cabezoide/sofifi/schematics/top/programa_plate.pdf

# programa_plate

### GENERADO por `sofifi tablas` desde

programas/plate.sasm.

### SOFIFI · esquemático generado fuente: rtl/top/programa_plate.v sha256: 32cf21fc916c

$meminit
ADDR

DATA

palabras | lfo_tipos | instrucciones | lfo_excursiones

0x0

0xInfinity

0x923f | 0x0 | 0x56 | 0x6800d

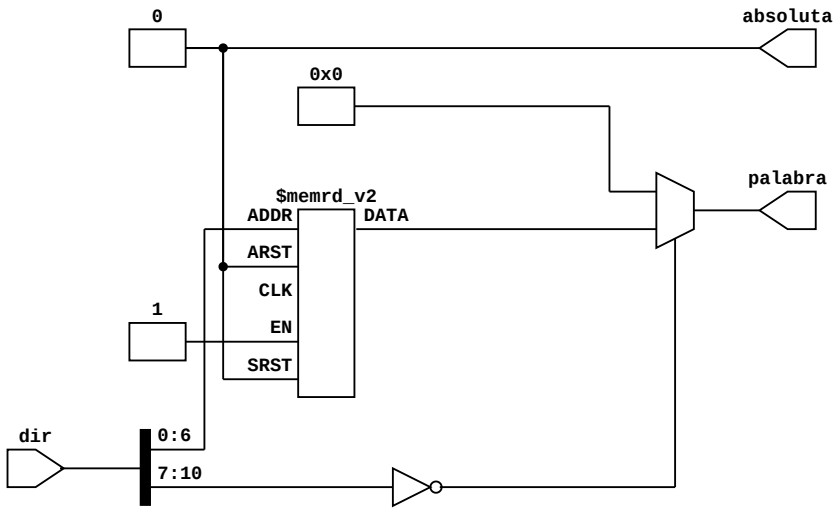
[picture p4: figure]
$memrd_v2 ADDR; ARST; CLK; SRST; DATA; dir; palabra; 0 absoluta
