cabezoide/sofifi/schematics/top/hil_programa.pdf

## hil_programa

hil_nucleo con la ROM que escribe `sofifi rom` en build/programa_hil.v: un programa o una cadena cualquiera en la placa.

SOFIFI · esquemático generado fuente: rtl/top/hil_programa.v sha256: 4140d4067240

amod\hil_nucleo\PROGRAMA=t24'011010000110100101101 clk

rst_n

uart_rx

uart_tx

clk

rst_n

uart_rx

uart_tx
