cabezoide/sofifi/schematics/top/hil_looper.pdf

## hil_looper

hil_nucleo con el looper (Fase 07): prueba RDAA y WRAA en la placa.

SOFIFI · esquemático generado fuente: rtl/top/hil_looper.v sha256: f9fa8bc14659

mod$8709f098b4d2bf764c3c52a0f0d38922a80d20ac\hil_n clk

rst_n

uart_rx

uart_tx

clk

rst_n

uart_rx

uart_tx
