cabezoide/sofifi/SBOM.ja.md

<!-- i18n: fuente=SBOM.md sha=8665ed6079b6 estado=al_dia -->
# SBOM · SOFIFI のコンポーネント

ペダルの内部がどの部品でできているか、どのツールで構築するかを説明します。各部品には簡単な説明があります。何をするのか、全体に何をもたらすのか、です。技術的な詳細（リソース、レイテンシー、フェーズごとの経緯）は `docs/arquitectura_fpga.ja.md` にあります。

## 一文で言うと

FPGA には**小さな専用オーディオプロセッサー**（コア）が入っています。各エフェクト（plate、shimmer、freeze…）は**プログラム**です。プロセッサーはそのプログラムを毎秒 48,828 回、オーディオサンプル 1 つごとに 1 回実行します。

## FPGA のコンポーネント

### クロック

| コンポーネント | 簡単に言うと何をするか | もたらすもの |
|---|---|---|
| **PLL**（`pll_100`） | ボードの水晶の 50 MHz クロックを 100 MHz クロックに変換します。 | コアの速度を 2 倍にします。オーディオサンプル 1 つあたり 2,048 の作業ステップ。 |
| **サンプル生成器** | 2,048 クロックサイクルごとに信号を出します。 | オーディオのリズムを決めます。正確に毎秒 48,828 サンプル。 |

### DSP コア

| コンポーネント | 簡単に言うと何をするか | もたらすもの |
|---|---|---|
| **マイクロコード** | プログラムの命令（最大 2,048）を入れるメモリー。 | ハードウェアを変えずにエフェクトを変えられます。別のプログラムを読み込むだけです。 |
| **シーケンサー** | 命令を読み、各部品に何をするかを指示します。前の命令の終わりを待たずに、次の命令を始めます。待つのは、まだ準備できていない結果が必要なときだけです（ADR 0014、スペイン語）。 | コアの「指揮者」です。これにより、プログラムのサイクルは 1.6 分の 1 になります。 |
| **レジスターバンク** | 数値を保持する 64 個のセル。入力、出力、ポテンショメーター、プログラムの変数。 | 各エフェクトの「作業台」です。 |
| **乗算器**（DSP ブロック） | 2 つの数を 1 ステップで掛けます。 | オーディオの処理はほとんどが乗算です。音量、フィルター、ミックス。 |
| **ALU** | 加算、比較、飽和（音のオーバーフローを防ぐ）を行います。 | 結果を組み合わせて、アキュムレーターに入れます。 |
| **アキュムレーター（ACC）** | 積を加算する 48 bit のレジスター。 | 高い精度。長いテールで丸めノイズを防ぎます。 |
| **ディレイメモリー**（BSRAM） | 直近約 0.9 s のオーディオを、ループするテープのように保持します。ブロックのグループに分かれ、グループごとにアドレスのコピーを持ちます。`RDAA` と `WRAA` を使うと、32,768 ワードが固定のテープのように働き、録音した音は遠ざかりません。 | すべての reverb と delay の土台です。音の過去を聞かせます。グループにより、実チップ上でタイミングに余裕が生まれます。固定部分により、ルーパーとグラニュラーが可能になります。 |
| **LFO ×4** | 低速のオシレーター（サイン、ランダム、ランプ）。 | メモリーの読み出し位置を動かします。chorus、reverb のモジュレーション、shimmer のピッチシフト。 |
| **Hermite ROM** | 256 × 4 個の係数の固定テーブル。 | ノイズなしでメモリーを「サンプルの間」で読めます。滑らかなモジュレーション。 |
| **ソフトカーブ** | 急な切れ目のない 3 次の飽和。 | 音楽的に音を制限し（`CLIP`）、サイン LFO の形を作ります。 |

### 入力、出力、テスト

| コンポーネント | 簡単に言うと何をするか | もたらすもの |
|---|---|---|
| **UART TX / RX** | ボードの USB を通じた PC とのシリアルポート。 | FPGA と通信できます。テストを要求し、結果を受け取ります。 |
| **プログラムローダー** | 起動時に、固定メモリーからマイクロコードへプログラムをコピーします。 | テスト用トップでは、plate、looper、または `make hil` のプログラムを読み込みます。 |
| **キャプチャーと CRC-32**（テスト専用） | 4,096 サンプルを実速度で録音し、チェックコードと一緒に送ります。 | ハードウェアが PC のモデルと**完全に**同じ音を出すことを示します。 |
| **トレース**（テスト専用） | どの命令を実行し、アキュムレーターにどの値を残したかを記録します。 | チップが失敗したとき、どの命令かを示します。どの部分を直せばよいかがわかります。 |
| **周波数カウンター**（テスト専用） | あるクロックの 1 秒間に、別のクロックのサイクルを数えます。 | PLL とサンプリング周波数が正確であることを確認しました。 |
| **1 ビットのオーディオ出力**（`salida_1bit`、フェーズ 13） | 1 本のピンで音声を送ります。補間器がサンプルを fs の 32 倍に上げ、変調器がクロックごとに 1 ビットに変えます。抵抗 2 本とコンデンサー 2 個で音が出ます。 | コーデックを買う前に、86 個のプログラムをボードで聞けます（ADR 0015）。 |

### microSD（フェーズ 08、作業中）

| コンポーネント | 簡単に言うと何をするか | もたらすもの |
|---|---|---|
| **SD コントローラー**（`sd_spi`） | SPI でカードと通信します。カードを起動し、512 バイトのブロックを読みます。カードには書き込みません。 | ファイルシステムなしでプログラムのライブラリにアクセスできます。ファイルシステムは高価で壊れやすいからです。 |
| **バンクのローダー**（`cargador`、`carga_sd`） | カードのスロットを 2 回読みます。1 回目は確認だけをします。2 回目はプログラムをコアに書き込みます。 | 壊れたプログラムは読み込みません。1 回目の読み出しが失敗すると、コアは前のプログラムを使い続けます。 |
| **SD のテスト**（`prueba_sd`、テスト専用） | PC の要求でスロットを読み込み、読んだ内容を PC に返します。 | カードがモデルと同じデータを出すことを確認します。実際のカードでの試験が残っています。 |
| **トラックの読み出し**（`lector_pista`、フェーズ 13） | カードからギターの録音をブロックごとに読み、サンプルごとに渡します。1,024 サンプル分を先読みするので、カードが遅れても音が切れません。 | コーデックが届く前にペダルへ音声入力を与えます。ボードでプログラムを聞けます。 |

### チップのプリミティブ（GW5A の物理的な部品）

| プリミティブ | 使用数 | 用途 |
|---|---|---|
| BSRAM（18 Kbit ブロック） | コアで 56 個中 48 個 | ディレイメモリーとマイクロコード |
| DSP（MULTALU27X18） | 28 個中 2 個 | 乗算器 |
| PLLA | 6 個中 1 個 | 100 MHz クロック |
| LUT4 とフリップフロップ | ~54 % と ~31 %（テスト用 top `hil_nucleo`） | すべてのロジックと、クロックの余裕を生むコピー |

## ソフトウェアツール

すべて `make install`（pip）でインストールします。すべてフリーソフトウェアです。

| ツール | バージョン | ライセンス | 何をするか |
|---|---|---|---|
| Yosys (YoWASP) | 0.69 | ISC | Verilog を論理ゲートに変換します（論理合成）。 |
| nextpnr-himbaechel-gowin (YoWASP) | 0.11.1 | ISC | それらのゲートをチップ内に配置し、配線します。 |
| apicula | 0.32 | MIT | GW5A のビットストリームを生成します。 |
| openFPGALoader | 1.1.1 | Apache-2.0 | USB 経由でビットストリームをボードに書き込みます。 |
| verilator | 5.48 | LGPL-3.0 または Artistic-2.0 | Verilog をシミュレーションします。ツールとして使うだけで、コードはコピーしません（ADR 0002）。 |
| cocotb | 2.1 | BSD-3-Clause | シミュレーションのテストを Python で書きます。 |
| pyserial | 3.5 | BSD-3-Clause | ボードの UART と通信します。 |
| soundfile | 0.12 | BSD-3-Clause | デモを Ogg Vorbis で書き出します。libsndfile（LGPL-2.1）をライブラリとして使い、コードはコピーしません（ADR 0002）。オプション：`pip install -e '.[demos]'`。 |
| Python + numpy | 3.12+ / 2.x | PSF / BSD | bit-exact モデル。すべての基準です（ADR 0003）。 |

最低バージョンは `pyproject.toml` にあります。各ツールの落とし穴は `fails.ja.md` と `rtl/AGENTS.md`（スペイン語）にあります。
