cabezoide/sofifi/SBOM.zh-CN.md

<!-- i18n: fuente=SBOM.md sha=8665ed6079b6 estado=al_dia -->
# SBOM · SOFIFI 组件

本文说明效果器内部由哪些部件组成，以及用哪些工具构建。每个部件都有简单的说明：它做什么，以及它为整体带来什么。技术细节（资源、延迟、各阶段的历史）见 `docs/arquitectura_fpga.zh-CN.md`。

## 一句话说明

FPGA 中包含一个**小型定制音频处理器**（核心）。每个效果（plate、shimmer、freeze…）都是一个**程序**。处理器每秒运行该程序 48,828 次，每个音频采样运行一次。

## FPGA 组件

### 时钟

| 组件 | 简单说明 | 作用 |
|---|---|---|
| **PLL**（`pll_100`） | 将开发板晶振的 50 MHz 时钟转换为 100 MHz 时钟。 | 使核心速度加倍：每个音频采样有 2,048 个工作步骤。 |
| **采样发生器** | 每 2,048 个时钟周期发出一个信号。 | 决定音频节奏：精确的每秒 48,828 个采样。 |

### DSP 核心

| 组件 | 简单说明 | 作用 |
|---|---|---|
| **微码** | 存放程序指令的存储器（最多 2,048 条）。 | 无需更改硬件即可更换效果：只需加载另一个程序。 |
| **序列器** | 读取指令，并告诉每个部件做什么。它不等上一条指令结束就开始下一条。只有需要尚未就绪的结果时，它才等待（ADR 0014）。 | 它是核心的“指挥”。这样，程序耗用的周期数减少到原来的 1/1.6。 |
| **寄存器组** | 64 个存放数值的单元：输入、输出、电位器和程序变量。 | 它是每个效果的“工作台”。 |
| **乘法器**（DSP 模块） | 一步完成两个数的乘法。 | 音频中几乎都是乘法：音量、滤波器、混合。 |
| **ALU** | 加法、比较和饱和（防止声音溢出）。 | 组合结果并存入累加器。 |
| **累加器（ACC）** | 一个 48 bit 寄存器，用于累加乘积。 | 精度高：避免长尾音中的舍入噪声。 |
| **延迟存储器**（BSRAM） | 保存最近约 0.9 s 的音频，就像一条循环磁带。它按块组划分，每组有自己的地址副本。借助 `RDAA` 和 `WRAA`，其中 32,768 个字像一条固定的磁带：录下的声音不会远去。 | 它是所有 reverb 和 delay 的基础：听到声音的过去。块组使其在真实芯片上有时序余量。固定部分让 looper 和颗粒效果成为可能。 |
| **LFO ×4** | 低速振荡器（正弦、随机、斜坡）。 | 移动存储器的读取位置：chorus、reverb 调制和 shimmer 的变调。 |
| **Hermite ROM** | 256 × 4 个系数的固定表。 | 可以无噪声地“在采样之间”读取存储器：平滑的调制。 |
| **柔和曲线** | 三次饱和，没有生硬的削波。 | 以音乐化的方式限制声音（`CLIP`），并为正弦 LFO 塑形。 |

### 输入、输出和测试

| 组件 | 简单说明 | 作用 |
|---|---|---|
| **UART TX / RX** | 通过开发板的 USB 与 PC 通信的串口。 | 可以与 FPGA 通信：请求测试并接收结果。 |
| **程序加载器** | 启动时将程序从固定存储器复制到微码。 | 在测试 top 中，它加载 plate、looper 或 `make hil` 的程序。 |
| **采集和 CRC-32**（仅用于测试） | 以实际速度录制 4,096 个采样，并与校验码一起发送。 | 证明硬件的声音与 PC 模型**完全**相同。 |
| **跟踪**（仅用于测试） | 记录执行的是哪条指令，以及它在累加器中留下的值。 | 如果芯片出错，它会指出是哪条指令，从而知道需要修复哪个部分。 |
| **频率计**（仅用于测试） | 在一个时钟的一秒内计数另一个时钟的周期。 | 已确认 PLL 和采样率是精确的。 |
| **1 位音频输出**（`salida_1bit`，第 13 阶段） | 用一个引脚输出音频。插值器把样本提升到 32 倍 fs，调制器把它变成每个时钟周期一位。两个电阻和两个电容就能出声。 | 在买声卡芯片之前，就能在开发板上听到 86 个程序（ADR 0015）。 |

### microSD（第 08 阶段，进行中）

| 组件 | 简单说明 | 作用 |
|---|---|---|
| **SD 控制器**（`sd_spi`） | 通过 SPI 与存储卡通信：启动存储卡并读取 512 字节的块。它不向存储卡写入。 | 无需文件系统即可访问程序库；文件系统既昂贵又脆弱。 |
| **程序库加载器**（`cargador`、`carga_sd`） | 将存储卡上的一个槽位读取两次。第一次只做检查；第二次把程序写入核心。 | 损坏的程序不会被加载。如果第一次读取失败，核心继续运行之前的程序。 |
| **SD 测试**（`prueba_sd`，仅用于测试） | 按 PC 的请求加载槽位，并告诉 PC 读到了什么。 | 检查存储卡给出的数据与模型相同。还缺少用真实存储卡的测试。 |
| **音轨读取器**（`lector_pista`，第 13 阶段） | 从卡中逐块读取一段吉他录音，再逐样本送出。它提前缓存 1,024 个样本，这样卡变慢也不会断音。 | 在声卡芯片到货之前就给踏板一路音频输入，于是可以在开发板上听到各个程序。 |

### 芯片原语（GW5A 的物理部件）

| 原语 | 使用数量 | 用途 |
|---|---|---|
| BSRAM（18 Kbit 块） | 核心中使用 56 个中的 48 个 | 延迟存储器和微码 |
| DSP（MULTALU27X18） | 28 个中的 2 个 | 乘法器 |
| PLLA | 6 个中的 1 个 | 100 MHz 时钟 |
| LUT4 和触发器 | ~54 % 和 ~31 %（测试 top `hil_nucleo`） | 全部逻辑，以及提供时钟余量的副本 |

## 软件工具

所有工具都通过 `make install`（pip）安装，且都是自由软件。

| 工具 | 版本 | 许可证 | 作用 |
|---|---|---|---|
| Yosys (YoWASP) | 0.69 | ISC | 将 Verilog 转换为逻辑门（综合）。 |
| nextpnr-himbaechel-gowin (YoWASP) | 0.11.1 | ISC | 在芯片内布局并连接这些逻辑门。 |
| apicula | 0.32 | MIT | 生成 GW5A 的比特流。 |
| openFPGALoader | 1.1.1 | Apache-2.0 | 通过 USB 将比特流加载到开发板。 |
| verilator | 5.48 | LGPL-3.0 或 Artistic-2.0 | 仿真 Verilog。仅作为工具使用；不复制其代码（ADR 0002）。 |
| cocotb | 2.1 | BSD-3-Clause | 用 Python 编写仿真测试。 |
| pyserial | 3.5 | BSD-3-Clause | 与开发板的 UART 通信。 |
| soundfile | 0.12 | BSD-3-Clause | 将演示写为 Ogg Vorbis。它把 libsndfile（LGPL-2.1）作为库使用，不复制其代码（ADR 0002）。可选：`pip install -e '.[demos]'`。 |
| Python + numpy | 3.12+ / 2.x | PSF / BSD | bit-exact 模型，是一切的参考（ADR 0003）。 |

最低版本见 `pyproject.toml`。每个工具的陷阱见 `fails.zh-CN.md` 和 `rtl/AGENTS.md`（西班牙语）。
