cabezoide/sofifi/fails.zh-CN.md

<!-- i18n: fuente=fails.md sha=f2b864256b63 estado=al_dia -->
# 故障及其解决

本文件记录项目中发现的故障。每条记录包含现象、诊断、根本原因、解决方法和教训。它帮助我们避免重复同样的故障，也说明设计为何如此。

故障完成诊断并解决后，添加一条新记录。记录不重写：如果之后有变化，就添加一条带日期的注释。

| ID | 阶段 | 故障 | 状态 |
|---|---|---|---|
| F-01 | 02 | verilator 包装器反复启动自身，导致机器崩溃 | 已解决 |
| F-02 | 03 | BL616 的 UART 桥挂起 | 已解决（附使用规则） |
| F-03 | 03 | apicula 0.32 无法打包使用默认分频器的 PLLA | 已解决 |
| F-04 | 03 | Yosys 不为 GW5A 推断 DSP 块 | 已解决 |
| F-05 | 03 | nextpnr 推导不出 PLL 的输出频率 | 已解决 |
| F-06 | 03 | 仿真中复位始终不发生 | 已解决 |
| F-07 | 02 | 第一个比特流用了两倍的逻辑 | 已解决 |
| F-08 | 04 | RTL 中的无符号移位和一处溢出 | 已解决 |
| F-09 | 04 | 单端口 BSRAM 的保持时间违例 | 已解决 |
| F-10 | 04 | 核心时序不收敛（70 MHz） | 已解决 |
| F-11 | 05 | nextpnr 给出 132 MHz，芯片却在 100 MHz 失败 | 已解决；实测裕量 ≥ 6 %，待提高 |
| F-12 | 05 | 一项存储器清零测试什么也检测不到 | 已解决 |
| F-13 | 05 | 转储的第一行丢失 | 已解决 |
| F-14 | 05 | apicula 0.32 无法打包没有初始内容的 BSRAM | 已解决 |
| F-15 | 06 | 预读在仿真中正常，在芯片上 100 MHz 时失败 | 已解决；实测裕量 ≥ 20 % |
| F-16 | 06 | 大型仿真用 pip 版 verilator 无法编译 | 已解决 |
| F-17 | 06 | velvet noise 扩散器没有优于全通滤波器 | 已放弃：不发布 |
| F-18 | 06 | 阶段 06 程序目录中的四个编程错误 | 发布前已解决 |
| F-19 | 07 | 加入 RDAA 和 WRAA 后，芯片在 114 MHz 下从第一个样本起失败 | 已解决；实测裕量 ≥ 25 % |
| F-20 | 07 | 清除绝对区域时有两个字没有被清除 | 已解决 |
| F-21 | 07 | 在 marea 中，软件 LFO 停在 +1 | 发布前已解决 |
| F-22 | 07 | shoegaze 的音量是 plate 的五倍 | 发布前已解决 |
| F-23 | 07 | 带饱和的链比 plate 响六倍 | 发布前已解决 |
| F-24 | 07 | 微码队列占用了最后一个 BSRAM | 已解决 |
| F-25 | 08 | SD 控制器的三个故障，在仿真中发现 | 上板前已解决 |
| F-26 | 08 | 目录第 9 批中的四个定点陷阱 | 发布前已解决 |
| F-27 | 08 | 第 10 批中的小常数、控制回路和一个“盲”指纹 | 发布前已解决 |
| F-28 | 08 | phaser 和 filtro 的最低速度为 0，以及第 11 批的三个陷阱 | 已解决 |
| F-29 | 08 | 第 12 批中五个调制和电平陷阱 | 发布前已解决 |
| F-30 | 08 | 第 13 批中的检测器、接缝和读取范围 | 发布前已解决 |

---

## F-01 · verilator 包装器反复启动自身

- **现象：**开发机器两次死机。内核因内存不足（OOM）杀死进程。
- **诊断：**OOM 转储中约有 14,000 个 `verilator` 进程。
- **根本原因：**有人手动创建了链接 `.venv/bin/verilator -> verilator-cli`。pip 的包装器在 PATH 中查找 `verilator` 并执行它。有了这个链接，包装器找到的是自己，于是无休止地重新启动自身。
- **解决方法：**不使用链接。`sim/conftest.py` 和 `scripts/ci_local.sh` 通过 `VERILATOR_ROOT` 调用软件包中的真实二进制文件。检查门在 `ulimit -u` 限制下运行 EDA 工具。
- **教训：**测试会启动子进程的新工具时，要使用 `ulimit -u` 和 `timeout`。

## F-02 · BL616 的 UART 桥挂起

- **现象：**开发板停止向 PC 发送数据，与比特流无关，直到重新连接 USB。FPGA 确实完成了配置（openFPGALoader 报告 `Done Final`）。
- **诊断：**在阶段 03 和 05 期间做了七次重新连接测试。在阶段 03，它看起来像 BSRAM 故障。到阶段 05，规律变得清楚：

  | 情况 | 结果 |
  |---|---|
  | FPGA 高速发送，PC 持续读取（HIL 转储，11.5 kB/s） | 不挂起 |
  | FPGA 发送 ≥ 2 kB/s 时重新编程（JTAG 期间 PC 不读取） | 挂起 |
  | 发送约 1.4 kB/s 或更低时重新编程 | 正常 |

- **根本原因：**BL616 固件在处理其他事务时（特别是 JTAG 编程期间）无法承受未读字节的积累。这不在我们的控制范围内。
- **解决方法：**
  - 测试顶层限制其速率（约 300 B/s 到 1.4 kB/s）；
  - HIL 只在 PC 请求时转储；
  - 脚本在释放端口**之前**加载一个静默设计（`prueba_pll`）。
- **教训：**重新编程之前，FPGA 不能在高速发送。如果正在高速发送，就在编程期间读取端口。

## F-03 · apicula 0.32 无法打包使用默认分频器的 PLLA

- **现象：**`gowin_pack` 结束时报错 `invalid literal for int() with base 2: '8'`。
- **根本原因：**apicula 以十进制保存 PLLA 的默认值，却按二进制读取。
- **解决方法：**`rtl/primitivas/pll_100.v` 设定所有分频器，包括未使用输出的分频器。

## F-04 · Yosys 不为 GW5A 推断 DSP 块

- **现象：**一个 `a * b` 被综合成了 LUT 和 ALU。
- **根本原因：**Yosys 0.69 只为 gw1n 和 gw2a 系列推断 DSP。
- **解决方法：**在 `rtl/primitivas/mult_27x36.v` 中例化 `MULT27X36`。它占用 28 个 DSP 块中的 2 个。已在开发板上验证到 160 MHz。

## F-05 · nextpnr 推导不出 PLL 的输出频率

- **现象：**报告对 `clk_100` 使用了通用的 50 MHz 目标。
- **解决方法：**`scripts/fpga.sh` 为所有时钟设定 100 MHz 目标。

## F-06 · 仿真中复位始终不发生

- **现象：**一个测试顶层在仿真中发送垃圾数据。
- **根本原因：**verilator 将寄存器初始化为 0。使用仿真 PLL 时，`bloqueado` 从一开始就是 1，由它派生的复位永远不会激活。
- **解决方法：**每个时钟域使用自己的启动计数器。

## F-07 · 第一个比特流用了两倍的逻辑

- **现象：**`hola_uart` 占用 353 个 LUT4 和 146 个 ALU。项目所有者问这是否正常。
- **根本原因：**设计把计数器的 8 位数字并行转换为 ASCII，然后再选择其中一位。
- **解决方法：**先选择数字，再只转换一次：207 个 LUT4 和 82 个 ALU。第二轮优化（ADR 0010）由此产生。

## F-08 · RTL 中的无符号移位和一处溢出

- **现象：**针对模型的单元测试失败，而程序的测试却通过。
- **根本原因：**在 Verilog 中，位选择（`p[49:0]`）和拼接（`{...}`）是**无符号**的，所以 `>>>` 做的是逻辑移位。这种情况发生了两次（在 `curva_fin` 中）。此外，在 RND LFO 中，`objetivo − actual` 需要 25 bit，却用 24 bit 计算。
- **解决方法：**移位前先经过一根 `signed` 线；差值用 25 bit。
- **教训：**每个模块都要用数千个随机向量对照其模型函数测试。程序的测试只覆盖这些程序产生的值。

## F-09 · 单端口 BSRAM 的保持时间违例

- **现象：**核心的第一次综合出现 104 个保持时间违例。
- **根本原因：**Yosys 把 ROM（Hermite 表、程序）和部分微码放进了 `SPX9` BSRAM。在 GW5A 上，这类 BSRAM 产生保持时间违例；`DPX9B` 则不会。
- **解决方法：**ROM 用逻辑实现，`(* rom_style = "logic" *)` 写**在 `case` 上**（写在端口上无效）；微码使用双端口包装器。

## F-10 · 核心时序不收敛（70 MHz）

- **现象：**核心的第一次综合只有 70 MHz，目标是 100。
- **根本原因：**四个步骤串联在一个周期内：
  - 译码；
  - 寄存器组（64:1 多路选择器）；
  - `a24` 的舍入；
  - `CLIP`（三个 50 bit 运算）。
- **解决方法：**在译码阶段寄存操作数，`CLIP` 分两步完成：nextpnr 给出 140 MHz。在芯片上这还不够：见 F-11。

## F-11 · nextpnr 给出 132 MHz，芯片却在 100 MHz 失败

- **现象：**在开发板上，plate 输出的第一个样本只有一半大小。在仿真、综合以及综合后的网表中，结果都与模型一致。
- **诊断**，逐步进行：
  1. 排除 B 为 24 bit 的乘法器：开发板上 300 次乘积无错误。
  2. 排除 2K × 9 模式的 BSRAM：开发板上 0 个错误。
  3. 仿真 Yosys 网表：与模型一致，所以综合正确。
  4. 一个计算相同的最小程序在开发板上正常工作。故障与布局有关。
  5. **决定性测试：**在已布线的 JSON 中只改变 PLL 的分频器，不重新布局。在 50、72.7、80 和 88.9 MHz 下正常；在 100 MHz 下失败。原因是时序。
  6. 用同样的方法，DSP 到 160 MHz 都正常，而推断出的 BSRAM 在 100 MHz 以上失败，静态分析给出的是 117 MHz。
- **根本原因：**nextpnr 对 GW5A 的时序模型乐观了约 30 %。对 *bypass* 模式（无输出寄存器）的 BSRAM 尤其如此，而这是 Yosys 唯一会推断的模式。对 BSRAM 之后的逻辑也是如此。
- **解决方法：**
  - `rtl/primitivas/bsram_bloque.v`：手动例化的 BSRAM，使用其内部输出寄存器（`READ_MODE1 = 1`）；
  - `rtl/primitivas/bsram_pipe.v`：由这些块构成的大容量存储器，多路选择器带寄存器；
  - 乘法器输出寄存两次；ALU 分两级；`CHO` 的地址分三步；程序加载器带寄存器。
- **实测结果：**nextpnr 给出 155 MHz。在开发板上：100 MHz 下 9 次采集 9 次完美，106.25 MHz 下 3 次中 3 次，114.3 MHz 下 5 次中 2 次。实际最高频率在 106 到 114 MHz 之间：**裕量至少 6 %**。对于会发热的效果器来说这太少了；目标是在重新设计序列器时（阶段 06 之前）超过 20 %。
- **代价：**每个样本的周期数（共 2,048）从 661 增至 1,258（plate），从 840 增至 1,601（shimmer）。
- **教训：**nextpnr 的分析不够。裕量要在开发板上测量，在同一布线上只改变 PLL 分频器（ADR 0011）。

## F-12 · 一项存储器清零测试什么也检测不到

- **现象：**禁用清零后测试也能通过。
- **根本原因：**plate 的延迟线很长，旧数据要经过数千个样本才会被再次读取。
- **解决方法：**一个在 9 个字上延迟 8 个样本的程序。没有清零时失败，有清零时通过。
- **教训：**确认每个新测试在代码出错时会失败。

## F-13 · 转储的第一行丢失

- **现象：**4,096 个样本只到达 4,095 个，并且全部错位一个位置。
- **根本原因：**BL616 保存着之前某个设计的字节。`reset_input_buffer()` 只清空 PC 的缓冲区，第一行到达时与这些残留字节粘在一起。
- **解决方法：**`scripts/hil_nucleo.py` 在请求采集之前，丢弃 0.3 s 内到达的数据。

## F-14 · apicula 0.32 无法打包没有初始内容的 BSRAM

- **现象：**`gowin_pack` 结束时在 `write_gw5_bsram_init_map` 中报 `IndexError`，并留下一个不完整的比特流。
- **根本原因：**如果设计中没有任何 BSRAM 声明 `INIT_RAM_xx`，apicula 就会失败。在手动例化所有块时发生了这种情况。
- **解决方法：**`bsram_bloque.v` 把 64 个初始化字声明为零。
- **教训：**检查 `fpga.sh` 的退出码；即使打包失败，`.fs` 文件也可能存在。

## F-15 · 预读在芯片上 100 MHz 时失败

- **现象：**使用微码预读时，plate 在仿真中与模型一致。在开发板上，它在 100 MHz 下失败，总是从第 924 个样本开始。使用同一布线，在 88.9 MHz 及以下正常。nextpnr 给出 157 MHz。
- **诊断**，逐步进行：
  1. `main` 的设计在同一天仍能在 100 MHz 下通过：开发板没有变化。
  2. 开发板上的测量排除了 50 bit 进位链、饱和加法、单独的 BSRAM、DSP 和时钟布线。Yosys 的 `-nodffe` 选项在 GW5A 上无效。
  3. 第 924 个样本是 plate 的尾音到达存储器长抽头的时刻：从这里开始存储器返回非零值。所以故障"取决于数据"。
  4. **新工具：**顶层 `hil_nucleo` 记录核心的轨迹（命令 `T`）：在 ACC 每次变化时记录 pc 和 ACC。`scripts/margen_reloj.py --traza` 把轨迹与模型比较，并指出最先失败的指令。
  5. 借助轨迹发现，每次布线失败的位置都不同。失败的有：延迟存储器的读取（`RDA` 返回 0：地址错误）、ALU 加法（bit 25）和乘法器（`MULX`）。
  6. 进位链的布局没有断开。不存在断开的路径。
- **根本原因：**nextpnr 高估了 GW5A 上**整个**设计的速度，系数为 1.45 到 1.5。每次布线都在余量最紧的路径上失败。BSRAM 的路径最差：一个地址要在一个周期内到达分布在芯片各处的 38 个块，还有一个 38 路输出的多路选择器。
- **解决方法：**
  - 流水线化的 `bsram_pipe`（延迟存储器中 `GRUPO = 8`）：
    - 每组、每块各有一份地址副本（`registro_copia`，Yosys 不会合并它）；
    - 每个块的输出在块旁边寄存；
    - 每组的多路选择器带寄存器。
  - 读取从 3 个周期增至 7 个周期。核心只在 `RDA` 和 `CHO` 中等待 `LAT_MEM = 9`。
  - 两级寄存器组：每个周期寄存 8 个候选值，在 `E_DECO` 中选择。微码字在译码前再寄存一次。
  - 存储器物理地址用三个并行加法计算，`puntero ± P` 随指针一起递减。
  - 乘法器使用 DSP 的内部寄存器 `PREG`。
- **实测结果**（nextpnr 对此布线给出 154 MHz）：100 MHz，4 次中 4 次；114.3 MHz，2 次中 2 次；**120 MHz，4 次中 4 次**；125 MHz，4 次中 3 次；133.3 MHz，1 次中 0 次。**裕量至少 20 %**，而阶段 05 为 6 %。
- **代价：**约多 3,100 个触发器（nextpnr 报告中的 LUT4：从 8,204 增至 11,490，因为有直通 LUT）。每个样本的周期数下降得比预期少：shimmer 1,514（之前 1,601），plate 1,195（之前 1,258），freeze 1,313（之前 1,393）。每条指令约 14 个周期：等待每条指令的结果仍是主要因素。
- **教训：**当芯片失败而 nextpnr 没有报错时，要先在开发板上定位指令（轨迹），再修改设计。占用半个芯片的存储器需要地址的本地副本，以及在每个块旁边寄存的输出。要在 114.3 到 133.3 MHz 之间测量，`margen_reloj.py --mdiv` 还会改变 VCO。

## F-16 · 大型仿真用 pip 版 verilator 无法编译

- **现象：**`c++: error: Vtop__pch.h.fast: linker input file not found`，只在大型设计中出现（带轨迹的 `hil_nucleo`）。
- **根本原因：**软件包中的 `verilated.mk` 把变量 `CFG_CXXFLAGS_PCH_I` 留空，它本应为 `-include`。verilator 把大型设计拆分成多个文件时会使用预编译头，而 g++ 把它当作输入文件接收。
- **解决方法：**`sim/conftest.py` 将 `CFG_CXXFLAGS_PCH_I=-include` 添加到 `MAKEFLAGS`。
- **教训：**只在设计变大时才出现的编译故障，通常出在工具配置上，而不是代码上。

## F-17 · velvet noise 扩散器没有胜过 allpass

- **现象：**测试了一个 hall，用 velvet noise 扩散器（50 ms 内 24 个 tap）代替其 4 个输入 allpass。
  - 尾音**更不**密集：有效样本占 10 %，而原来是 28 %。
  - 峰值因子更高：12.9 对 8.8。
  - 用 4 条延迟线代替 8 条，它还是目录中染色最重的尾音：倍频程频带之间为 6.4，而 plate 为 1.9。
- **根本原因：**级联的 allpass 产生无限长且越来越密的响应。velvet noise 产生的脉冲数等于 tap 数。在 SOFIFI 中，每个 tap 是一条 19 个周期的 `RDA`：要达到同样的密度需要 100 个 tap，约 1,900 个周期，与网络一起放不下。
- **解决方法：**不发布该程序。阶段 03 路线图（第 5 项）由 hall（使用 Householder 的 8 线网络）覆盖。
- **教训：**在给程序命名之前，先测量所承诺的属性（密度、染色）。在 PC 上有效的算法，在每次存储器读取要花 19 个周期时，未必是最佳选择。

## F-18 · 阶段 06 目录中的四个编程故障

- **现象：**发布之前，声学测试发现了：
  1. 一个 autopan、一个 tilt 和一个占空比未能达到其极限；
  2. 一个 slicer 在 pot1 = 1 时从不关闭；
  3. 一个压缩器的增益越过 0 并降到 −1；
  4. 四个 delay 具有相同的指纹。
- **根本原因**，依次为：
  1. `rdax potN, C` 中 C > 1，之后跟着 `sof`：`SOF` 使用的是已经**饱和**到 ±1（a24）的 ACC，所以 2·pot 从未超过 1。
  2. pot = 0.99999988、D = 0.99997 时，`1 − pot` 得到 −0.00003：`skp gez` 没有跳转。
  3. 环路以线性方式减去超出量（一个积分器），而缓慢下降的包络仍然很高。
  4. 在 0.1 s 的脉冲内只听到干信号：回声到得更晚。
- **解决方法：**
  1. 在 `SOF` 内做乘法（`rdax pot, 1.0` 和 `sof 1.999, −1.0`）。
  2. 当分支不取决于符号时，使用无条件跳转（`skp gez|neg`）。
  3. 按增益自身的比例下降：指数式，永远不会越过 0。
  4. 更长的指纹，以及一项要求各程序指纹互不相同的测试。
- **教训：**在核心中，ACC 很宽，但每条读取 a24 的指令（`SOF`、`WRAX`、`MULX`、`RDFX`）都会饱和。测量旋钮极限的测试能发现这些故障；测量中间位置的测试则不能。

## F-19 · 加入 RDAA 和 WRAA 后，芯片在 114 MHz 下从第一个样本起失败

- **现象：**带 `RDAA` 和 `WRAA` 的核心在仿真中与模型一致，在开发板上 100 MHz 时也一致。在 114.3 MHz 下，它总是从第 0 个样本开始失败。在阶段 06，同一个 plate 在 120 MHz 下通过。nextpnr 给出 157 MHz。
- **诊断**，逐步进行：
  1. 轨迹（`margen_reloj.py --traza`）指出第 2 条记录：开发板 pc = 8，模型 pc = 4。
  2. 该记录中开发板的 ACC 等于模型在 pc = 8 时的 ACC。所以 `rdax tmp`（pc 3 和 pc 5）两次都得到 0。
  3. `wrax tmp`（pc 2）没有写入寄存器，或者读取失败了。在第 0 个样本时存储器还没有返回数据：这是一条控制路径。
  4. 在布线中，`reg7`（`tmp`）的 24 个 bit 分布在整个芯片上（x 从 12 到 53）。控制信号（`estado`、`es_wrax`）在 x = 51，`a24` 在 x 从 12 到 21。
- **根本原因：**`WRAX` 的写入在写入的同一个周期内译码 `rg` 和状态条件。这个网络到达寄存器组的 1,536 个触发器，它们分布在整个芯片上。设计随阶段 07 变大，布局发生变化，这条路径成为余量最紧的路径。
- **解决方法：**
  - 寄存器组的写入分两级。`E_EJEC` 寄存一个 64 bit 掩码和数据；下一个周期，每个寄存器按掩码中自己的 bit 写入。这不增加周期：下一次读取要在几个周期之后才到。
  - `RDAA` 的减法 `M[i+1] − M[i]` 在进入乘法器之前先寄存（F-11 的规则）。`RDAA` 从 26 个周期增至 27 个周期。
- **实测结果**（nextpnr 对此布线给出 144 MHz）：100 MHz，2 次中 2 次；114.3 MHz，2 次中 2 次；120 MHz，3 次中 3 次；**125 MHz，3 次中 3 次**；133.3 MHz，1 次中 1 次。阶段 06 为 125 MHz，4 次中 3 次；133.3 MHz，1 次中 0 次。
- **教训：**写入整个寄存器组的寄存器会跨越芯片，和存储器地址一样。译码放在一个周期，写入放在下一个周期。nextpnr 从 157 MHz 降到 144 MHz，开发板却变好了：它的数值不能用来比较两次布线。

## F-20 · 清除绝对区域时有两个字没有被清除

- **现象：**测试 `absoluta_igual_al_modelo` 在另一个测试之后运行时，在第 67 个样本失败。单独运行时通过。
- **诊断**，逐步进行：
  1. 在第 67 个样本，`rdaa pe, 0.5, 32700` 读取区域的索引 32,767。模型读到 0，RTL 读到前一个测试留下的值。
  2. cocotb 的过滤器是一个正则表达式：`igual_al_modelo` 也选中了 `absoluta_igual_al_modelo`。所以该测试在每个程序之后运行，存储器是脏的。
- **根本原因：**在 `E_BORRAR` 中，`mdir_w` 来自一个寄存器，而绝对模式直接来自 `borrar_abs`。模式比地址早一个周期。最后一个循环字被写入了区域，区域的最后一个字被写入了循环部分。
- **解决方法：**
  - `mabs_borrar` 与 `mdir_w` 在同一个时钟沿寄存。
  - 测试改名为 `absoluta_como_el_modelo`，并先用 `WRAA` 弄脏区域的两端。对于之前的故障，该测试会失败。
- **教训：**伴随寄存地址的信号要和地址一起寄存。清除测试需要脏的存储器：仿真中存储器为零时，清除没有被测试到（与 F-12 相同）。

## F-21 · 在 marea 中，软件 LFO 停在 +1

- **症状：** 在 `marea` 的测试中，右侧尾音比左侧低约十倍，而且两侧都没有波浪。
- **诊断：** 在所有采样中，左侧增益为 1，右侧为 0.1。两个增益都来自 LFO：LFO 一直处于 +1。
- **根本原因：** 程序用 `CLIP` 把三角波变圆，并把结果写入 `tri`。`tri` 是 `comun/lfo_triangulo.sasm` 的状态。`CLIP` 在原点的斜率为 1.5：每个采样都把数值推向 1，数值停在那里。
- **解决：** 变圆后的数值写入另一个寄存器（`ola`）。只有公共块写 `tri`。
- **教训：** 不要在公共块之外写它的状态寄存器。由它计算出的数值放入另一个寄存器。

## F-22 · shoegaze 的音量是 plate 的五倍

- **症状：** `shoegaze` 演示的 RMS 电平为 0.13，plate 的演示为 0.027。声学测试通过了。
- **诊断：** 加上饱和后，尾音在 ±1 附近被削波。plate 的尾音在 ±0.1 附近。×16 的增益把尾音推到上限。
- **根本原因：** 输出增益是固定的（0.5）。测试测量的是压缩，而不是与 plate 相比的电平。
- **解决：** pot3 增大时，输出从 0.6 降到 0.1。干湿比在一半时，在旋钮的整个行程内，电平都在 plate 的 ±25 % 以内。
- **教训：** 切换程序时音量跳变是一种风险（SECURITY.md）。每个新程序在发布前都要与 plate 比较电平。

## F-23 · 带饱和的链比 plate 响六倍

- **症状：** «Fuzz en la nube»（`saturacion` → `cloud`）的演示出现削波：峰值 1.03，RMS 电平是 plate 的十倍。
- **诊断：** `saturacion` 的「nivel」（电平）旋钮固定为 0.6，干湿比为 1。吉他较轻时，饱和把信号推到上限；`cloud` 收到的信号几乎是满幅。
- **根本原因：** F-22 的教训用在了 `shoegaze` 程序上，但链没有任何电平测试。单独正确的程序在链中可能出错。
- **解决：** 该链的「nivel」设为 0.1，«Sustain en la placa» 的增益设为 0.2。新测试 `ninguna_cadena_salta_de_volumen`：无论轻音还是重音，任何链的响度都不超过 plate 的两倍。
- **教训：** 由故障得出的规则要变成测试。规则只留在笔记里，同样的故障会从别的路径回来。

## F-24 · 微码队列占用了最后一个 BSRAM

- **症状：** 使用流水线核心（ADR 0014，西班牙语）时，nextpnr 停止：«no BELs remaining to implement cell type 'DP'»。仿真通过。
- **诊断：** 资源报告显示 BSRAM 用了 56 个中的 56 个。多出的一个来自微码取指队列（8 × 54 位）。
- **根本原因：** Yosys 会把每个按索引读取的数组变成 BSRAM，小数组也一样。在 `hil_nucleo` 中，捕获已经用完了所有空闲的 BSRAM。
- **解决：** 在队列上加 `(* ram_style = "logic" *)`。之后，第二轮优化把队列减到 4 个字。
- **教训：** RTL 中的每个新数组从一开始就写上 `ram_style`。在这块芯片上，每个 BSRAM 都是延迟存储器。

## F-25 · SD 控制器的三个故障，在仿真中发现

- **症状 1：** 加载器以“头部”为原因拒绝所有存储库。
  - **原因：** 魔数与字符串 `"SOFIFI\0\0"` 比较。在 Verilog 中，`\0` 不是可靠的转义，该常数不是预期的 8 个字节。
  - **解决：** 魔数改为常数 `64'h534F_4649_4649_0000`。
- **症状 2：** 在 25 MHz 时读取数据块失败，原因为“令牌”；在慢时钟下正常。
  - **原因：** MISO 经过两个同步触发器。SCK 的半周期为 2 个周期时，位到达采样点太晚。
  - **解决：** 快速半周期至少为 4 个周期（12.5 MHz）。参数中写明了这一点。
- **症状 3：** 程序正确到达核心，但带着另一个程序的存储器和 LFO。
  - **原因：** 微码块覆盖了保存的元数据字节。
  - **解决：** 只保存头部和元数据的字节。
- **教训：** cocotb 中的存储卡模型和 `sofifi banco` 生成的映像在上板前发现了这三个故障。多字节常数用十六进制书写。

## F-26 · 目录第 9 批中的四个定点陷阱

新程序的声学测试在发布前发现了四个故障。

- **FV-1 形式的全通在极点接近 1 时饱和**（`desplazador`）。
  - **症状：** 回声只有应有电平的四分之一，相反边带只衰减 31 dB。
  - **原因：** RDA + WRAP 形式保存的状态按 1/(1 − k) 增长。k = 0.998 时，18 位的字饱和。
  - **解决：** 改用直接 I 型：每级保存其输出，下一级把它当作 x[n−1] 读取。相反边带衰减 64 dB。
- **大于 1 的 RDAX 系数在 SOF 之前饱和**（`desplazador`）。
  - **症状：** 宽度旋钮和脚踏开关不起作用。
  - **原因：** SOF 读取 a24，即饱和到 [−1, 1) 的 ACC。`rdax pot, -2.0` 在相加之前就已经是 −1。
  - **解决：** 先 `rdax pot, -1.0`，再 `sof 1.999, 0.99999`。
- **WRAX 把寄存器饱和到 1 以下**（`arcoiris`）。
  - **症状：** 1.1 的再生停在 0.99999，回路不自激。
  - **解决：** 大于 1 的增益放在系数里（`rdax fb, 1.1`），不放在寄存器里。
- **小数长度的循环会使循环熄灭**（`erosion`）。
  - **症状：** 侵蚀为 0 时，循环每一圈都损失高频和电平。
  - **原因：** 读取落在两个样本之间。插值是一个低通滤波器，每一圈作用一次。
  - **解决：** 长度取整到整数个样本。侵蚀为 0 时，循环逐位重复。
- **教训：** 在定点中，ACC 和寄存器饱和到 [−1, 1)。在带反馈的回路中，隐藏的滤波器会按圈数叠加。测试测量电平和精确重复，而不只是“有声音”。

## F-27 · 第 10 批中的小常数、控制回路和一个“盲”指纹

- **小于 1/32 768 的常数放不进 SOF 的 D 操作数**（`violin`）。
  - **症状：** 音符的年龄和最慢的斜坡不动。
  - **原因：** D 是 S2.15，最小步长是 1/32 768。1/fs 更小。
  - **解决：** 常数由两个 SOF 的乘积得到，或由一个 ×64 的因子再乘以一个值为 1/64 的寄存器得到。
- **系数极小的低通在到达之前就停住**（`arco`）。
  - **症状：** 输出渐弱停在 0.002，到不了 0。
  - **原因：** 用 RDFX 和 2^-15 的系数时，接近目标时每个样本的步长被舍入为 0。
  - **解决：** 加一个固定的线性项和一个下限 0。
- **自动增益控制卡住或使回路熄灭**（`arco`、`oscilador`）。
  - **症状：** 在 `arco` 中，增益永远停在 0。在 `oscilador` 中，回路在第一个音符之后熄灭。
  - **原因：** 乘法式的增益一旦到 0 就不再上升。强烈的起音加上缓慢的恢复，把增益压到维持振荡所需的值以下。
  - **解决：** 增益设下限（1/256）。在 `oscilador` 中，起音更柔和，恢复时间为 85 ms。
- **旋钮处于中性时，指纹无法区分程序**（`dinamica`）。
  - **症状：** `dinamica` 和 `freeze` 的指纹相同。
  - **原因：** 指纹测试设 pot3 = 0.5，这在 `dinamica` 中是“无动态”：此时程序就是带 CLIP 储能的 plate，与不踩脚踏的 `freeze` 相同。
  - **解决：** `POTS_HUELLA` 给 `dinamica` 设深度 0.9，并用 0.6 秒的音符。
- **教训：** 长时间常数放不进一条指令，需要构造。控制回路需要下限。只有当激励和旋钮真正作用于效果时，指纹才有用。

## F-28 · phaser 和 filtro 的最低速度为 0，以及第 11 批的三个陷阱

- **被舍入为 0 的常数**（`phaser` 和 `filtro`，在第 06 阶段发布）。
  - **症状：** pot0 = 0 时，扫频不是 0.05 Hz，而是停止。`estelar` 的作者在写同样的计算时发现了它。
  - **原因：** `sof 1.0, 4*0.05/fs` 需要 4·10⁻⁶ 的 D。D 的步长是 1/32 768 ≈ 3·10⁻⁵，该值被无声地舍入为 0。
  - **解决：** 速度先 ×64 计算，再除回去（`sof 1/64, 0`）。**汇编器现在拒绝**不为 0 却被舍入为 0 的系数或 D。汇编 63 个程序时，只有 `filtro` 报错。
- **用多个抽头之和做反馈行不通**（`enjambre`、`probabilidad`、`dados`）。
  - **症状：** 尾音在 0.5 秒内消失，或回路饱和自激。
  - **原因：** N 个抽头之和在某些频率上的增益峰值为 N，平均增益则低得多。
  - **解决：** 回路只取一个抽头，即最长的那个。
- **开销计入 SKP 的所有分支**（`probabilidad`、`dados`）。
  - **症状：** 每个抽头一个计数器或三路选择要用 2 000 多个周期。
  - **解决：** 只用一个计数器，或每个抽头两路。
- **不跳转的 SKP 会把比较结果留在 ACC 中**（`dados`）。
  - **症状：** 没有输入时输出饱和。
  - **解决：** 在分支开头加 `clr`。
- **教训：** 人会忘记的规则应放进汇编器。设计反馈回路要看最坏的增益，而不是平均值。

## F-29 · 第 12 批中五个调制和电平陷阱

- **CHO 的 `media` 选项不会反转 SIN LFO**（`dimension`）。
  - **症状：** L + R 之和与每个声道一样起伏：反相并不存在。
  - **原因：** `media` 只把 RAMP 和窗口移动半圈；正弦不变。模型和 RTL 一致。
  - **解决：** 两个速度相同的 SIN LFO；第二条延迟线使用负的 `depth`。
- **以 8 ms 为中心的合唱与干声形成梳状滤波**（`orilla`）。
  - **症状：** 在 196 Hz 时，电平降到 plate 的 0.22 倍。
  - **原因：** 干声和 50 % 的声部在 187 Hz 附近相互抵消。
  - **解决：** 延迟范围改为 3 到 15 ms。
- **不对称三角 LFO 卡在边缘**（`vibe`）。
  - **症状：** 上升比下降快时，扫频停在 +1。
  - **原因：** 下降的步长没有把 LFO 带出边缘区域，方向在每个样本都改变。
  - **解决：** 在 tri·方向 上检查边缘。`comun/lfo_triangulo.sasm` 不变。
- **两个滤波器共用一个寄存器会抹掉它们的状态**（`baldosa`）。
  - **症状：** 衰减最大时，尾音在 0.4 秒内下降 36 dB。
  - **原因：** 全通把输出写进了低通的寄存器。
  - **解决：** 每个滤波器有自己的寄存器。
- **压缩器和扩展器不匹配**（`eco_casero`）。
  - **症状：** 每个音符开始时有 2.4 倍的峰值；反馈最大时回路失控。
  - **解决：** 两者使用同一个平均值检测器，压缩器采用反馈结构（不用除法实现 1/包络）。
- **教训：** 调制效果要在单声道之和与低频上测试，而不只是在一个声道上。每个滤波器状态都需要自己的寄存器。

## F-30 · 第 13 批中的检测器、接缝和读取范围

- **`comun/compuerta.sasm` 的起音检测器在低音上误触发**（`tartamudeo`）。
  - **症状：** 82 Hz 的持续音每秒触发 12 次，而琶音的音符不触发。
  - **原因：** 快速包络在低音上纹波很大。前一个音还在响时，“快 > 2·慢”的规则不成立。
  - **解决：** 用 MAXX 做峰值检测（约 30 ms 下降），规则改为“峰值 > 1.5·慢 + 阈值”。公共模块不变。
- **读头碰到环形缓冲的接缝**（`frenada`）。
  - **症状：** 回声长、制动长时，松开脚踏会有咔嗒声。
  - **原因：** 写头追上正在制动的读头，读头读到了环形缓冲回绕的位置。
  - **解决：** 在写头附近用一个窗口关闭该读头。
- **可变速度需要除法**（`resbalon`）。
  - **原因：** 窗口相位每个样本前进 (1 − v)/L，而 ISA 没有除法。
  - **解决：** 每个样本自我修正的倒数：r ← r + 2·(1/32 − L·r)。
- **一个 CHO 从其基点最多只能读到 2·E 个样本**（`dos_ecos`）。
  - **症状：** 1.5 倍时间的抽头到不了 0.82 秒。
  - **原因：** LFO 的偏移 E 最大为 16 384 个样本。
  - **解决：** 用两个基点不同的 LFO 做两个抽头，并在两者之间交叉渐变。
- **教训：** 公共模块要用低音和琶音来验证。环形缓冲的每个读头在写头附近都需要窗口。

## F-31 · 第 14 批中的环路、周期与检测器

- **音高螺旋无法持续**（`espiral`）。
  - **症状：** 踩下脚踏开关、反馈为 1.9 时，尾音在 1-2 秒内消失。
  - **原因：** 环路中的移调器每一圈都把能量移出频带。仅靠增益无法把能量送回。
  - **解决：** 踩下脚踏开关时，一部分信号在环路内绕过移调器。CLIP 设定上限。
- **写指针周期为 32,767**（`compas`）。
  - **症状：** 跨越回绕的读取 `wp − d` 得到的延迟少一个采样。
  - **原因：** RDAA 以 32,768 个采样取模，而指针在 32,767 处回到 0。
  - **解决：** 指针以恰好 32,768 的周期遍历 [0, 1)。`granular` 的周期本来就是 32,768（已在 F-32 中检查）。`looper` 有另一个故障：见 F-32。
- **起音检测器在低音上多次触发**（`swell_ritmico`）。
  - **原因：** 峰值在半周期之间下降 8 %，规则“峰值 > 1.5·慢包络 + 阈值”多次穿过 0。
  - **解决：** 每次起音后约 60 ms 的死区时间。
- **持续音与其回声形成梳状滤波**（`arpegio`）。
  - **症状：** +4 声部在 330 Hz 时比 262 Hz 时低 65 %。
  - **解决：** 回声持续一步，且只有回声进入混响。
- **随旋钮变化的系数不能放进 RDFX**（`semilla`）。
  - **解决：** 低通使用带寄存器的 MULX，与 `cloud` 相同。
- **教训：** 带移调的环路需要一条不移调的路径。回绕的指针应与掩码同周期。

## F-32 · 混合的反相干声与 looper 在 ½× 下的回绕

- **混合拉满时，`comun/mezcla.sasm` 输出反相的干声。**
  - **症状：** pot2 = 1 时，输出中有 −60 dB、相位反转的干声。
  - **原因：** `sof 1.0, 0.999` 得到 kdry = 0.999 − pot2，pot2 = 1 时为 −0.001。
  - **解决：** 改为 `sof 1.0, 1.0`。SOF 的 D 为 S2.15，可以达到 1.0。74 个程序的指纹随之改变。
- **looper 在 ½× 下用循环外的单元插值最后一个采样**（`looper`）。
  - **症状：** ½× 时，循环结尾与开头之间的采样为 M[L−1]/2，而不是 (M[L−1] + M[0])/2。每一圈都有一次咔嗒声。
  - **原因：** RDAA 在单元 L−1 和单元 L 之间插值。单元 L 不属于循环。
  - **解决：** 程序在每个采样把单元 0 复制到单元 L（RDAA 和 WRAA，2 条指令）。
- **F-31 误判 `granular` 的回绕有问题。**
  - **原因：** 审查把与 32,767 的比较当成了回绕的终点。指针在回到 0 之前会写入单元 32,767。
  - **解决：** 模型证实 `granular` 写入全部 32,768 个单元。无需改动。
- **教训：** 插值读取需要循环结尾之后的那个单元。子代理的结论要先用模型验证，再记录。

## F-33 · nextpnr 的时钟结果取决于种子

- **症状：** 修改 `plate` 的 ROM 中一个常数后，`nucleo_placa` 时序不再收敛：100 MHz 目标下只有 95.41 MHz。
- **原因：** nextpnr 的布局取决于种子。同一网表的测量结果如下：

  | 种子 | Fmax |
  |---|---|
  | 默认 | 95.41 MHz |
  | 1 | 98.77 MHz |
  | 2 | 109.41 MHz |
  | 3 | 112.10 MHz |
  | 4 | 107.99 MHz |

- **解决：** 如果 nextpnr 只是时钟失败，`scripts/fpga.sh` 依次尝试种子 2、3、4（`SEMILLAS_PNR`）。第一次尝试不变，脚本会报告哪个种子收敛。
- **资源变化不是噪声：** `nucleo_placa` 从 11,709 增至 11,982 个 LUT4，从 1,208 增至 1,242 个 ALU。在该顶层中，Yosys 会剪除 ROM 从不使用的位。新常数用到了 D 字段的第 15 位（RAT-11 和 RAT-12）。
- **教训：** 不改逻辑的修改之后出现时钟失败，是布局噪声。真实裕量在开发板上测量（ADR 0011）。

## F-34 · 行为与请求不符的脚本

为脚本编写文档时（PR #58），发现了六个意外行为。它们都没有改变已发布的结果。

| 脚本 | 症状 | 解决 |
|---|---|---|
| `check_*` | 忽略参数：`check_optimizacion.py --help` 会综合所有顶层 | `scripts/sin_opciones.py`：`--help` 打印帮助；其他参数返回退出码 2 |
| `capturar_infografia.py` | 缺少 chrome-headless-shell 时只打印帮助 | 说明缺少什么以及如何安装 |
| `margen_reloj.py` | 缺少 `prueba_pll.fs` 时，`finally` 中的异常掩盖了结果 | 在操作开发板之前检查；最后的加载失败只给出警告 |
| `hil_lote.py` | 一个卡住的名字会让整批停止 | 使用独立进程组；20 分钟后终止整个进程组并记为“TIEMPO AGOTADO” |
| `rtl-lint` | 不逐个模块检查 `rtl/sd/` | 把 `rtl/sd/` 加入单独模块列表 |
| `sofifi` 命令行 | 只能在仓库根目录运行 | 从当前目录向上查找根目录 |

- **原因：** 每个脚本都只为正常情况编写，没有人测试错误输入。
- **教训：** 为脚本写文档时，也运行它的 `--help` 和一个错误参数。可能失败的 `finally` 会掩盖之前发生的事情。

## F-35 · 饱和的预设

- **症状：** 为扩展到 1,032 个预设而测量整个预设库时，13 个旧预设有超过 1 % 的采样饱和，或比输入高出 6 dB 以上。

  | 预设 | 测量 | 原因 |
  |---|---|---|
  | plate、plate_vivo、freeze、blackhole 和四个 shimmer 的“Solo …”预设 | +3 至 +5 dB，1.0 % 至 2.7 % 饱和 | 混合为 1 且衰减较高：尾音在没有干声时不断累积 |
  | enjambre/«Solo enjambre» | +8.2 dB，28 % 饱和 | 八个抽头之和超过 0 dBFS |
  | saturacion/«Brillo cálido» 和 «Crunch» | +7.8 和 +6.9 dB | 电平没有补偿增益 |
  | ancho/«Ancho oscuro» | +6.6 dB，18.8 % 饱和 | 偏暗的倾斜提升低频但没有补偿 |
  | compresor/«Aplastado» | 1.1 % 饱和 | 最大压缩下增益 ×4 |

- **解决：** 每个预设都略微降低了衰减、电平、增益或反馈。全部低于 1 % 且低于 +6 dB。`scripts/medir_presets.py` 测量整个预设库。
- **教训：** 预设要测量，而不只是听一次。最容易饱和的是极端设置（“Solo …”、混合为 1）。

## F-36 · 单一测试音会误导：并非真正的异常

- **症状：** 用 196 Hz 单音测量预设时，`dimension` 为 −5 至 −10 dB，`autowah` 为 −23 dB，`flanger` 低至 −14 dB。在 `dimension` 中，降低混合反而降低电平。
- **原因：** 只有一个频率。延迟约 8 ms 的合唱在 196 Hz 附近有梳状零点：干声与其副本几乎反相到达（204°）。哇音扫频高于 196 Hz，测试音落在其频带之外。
- **检查：** 用演示中的宽带合成吉他，`dimension` 为 −2.5 至 −5.6 dB，`autowah` 为 −4.6 至 +5.7 dB，`flanger`、`ancho` 和 `blackhole` 接近 0 dB。
- **解决：** `scripts/medir_presets.py` 改用带泛音的六弦扫弦。电平取 50 ms 窗口内的最大 RMS：整段测试的 RMS 会惩罚延长音符的效果。
- **真正的异常：`saturacion`。** 第 1 级在第 2 级之前乘以 1.999，输出几乎达到满幅。增益 ×1、电平 1 时，强音输出高出 +6 dB。现在输出除以 2：音色不变，该情况接近 0 dB。
- **已修正的文件头：** `resonador`（pot3 把频率乘以 1 − pot3/2，不是按半音线性变化）、`looper` 和 `granular`（速度或音程旋钮有三个区段）以及 `tambor`（缺少 `sw` 行）。
- **教训：** 用宽带信号测量效果。因为一个异常测量而修改程序之前，先用另一种信号重测。

## F-37 · `enjambre` 和 `semilla` 在开发板上不一致：绝对区放不进测试顶层

- **症状：** 在使用分段内核的 HIL 批测中，`enjambre` 只有 3,817/4,096 个采样一致，`semilla` 只有 893 个。其他程序都是 4,096。
- **原因：** 在 RTL 中，绝对区（RDAA、WRAA）位于循环内存之后：物理地址 = 字数 + 索引。`enjambre` 使用 10,052 + 32,768 = 42,820 个字。内核（43,008）放得下，但 `hil_nucleo` 只有 38,912 个字，为捕获留出空间。`semilla` 使用 10,166 + 32,768 = 42,934 个字。`sofifi rom` 和 `scripts/hil_lote.py` 只统计了循环字。
- **解决：** 程序使用绝对区时，`Programa.palabras_fisicas` 会把它加上。`sofifi rom`、`hil_lote.py` 和目录都使用它。`enjambre` 和 `semilla` 不再进入 HIL 批测；它们仍在 42 块的仿真中测试。
- **教训：** 失败的不是芯片，而是“放得下”的规则。一个限制只在一处计算，各处共用。

## F-38 · 开发板没连接时，`docs` 检查门会变红

- **症状：** `make ci` 让 `docs` 变红，输出 21 行 `rutas: docs/scripts.md cita \`/dev/ttyUSB1\`, que no existe`。pre-push 钩子什么都不让推。插上开发板后就是绿的。
- **原因：** `scripts/check_docs.py` 的 `comprobar_rutas` 把反引号里的每个路径都当作仓库里的路径。`/dev/ttyUSB0` 和 `/dev/ttyUSB1` 是设备文件：它们存在与否取决于有没有插 USB 线。
- **解决：** `parece_ruta` 排除以 `/dev/` 开头的内容。对仓库里的路径，检查照旧有效，而那才是改动可能弄坏的。
- **教训：** 检查门不能取决于插了什么硬件。假红要在检查门里修掉，不能容忍；一容忍，这道门就会被关掉（SPEC_RAIZ，P1）。

## F-39 · 反馈环里的系数不能共用

- **症状：** 在五个程序共用的带 CLIP 的水箱里补偿插值损耗之后，freeze 变平了（从 0.382 降到 0.087 dB/s），但 `dinamica` **每秒增长 1.18 dB**，一直到 −0.74 dBFS，`sostenido` 每秒增长 1.07 dB。
- **原因：** 这个补偿是环里一个抬高高频的零点。它的效果取决于每个程序的环路增益（decay、damping、抽头）。在一个程序里刚好抵消损耗的系数，在另一个程序里就过头了，于是环路开始获得能量。
- **解决：** 补偿放进它自己的块（`programas/comun/dattorro_tanque_compensado.sasm`），系数由每个程序自己测量后定义。`freeze` 用 0.05。另外四个继续用带 CLIP 的水箱，一个比特都不变。
- **教训：** 反馈环里的系数要按程序测量，绝不共用。而且宁可偏小：过头会让尾音增长，那就是音量，而音量是伤害面（SECURITY.md）。
