cabezoide/sofifi/fails.ja.md

<!-- i18n: fuente=fails.md sha=511fe0948ed5 estado=al_dia -->
# 障害とその解決

プロジェクトで見つかった障害の記録です。各項目には症状、診断、根本原因、解決、教訓があります。同じ障害を繰り返さないため、また設計がなぜ今の形なのかを理解するために使います。

障害を診断して解決したら、新しい項目を追加します。項目は書き直しません。後で何かが変わった場合は、日付付きの注記を追加します。

| ID | フェーズ | 障害 | 状態 |
|---|---|---|---|
| F-01 | 02 | verilator のラッパーが自分自身を起動し、マシンを停止させた | 解決済み |
| F-02 | 03 | BL616 の UART ブリッジがハングする | 解決済み（使用ルールあり） |
| F-03 | 03 | apicula 0.32 がデフォルト分周器の PLLA をパックできない | 解決済み |
| F-04 | 03 | Yosys が GW5A 向けに DSP ブロックを推論しない | 解決済み |
| F-05 | 03 | nextpnr が PLL の出力周波数を導出しない | 解決済み |
| F-06 | 03 | シミュレーションでリセットが一度もかからなかった | 解決済み |
| F-07 | 02 | 最初のビットストリームが 2 倍のロジックを使っていた | 解決済み |
| F-08 | 04 | RTL の符号なしシフトとオーバーフロー | 解決済み |
| F-09 | 04 | シングルポート BSRAM のホールド違反 | 解決済み |
| F-10 | 04 | コアのタイミングが収束しなかった（70 MHz） | 解決済み |
| F-11 | 05 | nextpnr は 132 MHz としたが、シリコンは 100 MHz で失敗した | 解決済み。実測マージン ≥ 6 %、要改善 |
| F-12 | 05 | メモリー消去のテストが何も検出しなかった | 解決済み |
| F-13 | 05 | ダンプの最初の行が失われた | 解決済み |
| F-14 | 05 | apicula 0.32 が初期内容のない BSRAM をパックできない | 解決済み |
| F-15 | 06 | 先読みがシミュレーションでは動作し、シリコンでは 100 MHz で失敗した | 解決済み。実測マージン ≥ 20 % |
| F-16 | 06 | 大規模シミュレーションが pip 版 verilator でコンパイルできなかった | 解決済み |
| F-17 | 06 | velvet noise のディフューザーがオールパスを上回らなかった | 不採用：公開しない |
| F-18 | 06 | フェーズ 06 のカタログで見つかった 4 つのプログラミングの不具合 | 公開前に解決済み |
| F-19 | 07 | RDAA と WRAA を加えると、シリコンが 114 MHz で最初のサンプルから失敗した | 解決済み。実測マージン ≥ 25 % |
| F-20 | 07 | 絶対領域の消去で 2 ワードが消去されずに残った | 解決済み |
| F-21 | 07 | marea で、ソフトウェア LFO が +1 に張り付いた | 公開前に解決 |
| F-22 | 07 | shoegaze の音量が plate の 5 倍だった | 公開前に解決 |
| F-23 | 07 | サチュレーションを含むチェーンが plate の 6 倍の音量だった | 公開前に解決 |
| F-24 | 07 | マイクロコードのキューが最後の BSRAM を使った | 解決済み |
| F-25 | 08 | SD コントローラーの 3 つの障害、シミュレーションで発見 | ボードの前に解決 |
| F-26 | 08 | カタログ第 9 バッチの固定小数点の 4 つの落とし穴 | 公開前に解決 |
| F-27 | 08 | 第 10 バッチの小さな定数、制御ループ、見えない指紋 | 公開前に解決 |
| F-28 | 08 | phaser と filtro の最低速度が 0 だった件と、第 11 バッチの 3 つの落とし穴 | 解決済み |
| F-29 | 08 | 第 12 バッチの変調とレベルの 5 つの落とし穴 | 公開前に解決 |
| F-30 | 08 | 第 13 バッチの検出器、継ぎ目、読み出しの限界 | 公開前に解決 |

---

## F-01 · verilator のラッパーが自分自身を起動した

- **症状：** 開発マシンが 2 回停止した。メモリー不足（OOM）でカーネルがプロセスを強制終了した。
- **診断：** OOM のダンプには約 14,000 個の `verilator` プロセスがあった。
- **根本原因：** リンク `.venv/bin/verilator -> verilator-cli` を手作業で作成していた。pip のラッパーは PATH から `verilator` を探して実行する。リンクがあると、ラッパーは自分自身を見つけ、際限なく再起動した。
- **解決：** リンクは作らない。`sim/conftest.py` と `scripts/ci_local.sh` は `VERILATOR_ROOT` を使って、パッケージ内の本物のバイナリーを呼び出す。ゲートは EDA ツールを `ulimit -u` の下で実行する。
- **教訓：** サブプロセスを起動する新しいツールを試すときは、`ulimit -u` と `timeout` を使う。

## F-02 · BL616 の UART ブリッジがハングする

- **症状：** どのビットストリームでも、USB を接続し直すまでボードが PC へデータを送らなくなる。FPGA のコンフィギュレーションは完了している（openFPGALoader は `Done Final` と報告する）。
- **診断：** フェーズ 03 と 05 を通じて、再接続を伴う試験を 7 回行った。フェーズ 03 では BSRAM の障害に見えた。フェーズ 05 でパターンがはっきりした。

  | 状況 | 結果 |
  |---|---|
  | FPGA が高いレートで送信し、PC が絶えず読み取る（HIL のダンプ、11.5 kB/s） | ハングしない |
  | FPGA が ≥ 2 kB/s で送信中に再プログラムする（JTAG の間 PC は読み取らない） | ハングする |
  | 約 1.4 kB/s 以下で送信中に再プログラムする | 動作を続ける |

- **根本原因：** BL616 のファームウェアは、別の処理中、特に JTAG によるプログラム中に、未読バイトがたまることに耐えられない。これは私たちには変更できない。
- **解決：**
  - テスト用トップは送信レートを制限する（約 300 B/s から 1.4 kB/s）。
  - HIL は PC が要求したときだけダンプする。
  - スクリプトはポートを解放する**前に**、何も送信しない設計（`prueba_pll`）をロードする。
- **教訓：** 再プログラムの前に、FPGA が高いレートで送信していないことを確認する。送信している場合は、プログラム中にポートを読み取る。

## F-03 · apicula 0.32 がデフォルト分周器の PLLA をパックできない

- **症状：** `gowin_pack` が `invalid literal for int() with base 2: '8'` で終了する。
- **根本原因：** apicula は PLLA のデフォルト値を 10 進数で保存し、2 進数として読み取る。
- **解決：** `rtl/primitivas/pll_100.v` はすべての分周器を設定する。使わない出力の分周器も設定する。

## F-04 · Yosys が GW5A 向けに DSP ブロックを推論しない

- **症状：** `a * b` が LUT と ALU になった。
- **根本原因：** Yosys 0.69 は gw1n と gw2a のファミリーにしか DSP を推論しない。
- **解決：** `rtl/primitivas/mult_27x36.v` で `MULT27X36` をインスタンス化する。28 個の DSP ブロックのうち 2 個を使う。ボード上で 160 MHz まで検証済み。

## F-05 · nextpnr が PLL の出力周波数を導出しない

- **症状：** レポートは `clk_100` に汎用の 50 MHz 目標を適用していた。
- **解決：** `scripts/fpga.sh` はすべてのクロックに 100 MHz の目標を設定する。

## F-06 · シミュレーションでリセットが一度もかからなかった

- **症状：** テスト用トップがシミュレーションで不正なデータを送った。
- **根本原因：** verilator はレジスターを 0 で開始する。シミュレーション用の PLL では `bloqueado` が最初から 1 になり、そこから作るリセットが一度も有効にならない。
- **解決：** 各クロックドメインに専用の起動カウンターを置く。

## F-07 · 最初のビットストリームが 2 倍のロジックを使っていた

- **症状：** `hola_uart` が 353 個の LUT4 と 146 個の ALU を使っていた。オーナーがこれは普通かと尋ねた。
- **根本原因：** カウンターの 8 桁を並列に ASCII へ変換し、その後で 1 桁を選んでいた。
- **解決：** 先に桁を選び、1 回だけ変換する。207 個の LUT4 と 82 個の ALU になった。2 回目の最適化パス（ADR 0010）はここから生まれた。

## F-08 · RTL の符号なしシフトとオーバーフロー

- **症状：** モデルと比較する単体テストが失敗し、プログラムのテストは通っていた。
- **根本原因：** Verilog では、ビット選択（`p[49:0]`）と連結（`{...}`）は**符号なし**になる。そのため `>>>` は論理シフトになる。これが 2 回起きた（`curva_fin` で）。さらに RND LFO では、`objetivo − actual` に 25 bit が必要だったが、24 bit で計算していた。
- **解決：** シフトの前に `signed` のワイヤーを通す。差分は 25 bit で計算する。
- **教訓：** 各ブロックは、対応するモデルの関数と数千個のランダムなベクトルで比較してテストする。プログラムのテストは、それらのプログラムが生成する値しかカバーしない。

## F-09 · シングルポート BSRAM のホールド違反

- **症状：** コアの最初の合成で 104 個のホールド違反が出た。
- **根本原因：** Yosys は ROM（Hermite テーブル、プログラム）とマイクロコードの一部を `SPX9` BSRAM に割り当てていた。GW5A では、この BSRAM はホールド違反を起こす。`DPX9B` は起こさない。
- **解決：** ROM はロジックで実装し、`(* rom_style = "logic" *)` を **`case` に**付ける（ポートに付けても効果がない）。マイクロコードはデュアルポートのラッパーで実装する。

## F-10 · コアのタイミングが収束しなかった（70 MHz）

- **症状：** コアの最初の合成は、目標 100 MHz に対して 70 MHz だった。
- **根本原因：** 4 つのステップが 1 サイクルの中で直列につながっていた。
  - デコード
  - レジスターバンク（64:1 マルチプレクサー）
  - `a24` の丸め
  - `CLIP`（50 bit の演算 3 つ）
- **解決：** デコードでオペランドをレジスターに入れ、`CLIP` を 2 ステップに分けた。nextpnr では 140 MHz。シリコンではこれで足りなかった。F-11 を参照。

## F-11 · nextpnr は 132 MHz としたが、シリコンは 100 MHz で失敗した

- **症状：** ボード上で、plate の最初のサンプルが半分の値で出た。シミュレーション、合成、合成後のネットリストでは、モデルと一致していた。
- **診断**（ステップごと）：
  1. B が 24 bit の乗算器を原因から除外した。ボード上で 300 個の積に誤りなし。
  2. 2K × 9 モードの BSRAM を原因から除外した。ボード上で誤り 0 個。
  3. Yosys のネットリストをシミュレーションした。モデルと一致したので、合成は正しかった。
  4. 同じ計算をする最小のプログラムは、ボード上で動作した。障害は配置に依存していた。
  5. **決定的なテスト：** 配線済みの JSON で PLL の分周器だけを変え、再配置はしなかった。50、72.7、80、88.9 MHz では動作し、100 MHz では動作しなかった。原因はタイミングだった。
  6. 同じ方法で、DSP は 160 MHz まで動作した。推論された BSRAM は 100 MHz を超えると失敗した。静的解析では 117 MHz だった。
- **根本原因：** GW5A に対する nextpnr のタイミングモデルは、約 30 % 楽観的である。特に *bypass* モード（出力レジスターなし）の BSRAM でそうなる。Yosys が推論するのはこのモードだけである。BSRAM の後ろのロジックでも同様である。
- **解決：**
  - `rtl/primitivas/bsram_bloque.v`：内部の出力レジスター（`READ_MODE1 = 1`）を使う、手作業でインスタンス化した BSRAM。
  - `rtl/primitivas/bsram_pipe.v`：これらのブロックで作る大容量メモリー。マルチプレクサーはレジスター付き。
  - 乗算器の出力は 2 回レジスターに入れる。ALU は 2 段。`CHO` のアドレスは 3 ステップ。プログラムローダーはレジスター付き。
- **実測結果：** nextpnr では 155 MHz。ボード上では、100 MHz で 9 回中 9 回、106.25 MHz で 3 回中 3 回、114.3 MHz で 5 回中 2 回、完全なキャプチャーが得られた。実際の最大周波数は 106 から 114 MHz の間にある。**マージンは少なくとも 6 %**。熱くなるペダルには小さすぎる。シーケンサーを再設計するとき（フェーズ 06 の前）に 20 % を超えることを目標とする。
- **コスト：** サンプルあたりのサイクル数（2,048 のうち）は、661 から 1,258（plate）、840 から 1,601（shimmer）に増える。
- **教訓：** nextpnr の解析だけでは足りない。マージンはボード上で測る。同じ配線のまま PLL の分周器だけを変える（ADR 0011）。

## F-12 · メモリー消去のテストが何も検出しなかった

- **症状：** 消去を無効にしてもテストが通った。
- **根本原因：** plate の長いディレイラインでは、古いデータが再び読まれるまでに数千サンプルかかる。
- **解決：** 9 ワードの上で 8 サンプル遅延させるプログラム。消去なしでは失敗し、消去ありでは通る。
- **教訓：** 新しいテストは、コードが誤っているときに失敗することを確認する。

## F-13 · ダンプの最初の行が失われた

- **症状：** 4,096 サンプルのうち 4,095 サンプルが届き、すべてが 1 つずれていた。
- **根本原因：** BL616 は前の設計のバイトを保持している。`reset_input_buffer()` は PC 側のバッファーしか空にしない。最初の行は、その残りのバイトにつながって届いた。
- **解決：** `scripts/hil_nucleo.py` は、キャプチャーを要求する前に、0.3 s の間に届くデータを捨てる。

## F-14 · apicula 0.32 が初期内容のない BSRAM をパックできない

- **症状：** `gowin_pack` が `write_gw5_bsram_init_map` で `IndexError` を出して終了し、不完全なビットストリームを残す。
- **根本原因：** 設計内のどの BSRAM も `INIT_RAM_xx` を宣言しないと、apicula は失敗する。すべてのブロックを手作業でインスタンス化したときに起きた。
- **解決：** `bsram_bloque.v` は 64 個の初期化ワードをゼロとして宣言する。
- **教訓：** `fpga.sh` の終了コードを確認する。パックが失敗しても `.fs` ファイルが存在することがある。

## F-15 · 先読みがシリコンでは 100 MHz で失敗した

- **症状：** マイクロコードの先読みを使うと、シミュレーションでは plate がモデルと一致した。ボードでは 100 MHz で失敗し、常にサンプル 924 から失敗した。同じ配線で 88.9 MHz 以下では動作した。nextpnr では 157 MHz だった。
- **診断**（ステップごと）：
  1. `main` の設計は、同じ日にも 100 MHz で通っていた。ボードは変わっていなかった。
  2. ボード上の測定で、50 bit のキャリーチェーン、飽和加算、BSRAM 単体、DSP、クロックの配線を原因から除外した。Yosys の `-nodffe` オプションは GW5A では効果がない。
  3. サンプル 924 は、plate のテールがメモリーの長いタップに届くサンプルである。そこからメモリーがゼロ以外の値を返し始める。そのため障害は「データに依存していた」。
  4. **新しいツール：** トップ `hil_nucleo` はコアのトレース（コマンド `T`）を記録する。ACC が変わるたびに pc と ACC を記録する。`scripts/margen_reloj.py --traza` はトレースをモデルと比較し、最初に失敗する命令を示す。
  5. トレースによると、配線ごとに失敗する場所が違った。失敗したのは、ディレイメモリーの読み取り（`RDA` が 0 を返した。アドレスの誤り）、ALU の加算（bit 25）、乗算器（`MULX`）だった。
  6. キャリーチェーンは途切れなく配置されていた。途切れたパスはなかった。
- **根本原因：** nextpnr は GW5A 上の設計**全体**の速度を 1.45 から 1.5 倍に過大評価する。各配線は、最も余裕のないパスで失敗する。BSRAM のパスが最も悪い。1 つのアドレスが 1 サイクルでチップ全体に散らばる 38 個のブロックに届く必要があり、38 出力のマルチプレクサーもある。
- **解決：**
  - パイプライン化した `bsram_pipe`（ディレイメモリーでは `GRUPO = 8`）：
    - グループごと、ブロックごとにアドレスのコピーを 1 つ置く（`registro_copia`。Yosys はこれを統合しない）。
    - 各ブロックの出力は、そのブロックの近くでレジスターに入れる。
    - グループごとにレジスター付きマルチプレクサーを置く。
  - 読み取りは 3 サイクルから 7 サイクルになる。コアは `RDA` と `CHO` でだけ `LAT_MEM = 9` を待つ。
  - レジスターバンクは 2 段。毎サイクル 8 個の候補をレジスターに入れ、`E_DECO` で選ぶ。マイクロコードのワードはデコードの前にもう一度レジスターに入れる。
  - メモリーの物理アドレスは 3 つの並列加算で計算し、`puntero ± P` はポインターと一緒に減らす。
  - 乗算器は DSP の内部レジスター `PREG` を使う。
- **実測結果**（この配線で nextpnr は 154 MHz）：100 MHz、4 回中 4 回。114.3 MHz、2 回中 2 回。**120 MHz、4 回中 4 回**。125 MHz、4 回中 3 回。133.3 MHz、1 回中 0 回。**マージンは少なくとも 20 %**。フェーズ 05 では 6 % だった。
- **コスト：** フリップフロップが約 3,100 個増える（nextpnr のレポートの LUT4 は 8,204 から 11,490。パススルーの LUT のため）。サンプルあたりのサイクル数の減少は予想より小さい。shimmer 1,514（以前 1,601）、plate 1,195（以前 1,258）、freeze 1,313（以前 1,393）。命令あたり約 14 サイクル。各命令の結果を待つ時間が、依然として最も大きい要因である。
- **教訓：** シリコンが失敗し nextpnr が失敗しないときは、設計を変える前に、ボード上で失敗する命令を特定する（トレース）。チップの半分を使うメモリーには、アドレスのローカルコピーと、各ブロックの近くでレジスターに入れた出力が必要である。114.3 から 133.3 MHz の間を測るには、`margen_reloj.py --mdiv` で VCO も変える。

## F-16 · 大規模シミュレーションが pip 版 verilator でコンパイルできなかった

- **症状：** `c++: error: Vtop__pch.h.fast: linker input file not found`。大規模な設計（トレース付きの `hil_nucleo`）でだけ出る。
- **根本原因：** パッケージの `verilated.mk` は変数 `CFG_CXXFLAGS_PCH_I` を空のままにしている。本来の値は `-include` である。verilator は大規模な設計を複数のファイルに分けるとき、プリコンパイル済みヘッダーを使う。g++ はそれを入力ファイルとして受け取る。
- **解決：** `sim/conftest.py` は `CFG_CXXFLAGS_PCH_I=-include` を `MAKEFLAGS` に追加する。
- **教訓：** 設計が大きくなったときだけ出るコンパイル障害は、たいていコードではなくツールの設定にある。

## F-17 · velvet noise のディフューザーは allpass に勝てなかった

- **症状：** hall で、入力の 4 個の allpass の代わりに velvet noise のディフューザー（50 ms に 24 タップ）を試した。
  - テールの密度は**低く**なった。有意なサンプルは 10 %、従来は 28 %。
  - クレストが高くなった。12.9 対 8.8。
  - ディレイラインを 8 本から 4 本にしたので、カタログで最も色付けの強いテールにもなった。オクターブバンド間で 6.4、plate は 1.9。
- **根本原因：** 直列につないだ allpass は、無限に続き、次第に密度が上がる応答を返す。velvet noise はタップ数と同じ数のパルスしか返さない。SOFIFI では各タップは 19 サイクルの `RDA` である。同じ密度に必要な 100 タップは約 1,900 サイクルかかり、ネットワークと一緒には収まらない。
- **解決：** このプログラムは公開しない。フェーズ 03 のロードマップ（項目 5）は hall（Householder を使う 8 ラインのネットワーク）でカバーする。
- **教訓：** プログラムに名前を付ける前に、約束する特性（密度、色付け）を測る。PC で動作するアルゴリズムが、メモリーの読み取りごとに 19 サイクルかかる場合にも最適とは限らない。

## F-18 · フェーズ 06 のカタログにある 4 つのプログラミング障害

- **症状：** 公開の前に、音響テストが次を検出した。
  1. autopan、tilt、デューティーサイクルが極限に届かなかった。
  2. slicer が pot1 = 1 で一度も閉じなかった。
  3. コンプレッサーのゲインが 0 を越えて −1 まで下がった。
  4. 4 つの delay が同じフィンガープリントだった。
- **根本原因**（順に）：
  1. C > 1 の `rdax potN, C` の後に `sof` が続いていた。`SOF` はすでに ±1 に**飽和**した ACC（a24）を使う。そのため 2·pot は 1 を超えなかった。
  2. pot = 0.99999988、D = 0.99997 のとき、`1 − pot` は −0.00003 になる。`skp gez` がジャンプしなかった。
  3. ループは超過分を線形に引いていた（積分器）。その間、ゆっくり下がるエンベロープは高いままだった。
  4. 0.1 s のインパルスでは、ドライ信号しか鳴らなかった。エコーはもっと後に届いていた。
- **解決：**
  1. `SOF` の中で乗算する（`rdax pot, 1.0` と `sof 1.999, −1.0`）。
  2. 分岐が符号に依存しないときは、無条件ジャンプ（`skp gez|neg`）を使う。
  3. ゲイン自身に比例して下げる。指数的に下がり、0 を越えない。
  4. フィンガープリントを長くし、プログラム間でフィンガープリントが異なることを要求するテストを追加する。
- **教訓：** コアでは ACC は幅が広いが、a24 を読む各命令（`SOF`、`WRAX`、`MULX`、`RDFX`）は飽和する。ノブの極限を測るテストはこれらの障害を見つける。中央を測るテストは見つけない。

## F-19 · RDAA と WRAA を加えると、シリコンが 114 MHz で最初のサンプルから失敗した

- **症状：** `RDAA` と `WRAA` を持つコアは、シミュレーションでも 100 MHz のボードでもモデルと一致した。114.3 MHz では、サンプル 0 から常に失敗した。フェーズ 06 では、同じ plate が 120 MHz で通っていた。nextpnr では 157 MHz だった。
- **診断：**
  1. トレース（`margen_reloj.py --traza`）は 2 番目のエントリーを示した：ボードは pc = 8、モデルは pc = 4。
  2. そのエントリーのボードの ACC は、モデルの pc = 8 での値だった。つまり `rdax tmp`（pc 3 と pc 5）は 2 回とも 0 を返していた。
  3. `wrax tmp`（pc 2）がレジスタに書かなかったか、読み出しが失敗した。サンプル 0 ではメモリーはまだデータを返さない。つまり制御のパスだった。
  4. 配線では、`reg7`（`tmp`）の 24 bit がチップ全体に散らばっていた（x は 12 から 53）。制御（`estado`、`es_wrax`）は x = 51、`a24` は x が 12 から 21 にあった。
- **根本原因：** `WRAX` の書き込みは、書くのと同じサイクルで `rg` と状態の条件をデコードしていた。このネットは、チップ全体に散らばるバンクの 1,536 個のフリップフロップに届く。フェーズ 07 で設計が大きくなり、配置が変わった。その結果、このパスが最も余裕のないパスになった。
- **解決：**
  - バンクへの書き込みを 2 段にする。`E_EJEC` が 64 bit のマスクとデータをレジスタに入れる。次のサイクルで、各レジスタはマスクの自分のビットに従って書き込まれる。サイクルは増えない：次の読み出しは数サイクル後に来る。
  - `RDAA` の減算 `M[i+1] − M[i]` を乗算器の前でレジスタに入れる（F-11 のルール）。`RDAA` は 26 サイクルから 27 サイクルになる。
- **実測結果**（この配線で nextpnr は 144 MHz）：100 MHz、2 回中 2 回。114.3 MHz、2 回中 2 回。120 MHz、3 回中 3 回。**125 MHz、3 回中 3 回**。133.3 MHz、1 回中 1 回。フェーズ 06 では 125 MHz で 4 回中 3 回、133.3 MHz で 1 回中 0 回だった。
- **教訓：** バンク全体に書き込むレジスタは、メモリーのアドレスと同じようにチップを横断する。デコードを 1 サイクルで行い、書き込みを次のサイクルで行う。nextpnr は 157 MHz から 144 MHz に下がったが、ボードの結果は良くなった：nextpnr の値は 2 つの配線の比較には使えない。

## F-20 · 絶対領域の消去で 2 ワードが消去されずに残った

- **症状：** テスト `absoluta_igual_al_modelo` は、別のテストの後に実行するとサンプル 67 で失敗した。単独では通った。
- **診断：**
  1. サンプル 67 で、`rdaa pe, 0.5, 32700` は領域のインデックス 32,767 を読む。モデルは 0 を読み、RTL は前のテストが残した値を読んでいた。
  2. cocotb のフィルターは正規表現である：`igual_al_modelo` は `absoluta_igual_al_modelo` も選んでいた。そのため、このテストは各プログラムの後に、汚れたメモリーで実行されていた。
- **根本原因：** `E_BORRAR` では、`mdir_w` はレジスタから出るが、絶対モードは `borrar_abs` から直接出ていた。モードがアドレスより 1 サイクル先行していた。循環領域の最後のワードが絶対領域に書かれ、絶対領域の最後のワードが循環領域に書かれた。
- **解決：**
  - `mabs_borrar` を `mdir_w` と同じクロックエッジでレジスタに入れる。
  - テストの名前を `absoluta_como_el_modelo` に変える。テストは先に `WRAA` で領域の両端を汚す。以前の障害があれば、このテストは失敗する。
- **教訓：** レジスタに入れたアドレスに付随する信号は、アドレスと一緒にレジスタに入れる。消去のテストには汚れたメモリーが必要だ。シミュレーションのメモリーはゼロなので、そのままでは消去をテストできない（F-12 と同じ）。

## F-21 · marea で、ソフトウェア LFO が +1 に張り付いた

- **症状：** `marea` のテストで、右の残響は左より約 10 倍小さく、どちらも波を作らなかった。
- **診断：** すべてのサンプルで、左のゲインは 1、右は 0.1 だった。どちらのゲインも LFO から出る：LFO は常に +1 だった。
- **根本原因：** プログラムは三角波を `CLIP` で丸め、結果を `tri` に書いていた。`tri` は `comun/lfo_triangulo.sasm` の状態である。`CLIP` の原点での傾きは 1.5：各サンプルが値を 1 へ押し、値はそこに留まった。
- **解決：** 丸めた値は別のレジスタ（`ola`）に入れる。`tri` は共通ブロックだけが書く。
- **教訓：** 共通ブロックの状態レジスタをブロックの外で書かない。そこから計算した値は別のレジスタに入れる。

## F-22 · shoegaze の音量が plate の 5 倍だった

- **症状：** `shoegaze` のデモの RMS レベルは 0.13、plate のデモは 0.027 だった。音響テストは通った。
- **診断：** サチュレーションで、残響は ±1 付近でクリップされる。plate の残響は ±0.1 付近にある。×16 のゲインが残響を上限まで上げる。
- **根本原因：** 出力ゲインは固定（0.5）だった。テストは圧縮を測り、plate と比べたレベルは測っていなかった。
- **解決：** pot3 が上がると、出力は 0.6 から 0.1 へ下がる。ミックスが半分のとき、ノブの全範囲でレベルは plate の ±25 % 以内に収まる。
- **教訓：** プログラムを切り替えたときの音量の跳びはリスクである（SECURITY.md）。新しいプログラムは公開前に plate とレベルを比べる。

## F-23 · サチュレーションを含むチェーンが plate の 6 倍の音量だった

- **症状：** «Fuzz en la nube»（`saturacion` → `cloud`）のデモがクリップした：ピーク 1.03、RMS レベルは plate の 10 倍。
- **診断：** `saturacion` の「nivel」（レベル）ノブは 0.6、ミックスは 1 に固定されていた。弱いギターでは、サチュレーションが信号を上限まで上げ、`cloud` はほぼフルスケールで受け取る。
- **根本原因：** F-22 の教訓は `shoegaze` プログラムに適用したが、チェーンにはレベルのテストがなかった。単体で正しいプログラムも、チェーンでは誤りになりうる。
- **解決：** そのチェーンの「nivel」を 0.1 に、«Sustain en la placa» のゲインを 0.2 にした。新しいテスト `ninguna_cadena_salta_de_volumen`：弱い音でも強い音でも、どのチェーンも plate の 2 倍を超えない。
- **教訓：** 故障から得たルールはテストにする。メモに残すだけでは、同じ故障が別の道から戻ってくる。

## F-24 · マイクロコードのキューが最後の BSRAM を使った

- **症状：** パイプライン化したコア（ADR 0014、スペイン語）で nextpnr が止まった：«no BELs remaining to implement cell type 'DP'»。シミュレーションは通った。
- **診断：** リソース報告は BSRAM 56 個中 56 個だった。1 個多いのは、マイクロコードのフェッチキュー（8 × 54 ビット）から来ていた。
- **根本原因：** Yosys は、インデックスで読む配列を小さくても BSRAM に変える。`hil_nucleo` では、キャプチャがすでに空いている BSRAM をすべて使っている。
- **解決：** キューに `(* ram_style = "logic" *)` を付けた。その後、2 回目の見直しでキューを 4 ワードに減らした。
- **教訓：** RTL の新しい配列には、最初から `ram_style` を付ける。このチップでは、BSRAM はすべて遅延メモリである。

## F-25 · SD コントローラーの 3 つの障害、シミュレーションで発見

- **症状 1：** ローダーがすべてのバンクを「ヘッダー」を理由に拒否した。
  - **原因：** マジック値を文字列 `"SOFIFI\0\0"` と比較していた。Verilog では `\0` は信頼できるエスケープではなく、定数が期待した 8 バイトにならなかった。
  - **解決：** マジック値を定数 `64'h534F_4649_4649_0000` にした。
- **症状 2：** 25 MHz ではブロックの読み出しが「トークン」を理由に失敗し、低速クロックでは動いた。
  - **原因：** MISO は 2 つの同期用フリップフロップを通る。SCK の半周期が 2 サイクルだと、ビットがサンプルに遅れて着いた。
  - **解決：** 高速の半周期は最低 4 サイクル（12.5 MHz）。パラメーターにそれを書いた。
- **症状 3：** プログラムは正しくコアに着いたが、別のプログラムのメモリーと LFO を持っていた。
  - **原因：** マイクロコードのブロックが、保存したメタデータのバイトを上書きしていた。
  - **解決：** ヘッダーとメタデータのバイトだけを保存する。
- **教訓：** cocotb のカードモデルと `sofifi banco` のイメージが、ボードの前に 3 つの障害を見つけた。複数バイトの定数は 16 進数で書く。

## F-26 · カタログ第 9 バッチの固定小数点の 4 つの落とし穴

新しいプログラムの音響テストが、公開前に 4 つの障害を見つけた。

- **FV-1 形式のオールパスは極が 1 に近いと飽和する**（`desplazador`）。
  - **症状：** エコーが本来のレベルの 4 分の 1 で出て、反対側の側波帯は 31 dB しか下がらなかった。
  - **原因：** RDA + WRAP 形式は 1/(1 − k) で大きくなる状態を持つ。k = 0.998 では 18 ビットのワードが飽和する。
  - **解決：** 直接形 I にした。各段が出力を保存し、次の段がそれを x[n−1] として読む。反対側の側波帯は 64 dB 下がる。
- **1 より大きい RDAX の係数は SOF の前に飽和する**（`desplazador`）。
  - **症状：** 幅のノブとフットスイッチが効かなかった。
  - **原因：** SOF は a24、つまり [−1, 1) に飽和した ACC を読む。`rdax pot, -2.0` は加算の前にすでに −1 になる。
  - **解決：** `rdax pot, -1.0` の後に `sof 1.999, 0.99999`。
- **WRAX はレジスターを 1 未満に飽和させる**（`arcoiris`）。
  - **症状：** 1.1 の再生が 0.99999 で止まり、ループが自己発振しなかった。
  - **解決：** 1 より大きいゲインはレジスターではなく係数に入れる（`rdax fb, 1.1`）。
- **小数の長さのループは消えていく**（`erosion`）。
  - **症状：** 侵食 0 でも、ループは周回ごとに高域とレベルを失った。
  - **原因：** 読み出しが 2 つのサンプルの間に落ちた。補間はローパスフィルターで、周回ごとに 1 回かかる。
  - **解決：** 長さを整数サンプルに丸める。侵食 0 では、ループはビット単位で繰り返す。
- **教訓：** 固定小数点では、ACC とレジスターは [−1, 1) に飽和する。帰還のあるループでは、隠れたフィルターが周回の数だけ重なる。テストは「音が出る」ことだけでなく、レベルと正確な繰り返しを測る。

## F-27 · 第 10 バッチの小さな定数、制御ループ、見えない指紋

- **1/32,768 より小さい定数は SOF の D オペランドに入らない**（`violin`）。
  - **症状：** 音の年齢と最も遅いランプが進まなかった。
  - **原因：** D は S2.15 で、最小のステップは 1/32,768。1/fs はそれより小さい。
  - **解決：** 定数を 2 つの SOF の積で作るか、×64 の係数で作ってから 1/64 のレジスターを掛ける。
- **極めて小さい係数のローパスは目標の手前で止まる**（`arco`）。
  - **症状：** 出力のフェードが 0.002 で止まり、0 にならなかった。
  - **原因：** RDFX と 2^-15 の係数では、目標の近くで 1 サンプルのステップが 0 に丸められる。
  - **解決：** 固定の直線項と 0 の下限を加えた。
- **自動ゲイン制御が止まる、またはループを止める**（`arco`、`oscilador`）。
  - **症状：** `arco` ではゲインが 0 のまま戻らなかった。`oscilador` では最初の音の後でループが止まった。
  - **原因：** 乗算型のゲインは 0 になると上がらない。強いアタックと遅い回復が、発振を保つ値より下までゲインを下げた。
  - **解決：** ゲインに下限（1/256）を付けた。`oscilador` では、アタックを弱め、回復を 85 ms にした。
- **ノブが中立だと指紋でプログラムを区別できない**（`dinamica`）。
  - **症状：** `dinamica` と `freeze` の指紋が同じだった。
  - **原因：** 指紋のテストは pot3 = 0.5 にする。これは `dinamica` では「ダイナミクスなし」で、プログラムは CLIP 付きタンクの plate になり、フットスイッチを踏まない `freeze` と同じになる。
  - **解決：** `POTS_HUELLA` で `dinamica` の深さを 0.9 にし、0.6 秒の音を使う。
- **教訓：** 長い時定数は 1 つの命令に入らないので組み立てる。制御ループには下限が要る。指紋は、刺激とノブが効果に届くときだけ意味がある。

## F-28 · phaser と filtro の最低速度が 0 だった件と、第 11 バッチの 3 つの落とし穴

- **0 に丸められる定数**（`phaser` と `filtro`、フェーズ 06 で公開）。
  - **症状：** pot0 = 0 のとき、スイープは 0.05 Hz ではなく止まっていた。`estelar` の作者が同じ計算を書いたときに気づいた。
  - **原因：** `sof 1.0, 4*0.05/fs` は 4·10⁻⁶ の D を求める。D のステップは 1/32,768 ≈ 3·10⁻⁵ で、値は警告なしに 0 に丸められた。
  - **解決：** 速度を ×64 で計算し、その後で割る（`sof 1/64, 0`）。**アセンブラーは今後**、0 でないのに 0 に丸められる係数や D を拒否する。63 のプログラムをアセンブルすると、`filtro` だけがエラーになった。
- **多数のタップの和を帰還させるとうまくいかない**（`enjambre`、`probabilidad`、`dados`）。
  - **症状：** テールが 0.5 秒未満で消えるか、ループが飽和して自己発振した。
  - **原因：** N 個のタップの和は、ある周波数でゲインのピークが N になり、平均のゲインはずっと低い。
  - **解決：** ループは 1 つのタップ、最も長いものだけから取る。
- **コストは SKP のすべての分岐を数える**（`probabilidad`、`dados`）。
  - **症状：** タップごとのカウンターや 3 方向の選択で 2,000 サイクル以上を使った。
  - **解決：** カウンターを 1 つにするか、タップごとに 2 方向にする。
- **ジャンプしない SKP は比較の結果を ACC に残す**（`dados`）。
  - **症状：** 入力がないのに出力が飽和した。
  - **解決：** 分岐の始めに `clr` を置く。
- **教訓：** 人が忘れうる規則はアセンブラーに入れる。帰還ループは平均ではなく、最悪のゲインで設計する。

## F-29 · 第 12 バッチの変調とレベルの 5 つの落とし穴

- **CHO の `media` オプションは SIN LFO を反転しない**（`dimension`）。
  - **症状：** L + R の和が各チャンネルと同じように揺れた。逆相になっていなかった。
  - **原因：** `media` は RAMP と窓を半周ずらすだけで、正弦は変わらない。モデルと RTL は一致する。
  - **解決：** 同じ速さの SIN LFO を 2 つ使い、2 本目のラインは負の `depth` を使う。
- **8 ms を中心とするコーラスはドライ信号とコムフィルターを作る**（`orilla`）。
  - **症状：** 196 Hz でレベルが plate の 0.22 倍まで下がった。
  - **原因：** ドライと 50 % の声部が 187 Hz 付近で打ち消し合った。
  - **解決：** ディレイの範囲を 3〜15 ms にした。
- **非対称の三角波 LFO が端で止まる**（`vibe`）。
  - **症状：** 上がりが下がりより速いと、スイープが +1 で止まった。
  - **原因：** 下がりのステップでは LFO が端の領域から出ず、向きがサンプルごとに変わった。
  - **解決：** 端の判定を tri·向き で行う。`comun/lfo_triangulo.sasm` は変えない。
- **2 つのフィルターが共有するレジスターは状態を消す**（`baldosa`）。
  - **症状：** ディケイ最大で、テールが 0.4 秒で 36 dB 下がった。
  - **原因：** オールパスが出力をローパスのレジスターに書いていた。
  - **解決：** フィルターごとに専用のレジスターを持たせた。
- **合わないコンプレッサーとエキスパンダー**（`eco_casero`）。
  - **症状：** 各音の始めに 2.4 倍のピークが出て、フィードバック最大でループが暴走した。
  - **解決：** 両方で同じ平均値検出器を使い、コンプレッサーは帰還型にした（割り算なしで 1/エンベロープ）。
- **教訓：** 変調エフェクトは片方のチャンネルだけでなく、モノの和と低い周波数で試す。フィルターの各状態には専用のレジスターが要る。

## F-30 · 第 13 バッチの検出器、継ぎ目、読み出しの限界

- **`comun/compuerta.sasm` のアタック検出器が低音で誤動作する**（`tartamudeo`）。
  - **症状：** 82 Hz の持続音が 1 秒に 12 回トリガーし、アルペジオの音はトリガーしなかった。
  - **原因：** 速いエンベロープは低音でリップルが大きい。前の音が鳴っている間は「速い > 2·遅い」の規則が成り立たない。
  - **解決：** MAXX によるピーク検出（約 30 ms で減衰）と「ピーク > 1.5·遅い + しきい値」の規則。共通ブロックは変えない。
- **読み出しヘッドがリングの継ぎ目に届く**（`frenada`）。
  - **症状：** 長いエコーと長いブレーキで、ペダルを離すとクリックが出た。
  - **原因：** 書き込みヘッドがブレーキ中の読み出しヘッドに追いつき、リングが一周する点を読んだ。
  - **解決：** 書き込みヘッドの近くでは窓でそのヘッドを消す。
- **可変速度には割り算が要る**（`resbalon`）。
  - **原因：** 窓の位相はサンプルごとに (1 − v)/L 進むが、ISA に割り算はない。
  - **解決：** サンプルごとに自分を補正する逆数：r ← r + 2·(1/32 − L·r)。
- **CHO はベースから 2·E サンプルまでしか読めない**（`dos_ecos`）。
  - **症状：** 時間の 1.5 倍のタップが 0.82 秒に届かなかった。
  - **原因：** LFO の振れ幅 E は最大 16,384 サンプル。
  - **解決：** ベースの違う 2 つの LFO で 2 つのタップを作り、その間をクロスフェードする。
- **教訓：** 共通ブロックは低音とアルペジオで検証する。リングの各読み出しヘッドには、書き込みヘッドの近くで窓が要る。

## F-31 · バッチ 14 のループ、周期、検出器

- **ピッチのスパイラルが持続しない**（`espiral`）。
  - **症状：** フットスイッチを踏み、フィードバック 1.9 で、テールが 1〜2 秒で消えた。
  - **原因：** ループ内のシフターが、1 周ごとにエネルギーを帯域の外へ移す。ゲインだけでは戻らない。
  - **解決：** フットスイッチを踏むと、信号の一部がループ内でシフターを迂回する。CLIP が上限を決める。
- **書き込みヘッドの周期が 32,767**（`compas`）。
  - **症状：** 折り返しをまたぐ読み出し `wp − d` が、1 サンプル短いディレイを読む。
  - **原因：** RDAA は 32,768 サンプルでマスクするが、ヘッドは 32,767 で 0 に戻る。
  - **解決：** ヘッドは周期ちょうど 32,768 で [0, 1) を進む。`granular` はもともと周期 32,768 だった（F-32 で確認）。`looper` には別の不具合があった。F-32 を参照。
- **アタック検出器が低音で何度も反応する**（`swell_ritmico`）。
  - **原因：** ピークは半周期ごとに 8 % 下がり、規則「ピーク > 1.5·低速 + しきい値」が何度も 0 をまたぐ。
  - **解決：** 各アタックの後に約 60 ms の不感時間を置く。
- **持続音とそのエコーがコムフィルターになる**（`arpegio`）。
  - **症状：** +4 の声部が 262 Hz より 330 Hz で 65 % 低かった。
  - **解決：** エコーは 1 ステップだけ続き、リバーブにはエコーだけが入る。
- **ノブで変わる係数は RDFX に入れられない**（`semilla`）。
  - **解決：** ローパスは、`cloud` と同じくレジスタ付きの MULX を使う。
- **教訓：** 移調するループには、移調しない経路が要る。折り返すヘッドはマスクと同じ周期にする。

## F-32 · ミックスの反転したドライ音と、½× でのルーパーの折り返し

- **ミックスを最大にすると、`comun/mezcla.sasm` がドライ音を反転して返す。**
  - **症状：** pot2 = 1 で、出力に −60 dB の位相反転したドライ音があった。
  - **原因：** `sof 1.0, 0.999` は kdry = 0.999 − pot2 を与え、pot2 = 1 で −0.001 になる。
  - **解決：** `sof 1.0, 1.0` にする。SOF の D は S2.15 で 1.0 まで届く。74 プログラムのフィンガープリントが変わる。
- **½× のルーパーが、最後のサンプルをループ外のセルで補間する**（`looper`）。
  - **症状：** ½× で、ループの終わりと始まりの間のサンプルが (M[L−1] + M[0])/2 ではなく M[L−1]/2 だった。1 周ごとにクリックが出た。
  - **原因：** RDAA はセル L−1 とセル L の間を補間する。セル L はループに含まれない。
  - **解決：** プログラムは毎サンプル、セル 0 をセル L にコピーする（RDAA と WRAA の 2 命令）。
- **F-31 は `granular` の折り返しを誤って不具合とした。**
  - **原因：** レビューが 32,767 との比較を折り返しの終点と読んだ。ヘッドは 0 に戻る前にセル 32,767 に書き込む。
  - **解決：** モデルで、`granular` が 32,768 セルすべてに書き込むことを確認した。変更はない。
- **教訓：** 補間する読み出しには、ループ末尾の次のセルが要る。サブエージェントの主張は、記録する前にモデルで確かめる。

## F-33 · nextpnr のクロック結果はシードで変わる

- **症状：** `plate` の ROM の定数を 1 つ変えた後、`nucleo_placa` がタイミングを満たさなくなった。100 MHz に対して 95.41 MHz。
- **原因：** nextpnr の配置はシードで変わる。同じネットリストで次の値を測った：

  | シード | Fmax |
  |---|---|
  | 既定 | 95.41 MHz |
  | 1 | 98.77 MHz |
  | 2 | 109.41 MHz |
  | 3 | 112.10 MHz |
  | 4 | 107.99 MHz |

- **解決：** nextpnr がクロックだけで失敗した場合、`scripts/fpga.sh` はシード 2、3、4 を試す（`SEMILLAS_PNR`）。最初の試行は変わらず、スクリプトはどのシードで収まったかを表示する。
- **リソースの変化はノイズではない：** `nucleo_placa` は LUT4 が 11,709 から 11,982 に、ALU が 1,208 から 1,242 に増えた。このトップでは、Yosys が ROM で使われないビットを削る。新しい定数は D フィールドのビット 15 を使う（RAT-11 と RAT-12）。
- **教訓：** ロジックに触れない変更の後のクロック失敗は、配置のノイズである。実際のマージンはボードで測る（ADR 0011）。

## F-34 · 求めたことと違う動作をしたスクリプト

スクリプトの文書化（PR #58）で、予期しない動作が 6 つ見つかった。公開済みの結果を変えたものはない。

| スクリプト | 症状 | 解決 |
|---|---|---|
| `check_*` | 引数を無視していた：`check_optimizacion.py --help` がすべてのトップを合成した | `scripts/sin_opciones.py`：`--help` はヘルプを表示し、それ以外の引数は終了コード 2 |
| `capturar_infografia.py` | chrome-headless-shell がないとき、ヘルプを表示するだけだった | 何が足りないか、どう入れるかを示す |
| `margen_reloj.py` | `prueba_pll.fs` がないと、`finally` の例外が結果を隠した | ボードに触れる前に確認し、最後の書き込みの失敗は警告だけにする |
| `hil_lote.py` | 1 つの名前が止まると、バッチ全体が止まった | 専用のプロセスグループで動かし、20 分でグループごと終了させ「TIEMPO AGOTADO」と記録する |
| `rtl-lint` | `rtl/sd/` をモジュールごとに検査していなかった | `rtl/sd/` を個別モジュールの一覧に加える |
| `sofifi` CLI | リポジトリのルートでしか動かなかった | 現在のディレクトリから上に向かってルートを探す |

- **原因：** どのスクリプトも通常の場合だけを考えて書かれ、誤った入力は誰も試していなかった。
- **教訓：** スクリプトを文書化するときは、`--help` と誤った引数も実行する。失敗しうる `finally` は、それより前のことを隠す。

## F-35 · 飽和していたプリセット

- **症状：** 1,032 プリセットに増やすためにバンクを測ったところ、古いプリセット 13 個で、飽和したサンプルが 1 % を超えるか、入力より +6 dB を超えていた。

  | プリセット | 測定値 | 原因 |
  |---|---|---|
  | plate、plate_vivo、freeze、blackhole と 4 つの shimmer の「Solo …」 | +3〜+5 dB、1.0〜2.7 % 飽和 | ミックス 1 で decay が高い：ドライなしでテールが積み上がる |
  | enjambre/«Solo enjambre» | +8.2 dB、28 % 飽和 | 8 つのタップの合計が 0 dBFS を超える |
  | saturacion/«Brillo cálido» と «Crunch» | +7.8 と +6.9 dB | レベルがゲインを補正しない |
  | ancho/«Ancho oscuro» | +6.6 dB、18.8 % 飽和 | 暗い側のティルトが低域を補正なしで上げる |
  | compresor/«Aplastado» | 1.1 % 飽和 | 最大圧縮でゲイン ×4 |

- **解決：** それぞれ decay、レベル、ゲイン、フィードバックのどれかを少し下げた。すべて 1 % 未満、+6 dB 未満になった。`scripts/medir_presets.py` がバンク全体を測る。
- **教訓：** プリセットは一度聴くだけでなく、測る。飽和するのは極端な設定（「Solo …」、ミックス 1）である。

## F-36 · 1 つのテスト音はだます：異常ではなかった異常

- **症状：** 196 Hz の 1 音でプリセットを測ると、`dimension` は −5〜−10 dB、`autowah` は −23 dB、`flanger` は最大 −14 dB だった。`dimension` ではミックスを下げるとレベルも下がった。
- **原因：** 周波数が 1 つだけ。約 8 ms のディレイを持つコーラスは 196 Hz 付近にコムのヌルがあり、ドライとそのコピーがほぼ逆相（204°）で届く。ワウは 196 Hz より上を掃引するので、テスト音は帯域の外になる。
- **確認：** デモの広帯域な合成ギターでは、`dimension` は −2.5〜−5.6 dB、`autowah` は −4.6〜+5.7 dB、`flanger`、`ancho`、`blackhole` は 0 dB 付近。
- **解決：** `scripts/medir_presets.py` は倍音付きの 6 弦ストロークを使う。レベルは 50 ms 窓の最大 RMS とする。テスト全体の RMS は、音を伸ばすエフェクトを不利にしていた。
- **本当の異常：`saturacion`。** 段 1 は段 2 の前に 1.999 倍し、出力はほぼフルスケールに達していた。ゲイン ×1、レベル 1 で、強い音が +6 dB 大きく出た。いまは出力を 2 で割る。音色は変わらず、その場合はほぼ 0 dB になる。
- **ヘッダーの修正：** `resonador`（pot3 は周波数に 1 − pot3/2 を掛ける。半音に対して線形ではない）、`looper` と `granular`（速度または音程のノブは 3 つのゾーン）、`tambor`（`sw` の行がなかった）。
- **教訓：** エフェクトは広帯域の信号で測る。おかしな測定値でプログラムを変える前に、別の信号で測り直す。

## F-37 · ボード上で `enjambre` と `semilla` が不一致：絶対領域がテスト用トップに収まらなかった

- **症状：** セグメント化コアでの HIL バッチで、`enjambre` は 4,096 サンプル中 3,817、`semilla` は 893 しか一致しなかった。ほかのプログラムはすべて 4,096。
- **原因：** RTL では、絶対領域（RDAA、WRAA）は循環メモリの後ろにある：物理アドレス = ワード数 + インデックス。`enjambre` は 10,052 + 32,768 = 42,820 ワードを使う。コア（43,008）には収まるが、キャプチャ用の場所を残す `hil_nucleo`（38,912）には収まらない。`semilla` は 10,166 + 32,768 = 42,934 ワード。`sofifi rom` と `scripts/hil_lote.py` は循環のワードしか数えていなかった。
- **解決：** プログラムが絶対領域を使うとき、`Programa.palabras_fisicas` がそれを加える。`sofifi rom`、`hil_lote.py`、カタログがこれを使う。`enjambre` と `semilla` は HIL バッチから外れ、42 ブロックのシミュレーションで引き続き検証する。
- **教訓：** 失敗したのはシリコンではなく「収まる」の規則だった。制限は 1 か所で計算し、どこでもそれを使う。
