cabezoide/sofifi/docs/arquitectura_fpga.zh-CN.md

<!-- i18n: fuente=docs/arquitectura_fpga.md sha=fd786e77fe20 estado=al_dia -->
# FPGA 架构

本文说明 FPGA 内部有什么、各部分如何连接，以及设计在各阶段如何变化。每个阶段结束时更新本文；每个改动 FPGA 模块的 PR 也要更新本文。各组件的简明说明见 `SBOM.zh-CN.md`；塑造了设计的故障见 `fails.zh-CN.md`。

芯片：**Gowin GW5A-LV25**（Tang Primer 25K）：23,040 个 LUT4，56 个 18 Kbit 的 BSRAM 块，28 个 DSP 块，6 个 PLL。

## 总览（流水线核心，ADR 0014，西班牙语）

```mermaid
flowchart LR
    cristal["晶振 50 MHz"] --> pll["PLL → 100 MHz<br/>(全局时钟)"]
    rom["程序 ROM"] --> cargador["加载器"] --> mc["微码<br/>2,048 × 54 · BSRAM"]
    sd["microSD<br/>PMOD TF"] -.->|"第 08 阶段 · prueba_sd"| csd["carga_sd<br/>sd_spi + cargador<br/>两遍 CRC-32"] -.-> mc
    gen["样本发生器<br/>每 2,048 周期一个 tick"] --> sec

    subgraph nucleo["DSP 核心"]
        direction LR
        mc --> sec["取指队列<br/>4 个字 + 队首"] --> deco["译码<br/>只为依赖而等待"]
        deco --> regs["寄存器组<br/>64 × 24"]
        deco --> lfo["LFO ×4 · Hermite ROM<br/>平滑曲线"]
        regs --> mult["乘法器 27×36<br/>2 DSP"]
        lfo --> mult
        mem["延迟存储器<br/>38–42 BSRAM，分组"] --> mult
        mult --> ret["退休线"] --> alu["ALU<br/>2 级"] --> acc["ACC 48 bit"]
        acc --> regs
        acc --> mem
    end

    sd -.->|"第 13 阶段 · lee_pista"| lpista["音轨读取器<br/>1,024 个样本的队列<br/>（第 13 阶段）"]
    lpista --> entradas
    entradas["输入<br/>adc, pots, sw"] --> regs
    regs --> dac["dac_l, dac_r"]
    dac -.->|"Fase 13 · ADR 0015"| s1b["1 位输出<br/>CIC + Σ∆<br/>（第 13 阶段）"]

    subgraph pruebas["仅在测试顶层 (HIL) 中"]
        direction LR
        rx["UART RX<br/>命令 C 和 T"] --> cap["捕获 · BSRAM<br/>样本或跟踪"]
        cap --> crc["转储 + CRC-32"] --> tx["UART TX"]
    end

    dac --> cap
    acc -. 跟踪 .-> cap
    tx --> pc["PC"]
```

所有逻辑都运行在**单一的 100 MHz 时钟域**中（ADR 0005（西班牙语））。有两种特殊情况：

- 测试用的频率计以格雷码跨入晶振时钟域。
- microSD 的时钟（SCK）来自 100 MHz 时钟的分频器。它不是另一个时钟域：MISO 输入经过两个触发器。

图中的虚线是从 microSD 加载。目前它只存在于顶层 `prueba_sd` 中，不含核心（第 08 阶段，进行中）。

## 模块

| 模块 | 文件 | 资源 | 延迟 |
|---|---|---|---|
| PLL 50 → 100 MHz | `rtl/primitivas/pll_100.v` | 1 个 PLLA | — |
| 样本发生器 | `rtl/comun/generador_muestra.v` | ~20 LUT | 1 个 tick / 2,048 周期 |
| 核心顺序器 | `rtl/nucleo/nucleo.v` | 大部分逻辑 | 按序流水线（ADR 0014，西班牙语）：1 个译码周期和 1 个或更多执行周期；只有读取 ACC 或刚写入的寄存器的指令才等待 |
| 微码 | `bsram_pipe` 2,048 × 54 + 一个寄存器 | 6 BSRAM | 4 个周期；连续取指，进入 4 个字的队列和一个寄存的队首；跳转的 `SKP` 清空队列（8 个周期） |
| 寄存器组 | 在 `nucleo.v` 内 | 64 × 24 触发器 + 8 个候选 + 写掩码 | 读取分 2 级：用队首取候选，在译码时选择；写入分 2 级：先寄存掩码和数据，再写寄存器；`WRAX` 之后，读取者等待 3 个周期 |
| 乘法器 | `rtl/primitivas/mult_27x36.v`（带 `PREG`）+ 1 个寄存器 | 2 DSP | 5 个周期（`LAT`） |
| 退休线 | 在 `nucleo.v` 内 | 4 级 ×（代码、一个 24 位操作数和 pc） | 乘积和它的指令一起到达 ALU；ACC 按程序顺序写入 |
| ALU | `rtl/nucleo/alu.v` | ~1,000 LUT 和 300 ALU | 2 级；第二级写 ACC（执行后 7 个周期） |
| 延迟存储器 | `rtl/nucleo/memoria_retardo.v` + 流水线化的 `bsram_pipe` | 每 1,024 字 1 个 BSRAM；~1,700 个副本触发器 | 9 个周期（`LAT_MEM`），仅用于 `RDA`、`CHO` 和 `RDAA`。如果程序使用 `RDAA` 或 `WRAA`，在 [P, P + 32,768) 有一个 32,768 字的绝对区域 |
| 寄存器副本 | `rtl/primitivas/registro_copia.v` | 带 `keep` 的 `DFF` 触发器 | 1 个周期 |
| LFO ×4 | `rtl/nucleo/lfo_banco.v` | ~380 LUT 和 377 ALU | 每个样本 26 个周期 |
| Hermite ROM | `rtl/nucleo/tabla_hermite.v`（生成） | ~820 LUT | 组合逻辑 + 寄存器 |
| 平滑曲线 | `rtl/nucleo/curva_fin.v` | 一次减法和一次饱和 | 寄存输出 |
| UART TX / RX | `rtl/comun/uart_tx.v`、`uart_rx.v` | 各 ~50 LUT | 115,200 波特 |
| 1 位音频输出 | `rtl/salida/salida_1bit.v`、`cic_interp.v`、`sigma_delta.v` | 尚未测量（第 13 阶段） | 6 个周期；调制器每个 100 MHz 周期输出一位（ADR 0015） |
| 音轨读取器 | `rtl/sd/lector_pista.v`、`lee_pista.v` | 队列占 1 个 BSRAM；尚未测量（第 13 阶段） | 每个 `tick` 一个样本，提前读取；队列可缓冲 21 ms |
| 程序加载器 | `rtl/comun/carga_programa.v` | ~30 LUT | 指令数 + 1 个周期 |
| 核心跟踪（仅 HIL） | `rtl/top/hil_nucleo.v`，命令 `T` | ~150 个触发器 | 把 (pc, ACC) 记录到捕获中 |
| HIL 的程序 | `hil_nucleo` 的参数 `PROGRAMA`；顶层 `hil_looper` 和 `hil_programa` | 一个逻辑实现的 ROM | 默认是 plate；looper 用来测试 `RDAA` 和 `WRAA`；`hil_programa` 使用 `sofifi rom` 写出的 ROM（`make hil HIL=名称`） |
| SD 控制器 | `rtl/sd/sd_spi.v` | 与加载器合计约 930 个触发器和约 390 个 ALU（yosys） | SPI 模式 0：启动时 400 kHz，读取时 12.5 MHz；用 CMD17 读 512 字节的块；只读 |
| 存储库加载器 | `rtl/sd/cargador.v`、`rtl/sd/carga_sd.v` | （见上一行） | 两遍：先检查魔数、范围、操作码和 CRC-32，不改动核心；然后停止核心、写入并再次检查 CRC（第 08 阶段） |
| SD 测试 | `rtl/top/prueba_sd.v`、`rtl/top/prueba_sd_logica.v` | 2,244 个 LUT4 和 490 个 ALU（标尺 RAT-20 和 RAT-21） | 先测试 PMOD TF 的 v2 版本，再测试 v1；通过 UART 接收命令 `S`（状态）和 `L`（加载一个槽位）；`scripts/prueba_sd.py` 与模型比较 |

## 预算（顶层 `hil_nucleo`，流水线核心，ADR 0014）

| 资源 | 用量 | 说明 |
|---|---|---|
| LUT4 | 12,329 / 23,040（54 %） | nextpnr 的数值，包含触发器的直通 LUT（标尺 RAT-16）。单独的核心（`nucleo_placa`）：11,982（RAT-11，F-33）。 |
| 触发器 | 7,145 / 23,040（31 %） | 约 3,100 个是副本和流水线寄存器（F-15）；约 450 个是队列和退休线。 |
| ALU | 1,318 / 17,280（8 %） | |
| BSRAM | 56 / 56 | 38 个用于延迟 + 6 个用于微码 + 12 个用于捕获。最终的踏板没有捕获：42 + 6 = 48。 |
| DSP | 2 / 28 | |
| 频率 | nextpnr 给出 110 MHz；**开发板上 125 MHz 无错误（3 次中 3 次），133.3 MHz（2 次中 2 次）**；looper 为 125 MHz（2 次中 2 次） | 相对 100 MHz 的实际余量至少为 25 %（ADR 0011，西班牙语）。nextpnr 的数值随布局种子变化（F-33）。 |
| 每个样本的周期数 | plate 790、hall 863、cloud 907、shimmer 1,037、sostenido 1,190、chorale 1,192；最贵的程序 `dados` 为 1,620；能装下的最贵的链“Cuerdas en ola”为 1,288，上限 2,048 | `sofifi asm` 和 `sofifi cadenas`；精确的时序模型见 `model/sofifi/domain/coste.py` |

## 来自故障的设计规则

- **BSRAM 的输出不在同一周期进入逻辑。** 存储器用 `bsram_pipe` 实现，它使用块内部的输出寄存器（F-11）。
- **一个周期内不做链式 50 bit 运算。** ALU 分两级；乘法器的输入来自寄存器（F-10、F-11）。
- **新的数组要写上 `ram_style`。** Yosys 会把每个按索引读取的数组变成 BSRAM，小数组也一样（F-24）。饱和只看三个高位，不与常数比较（ADR 0014，西班牙语）。
- **没有寄存器驱动遍布全芯片的模块。** 大存储器采用流水线：每个组和每个块都有地址副本，每个块旁边都有寄存输出（F-15）。
- **一个周期内没有宽多路选择器。** 寄存器组（64:1）分两级（F-15）。
- **寄存器组的写入不在同一周期译码。** 先寄存一个 64 bit 掩码和数据，再写入（F-19）。
- **伴随寄存地址的信号要和地址一起寄存**（F-20）。
- **并行加法优先于串行加法。** 如果一个修正取决于符号，就先计算所有选项，再由符号选择（F-15）。
- **ROM 放在逻辑中**，在 `case` 上加 `rom_style`，以免被映射为 BSRAM `SPX9`（F-09）。
- **时序在开发板上测量**（ADR 0011）：在 GW5A 上，nextpnr 乐观 1.45 到 1.5 倍。要有 20 % 的余量，nextpnr 需要给出约 150 MHz 或更高，并且要实测。如果失败，`margen_reloj.py --traza` 会指出是哪条指令。
- **改动不涉及逻辑后，nextpnr 报告的时钟失败是布局噪声。** 同一个网表下，`nucleo_placa` 随种子不同给出 95.41 到 112.10 MHz。如果只有时钟失败，`scripts/fpga.sh` 会尝试种子 2、3 和 4（F-33）。
- **SD 不打开另一个时钟域。** SCK 来自 100 MHz 时钟的分频器，MISO 经过两个触发器。因此 SD 的快速时钟不超过 12.5 MHz（`DIV_RAPIDO` = 4）。

## 各阶段历史

### 第 02 阶段 · 第一个比特流

UART TX 和一个计数器。没有 PLL，运行在 50 MHz。第一次“第二轮优化”后为 207 个 LUT4（F-07）。

### 第 03 阶段 · 原语

加入 PLL（`pll_100`）、DSP（`mult_27x18`）和推断式 BSRAM（`bsram_dp`）的封装，并在开发板上验证（MED-06 到 MED-08）。

### 第 04 阶段 · RTL 中的 DSP 核心

- 多周期顺序器：译码、带公共等待的执行、延迟 `LAT = 3`。
- 所有运算（24×18 和 24×24）只用一个 27×36 乘法器。
- 42 个块的延迟存储器、LFO、由模型生成的 Hermite ROM。
- 在 63,477 个样本上与模型一致（仿真）。nextpnr：140 MHz。

### 第 05 阶段 · 在开发板上验证的核心

- 复位结束后**清空延迟存储器**，以与模型相同的状态开始。
- **UART RX** 和顶层 `hil_nucleo`：以实际速度捕获，PC 请求时带 CRC-32 转储。
- **面向硅片的流水线化**（F-11）：
  - `LAT` 从 3 改为 5；
  - 带输出寄存器的 BSRAM（`bsram_bloque`、`bsram_pipe`）；
  - ALU 分两级；
  - `CHO` 的地址分三步计算。
- plate 程序在 100 MHz 下**在硅片上**与模型逐位一致。
- 开销：每条指令约 13 个周期，第 04 阶段约为 6 个。

### 第 06 阶段 · 前置条件：预读和 20 % 余量

- **预读：** 译码一条指令时，向微码请求下一条。如果没有跳转，需要时下一条已经读出。
- **面向硅片的流水线化**（F-15）：
  - 延迟存储器按 8 个块分组流水线化，带本地地址副本（`registro_copia`）和寄存输出；读取需要 9 个周期（`LAT_MEM`）；
  - 寄存器组分两级；
  - 物理地址用三个并行加法计算；
  - DSP 内部使用 `PREG`。
- **开发板上的核心跟踪：** HIL 顶层记录 (pc, ACC)，PC 指出最先出错的指令。
- 实测余量：**120 MHz 无错误**，第 05 阶段为 106 MHz。
- 每个样本的周期数：shimmer 1,514（之前 1,601）。预读节省约 150 个周期，分段存储器增加约 65 个。

### 第 06 阶段 · 程序库（RTL 不变）

- 六个新程序，在仿真中与模型一致：hall、cloud、reverse、lofi 和 swell 用 4,883 个样本；cinta 用 12,000 个，以到达它的第一个回声。
- **不用 AND 的量化：** lo-fi 程序把样本按比例缩小，在写入寄存器（`WRAX`）时舍入。之后用 `SOF` 再放大回去。
- **无需新指令的可变延迟：** cinta 程序让一个正弦 LFO 停在四分之一周处。此时其波形值为 1，`CHO` 的延迟跟随程序写入的 `lfo0_depth`。
- **RTL 中每条指令的开销**，在仿真中测得并复制到模型中（`coste.py`）：

| 指令 | 周期 |
|---|---|
| `NOP`、`LDAX`、`CLR`、`ABSA`；不跳转的 `SKP` | 6 |
| 跳转的 `SKP` | 8 |
| `RDAX`、`WRAX`、`WRA`、`WRAP`、`MAXX`、`MULX`、`SOF` | 10 |
| `RDFX` | 11 |
| `CLIP` | 14 |
| `RDA` | 19 |
| `CHO`（带 `na`：57） | 52 |
| 每个样本的固定开销（上界） | 34 |

- 总和不超过 2,048 时，程序可以装下。`sofifi asm` 给出总和，`programas_test.py` 强制要求这一点。
- **cloud 程序使用 42,814 个字：装不进 `hil_nucleo`**。该顶层只有 38 个延迟块，为捕获留出空间。要在开发板上测试 cloud，需要缩小捕获。

### 第 07 阶段 · RDAA 和 WRAA（绝对区域）

- **两条新指令**（ADR 0009，2026-10-07 更新）：`RDAA` 用线性插值读取，`WRAA` 写入。两者访问一个 32,768 字、没有指针的区域。寄存器 R 给出位置。
- **绝对区域：**位于循环存储器之后，在 [P, P + 32,768)。物理地址是一次加法（P + i），与循环存储器的地址并行计算。复位时也清除该区域。
- **预译码：**有 18 条指令时，在 `E_EJEC` 中根据 6 bit 的 `op` 做判断会拉长控制路径。`E_DECO` 把指令的类别和一些标志存入寄存器。
- **寄存的 `tick`**：在核心入口处寄存，输入在同一个时钟沿捕获。
- **寄存器组的写入分两级**，`RDAA` 的减法也寄存（F-19）。实测余量：**125 MHz 无错误**，第 06 阶段为 120 MHz。

| 指令 | 周期 |
|---|---|
| `WRAA` | 10 |
| `RDAA`（两次读取、差值乘以小数部分、再乘以 C） | 27 |

- **板上的 looper**（顶层 `hil_looper`）：HIL 激励按下脚踏开关，先录音，再叠录。从 100 到 125 MHz，looper 与模型逐位一致。这是 `RDAA` 和 `WRAA` 在芯片上的第一次测试。
- **整个目录在板上运行**（顶层 `hil_programa`，`make hil HIL=名称`）：41 个程序和 9 条链与模型逐位一致（MED-16）。这些是能装进 `hil_nucleo` 的 38 个块的全部程序和链。用周期最多的是 `chorale`：2,048 个中的 1,935 个。
- **使用分段内核**（ADR 0014）：68 个程序和 9 条链与模型逐位一致（MED-17，2026-10-10）。这些是计入绝对区后能装进 `hil_nucleo` 的全部（F-37）。用周期最多的是 `dados`：2,048 个中的 1,409 个。

### 第 07 阶段之后 · 按序流水线核心（ADR 0014，西班牙语）

- **解耦的退休：** 指令把乘积放进退休线，顺序器转到下一条指令。ACC 按程序顺序写入。
- **只为依赖而等待：** 读取 ACC 的指令等到退休线清空；读取寄存器组的指令在 `WRAX` 之后等待 3 个周期。
- **取指队列：** 核心不停地请求微码；4 个字的队列和一个寄存的队首给出下一条指令。
- **精确的时序模型：** `coste.py` 复制顺序器；仿真要求与 RTL 的周期数相同。
- **时序：** 第一个版本在芯片上 125 MHz 时失败。跟踪指出了 ACC 回路：加法前的转发，以及用两个 50 位比较实现的饱和。去掉转发并按高位饱和后：125 MHz（3 次中 3 次），133.3 MHz（2 次中 2 次）。

| 指令 | 周期（多周期） | 周期（流水线），无依赖 |
|---|---|---|
| `RDAX`、`WRAX`、`WRA`、`WRAP`、`SOF`、`MULX`、`MAXX` | 10 | 2 |
| `RDA` | 19 | 11 |
| `CHO`（SIN LFO） | 52 | 44 |
| `RDAA` | 27 | 19 |

读取 ACC 的指令，在写它的前一条指令结束后等待 7 个周期。平均而言，程序用的周期少 1.6 倍。能装下的串联组合从 2,550 个中的 790 个增加到 1,312 个（加上共享寄存器，ADR 0013，西班牙语）。

### 第 08 阶段 · 从 microSD 加载程序（进行中）

存储卡没有文件系统：它保存一个由原始块组成的程序库，由 `sofifi banco` 写入（`docs/microsd.md`，西班牙语）。

- **格式**（`model/sofifi/domain/banco.py`）：块 0 是头部；槽位 *k* 从块 1 + 28·*k* 开始。每个槽位有 1 个元数据块和 27 个微码块。程序库最多容纳 1,024 个程序。
- **`sd_spi`：** 以 400 kHz 用 CMD0、CMD8、ACMD41 和 CMD58 在 SPI 模式下启动存储卡。之后以 12.5 MHz 用 CMD17 读取 512 字节的块。它只接受版本 2 的卡，例如所有 SDHC 和 SDXC 卡。它不向存储卡写入。
- **`cargador`：** 分两遍。第一遍检查头部、范围、每个操作码、跳转和两个 CRC-32，不改动核心。第二遍停止核心、写入微码并再次检查 CRC。如果第二遍失败，核心保持停止：静音胜过半个程序。
- **`prueba_sd`：** 测试顶层，不含核心。PMOD TF 有两个版本，CS 和 SCK 在不同的引脚上；顶层先测试 v2，再测试 v1。
- **状态：** 模型、RTL 和顶层在仿真中给出相同的数据，使用 cocotb 中的存储卡模型（`sim/sd/tarjeta_sd.py`）。**还缺少用真实存储卡的测试。**

### 第 13 阶段 · 踏板在没有声卡芯片时也能出声（进行中）

时钟是 fs 的 2,048 倍，所以一个引脚就能输出音频（ADR 0015）。音源是 microSD 上的一段音轨，因为在第 11 阶段之前没有模拟输入。

- **输出链**（`rtl/salida/`）：限幅到 ±13/16 → Hogenauer CIC（S = 2，R = 32）→ 保持 64 个周期 → 二阶 sigma-delta 调制器 → 一个引脚。模型为准（`model/sofifi/domain/salida_1bit.py`），RTL 给出相同的位流，延后 6 个周期。
- **`lector_pista`：** 校验音轨头部（魔数、版本、CRC-32 和各项上限），每个 `tick` 送出一个样本，队列为 1,024 个样本，占一个 BSRAM 块。音轨播完会从头重复。
- **`audio_sd`：** 顶层。microSD → 核心 → 1 位输出，状态通过 UART 报出。核心要等音轨的第一个样本就绪才启动，因此 RTL 可以端到端地与模型比较。
- **资源：** 12,593 个 LUT4（55 %）、1,566 个 ALU、7,646 个触发器、49 个 BSRAM（共 56 个）和 2 个 DSP。nextpnr 在 107 MHz 收敛；真实余量在开发板上测量（ADR 0011）。
- **状态：** 在仿真中与模型逐位相同。**还缺开发板上的测试**，需要 `docs/audio_1bit.md` 里的 RC 滤波器。

### 下一个计划中的改动

**2026-10-08 的测量：两个或三个核心装不下**（ADR 0013，西班牙语）。两个核心时，yosys 在布局前给出 13,112 个 LUT4 和 9,928 个触发器，nextpnr 找不到合法的布局，即使 BSRAM 只用 78 % 也一样。三个核心时为 19,046 个 LUT4。同时运行两个效果用链来实现：一个组合程序，不改动 RTL。项目所有者确认：不加第二个核心。

现在核心只为依赖而等待（ADR 0014，西班牙语）。下一个节省周期的方法是提前读存储器，或把 `LAT` 降到 3（ADR 0014，选项 3 和 4）。现在存储器的限制更大：这是 SDRAM 的工作。
