cabezoide/sofifi/docs/programas.ja.md

<!-- i18n: fuente=docs/programas.md sha=a41cb76789d0 estado=al_dia -->
<!-- GENERADO por `sofifi catalogo` desde programas/*.sasm. No se edita a mano:
     model/tests/catalogo_test.py lo compara con su generador. -->

# コアのプログラム

86 のプログラムと 1032 のプリセット。各プログラムは `programas/` のテキストファイルで、プリセットは `presets/banco.toml` にあります。プログラム名とプリセット名はスペイン語です。
サイクル数は RTL の上限で、1 サンプルあたり 2,048（`model/sofifi/domain/coste.py`）。メモリーは 43,008 ワードです。

## リバーブ

| プログラム | 働き | ノブ | プリセット | 命令数 | サイクル | メモリー |
|---|---|---|---|---|---|---|
| `baldosa` | 2 本のエコーを交差させた汚れたリバーブ。暗くざらつき、タイル張りの浴室のよう。 | 0: タイム<br>1: ディケイ<br>2: ミックス<br>3: モジュレーション<br>4: トーン<br>5: サンプリング周波数 | 12 | 152 | 1,145 | 8,258 |
| `blackhole` | 数十秒の減衰を持つ巨大なホール。 | 0: ディケイ<br>1: ダンピング<br>2: ミックス | 12 | 140 | 883 | 40,882 |
| `bloom` | 各ノートの後、花が開くようにリバーブがゆっくり育ちます。 | 0: ディケイ<br>1: ダンピング<br>2: ミックス<br>3: 開く時間 | 12 | 84 | 637 | 23,520 |
| `chorale` | plate の残響が「a」から「i」までの母音を歌います。 | 0: ディケイ<br>1: ダンピング<br>2: ミックス<br>3: 母音 | 12 | 160 | 1,192 | 37,439 |
| `cloud` | ランダム変調付きの長いディフューザー：アタックが溶けていきます。 | 0: ディケイ<br>1: ダンピング<br>2: ミックス<br>3: モジュレーション | 12 | 96 | 907 | 42,814 |
| `dinamica` | 弾く強さで残響が変わる plate。 | 0: ディケイ<br>1: ダンピング<br>2: ミックス<br>3: 深さ<br>4: スレッショルド<br>5: 速さ | 12 | 141 | 1,188 | 37,439 |
| `ensemble` | plate の前に 3 声のコーラス：残響がストリングス・セクションのように響きます。 | 0: ディケイ<br>1: ダンピング<br>2: ミックス<br>3: アンサンブル | 12 | 99 | 953 | 38,540 |
| `freeze` | フットスイッチで残響を凍らせる plate。残響は動き続けます。 | 0: ディケイ<br>1: ダンピング<br>2: ミックス | 12 | 112 | 979 | 37,439 |
| `freeze_givens` | エネルギーを失わずに動くフリーズ：凍った残響が枝の間で回転します。 | 0: ディケイ<br>1: ダンピング<br>2: ミックス<br>3: 回転 | 12 | 136 | 1,138 | 37,439 |
| `gated` | アタックの後に突然止まるリバーブ。80 年代のサウンド。 | 0: ディケイ<br>1: ダンピング<br>2: ミックス<br>3: 長さ | 12 | 133 | 1,098 | 37,439 |
| `hall` | Householder 行列を持つ 8 本のディレイ網：大きなホール。 | 0: ディケイ<br>1: ダンピング<br>2: ミックス | 12 | 137 | 863 | 34,522 |
| `infinite` | 減衰しない plate：各ノートが消えないレイヤーに重なります。 | 0: リリース<br>1: ダンピング<br>2: ミックス | 12 | 95 | 872 | 37,439 |
| `marea` | plate の残響が波のように左右交互に上下します。ドライ音は変わりません。 | 0: ディケイ<br>1: ダンピング<br>2: ミックス<br>3: 速さ | 12 | 137 | 1,126 | 37,439 |
| `plate` | モジュレーション付きタンクの Dattorro プレート。 | 0: ディケイ<br>1: ダンピング<br>2: ミックス | 12 | 86 | 790 | 37,439 |
| `plate_vivo` | モジュレーションがランダムに漂う plate：残響は二度と同じになりません。 | 0: ディケイ<br>1: ダンピング<br>2: ミックス<br>3: ゆらぎ | 12 | 127 | 1,054 | 37,439 |
| `resonador` | E メジャーに調律した 4 本の弦が、演奏に共鳴して鳴ります。 | 0: サステイン<br>1: 励起<br>2: ミックス<br>3: チューニング | 12 | 89 | 525 | 1 |
| `reverb_inversa` | リバースリバーブ：アタックの後、残響が膨らみ突然止まります。 | 0: ディケイ<br>1: ダンピング<br>2: ミックス<br>3: 長さ | 12 | 133 | 1,098 | 37,439 |
| `semilla` | 初期反射をシードから作るクラウドリバーブ：シードごとに別の部屋になります。 | 0: ディケイ<br>1: ダンピング<br>2: ミックス<br>3: シード<br>4: 密度<br>5: モジュレーション | 12 | 196 | 1,513 | 42,934 |
| `shimmer` | フィードバックに +12 を持つ plate：一巡ごとに 1 オクターブ上がります。 | 0: ディケイ<br>1: ダンピング<br>2: ミックス<br>3: シマー量 | 12 | 108 | 1,037 | 41,539 |
| `shimmer_energia` | 自ら調整する shimmer：オクターブが溜まるほど追加を減らします。 | 0: ディケイ<br>1: ダンピング<br>2: ミックス<br>3: シマー量 | 12 | 117 | 1,095 | 41,539 |
| `shimmer_escondido` | 隠れた shimmer：弾いている間はオクターブが静かで、テールで現れます。 | 0: ディケイ<br>1: ダンピング<br>2: ミックス<br>3: シマー量<br>4: ダッキング<br>5: トーン | 12 | 139 | 1,239 | 41,539 |
| `shimmer_grave` | 下向きの shimmer：一巡ごとに 1 オクターブ下がり、残響が低いオルガンになります。 | 0: ディケイ<br>1: ダンピング<br>2: ミックス<br>3: シマー量 | 12 | 108 | 1,037 | 41,539 |
| `shimmer_quinta` | 5 度の shimmer：一巡ごとに 7 半音上がり、和音が開くように響きます。 | 0: ディケイ<br>1: ダンピング<br>2: ミックス<br>3: シマー量 | 12 | 108 | 1,037 | 41,539 |
| `shoegaze` | 残響の後で歪む plate：ギターの後ろに温かいノイズの壁。 | 0: ディケイ<br>1: ダンピング<br>2: ミックス<br>3: サチュレーション | 12 | 142 | 1,106 | 37,439 |
| `sostenido` | 自動フリーズ：新しいコードを捉え、パッドとして鳴らし続けます。 | 0: レイヤー<br>1: ダンピング<br>2: ミックス<br>3: キャプチャー | 12 | 141 | 1,190 | 37,439 |
| `spring` | スプリングリバーブ：高音が低音より先に来る、滴るような音。 | 0: ディケイ<br>1: ダンピング<br>2: ミックス | 12 | 95 | 832 | 1,850 |

## ディレイ

| プログラム | 働き | ノブ | プリセット | 命令数 | サイクル | メモリー |
|---|---|---|---|---|---|---|
| `aureo` | フィボナッチ数列に並ぶ 14 のエコー。左右に交互に出て、カチカチと鳴るリバーブへと密になる。 | 0: 傾き<br>1: フィードバック<br>2: ミックス<br>3: トーン<br>4: 幅<br>5: 拡散 | 12 | 141 | 1,096 | 42,259 |
| `bbd` | 暗いアナログのエコー：繰り返すたびに高域が減り、飽和します。 | 0: タイム<br>1: フィードバック<br>2: ミックス<br>3: モジュレーション | 12 | 44 | 408 | 14,674 |
| `bruma` | 4 ヘッドのエコー。一巡ごとにぼやけ、やがてリバーブになります。 | 0: 拡散<br>1: フィードバック<br>2: ミックス<br>3: ヘッド | 12 | 53 | 536 | 41,553 |
| `cinta` | 0.18〜0.85 秒のテープエコー。ワウ、フラッター、飽和付き。 | 0: タイム<br>1: フィードバック<br>2: ミックス<br>3: ワウとフラッター | 12 | 50 | 484 | 41,600 |
| `compas` | タップテンポと5つの音価（4分、付点8分、8分、3連符、16分）を持つエコー。 | 0: タイム<br>1: フィードバック<br>2: ミックス<br>3: 音符分割<br>4: セカンドタップ<br>5: トーン | 12 | 135 | 885 | 32,769 |
| `dados` | 時間とオクターブがランダムな 4 つのエコー。sw でサイコロを振り直す。 | 0: タイム<br>1: フィードバック<br>2: ミックス<br>3: 確率<br>4: トーン<br>5: 幅 | 12 | 239 | 1,620 | 38,260 |
| `delay` | 20〜690 ms のクリーンなデジタルエコー。フィードバックにトーン付き。 | 0: タイム<br>1: フィードバック<br>2: ミックス<br>3: トーン | 12 | 38 | 309 | 33,749 |
| `deriva` | 迷走するエコー。タイムがランダムに跳び、グライドで新しい値へ移る。 | 0: タイム<br>1: 深さ<br>2: ミックス<br>3: 速さ<br>4: グライド<br>5: フィードバック | 12 | 128 | 969 | 33,796 |
| `dos_ecos` | リズムに合わせた2つのエコー。片方はクリーン、片方はテープ。交差して拡散した雲になります。 | 0: タイム<br>1: フィードバック<br>2: ミックス<br>3: 比率<br>4: バランス<br>5: 拡散 | 12 | 142 | 1,131 | 41,258 |
| `ducking` | 弾いている間は控えめになり、休みで現れるエコー。 | 0: タイム<br>1: フィードバック<br>2: ミックス<br>3: ダッキング | 12 | 51 | 394 | 33,749 |
| `eco_casero` | 自作チップのエコー。短い時間ではクリーン、長くすると暗く、粗く、ポンピングします。 | 0: タイム<br>1: フィードバック<br>2: ミックス<br>3: 汚れ<br>4: モジュレーション<br>5: トーン | 12 | 124 | 1,002 | 41,492 |
| `enjambre` | 8 つの短いエコーの群れ。集まればリバーブ、広がれば個々のエコー。 | 0: 広がり<br>1: フィードバック<br>2: ミックス<br>3: 拡散<br>4: トーン<br>5: ドリフト | 12 | 199 | 1,377 | 42,820 |
| `estelar` | ループの中にフェイザーを入れたエコー。繰り返すごとにうねりが深まり、テールが渦を巻きます。 | 0: タイム<br>1: フィードバック<br>2: ミックス<br>3: 深さ<br>4: 速さ<br>5: レゾナンス | 12 | 123 | 830 | 33,749 |
| `frenada` | ブレーキ付きテープエコー。踏むとテープが止まり、エコーは無音まで落ちる。 | 0: タイム<br>1: フィードバック<br>2: ミックス<br>3: ブレーキ時間<br>4: 始動時間<br>5: ワウとフラッター | 12 | 156 | 1,199 | 32,876 |
| `lata` | オイル缶エコー：短く、濁った、液体のような響き。ビブラートはタイムに連動します。 | 0: タイム<br>1: フィードバック<br>2: ミックス<br>3: 深さ<br>4: トーン<br>5: オイル | 12 | 90 | 768 | 18,931 |
| `lluvia` | オールパスで崩れる 6 つの不規則なエコー：ノートの雨。 | 0: 拡散<br>1: フィードバック<br>2: ミックス | 12 | 46 | 364 | 35,385 |
| `oscilador` | レベルの上限付きで自己発振するエコー。タイムで音程を変えます。 | 0: タイム<br>1: フィードバック<br>2: ミックス<br>3: スムージング<br>4: トーン<br>5: レベル | 12 | 86 | 614 | 24,678 |
| `pingpong` | 左右に跳ねるステレオのエコー。 | 0: タイム<br>1: フィードバック<br>2: ミックス | 12 | 38 | 353 | 40,874 |
| `probabilidad` | 8 つのエコーが確率で鳴ったり止まったりする。短い時間では変化するリバーブ、長い時間では繰り返さないパターン。 | 0: タイム<br>1: 確率<br>2: ミックス<br>3: フィードバック<br>4: トーン<br>5: スムージング | 12 | 220 | 1,450 | 34,456 |
| `reverse` | 0.17 秒のグレインで反転したエコー。 | 0: トーン<br>1: フィードバック<br>2: ミックス | 12 | 34 | 301 | 16,388 |
| `tambor` | 4 ヘッドの磁気ドラム・エコー。オンにしたヘッドの組み合わせがリズムになります。 | 0: 速さ<br>1: フィードバック<br>2: ミックス<br>3: ヘッド<br>4: エイジング<br>5: トーン | 12 | 173 | 1,328 | 37,656 |

## モジュレーション

| プログラム | 働き | ノブ | プリセット | 命令数 | サイクル | メモリー |
|---|---|---|---|---|---|---|
| `armonico` | 低音と高音が逆位相で揺れます。pot2 で後ろにエコーを加えます。 | 0: 速さ<br>1: 深さ<br>2: エコー<br>3: 周波数<br>4: 波形<br>5: 幅 | 12 | 125 | 847 | 17,101 |
| `chorus` | 動くディレイを持つ 3 声。 | 0: 速さ<br>1: 深さ<br>2: ミックス | 12 | 42 | 416 | 1,101 |
| `desplazador` | 周回ごとに周波数をずらすエコー。テールが螺旋のように上がり、または下がります。 | 0: 周波数シフト<br>1: タイム<br>2: ミックス<br>3: フィードバック<br>4: トーン<br>5: 幅 | 12 | 110 | 864 | 33,767 |
| `dimension` | ステレオを広げて厚みを加えますが、ピッチは揺れないコーラスです。 | 0: モード<br>1: 速さ<br>2: ミックス<br>3: 深さ<br>4: クロスフィード<br>5: トーン | 12 | 94 | 795 | 505 |
| `flanger` | フィードバック付きのとても短い可動ディレイ：くし形が動きます。 | 0: 速さ<br>1: 深さ<br>2: ミックス<br>3: フィードバック | 12 | 31 | 266 | 247 |
| `orilla` | ゆっくりしたランダム・コーラスと、音ごとに閉じるローパスゲート。 | 0: 速さ<br>1: 深さ<br>2: ミックス<br>3: スムージング<br>4: ローパスゲート<br>5: 感度 | 12 | 147 | 1,078 | 736 |
| `phaser` | 係数が動く 4 つのオールパス：ノッチが動きます。 | 0: 速さ<br>1: 深さ<br>2: ミックス<br>3: フィードバック | 12 | 80 | 521 | 1 |
| `slicer` | 音をリズミカルなパルスに刻みます。開閉するゲートのように。 | 0: 速さ<br>1: 深さ<br>2: デューティ比<br>3: スムージング | 12 | 37 | 262 | 1 |
| `tremolo` | 音量が上下します。pot2 で左右に動きます。 | 0: 速さ<br>1: 深さ<br>2: パン | 12 | 43 | 325 | 1 |
| `vibe` | ランプ式ヴァイブ：不揃いな 4 段の位相。スイープは速く上がり、ゆっくり下がります。 | 0: 速さ<br>1: 深さ<br>2: ミックス<br>3: フィードバック<br>4: 波形<br>5: トーン | 12 | 125 | 830 | 1 |
| `vibrato` | ピッチが上下します。 | 0: 速さ<br>1: 深さ<br>2: ミックス | 12 | 27 | 240 | 125 |

## ピッチ

| プログラム | 働き | ノブ | プリセット | 命令数 | サイクル | メモリー |
|---|---|---|---|---|---|---|
| `acople` | 音を伸ばすと、その上に歪んだ倍音が育ちます。アンプのフィードバックのようです。 | 0: タイム<br>1: 音程<br>2: ミックス<br>3: 立ち上がり<br>4: トーン<br>5: レベル | 12 | 138 | 1,038 | 3,550 |
| `arcoiris` | 再生ループ内の 2 つの移調声部。制御された自己発振が可能。 | 0: 音程<br>1: 第2声部<br>2: ミックス<br>3: タイム<br>4: フィードバック<br>5: トーン | 12 | 76 | 693 | 12,345 |
| `armonizador` | −12、−7、−5、+5、+7、+12 半音の 1 声。フィードバック付き。 | 0: 音程<br>1: フィードバック<br>2: ミックス | 12 | 55 | 450 | 4,100 |
| `arpegio` | 各音が移調されたアルペジオ（1-3-5-8）に開き、リバーブへ落ちていきます。 | 0: 速さ<br>1: 音数<br>2: ミックス<br>3: モード<br>4: エコー<br>5: ディケイ | 12 | 163 | 1,259 | 42,851 |
| `doblador` | 数セントずらした 2 声を左右に置き、音を広げます。 | 0: デチューン<br>2: ミックス | 12 | 32 | 346 | 1,028 |
| `escalera` | 繰り返すたびに音程が上下するエコー：階段のように。 | 0: 音程<br>1: フィードバック<br>2: ミックス<br>3: タイム | 12 | 67 | 582 | 39,313 |
| `espiral` | 残響がらせん状に上昇または下降するリバーブ。左右で別々の音程を持ちます。 | 0: 音程<br>1: 第2声部<br>2: ミックス<br>3: タイム<br>4: フィードバック<br>5: ディケイ | 12 | 171 | 1,455 | 42,878 |
| `octava` | オクターバー：1 オクターブ下と上。それぞれにレベル。 | 0: 下のオクターブ<br>1: 上のオクターブ<br>2: ドライ | 12 | 25 | 296 | 4,100 |

## ダイナミクス

| プログラム | 働き | ノブ | プリセット | 命令数 | サイクル | メモリー |
|---|---|---|---|---|---|---|
| `arco` | 弓のようなサステイン：ノートはフェードインし、一定の音量を保ち、オクターブ上へ移れます。 | 0: サステイン<br>1: 立ち上がり<br>2: ミックス<br>3: 上のオクターブ<br>4: トーン<br>5: スレッショルド | 12 | 122 | 897 | 2,052 |
| `compresor` | コンプレッサー：大きな音を下げ、小さな音は残し、ノートを伸ばします。 | 0: スレッショルド<br>1: 圧縮<br>2: ミックス<br>3: ゲイン | 12 | 57 | 394 | 1 |
| `puerta` | ノイズゲート：ノートの間のハムを消し、演奏は通します。 | 0: スレッショルド<br>1: リリース | 12 | 29 | 222 | 1 |
| `swell` | 各ノートは無音から立ち上がり、その後 plate に入ります。 | 0: ディケイ<br>1: ダンピング<br>2: ミックス<br>3: 立ち上がり | 12 | 116 | 983 | 37,439 |
| `swell_ritmico` | 各ノートは選んだカーブと時間で立ち上がり、足で刻むテンポにも合わせられます。プレートは揺らぎます。 | 0: 立ち上がり<br>1: 波形<br>2: ミックス<br>3: ディケイ<br>4: ドリフト<br>5: 感度 | 12 | 216 | 1,611 | 37,439 |
| `violin` | 各ノートはピックのアタックなしで、弓のように立ち上がり、ビブラートは後から来ます。 | 0: 立ち上がり<br>1: タイム<br>2: ミックス<br>3: 深さ<br>4: 速さ<br>5: トーン | 12 | 118 | 845 | 85 |

## テクスチャー

| プログラム | 働き | ノブ | プリセット | 命令数 | サイクル | メモリー |
|---|---|---|---|---|---|---|
| `granular` | Hann 窓、オクターブ単位のピッチ、フリーズ付きの 4 声グラニュラー。 | 0: 長さ<br>1: 拡散<br>2: 音程<br>3: ミックス | 12 | 188 | 1,209 | 32,769 |
| `lofi` | サンプル数とビット数を減らし、エイリアシングを加えます。 | 0: サンプリング周波数<br>1: ビット<br>2: ミックス<br>3: トーン | 12 | 81 | 577 | 1 |
| `ringmod` | リングモジュレーター：ギターにサイン波を掛け、金属的に鳴らします。 | 0: 周波数<br>2: ミックス | 12 | 33 | 236 | 1 |
| `saturacion` | オーバードライブ系の飽和：温かい艶から厚い歪みまで。 | 0: ゲイン<br>1: トーン<br>2: ミックス<br>3: レベル | 12 | 42 | 277 | 1 |
| `viento` | ランダムに鳴る、フィルターをかけたノイズの突風。弾くと強く吹きます。 | 0: 速さ<br>1: レゾナンス<br>2: ミックス<br>3: 感度<br>4: 周波数<br>5: レベル | 12 | 140 | 913 | 3,728 |

## フィルター

| プログラム | 働き | ノブ | プリセット | 命令数 | サイクル | メモリー |
|---|---|---|---|---|---|---|
| `ancho` | モノラルのギターをステレオに広げ、低音と高音の音色を傾けます。 | 0: 幅<br>1: チルト | 12 | 26 | 185 | 636 |
| `autowah` | オートワウ：強く弾くほどフィルターが上がります。 | 0: 感度<br>1: レゾナンス<br>2: ミックス | 12 | 43 | 295 | 1 |
| `filtro` | LFO で自動的に上下する、レゾナンス付きローパスフィルター。 | 0: 速さ<br>1: レゾナンス<br>2: ミックス<br>3: 深さ | 12 | 61 | 402 | 1 |

## ルーパー

| プログラム | 働き | ノブ | プリセット | 命令数 | サイクル | メモリー |
|---|---|---|---|---|---|---|
| `erosion` | 一周ごとに擦り切れるテープループ。高域とレベルを失い、ワウ、粒子感、飽和を増していきます。 | 0: 侵食<br>1: ダンピング<br>2: ミックス<br>3: モジュレーション<br>4: レベル<br>5: 長さ | 12 | 161 | 1,043 | 32,769 |
| `looper` | 0.67 秒のマイクロルーパー。オーバーダブ、½×、2×、リバース付き。 | 0: レベル<br>1: 速さ<br>2: 方向<br>3: フィードバック | 12 | 87 | 576 | 32,769 |
| `mosaico` | 0.67 秒のサウンド・オン・サウンドのループを ½×、1×、2× で同時に再生します。 | 0: 下のオクターブ<br>1: レベル<br>2: ミックス<br>3: 上のオクターブ<br>4: フィードバック<br>5: 拡散 | 12 | 144 | 1,064 | 34,662 |
| `relevo` | 2 層のフリーズ。踏むたびに新しいコードを固め、前のコードからフェードで入れ替えます。ベンドとビブラート付き。 | 0: タイム<br>1: チューニング<br>2: ミックス<br>3: ビブラート<br>4: トーン<br>5: レベル | 12 | 197 | 1,438 | 34,140 |
| `resbalon` | 自由な再生ヘッドが今弾いた音の上を −2× から 2× で滑ります。録音は不要です。 | 0: 速さ<br>1: フィードバック<br>2: ミックス<br>3: 長さ<br>4: トーン<br>5: タイム | 12 | 119 | 865 | 32,769 |
| `tartamudeo` | 強いアタックごとに短い断片を捉え、少しずつ小さくしながら繰り返します。 | 0: スレッショルド<br>1: 長さ<br>2: ミックス<br>3: リピート回数<br>4: 速さ<br>5: トーン | 12 | 188 | 1,240 | 32,769 |

## チェーン

チェーンは 2 つのプログラムを直列（→）または並列（‖）で 1 つにまとめます。RTL は変えません（ADR 0013、スペイン語）。チェーンは `presets/cadenas.toml` にあり、`sofifi cadena` で処理します。現在 18 本が収まり、6 本は SDRAM を待っています：足りないのはメモリーだけです。

| チェーン | プログラム | サイクル | メモリー | レジスタ | LFO | 状態 |
|---|---|---|---|---|---|---|
| Armonía en la placa | `armonizador` → `plate` | 1,270 | 41,539 | 14 | 3 | 収まる |
| Bruma que gira | `bruma` → `chorus` | 950 | 42,654 | 12 | 4 | 収まる |
| Campanas | `ringmod` → `shimmer` | 1,239 | 41,539 | 18 | 3 | 収まる |
| Cinta desgastada | `cinta` → `lofi` | 1,085 | 41,600 | 18 | 3 | 収まる |
| Cuerdas en ola | `tremolo` → `ensemble` | 1,288 | 38,540 | 16 | 4 | 収まる |
| Doble resonancia | `doblador` → `resonador` | 879 | 1,028 | 24 | 2 | 収まる |
| Eco oscuro en flor | `bbd` → `bloom` | 1,053 | 38,194 | 20 | 2 | 収まる |
| Eco y muelle | `delay` → `spring` | 1,149 | 35,599 | 14 | 1 | 収まる |
| Eco y resonancia | `delay` ‖ `resonador` | 870 | 33,749 | 27 | 1 | 収まる |
| Flor al revés | `reverse` → `bloom` | 930 | 39,908 | 17 | 1 | 収まる |
| Fuzz en la nube | `saturacion` → `cloud` | 1,248 | 42,814 | 16 | 4 | 収まる |
| Loop filtrado | `looper` → `filtro` | 1,018 | 32,769 | 23 | 0 | 収まる |
| Octavas en flor | `octava` ‖ `bloom` | 953 | 27,620 | 18 | 2 | 収まる |
| Placa que tiembla | `tremolo` → `plate` | 1,109 | 37,439 | 14 | 2 | 収まる |
| Shimmer con vibrato | `vibrato` → `shimmer` | 1,243 | 41,664 | 18 | 4 | 収まる |
| Silencio y agujero negro | `puerta` → `blackhole` | 1,099 | 40,882 | 20 | 2 | 収まる |
| Sustain en la placa | `compresor` → `plate` | 1,214 | 37,439 | 17 | 2 | 収まる |
| Órgano infinito | `octava` → `infinite` | 1,246 | 41,539 | 13 | 4 | 収まる |
| Bruma en flor | `bruma` → `bloom` | 1,181 | 65,073 | 19 | 1 | SDRAM 待ち |
| Cinta en la flor | `cinta` → `bloom` | 1,129 | 65,120 | 20 | 3 | SDRAM 待ち |
| Eco al revés congelado | `reverse` → `freeze` | 1,310 | 53,827 | 15 | 3 | SDRAM 待ち |
| Eco en la nube | `delay` → `plate` | 1,113 | 71,188 | 15 | 3 | SDRAM 待ち |
| Lluvia sobre la placa | `lluvia` → `plate` | 1,148 | 72,824 | 12 | 2 | SDRAM 待ち |
| Ping-pong infinito | `pingpong` → `infinite` | 1,223 | 78,313 | 13 | 3 | SDRAM 待ち |
