cabezoide/sofifi/docs/programas.zh-CN.md

<!-- i18n: fuente=docs/programas.md sha=a41cb76789d0 estado=al_dia -->
<!-- GENERADO por `sofifi catalogo` desde programas/*.sasm. No se edita a mano:
     model/tests/catalogo_test.py lo compara con su generador. -->

# 核心程序

86 个程序与 1032 个预设。每个程序都是 `programas/` 中的一个文本文件；预设位于 `presets/banco.toml`。程序名与预设名为西班牙语。
周期数为 RTL 的上限，每个样本 2,048 个（`model/sofifi/domain/coste.py`）。存储器共 43,008 个字。

## 混响

| 程序 | 作用 | 旋钮 | 预设 | 指令数 | 周期 | 存储器 |
|---|---|---|---|---|---|---|
| `baldosa` | 由两路交叉回声构成的脏混响，暗而有颗粒感，像铺满瓷砖的浴室。 | 0: 时间<br>1: 衰减<br>2: 干湿比<br>3: 调制<br>4: 音色<br>5: 采样率 | 12 | 152 | 1,145 | 8,258 |
| `blackhole` | 巨大的空间，衰减长达数十秒。 | 0: 衰减<br>1: 阻尼<br>2: 干湿比 | 12 | 140 | 883 | 40,882 |
| `bloom` | 每个音符之后混响缓缓增长，如同花朵绽放。 | 0: 衰减<br>1: 阻尼<br>2: 干湿比<br>3: 绽放时间 | 12 | 84 | 637 | 23,520 |
| `chorale` | plate 的尾音唱出一个元音，从「a」到「i」。 | 0: 衰减<br>1: 阻尼<br>2: 干湿比<br>3: 元音 | 12 | 160 | 1,192 | 37,439 |
| `cloud` | 带随机调制的长扩散器：起音逐渐消散。 | 0: 衰减<br>1: 阻尼<br>2: 干湿比<br>3: 调制 | 12 | 96 | 907 | 42,814 |
| `dinamica` | 尾音随弹奏力度变化的 plate。 | 0: 衰减<br>1: 阻尼<br>2: 干湿比<br>3: 深度<br>4: 阈值<br>5: 速度 | 12 | 141 | 1,188 | 37,439 |
| `ensemble` | plate 之前的三声部合唱：尾音听起来像弦乐组。 | 0: 衰减<br>1: 阻尼<br>2: 干湿比<br>3: 合奏 | 12 | 99 | 953 | 38,540 |
| `freeze` | 用脚踏开关冻结尾音的 plate；尾音仍在动。 | 0: 衰减<br>1: 阻尼<br>2: 干湿比 | 12 | 112 | 979 | 37,439 |
| `freeze_givens` | 不损失能量而流动的冻结：被冻结的尾音在两条支路间旋转。 | 0: 衰减<br>1: 阻尼<br>2: 干湿比<br>3: 旋转 | 12 | 136 | 1,138 | 37,439 |
| `gated` | 每次起音之后突然截止的混响，如 80 年代。 | 0: 衰减<br>1: 阻尼<br>2: 干湿比<br>3: 时长 | 12 | 133 | 1,098 | 37,439 |
| `hall` | 带 Householder 矩阵的 8 路延迟网络：大厅。 | 0: 衰减<br>1: 阻尼<br>2: 干湿比 | 12 | 137 | 863 | 34,522 |
| `infinite` | 不衰减的 plate：每个音符都叠加到一层永不消失的声音上。 | 0: 释放<br>1: 阻尼<br>2: 干湿比 | 12 | 95 | 872 | 37,439 |
| `marea` | plate 的尾音如波浪般起伏，左右交替；干声不变。 | 0: 衰减<br>1: 阻尼<br>2: 干湿比<br>3: 速度 | 12 | 137 | 1,126 | 37,439 |
| `plate` | 带调制混响罐的 Dattorro plate。 | 0: 衰减<br>1: 阻尼<br>2: 干湿比 | 12 | 86 | 790 | 37,439 |
| `plate_vivo` | 调制随机漂移的 plate：尾音从不重复。 | 0: 衰减<br>1: 阻尼<br>2: 干湿比<br>3: 生动度 | 12 | 127 | 1,054 | 37,439 |
| `resonador` | 四根调成 E 大调的弦，随演奏共鸣振动。 | 0: 延音<br>1: 激励<br>2: 干湿比<br>3: 调音 | 12 | 89 | 525 | 1 |
| `reverb_inversa` | 反向混响：每次起音之后，尾音渐强并突然截止。 | 0: 衰减<br>1: 阻尼<br>2: 干湿比<br>3: 时长 | 12 | 133 | 1,098 | 37,439 |
| `semilla` | 早期反射由种子生成的云状混响：每个种子都是一个不同的房间。 | 0: 衰减<br>1: 阻尼<br>2: 干湿比<br>3: 种子<br>4: 密度<br>5: 调制 | 12 | 196 | 1,513 | 42,934 |
| `shimmer` | 反馈中带 +12 的 plate：每一轮升高一个八度。 | 0: 衰减<br>1: 阻尼<br>2: 干湿比<br>3: shimmer 量 | 12 | 108 | 1,037 | 41,539 |
| `shimmer_energia` | 自我调节的 shimmer：积累的八度越多，加入的越少。 | 0: 衰减<br>1: 阻尼<br>2: 干湿比<br>3: shimmer 量 | 12 | 117 | 1,095 | 41,539 |
| `shimmer_escondido` | 隐藏的 shimmer：演奏时八度保持安静，在尾音中浮现。 | 0: 衰减<br>1: 阻尼<br>2: 干湿比<br>3: shimmer 量<br>4: 闪避<br>5: 音色 | 12 | 139 | 1,239 | 41,539 |
| `shimmer_grave` | 向下的 shimmer：每一轮降低一个八度，尾音变成低沉的管风琴。 | 0: 衰减<br>1: 阻尼<br>2: 干湿比<br>3: shimmer 量 | 12 | 108 | 1,037 | 41,539 |
| `shimmer_quinta` | 五度 shimmer：每一轮升高 7 个半音，如同展开的和弦。 | 0: 衰减<br>1: 阻尼<br>2: 干湿比<br>3: shimmer 量 | 12 | 108 | 1,037 | 41,539 |
| `shoegaze` | 尾音之后再过载的 plate：吉他身后一堵温暖的噪声之墙。 | 0: 衰减<br>1: 阻尼<br>2: 干湿比<br>3: 饱和 | 12 | 142 | 1,106 | 37,439 |
| `sostenido` | 自动冻结：每个新和弦都被捕捉，并作为铺底持续发声。 | 0: 层叠<br>1: 阻尼<br>2: 干湿比<br>3: 捕捉 | 12 | 141 | 1,190 | 37,439 |
| `spring` | 弹簧混响：声音如水滴，高音先于低音到达。 | 0: 衰减<br>1: 阻尼<br>2: 干湿比 | 12 | 95 | 832 | 1,850 |

## 延迟

| 程序 | 作用 | 旋钮 | 预设 | 指令数 | 周期 | 存储器 |
|---|---|---|---|---|---|---|
| `aureo` | 十四个按斐波那契数列排布的回声，左右交替，逐渐变密，成为噼啪作响的混响。 | 0: 斜率<br>1: 反馈<br>2: 干湿比<br>3: 音色<br>4: 宽度<br>5: 扩散 | 12 | 141 | 1,096 | 42,259 |
| `bbd` | 暗色的模拟回声：每次重复都会损失高音并产生饱和。 | 0: 时间<br>1: 反馈<br>2: 干湿比<br>3: 调制 | 12 | 44 | 408 | 14,674 |
| `bruma` | 四磁头回声，每一轮都更模糊，直到变成混响。 | 0: 扩散<br>1: 反馈<br>2: 干湿比<br>3: 磁头 | 12 | 53 | 536 | 41,553 |
| `cinta` | 0.18 至 0.85 秒的磁带回声，带 wow、flutter 和饱和。 | 0: 时间<br>1: 反馈<br>2: 干湿比<br>3: wow 与 flutter | 12 | 50 | 484 | 41,600 |
| `compas` | 带拍速踏板和五种音符时值的回声：四分、附点八分、八分、三连音和十六分。 | 0: 时间<br>1: 反馈<br>2: 干湿比<br>3: 细分<br>4: 第二抽头<br>5: 音色 | 12 | 135 | 885 | 32,769 |
| `dados` | 四个回声，时间和八度随机；sw 重新掷骰子。 | 0: 时间<br>1: 反馈<br>2: 干湿比<br>3: 概率<br>4: 音色<br>5: 宽度 | 12 | 239 | 1,620 | 38,260 |
| `delay` | 20 至 690 毫秒的干净数字回声，反馈中可调音色。 | 0: 时间<br>1: 反馈<br>2: 干湿比<br>3: 音色 | 12 | 38 | 309 | 33,749 |
| `deriva` | 迷失方向的回声：延时随机跳变，并以滑音到达新值。 | 0: 时间<br>1: 深度<br>2: 干湿比<br>3: 速度<br>4: 滑音<br>5: 反馈 | 12 | 128 | 969 | 33,796 |
| `dos_ecos` | 两个节奏回声，一个干净，一个磁带味，彼此交叉，最后化为弥散的云。 | 0: 时间<br>1: 反馈<br>2: 干湿比<br>3: 比例<br>4: 平衡<br>5: 扩散 | 12 | 142 | 1,131 | 41,258 |
| `ducking` | 演奏时回声退后，停顿时回声出现。 | 0: 时间<br>1: 反馈<br>2: 干湿比<br>3: 闪避 | 12 | 51 | 394 | 33,749 |
| `eco_casero` | 自制芯片回声：短延时干净；延时越长越暗、越粗糙，并带有泵动感。 | 0: 时间<br>1: 反馈<br>2: 干湿比<br>3: 脏污<br>4: 调制<br>5: 音色 | 12 | 124 | 1,002 | 41,492 |
| `enjambre` | 由八个短回声组成的蜂群：可聚成混响，也可散成独立回声。 | 0: 离散度<br>1: 反馈<br>2: 干湿比<br>3: 扩散<br>4: 音色<br>5: 漂移 | 12 | 199 | 1,377 | 42,820 |
| `estelar` | 反馈环内带移相器的回声：每次重复扫得更深，尾音化作旋涡。 | 0: 时间<br>1: 反馈<br>2: 干湿比<br>3: 深度<br>4: 速度<br>5: 谐振 | 12 | 123 | 830 | 33,749 |
| `frenada` | 带刹车的磁带回声：踩下踏板，磁带停下，回声的音高一路降到无声。 | 0: 时间<br>1: 反馈<br>2: 干湿比<br>3: 制动时间<br>4: 启动时间<br>5: wow 与 flutter | 12 | 156 | 1,199 | 32,876 |
| `lata` | 油罐回声：短促、浑浊、如液体般流动，颤音随延迟时间变化。 | 0: 时间<br>1: 反馈<br>2: 干湿比<br>3: 深度<br>4: 音色<br>5: 油 | 12 | 90 | 768 | 18,931 |
| `lluvia` | 六个不规则的回声在全通滤波器中消散：一场音符之雨。 | 0: 扩散<br>1: 反馈<br>2: 干湿比 | 12 | 46 | 364 | 35,385 |
| `oscilador` | 自激振荡的回声，电平有上限；时间调节音高。 | 0: 时间<br>1: 反馈<br>2: 干湿比<br>3: 平滑<br>4: 音色<br>5: 电平 | 12 | 86 | 614 | 24,678 |
| `pingpong` | 在左右两侧来回跳动的立体声回声。 | 0: 时间<br>1: 反馈<br>2: 干湿比 | 12 | 38 | 353 | 40,874 |
| `probabilidad` | 八个回声按概率发声或静默：时短如多变的混响，时长如永不重复的节奏型。 | 0: 时间<br>1: 概率<br>2: 干湿比<br>3: 反馈<br>4: 音色<br>5: 平滑 | 12 | 220 | 1,450 | 34,456 |
| `reverse` | 以 0.17 秒为颗粒的反向回声。 | 0: 音色<br>1: 反馈<br>2: 干湿比 | 12 | 34 | 301 | 16,388 |
| `tambor` | 四磁头磁鼓回声：节奏来自打开的磁头组合。 | 0: 速度<br>1: 反馈<br>2: 干湿比<br>3: 磁头<br>4: 老化<br>5: 音色 | 12 | 173 | 1,328 | 37,656 |

## 调制

| 程序 | 作用 | 旋钮 | 预设 | 指令数 | 周期 | 存储器 |
|---|---|---|---|---|---|---|
| `armonico` | 低音与高音反相起伏；配合 pot2，后面加一层回声。 | 0: 速度<br>1: 深度<br>2: 回声<br>3: 频率<br>4: 波形<br>5: 宽度 | 12 | 125 | 847 | 17,101 |
| `chorus` | 三个声部，延迟时间不断变化。 | 0: 速度<br>1: 深度<br>2: 干湿比 | 12 | 42 | 416 | 1,101 |
| `desplazador` | 每次回授都移动频率的回声：尾音螺旋般上升或下降。 | 0: 移频<br>1: 时间<br>2: 干湿比<br>3: 反馈<br>4: 音色<br>5: 宽度 | 12 | 110 | 864 | 33,767 |
| `dimension` | 一种合唱效果：拓宽立体声并增加厚度，但音高不会起伏。 | 0: 模式<br>1: 速度<br>2: 干湿比<br>3: 深度<br>4: 交叉混合<br>5: 音色 | 12 | 94 | 795 | 505 |
| `flanger` | 带反馈的极短可变延迟：扫动的梳状滤波。 | 0: 速度<br>1: 深度<br>2: 干湿比<br>3: 反馈 | 12 | 31 | 266 | 247 |
| `orilla` | 缓慢的随机合唱，配有随每个音符关闭的低通门。 | 0: 速度<br>1: 深度<br>2: 干湿比<br>3: 平滑<br>4: 低通门<br>5: 灵敏度 | 12 | 147 | 1,078 | 736 |
| `phaser` | 四个系数可变的全通滤波器：扫动的陷波。 | 0: 速度<br>1: 深度<br>2: 干湿比<br>3: 反馈 | 12 | 80 | 521 | 1 |
| `slicer` | 将声音切成有节奏的脉冲，如同开合的门。 | 0: 速度<br>1: 深度<br>2: 占空比<br>3: 平滑 | 12 | 37 | 262 | 1 |
| `tremolo` | 音量起伏变化；配合 pot2，可在左右之间移动。 | 0: 速度<br>1: 深度<br>2: 声像 | 12 | 43 | 325 | 1 |
| `vibe` | 灯泡式 Vibe：四级不等的相移，扫动上升快、下降慢。 | 0: 速度<br>1: 深度<br>2: 干湿比<br>3: 反馈<br>4: 波形<br>5: 音色 | 12 | 125 | 830 | 1 |
| `vibrato` | 音高上下起伏。 | 0: 速度<br>1: 深度<br>2: 干湿比 | 12 | 27 | 240 | 125 |

## 音高

| 程序 | 作用 | 旋钮 | 预设 | 指令数 | 周期 | 存储器 |
|---|---|---|---|---|---|---|
| `acople` | 持续的音符上方会慢慢长出一个饱和的泛音，就像音箱的回授。 | 0: 时间<br>1: 音程<br>2: 干湿比<br>3: 上升时间<br>4: 音色<br>5: 电平 | 12 | 138 | 1,038 | 3,550 |
| `arcoiris` | 两个移调声部置于再生回路中，可受控自激振荡。 | 0: 音程<br>1: 第二声部<br>2: 干湿比<br>3: 时间<br>4: 反馈<br>5: 音色 | 12 | 76 | 693 | 12,345 |
| `armonizador` | 一个声部，音程为 −12、−7、−5、+5、+7 或 +12 个半音，带反馈。 | 0: 音程<br>1: 反馈<br>2: 干湿比 | 12 | 55 | 450 | 4,100 |
| `arpegio` | 每个音都展开成移调的琶音（1-3-5-8），落入混响之中。 | 0: 速度<br>1: 音数<br>2: 干湿比<br>3: 模式<br>4: 回声<br>5: 衰减 | 12 | 163 | 1,259 | 42,851 |
| `doblador` | 两个略微失谐（几个音分）的声部，左右各一：使声音更宽。 | 0: 失谐<br>2: 干湿比 | 12 | 32 | 346 | 1,028 |
| `escalera` | 每次重复都升高或降低一个音程的回声：一段阶梯。 | 0: 音程<br>1: 反馈<br>2: 干湿比<br>3: 时间 | 12 | 67 | 582 | 39,313 |
| `espiral` | 尾音以螺旋方式升高或降低音高的混响，左右各有一个音程。 | 0: 音程<br>1: 第二声部<br>2: 干湿比<br>3: 时间<br>4: 反馈<br>5: 衰减 | 12 | 171 | 1,455 | 42,878 |
| `octava` | 八度效果器：低八度与高八度，各有独立音量。 | 0: 低八度<br>1: 高八度<br>2: 干声 | 12 | 25 | 296 | 4,100 |

## 动态

| 程序 | 作用 | 旋钮 | 预设 | 指令数 | 周期 | 存储器 |
|---|---|---|---|---|---|---|
| `arco` | 琴弓式延音：音符渐入，保持恒定音量，并可过渡到高八度。 | 0: 延音<br>1: 上升时间<br>2: 干湿比<br>3: 高八度<br>4: 音色<br>5: 阈值 | 12 | 122 | 897 | 2,052 |
| `compresor` | 压缩器：压低响亮部分，保留轻柔部分，并延长音符。 | 0: 阈值<br>1: 压缩<br>2: 干湿比<br>3: 增益 | 12 | 57 | 394 | 1 |
| `puerta` | 噪声门：消除音符之间的嗡声，放行演奏的声音。 | 0: 阈值<br>1: 释放 | 12 | 29 | 222 | 1 |
| `swell` | 每个音符从静音开始渐强，然后进入 plate。 | 0: 衰减<br>1: 阻尼<br>2: 干湿比<br>3: 上升时间 | 12 | 116 | 983 | 37,439 |
| `swell_ritmico` | 每个音符按你选定的曲线和时间渐强，也可用脚踩出节拍来定时，混响 plate 随之起伏。 | 0: 上升时间<br>1: 波形<br>2: 干湿比<br>3: 衰减<br>4: 漂移<br>5: 灵敏度 | 12 | 216 | 1,611 | 37,439 |
| `violin` | 每个音符都没有拨片的起音，像用琴弓拉奏，颤音随后才出现。 | 0: 上升时间<br>1: 时间<br>2: 干湿比<br>3: 深度<br>4: 速度<br>5: 音色 | 12 | 118 | 845 | 85 |

## 质感

| 程序 | 作用 | 旋钮 | 预设 | 指令数 | 周期 | 存储器 |
|---|---|---|---|---|---|---|
| `granular` | 4 声部颗粒云，Hann 窗、八度音高和冻结。 | 0: 时长<br>1: 扩散<br>2: 音程<br>3: 干湿比 | 12 | 188 | 1,209 | 32,769 |
| `lofi` | 更少的每秒样本数和更少的位数，带混叠。 | 0: 采样率<br>1: 位数<br>2: 干湿比<br>3: 音色 | 12 | 81 | 577 | 1 |
| `ringmod` | 环形调制器：将吉他与正弦波相乘，声音带金属感。 | 0: 频率<br>2: 干湿比 | 12 | 33 | 236 | 1 |
| `saturacion` | 过载式饱和：从温暖的光泽到厚重的失真。 | 0: 增益<br>1: 音色<br>2: 干湿比<br>3: 电平 | 12 | 42 | 277 | 1 |
| `viento` | 随机呼啸的滤波噪声阵风，弹奏时吹得更猛。 | 0: 速度<br>1: 谐振<br>2: 干湿比<br>3: 灵敏度<br>4: 频率<br>5: 电平 | 12 | 140 | 913 | 3,728 |

## 滤波

| 程序 | 作用 | 旋钮 | 预设 | 指令数 | 周期 | 存储器 |
|---|---|---|---|---|---|---|
| `ancho` | 将单声道吉他拓宽为立体声，并在低音与高音之间调节音色。 | 0: 宽度<br>1: 倾斜 | 12 | 26 | 185 | 636 |
| `autowah` | 自动哇音：弹得越用力，滤波器升得越高。 | 0: 灵敏度<br>1: 谐振<br>2: 干湿比 | 12 | 43 | 295 | 1 |
| `filtro` | 由 LFO 驱动、自动升降的谐振低通滤波器。 | 0: 速度<br>1: 谐振<br>2: 干湿比<br>3: 深度 | 12 | 61 | 402 | 1 |

## 循环器

| 程序 | 作用 | 旋钮 | 预设 | 指令数 | 周期 | 存储器 |
|---|---|---|---|---|---|---|
| `erosion` | 每转一圈都会磨损的磁带循环：失去高频和电平，增加 wow、颗粒和饱和。 | 0: 侵蚀<br>1: 阻尼<br>2: 干湿比<br>3: 调制<br>4: 电平<br>5: 时长 | 12 | 161 | 1,043 | 32,769 |
| `looper` | 0.67 秒微型循环器，带叠录、½×、2× 和反向。 | 0: 电平<br>1: 速度<br>2: 方向<br>3: 反馈 | 12 | 87 | 576 | 32,769 |
| `mosaico` | 0.67 秒的声上叠声循环，同时以 ½×、1× 和 2× 播放。 | 0: 低八度<br>1: 电平<br>2: 干湿比<br>3: 高八度<br>4: 反馈<br>5: 扩散 | 12 | 144 | 1,064 | 34,662 |
| `relevo` | 双层冻结：每次踩下都会冻结一个新和弦，并淡入替换旧和弦，带推弦和颤音。 | 0: 时间<br>1: 调音<br>2: 干湿比<br>3: 颤音<br>4: 音色<br>5: 电平 | 12 | 197 | 1,438 | 34,140 |
| `resbalon` | 一个自由读取头在你刚弹过的声音上滑行，从 −2× 到 2×，无需录音。 | 0: 速度<br>1: 反馈<br>2: 干湿比<br>3: 时长<br>4: 音色<br>5: 时间 | 12 | 119 | 865 | 32,769 |
| `tartamudeo` | 每次强烈的拨弦都会捕捉一小段声音并重复播放，一次比一次轻。 | 0: 阈值<br>1: 时长<br>2: 干湿比<br>3: 重复次数<br>4: 速度<br>5: 音色 | 12 | 188 | 1,240 | 32,769 |

## 链

链把两个程序合成一个，串联（→）或并联（‖），不改动 RTL（ADR 0013，西班牙语）。链位于 `presets/cadenas.toml`；用 `sofifi cadena` 处理。今天有 18 条可以装入，6 条等待 SDRAM：它们只缺存储器。

| 链 | 程序 | 周期 | 存储器 | 寄存器 | LFO | 状态 |
|---|---|---|---|---|---|---|
| Armonía en la placa | `armonizador` → `plate` | 1,270 | 41,539 | 14 | 3 | 可装入 |
| Bruma que gira | `bruma` → `chorus` | 950 | 42,654 | 12 | 4 | 可装入 |
| Campanas | `ringmod` → `shimmer` | 1,239 | 41,539 | 18 | 3 | 可装入 |
| Cinta desgastada | `cinta` → `lofi` | 1,085 | 41,600 | 18 | 3 | 可装入 |
| Cuerdas en ola | `tremolo` → `ensemble` | 1,288 | 38,540 | 16 | 4 | 可装入 |
| Doble resonancia | `doblador` → `resonador` | 879 | 1,028 | 24 | 2 | 可装入 |
| Eco oscuro en flor | `bbd` → `bloom` | 1,053 | 38,194 | 20 | 2 | 可装入 |
| Eco y muelle | `delay` → `spring` | 1,149 | 35,599 | 14 | 1 | 可装入 |
| Eco y resonancia | `delay` ‖ `resonador` | 870 | 33,749 | 27 | 1 | 可装入 |
| Flor al revés | `reverse` → `bloom` | 930 | 39,908 | 17 | 1 | 可装入 |
| Fuzz en la nube | `saturacion` → `cloud` | 1,248 | 42,814 | 16 | 4 | 可装入 |
| Loop filtrado | `looper` → `filtro` | 1,018 | 32,769 | 23 | 0 | 可装入 |
| Octavas en flor | `octava` ‖ `bloom` | 953 | 27,620 | 18 | 2 | 可装入 |
| Placa que tiembla | `tremolo` → `plate` | 1,109 | 37,439 | 14 | 2 | 可装入 |
| Shimmer con vibrato | `vibrato` → `shimmer` | 1,243 | 41,664 | 18 | 4 | 可装入 |
| Silencio y agujero negro | `puerta` → `blackhole` | 1,099 | 40,882 | 20 | 2 | 可装入 |
| Sustain en la placa | `compresor` → `plate` | 1,214 | 37,439 | 17 | 2 | 可装入 |
| Órgano infinito | `octava` → `infinite` | 1,246 | 41,539 | 13 | 4 | 可装入 |
| Bruma en flor | `bruma` → `bloom` | 1,181 | 65,073 | 19 | 1 | 等待 SDRAM |
| Cinta en la flor | `cinta` → `bloom` | 1,129 | 65,120 | 20 | 3 | 等待 SDRAM |
| Eco al revés congelado | `reverse` → `freeze` | 1,310 | 53,827 | 15 | 3 | 等待 SDRAM |
| Eco en la nube | `delay` → `plate` | 1,113 | 71,188 | 15 | 3 | 等待 SDRAM |
| Lluvia sobre la placa | `lluvia` → `plate` | 1,148 | 72,824 | 12 | 2 | 等待 SDRAM |
| Ping-pong infinito | `pingpong` → `infinite` | 1,223 | 78,313 | 13 | 3 | 等待 SDRAM |
