cabezoide/sofifi/docs/img/en/porque.png

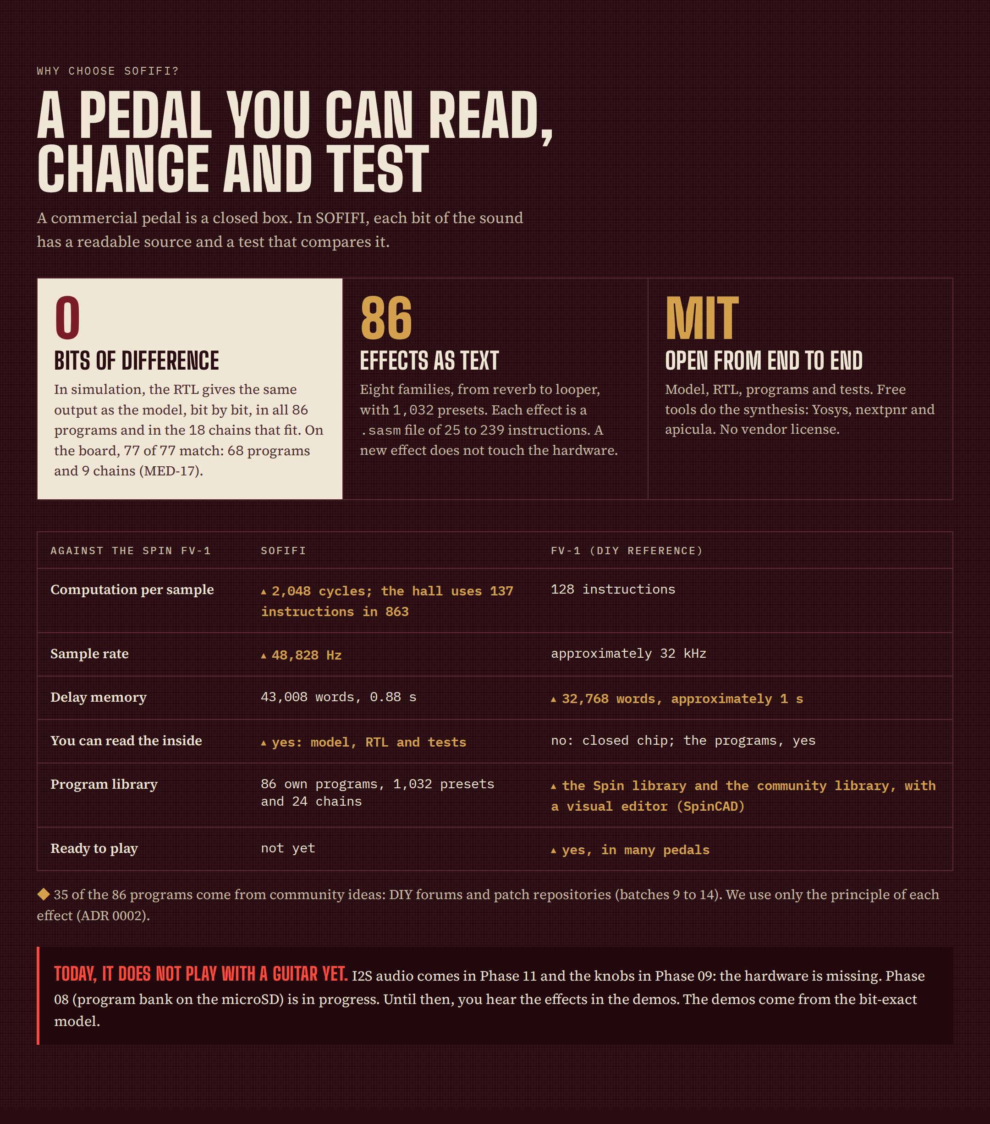
docs/img/en/porque.png
