cabezoide/sofifi/docs/img/en/portada.png

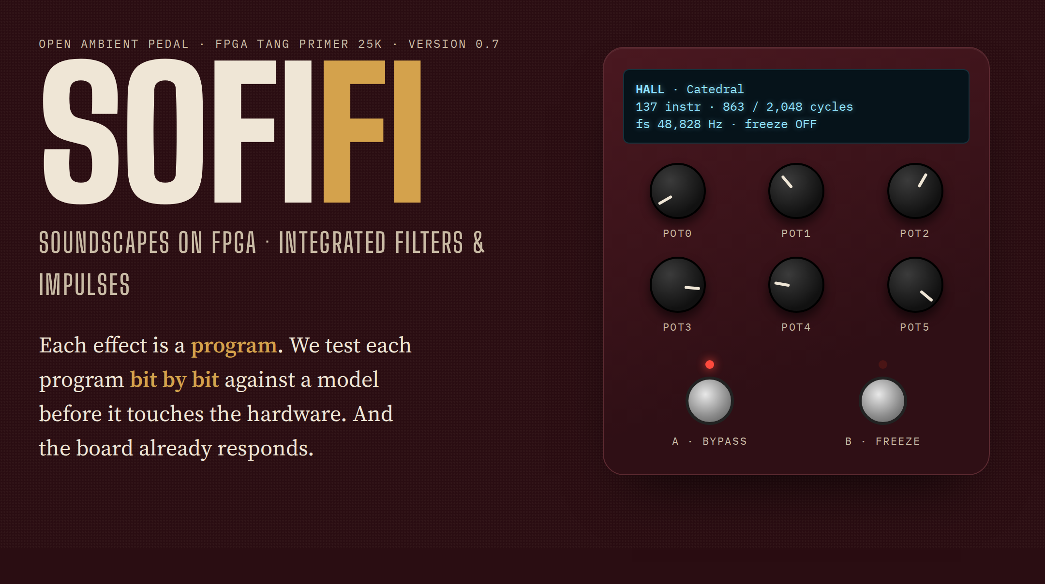
docs/img/en/portada.png
