cabezoide/sofifi/docs/img/ja/porque.png

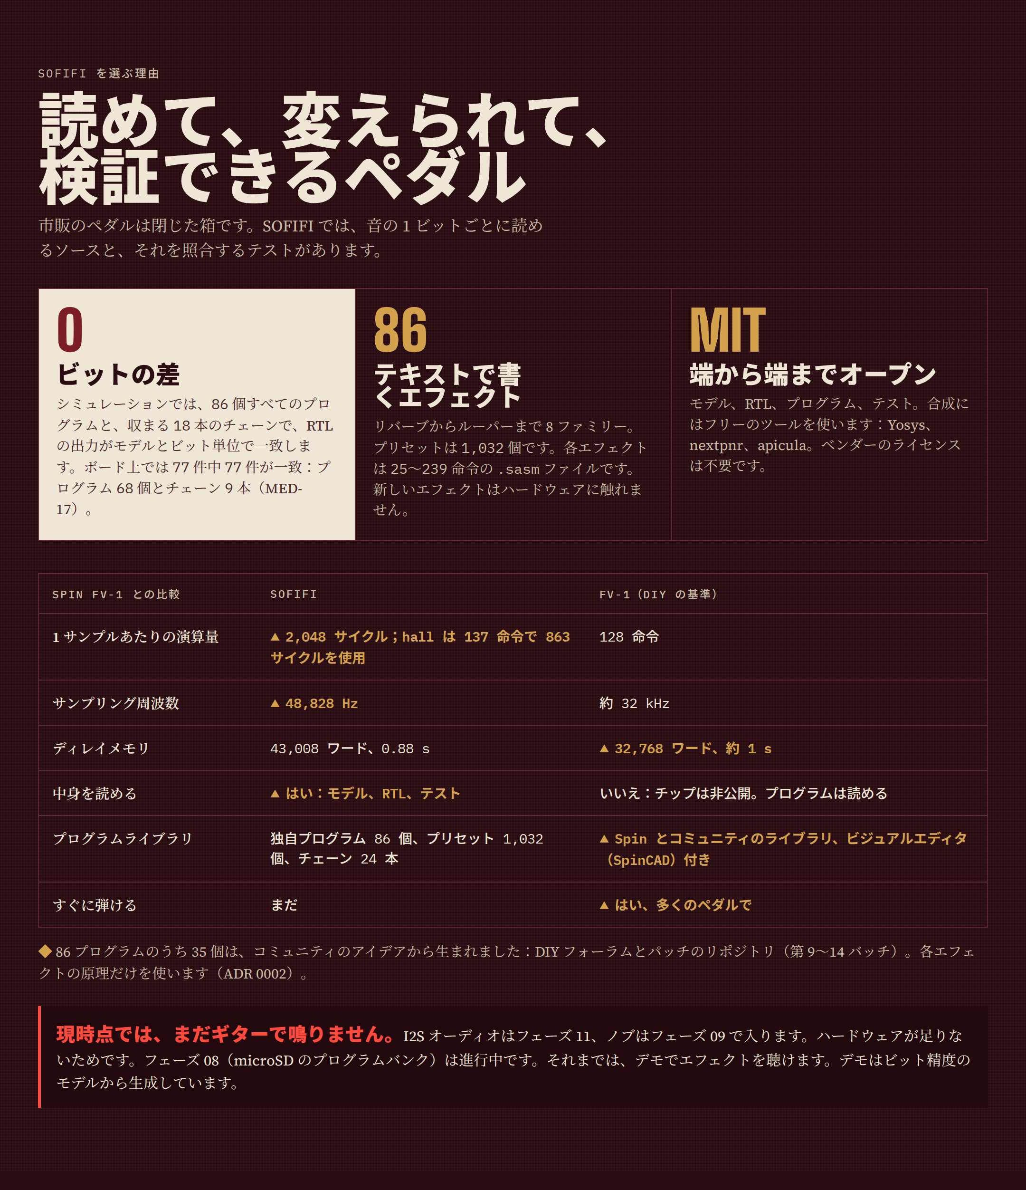
docs/img/ja/porque.png
