cabezoide/sofifi/docs/img/ja/ruta.png

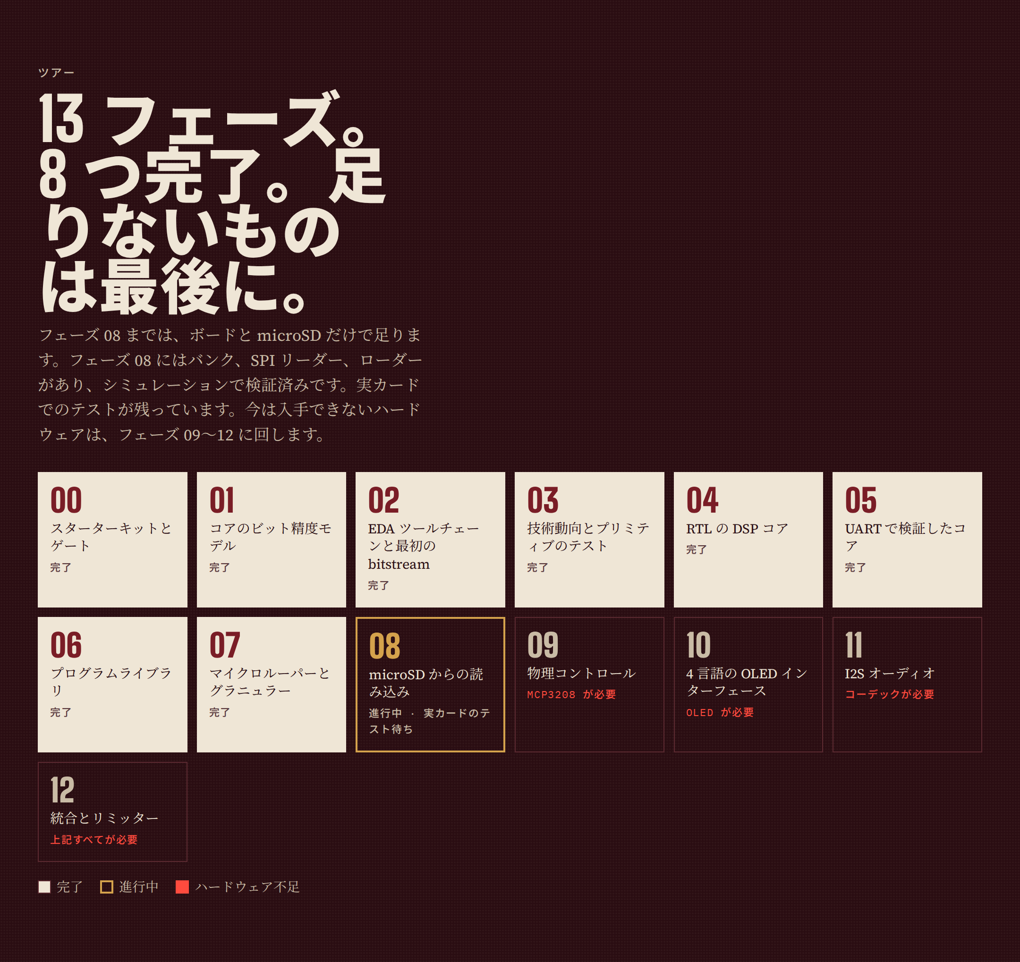
docs/img/ja/ruta.png
