cabezoide/sofifi/docs/img/zh-CN/porque.png

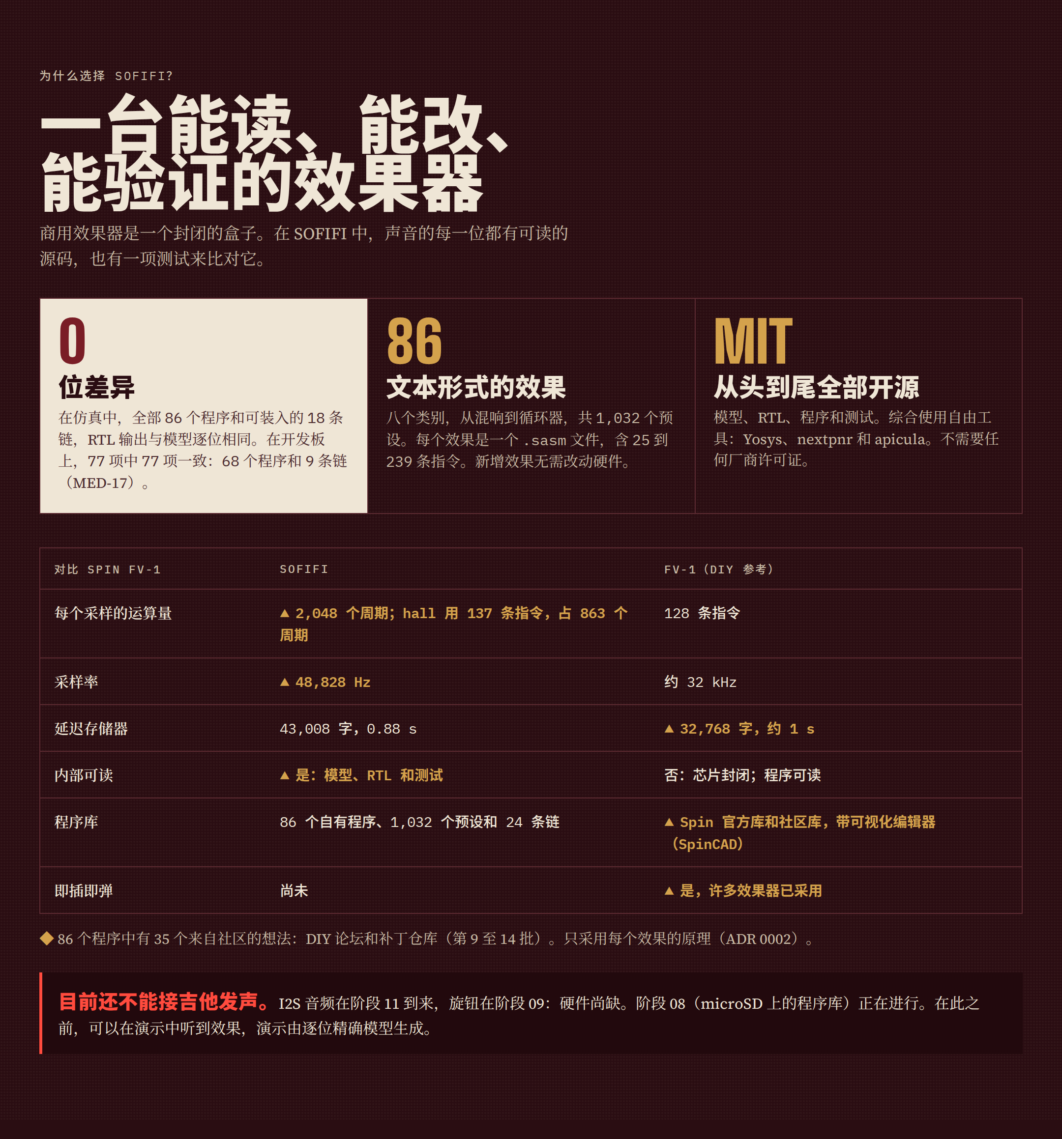
docs/img/zh-CN/porque.png
