cabezoide/sofifi/docs/img/zh-CN/portada.png

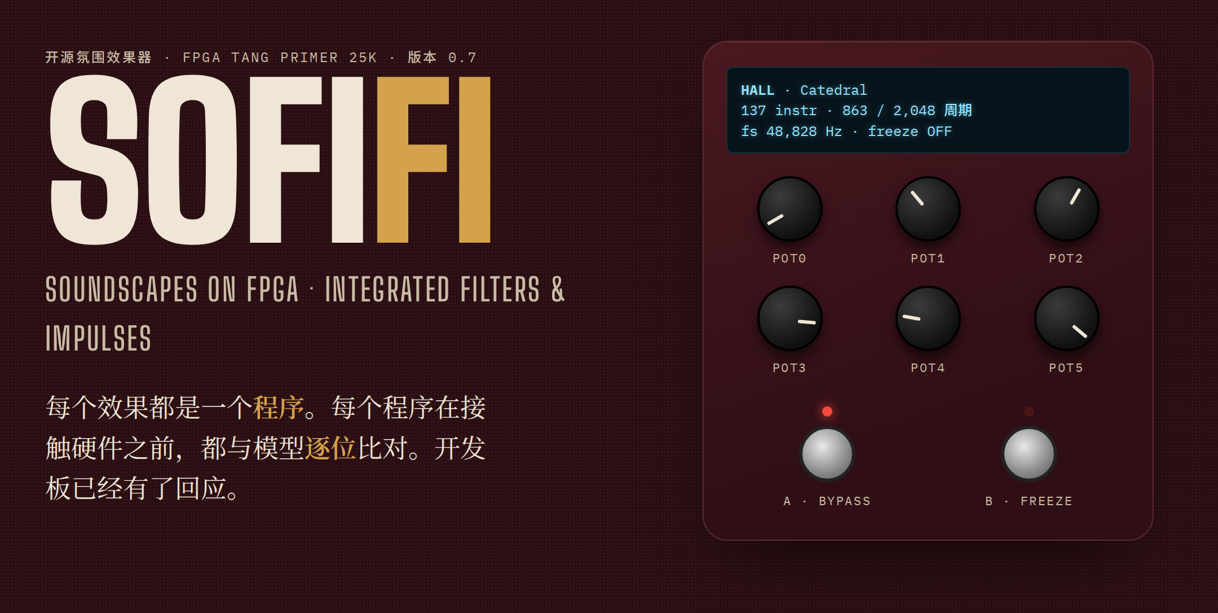
docs/img/zh-CN/portada.png
