cabezoide/sofifi/schematics/top/prueba_sd.pdf

# prueba_sd

### Prueba de la microSD en la placa (Fase 08): arranca la tarjeta del Sipeed PMOD TF en el

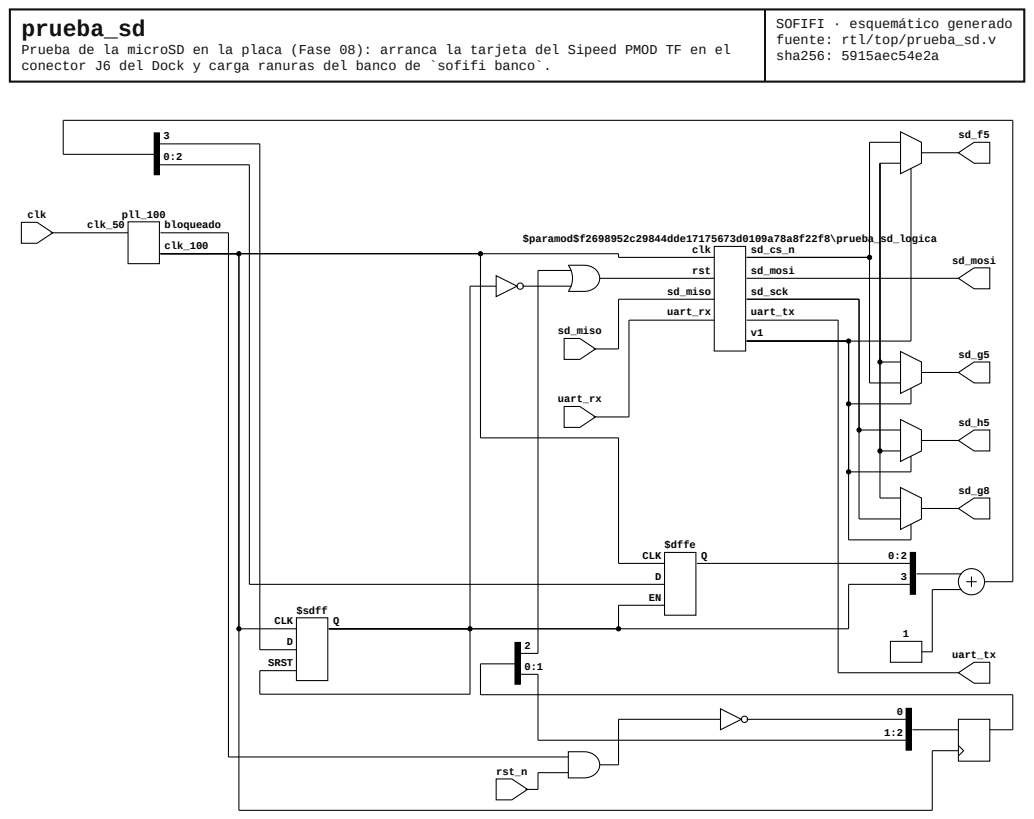
[picture p11: page 1]
$sdff; CLK; SRST; $dffe; $paramod$f2698952c29844dde17175673d0109a78a8f22f8\prueba_sd_logica clk; rst; sd_miso; uart_rx; sd_mosi; sd_sck; uart_tx; pll_100; clk_50; bloqueado; clk_100; clk; rst_n

SOFIFI · esquemático generado
fuente: rtl/top/prueba_sd.v
sha256: 5915aec54e2a

conector J6 del Dock y carga ranuras del banco de `sofifi banco`.
