cabezoide/sofifi/schematics/comun/generador_muestra.pdf

## generador_muestra

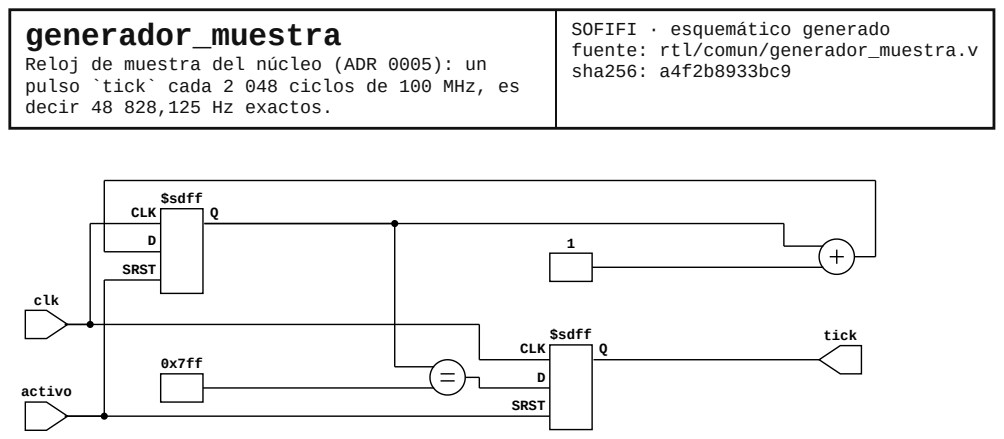
[picture p12: page 1]
$sdff; CLK; SRST; clk; activo; tick

SOFIFI · esquemático generado
fuente: rtl/comun/generador_muestra.v
sha256: a4f2b8933bc9

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
