cabezoide/sofifi/schematics/comun/linea_hex.pdf

# linea_hex

Envía por la UART una línea "<etiqueta> <valor en hexadecimal>\r\n".

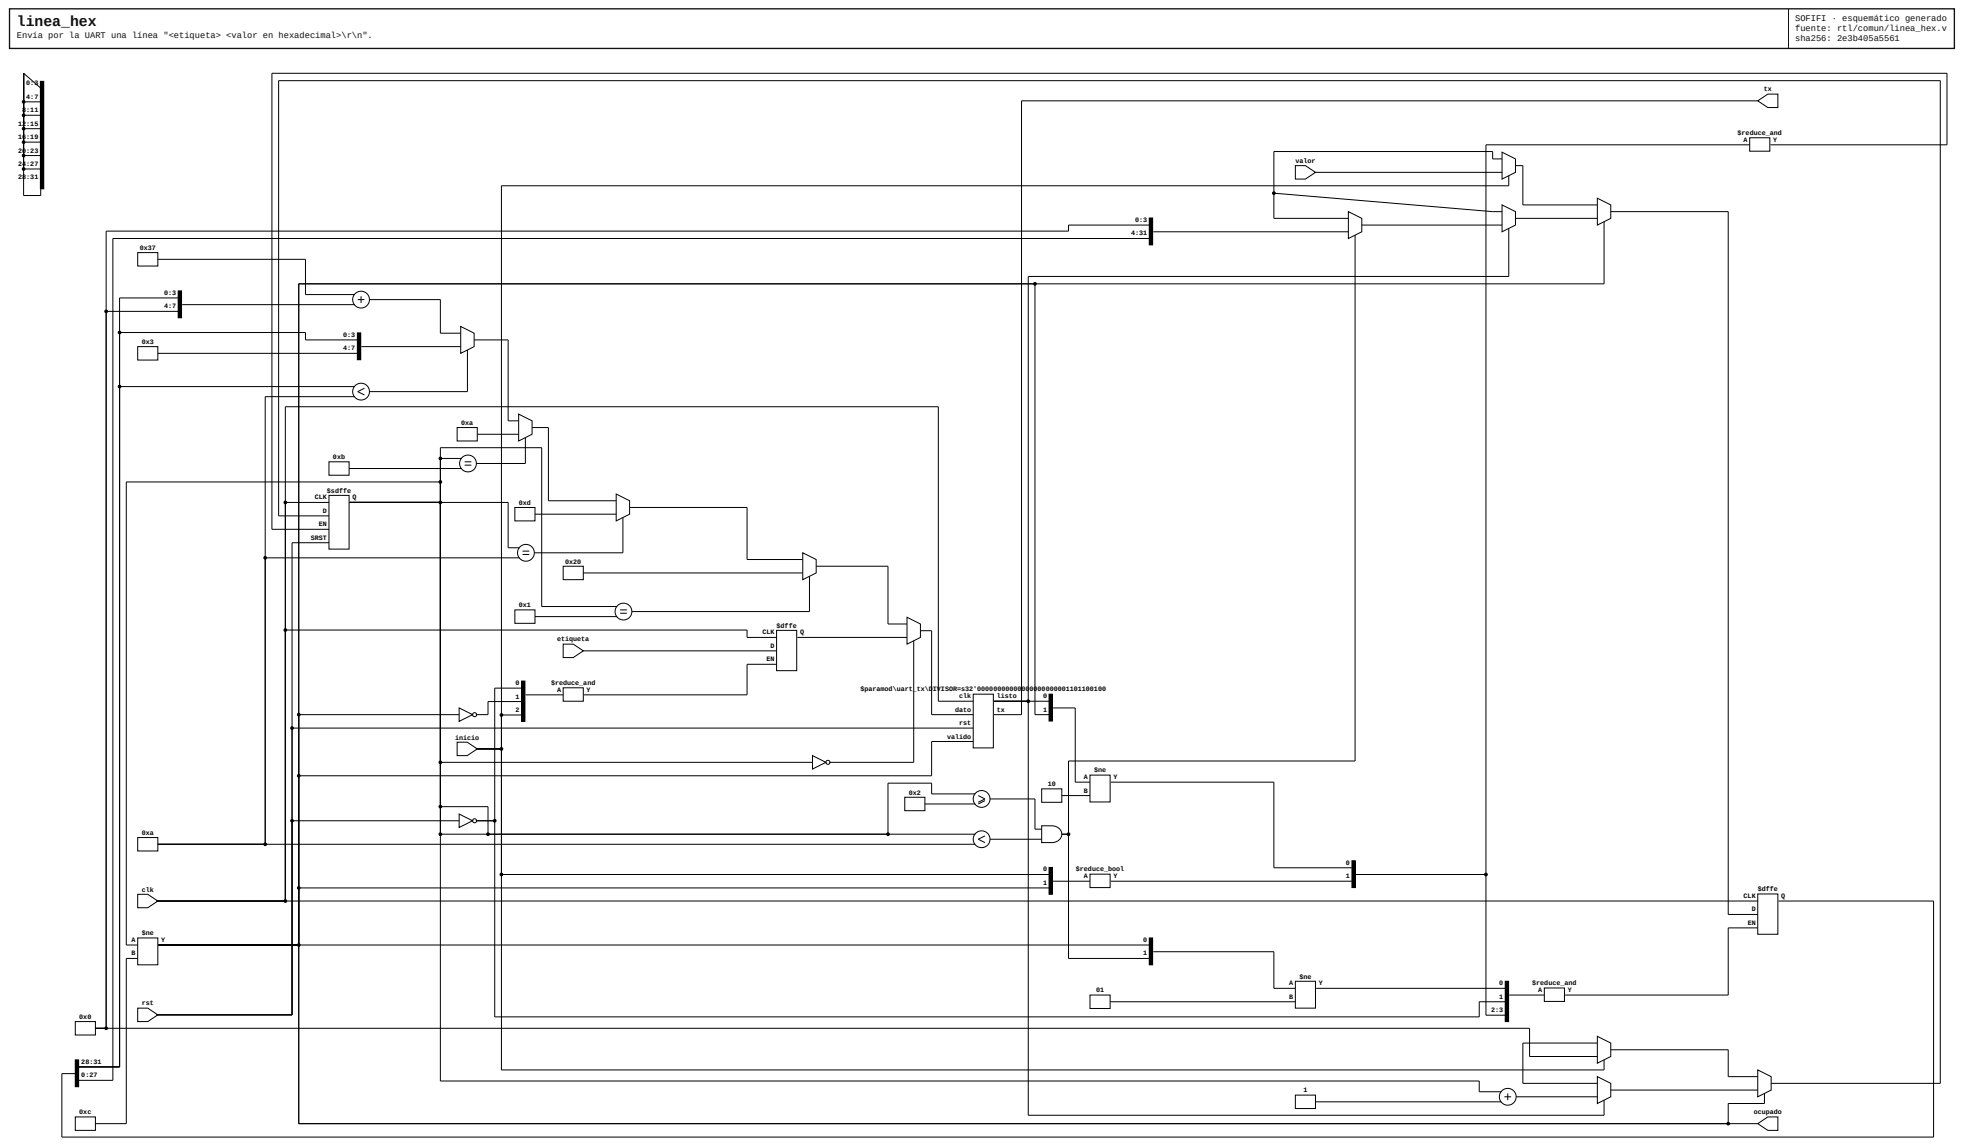
[picture p13: page 1]
$dffe; CLK; $reduce_bool A Y; $reduce_and A Y; $paramod\uart_tx\DIVISOR=s32'00000000000000000000001101100100 clk; dato; rst; valido; listo; clk; inicio; etiqueta; valor; ocupado

SOFIFI · esquemático generado
fuente: rtl/comun/linea_hex.v
sha256: 2e3b405a5561

$sdffe CLK Q D EN SRST
