cabezoide/sofifi/schematics/comun/uart_rx.pdf

# uart_rx

UART de recepción 8N1.

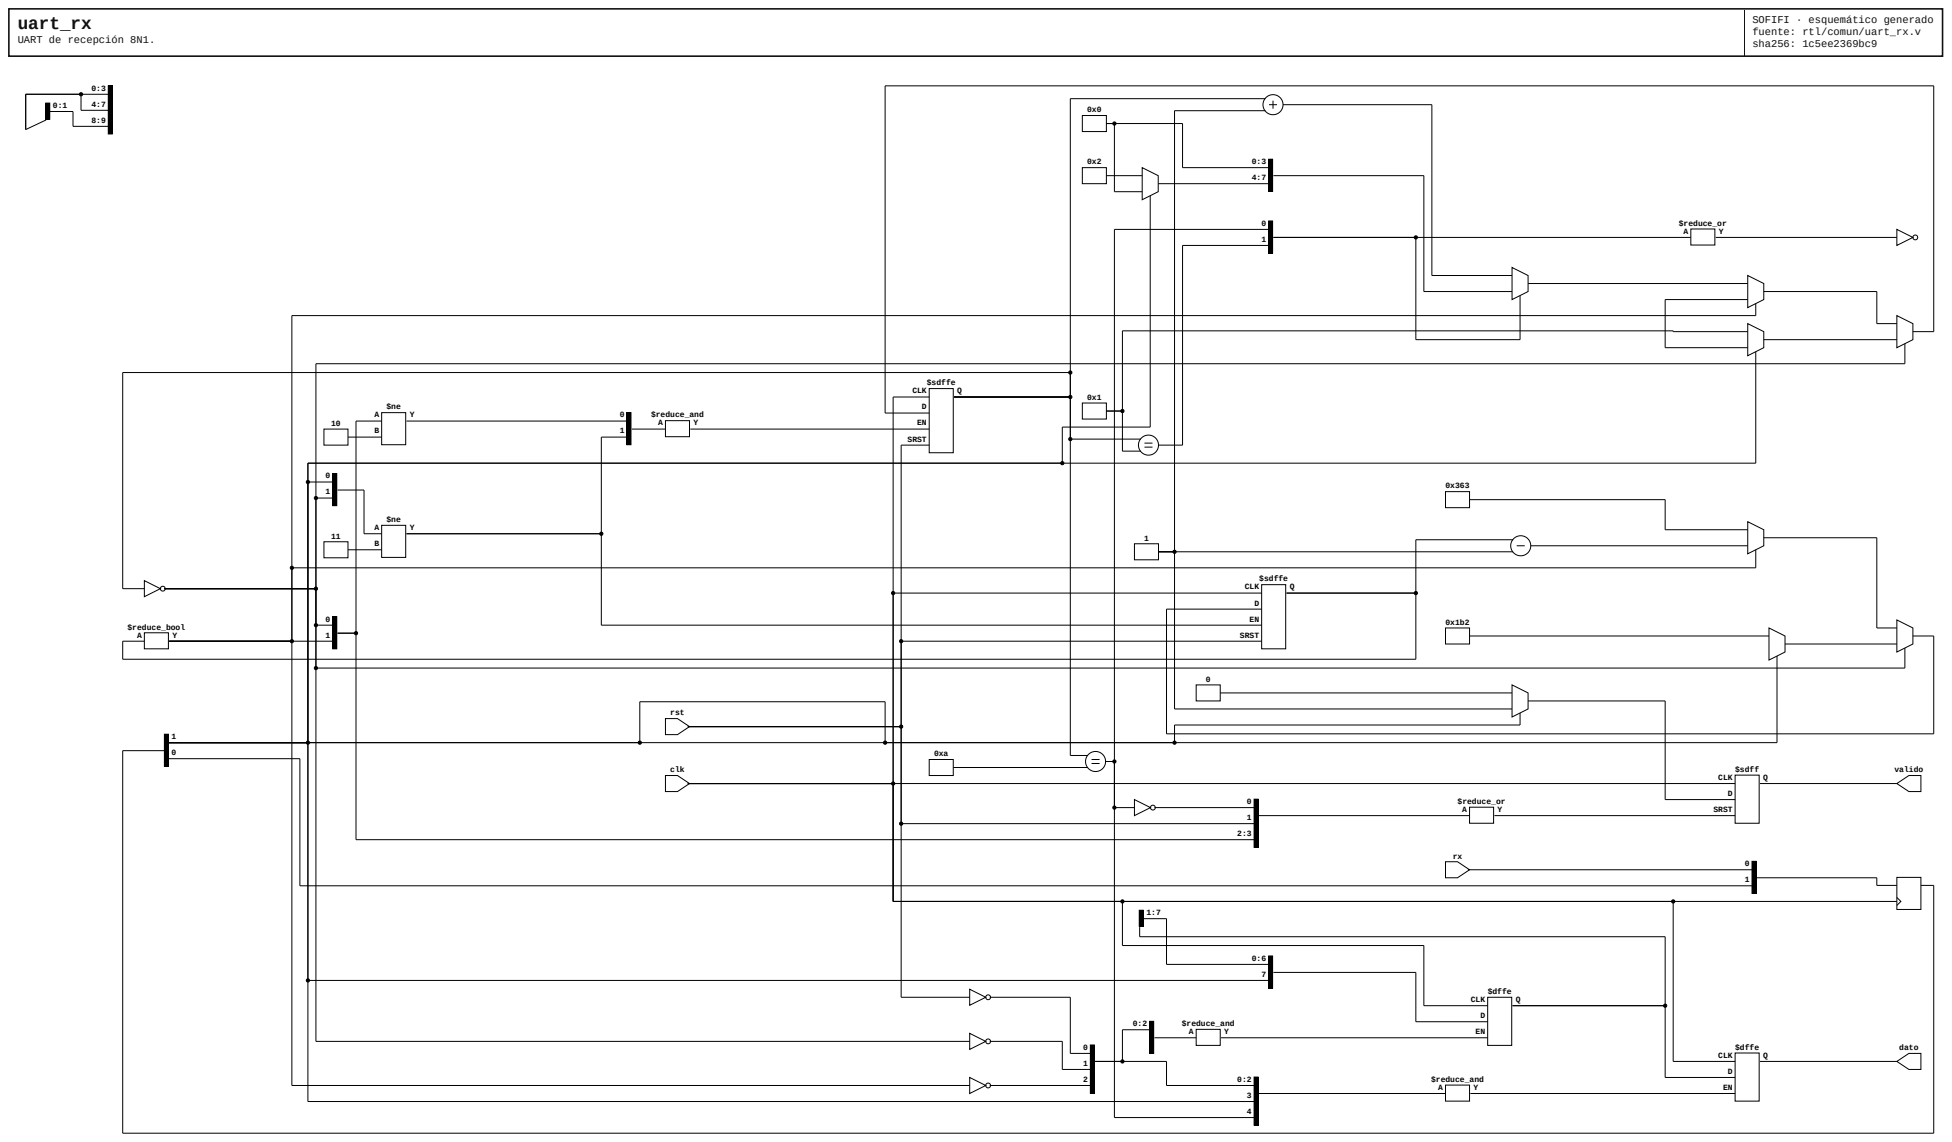
[picture p14: page 1]
$sdffe; CLK; SRST; $dffe; $sdff; $reduce_or A Y; Y $reduce_and A Y; $reduce_and A Y; $reduce_bool A Y; clk; rst; dato; valido

SOFIFI · esquemático generado
fuente: rtl/comun/uart_rx.v
sha256: 1c5ee2369bc9

0 1 | | $sdffe CLK Q D EN SRST
