cabezoide/sofifi/schematics/comun/uart_tx.pdf

# uart_tx

UART de transmisión 8N1.

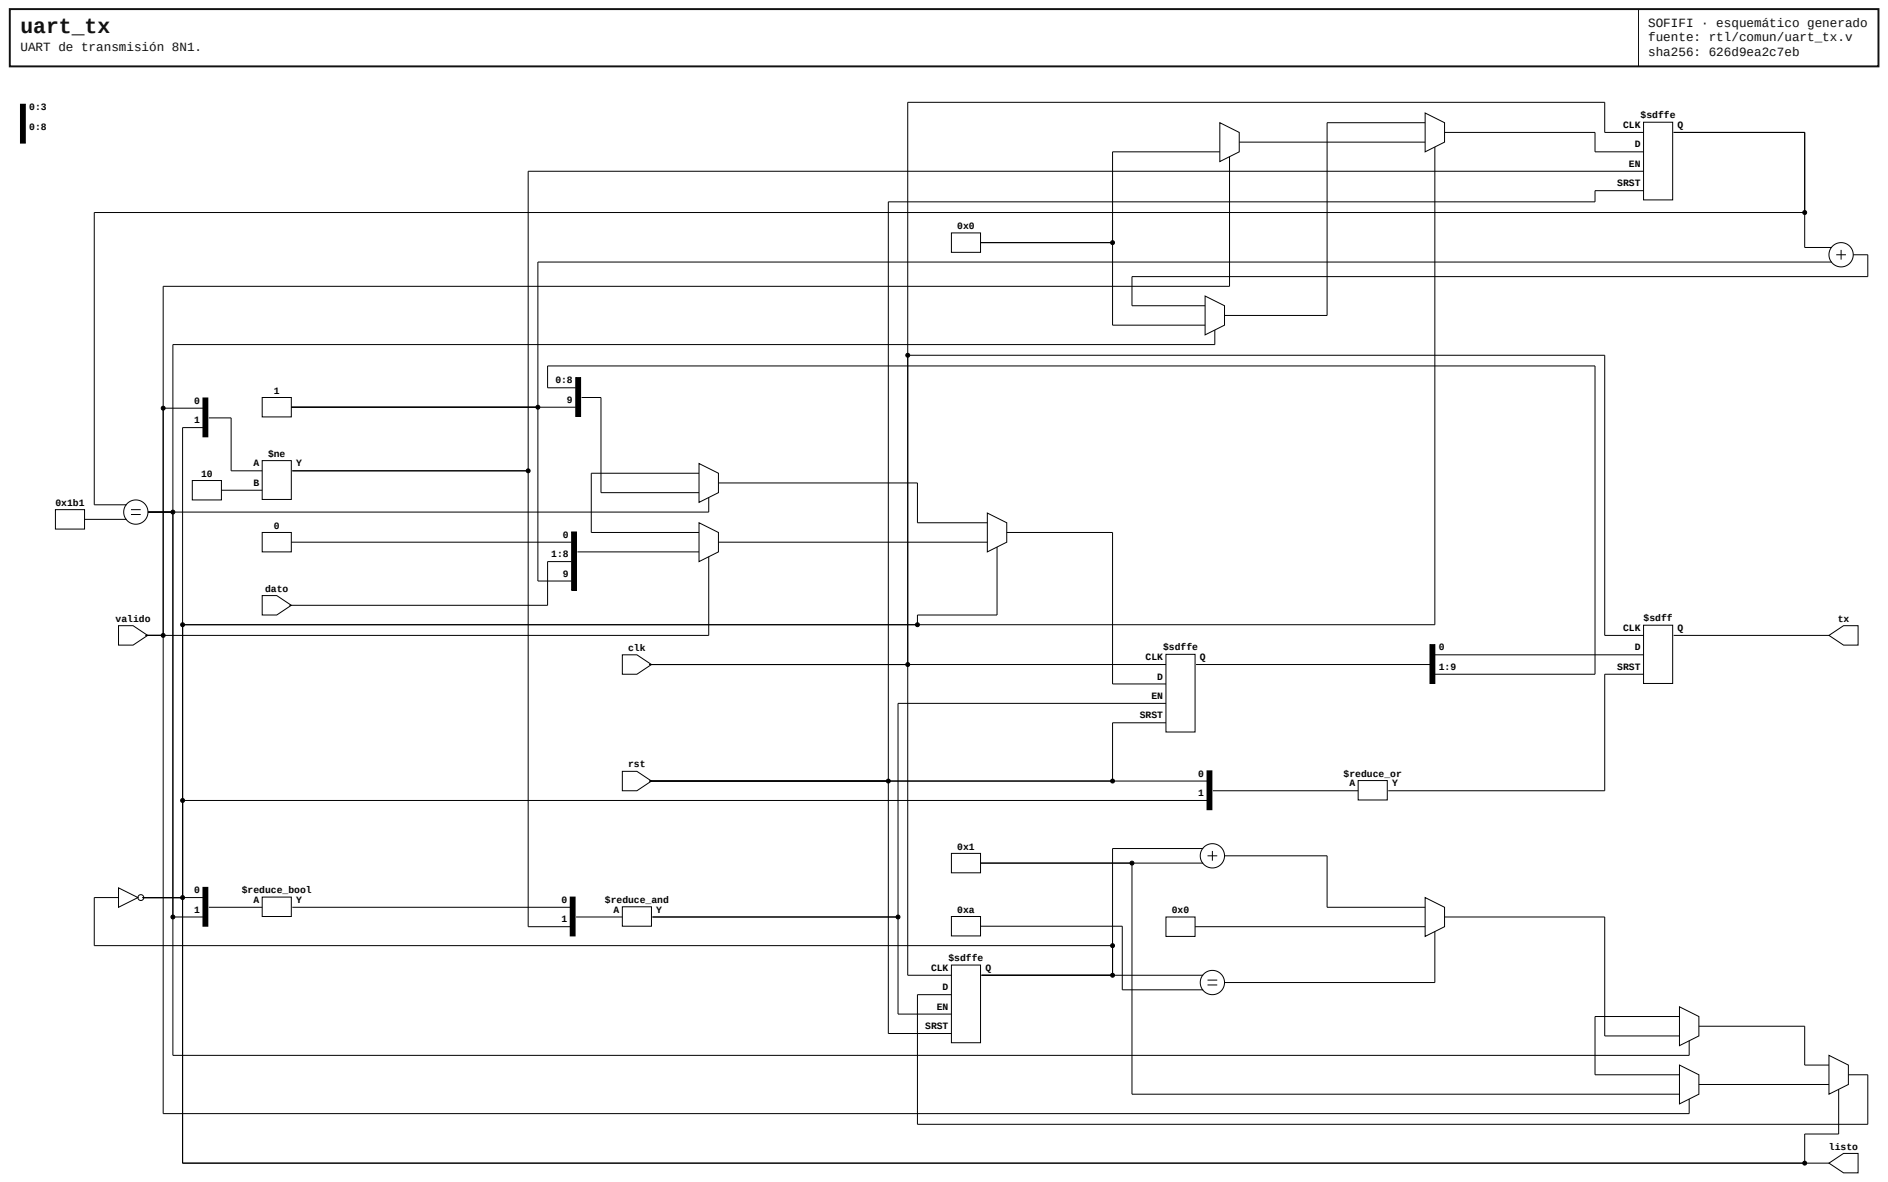
[picture p15: page 1]
$sdffe; CLK; SRST; $sdff; $reduce_bool; $reduce_and; $reduce_or A Y; clk; rst; dato; valido; listo

SOFIFI · esquemático generado
fuente: rtl/comun/uart_tx.v
sha256: 626d9ea2c7eb
