cabezoide/sofifi/schematics/top/hola_uart.pdf

# hola_uart

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

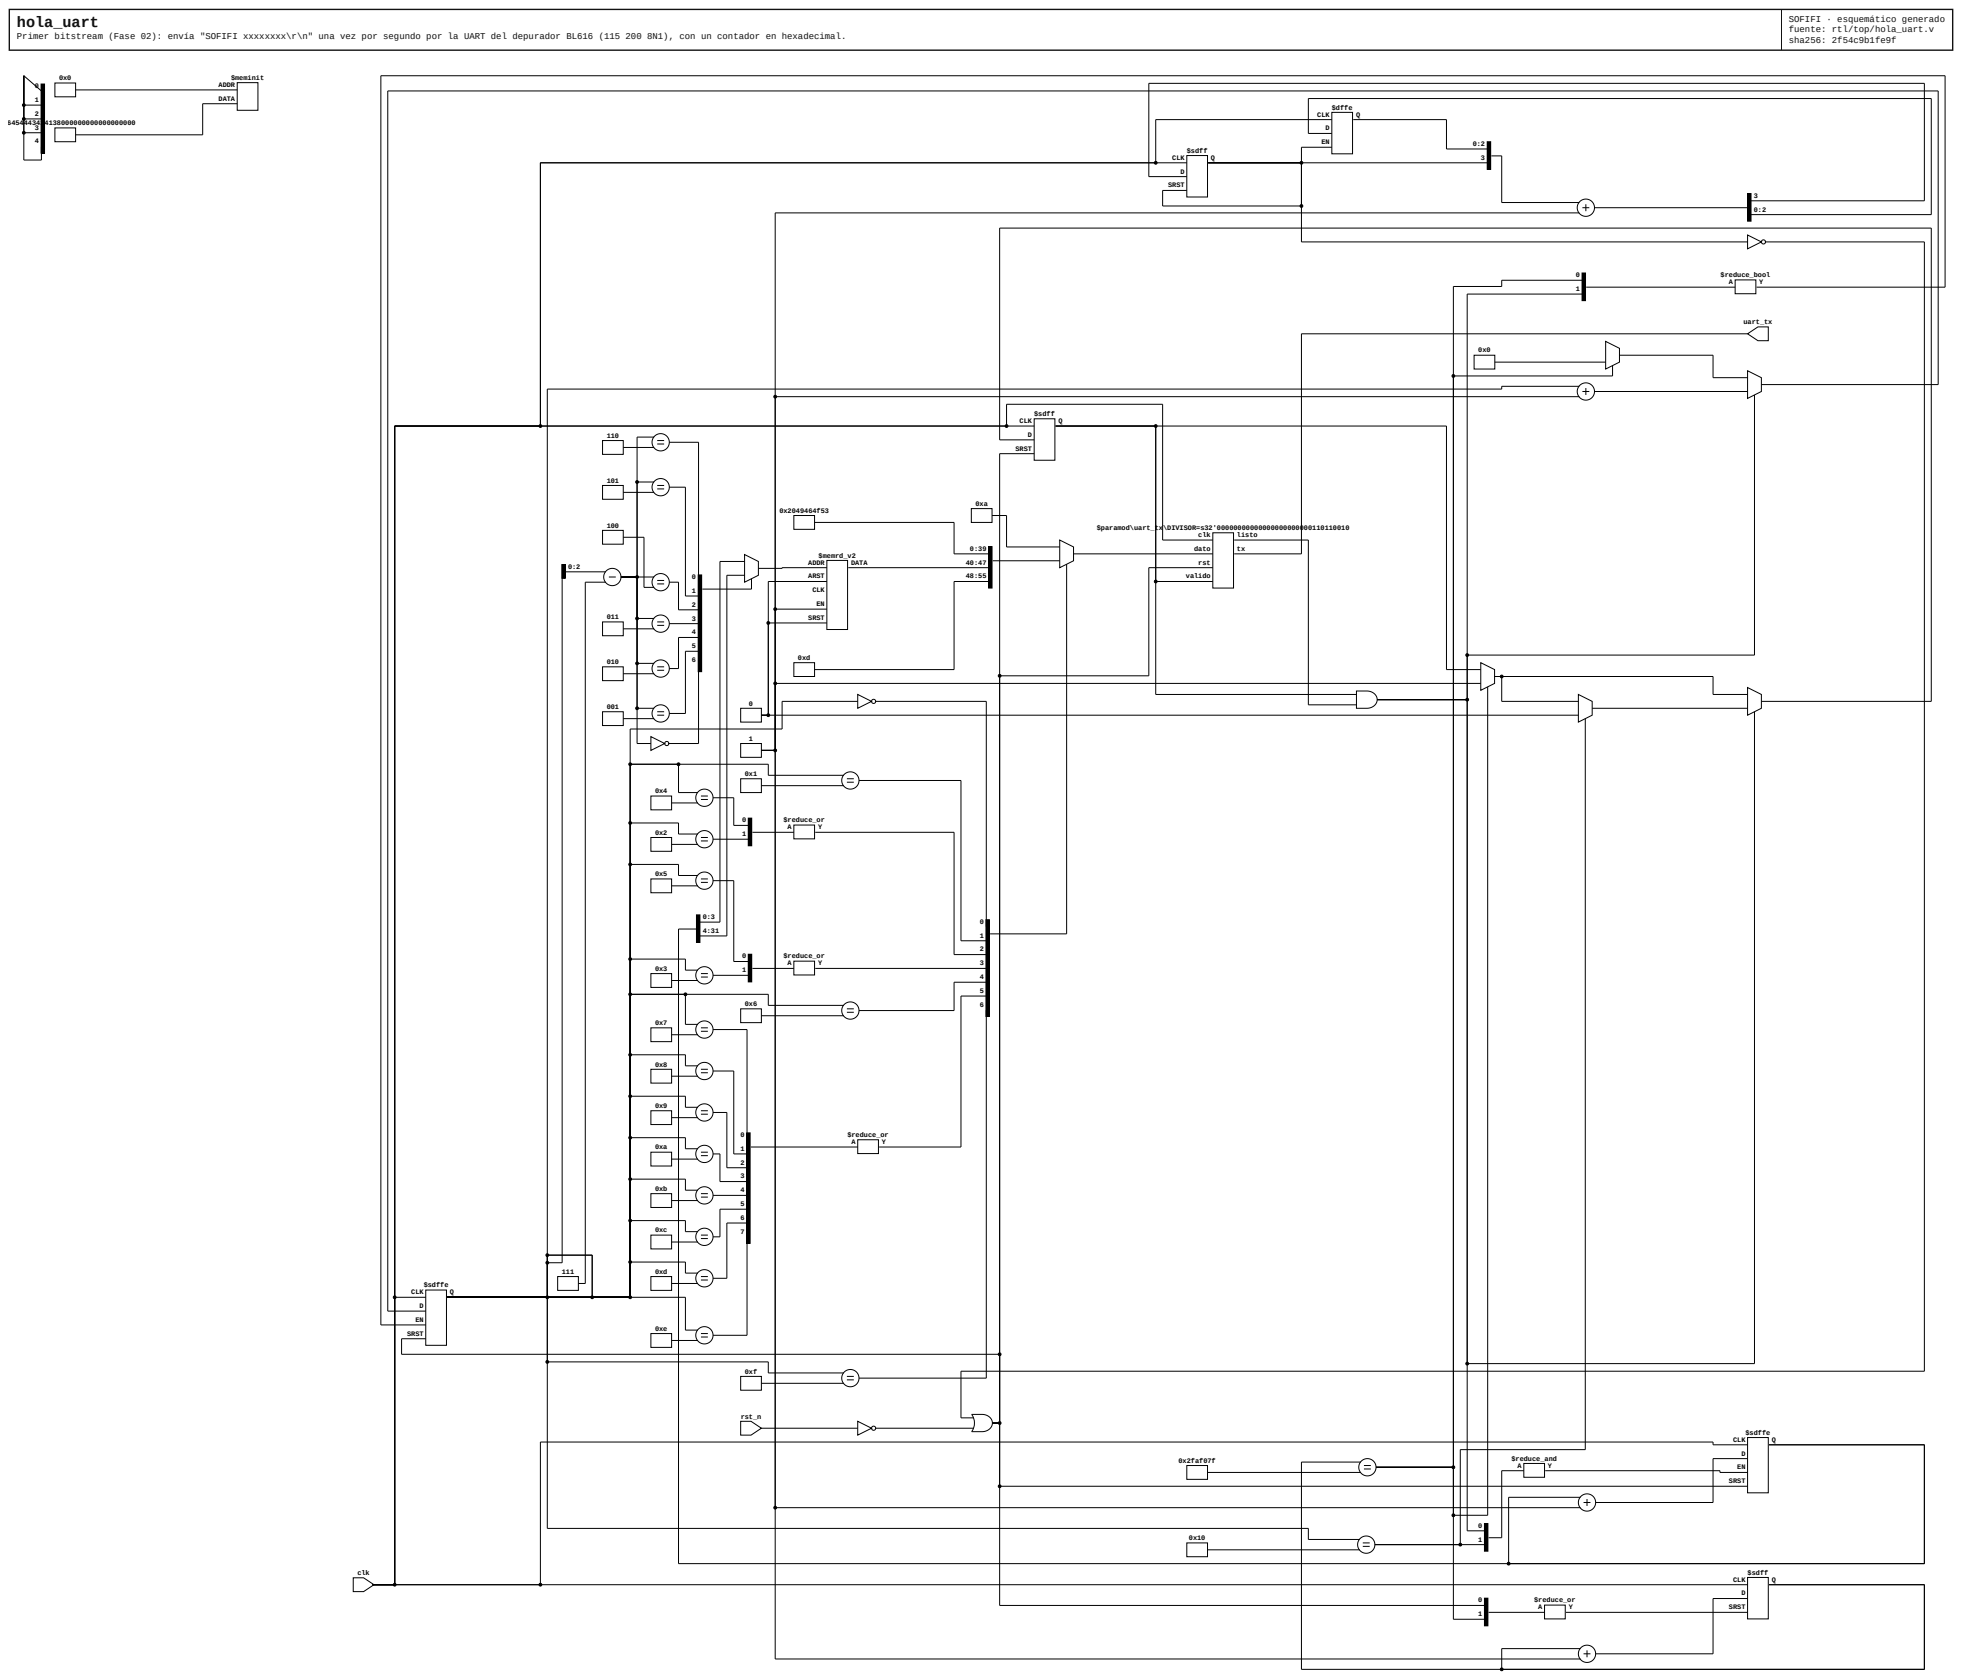
[picture p16: page 1]
$sdffe; CLK; SRST; $sdff; $dffe; $memrd_v2 ADDR; ARST; DATA; $meminit ADDR; $reduce_or A Y; $reduce_bool A Y; $reduce_and A Y; $paramod\uart_tx\DIVISOR=s32'00000000000000000000000110110010 clk; dato; rst; valido; listo; clk; rst_n; uart_tx

SOFIFI · esquemático generado
fuente: rtl/top/hola_uart.v
sha256: 2f54c9b1fe9f

0x2faf07f
