cabezoide/sofifi/schematics/top/prueba_fs.pdf

# prueba_fs

### Prueba del reloj de muestra y de la recepción UART (Fase 05), a 100 MHz:

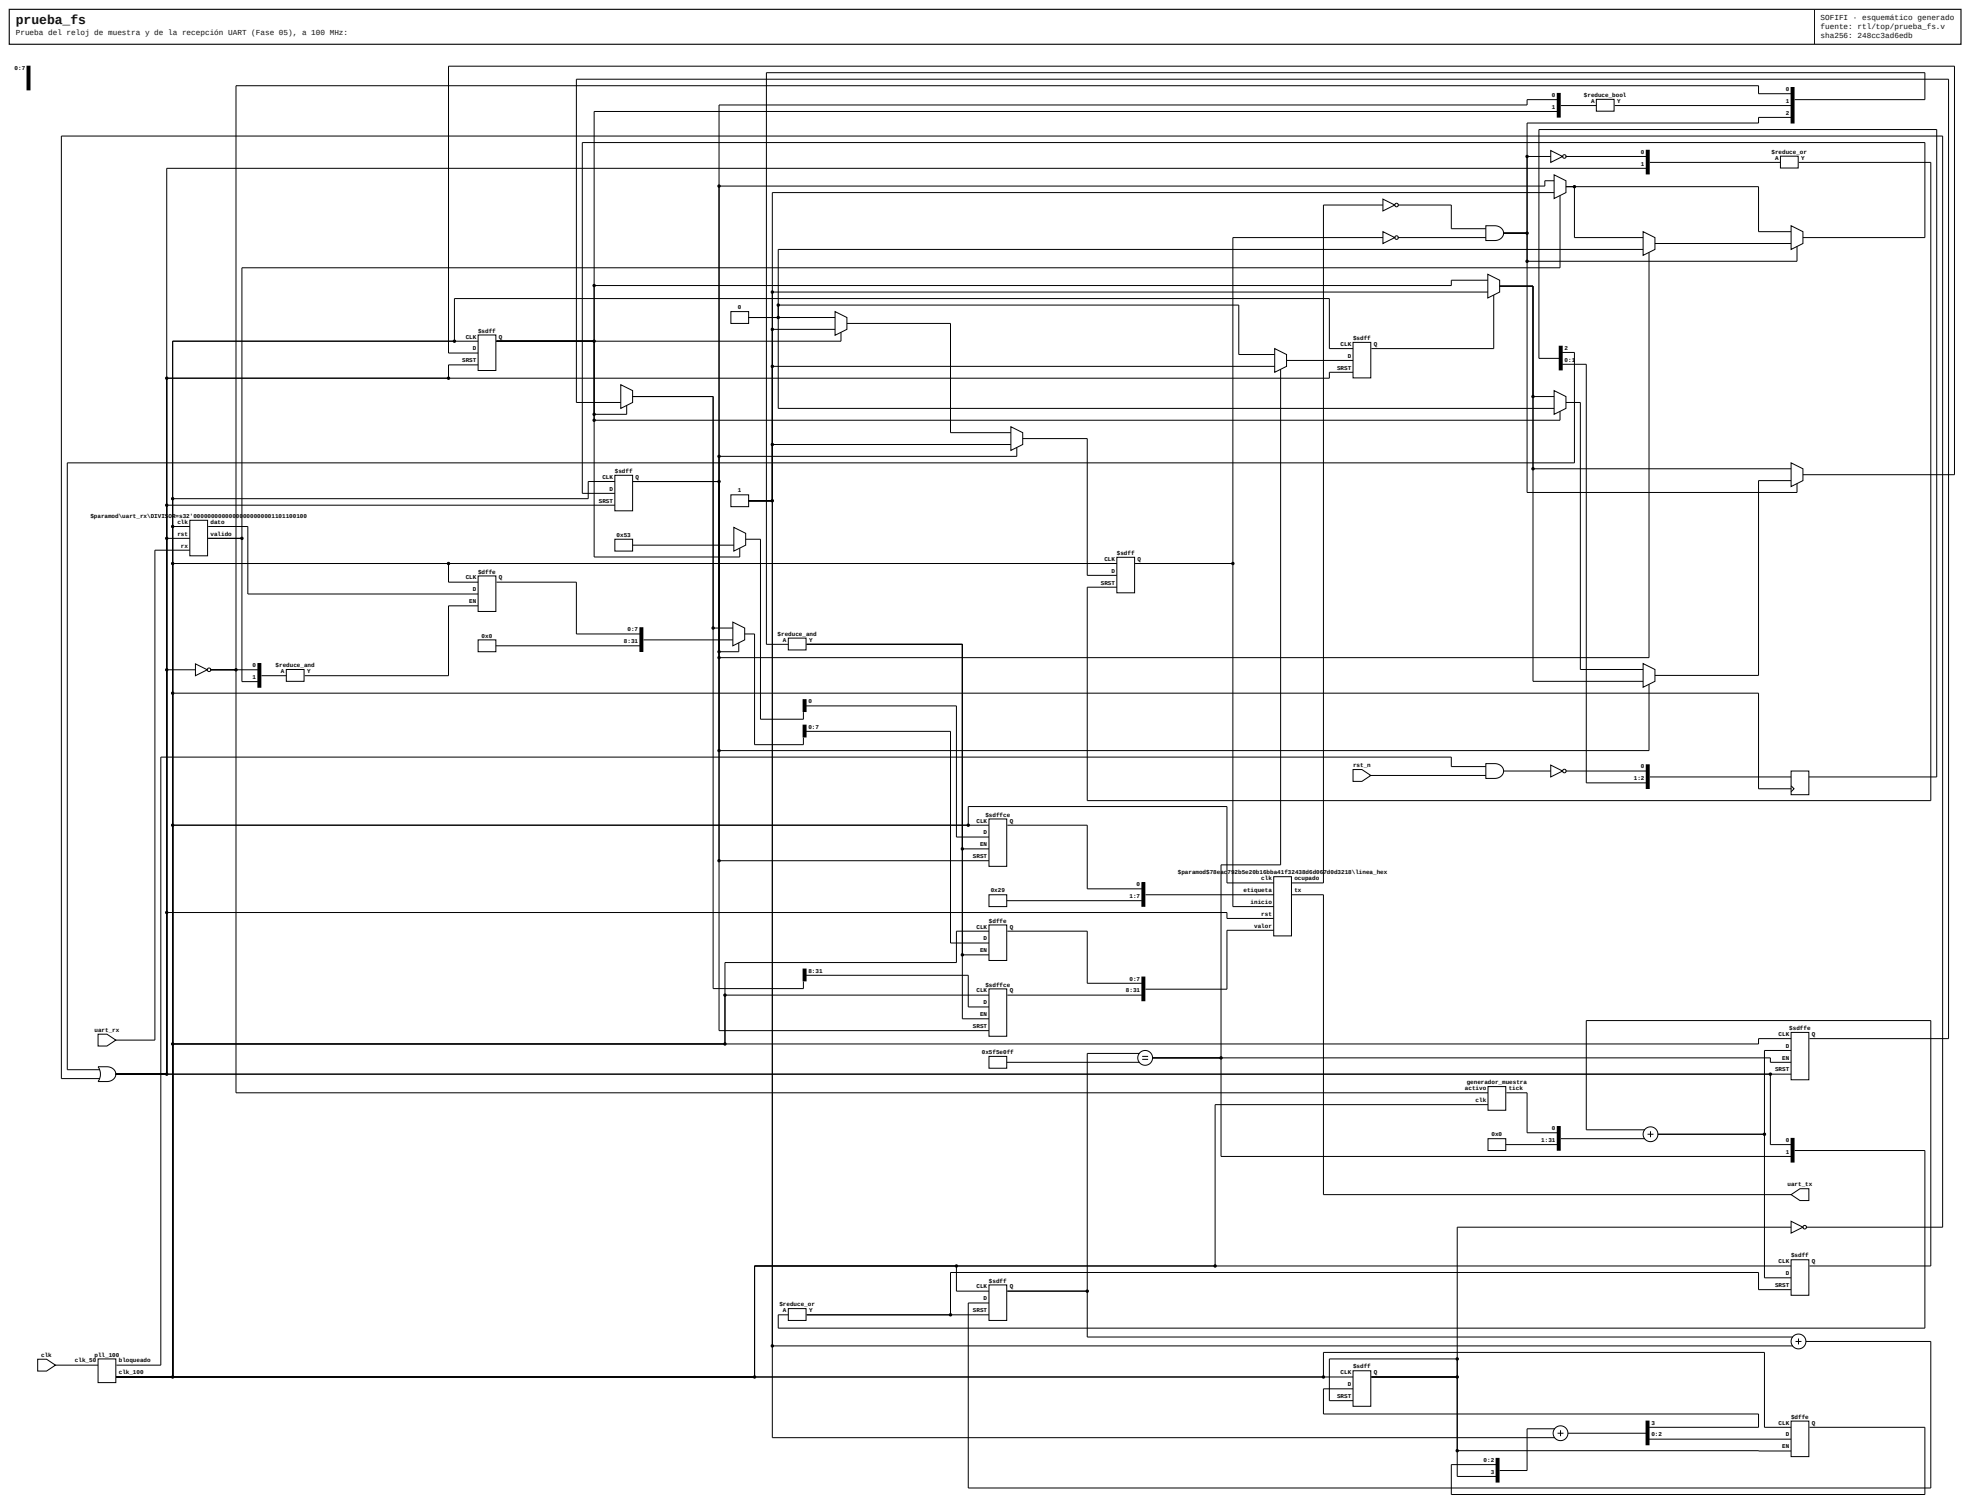
[picture p17: page 1]
$sdff; CLK; SRST; $dffe; $sdffce CLK; Q $sdff CLK; $sdffe; $reduce_bool A Y; $reduce_and A Y; $reduce_or A Y; generador_muestra activo; clk; tick; $paramod$78eac792b5e20b16bba41f32438d6d067d0d3218\linea_hex clk; etiqueta; inicio; rst; valor; ocupado; pll_100; clk_50; bloqueado; clk_100; $paramod\uart_rx\DIVISOR=s32'00000000000000000000001101100100; rst_n; uart_rx; uart_tx

SOFIFI · esquemático generado
fuente: rtl/top/prueba_fs.v
sha256: 248cc3ad6edb

clk dato rst valido rx
