cabezoide/sofifi/schematics/salida/salida_1bit.pdf

# salida_1bit

Salida de audio de 1 bit (ADR 0015).

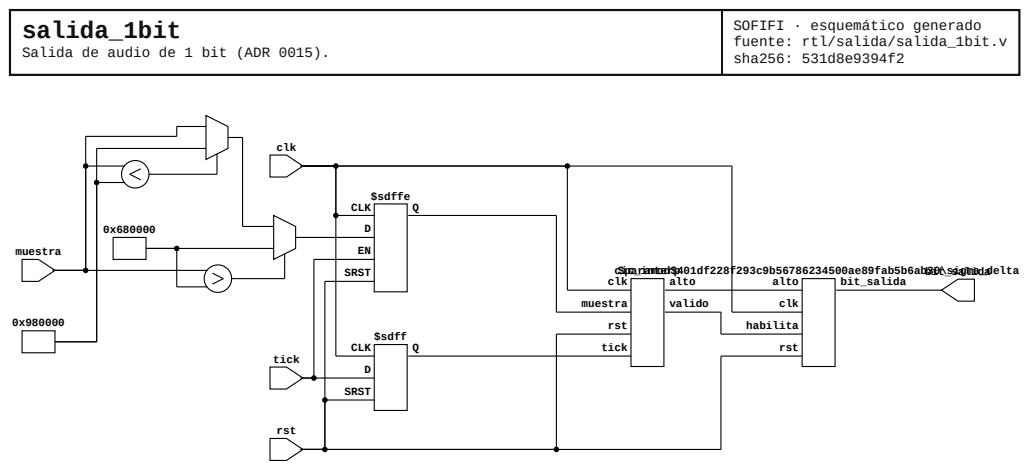
[picture p18: page 1]
$sdffe; CLK; SRST; $sdff; cic_interp clk; muestra; rst; tick; alto; valido; $paramod$401df228f293c9b56786234500ae89fab5b6ab30\sigma_delta alto; clk; habilita; bit_salida

SOFIFI · esquemático generado
fuente: rtl/salida/salida_1bit.v
sha256: 531d8e9394f2
