cabezoide/sofifi/schematics/salida/sigma_delta.pdf

# sigma_delta

Modulador sigma-delta de 2.º orden con realimentación distribuida (ADR 0015).

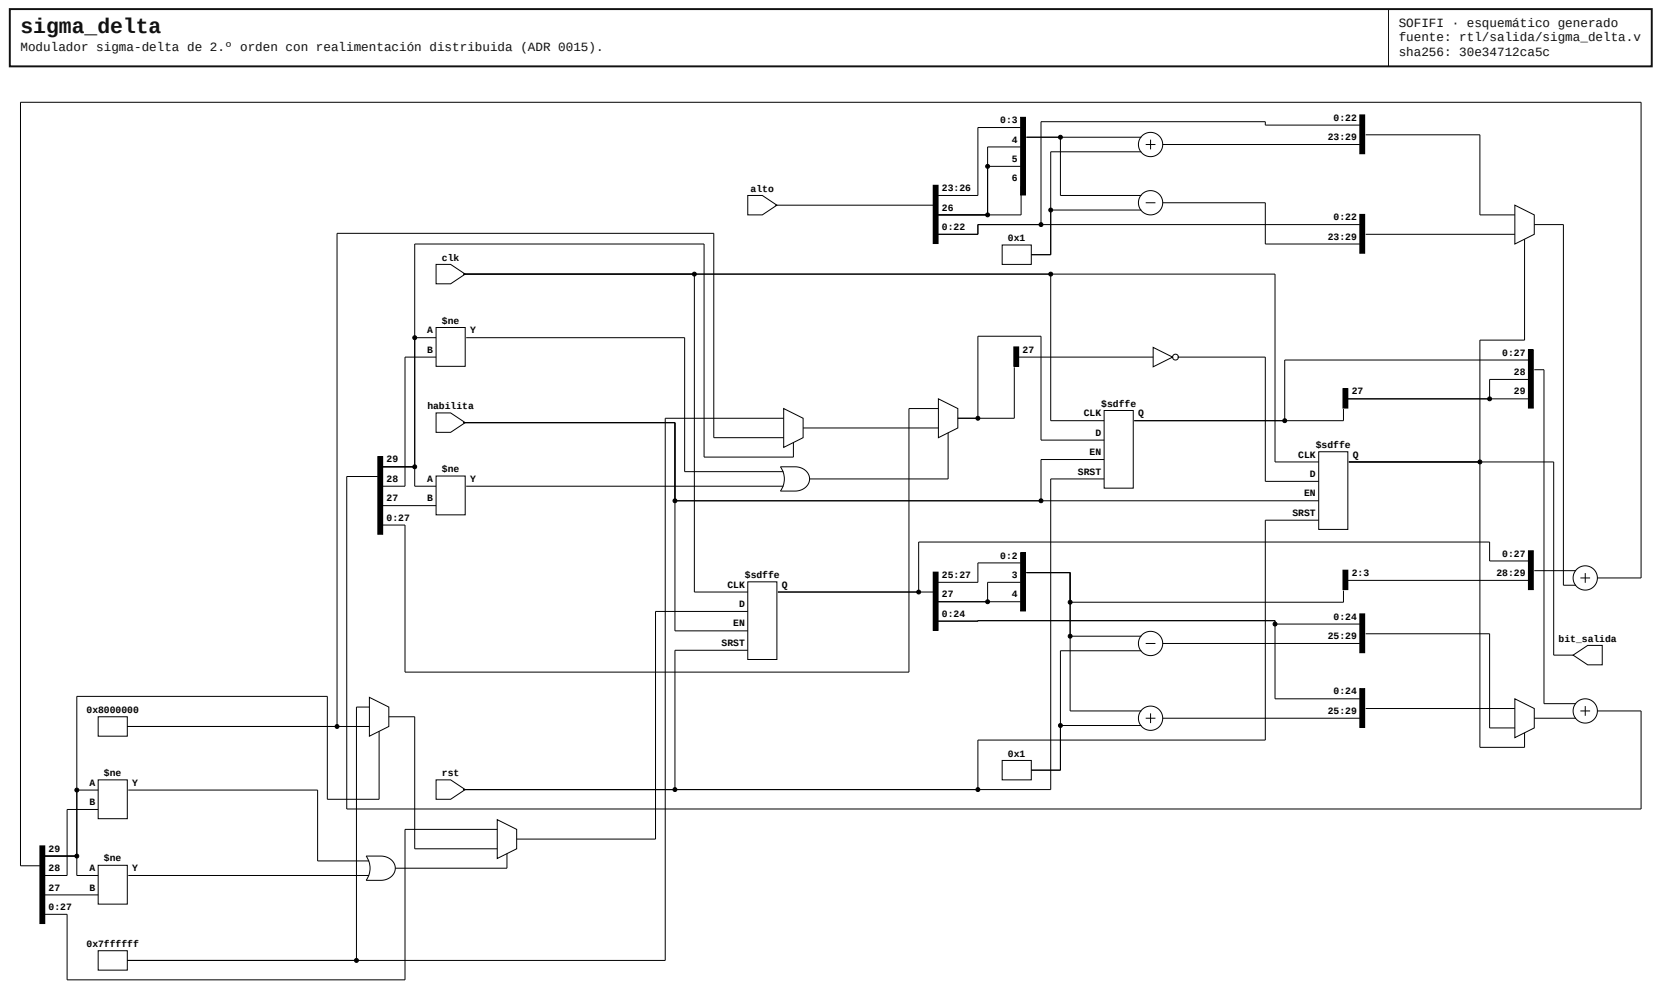
[picture p19: page 1]
$sdffe; CLK; SRST; clk; rst; habilita; alto; bit_salida; 0x7ffffff

SOFIFI · esquemático generado
fuente: rtl/salida/sigma_delta.v
sha256: 30e34712ca5c
