cabezoide/sofifi/schematics/sd/cargador.pdf

# cargador

Cargador de programas desde el banco de la microSD (Fase 08).

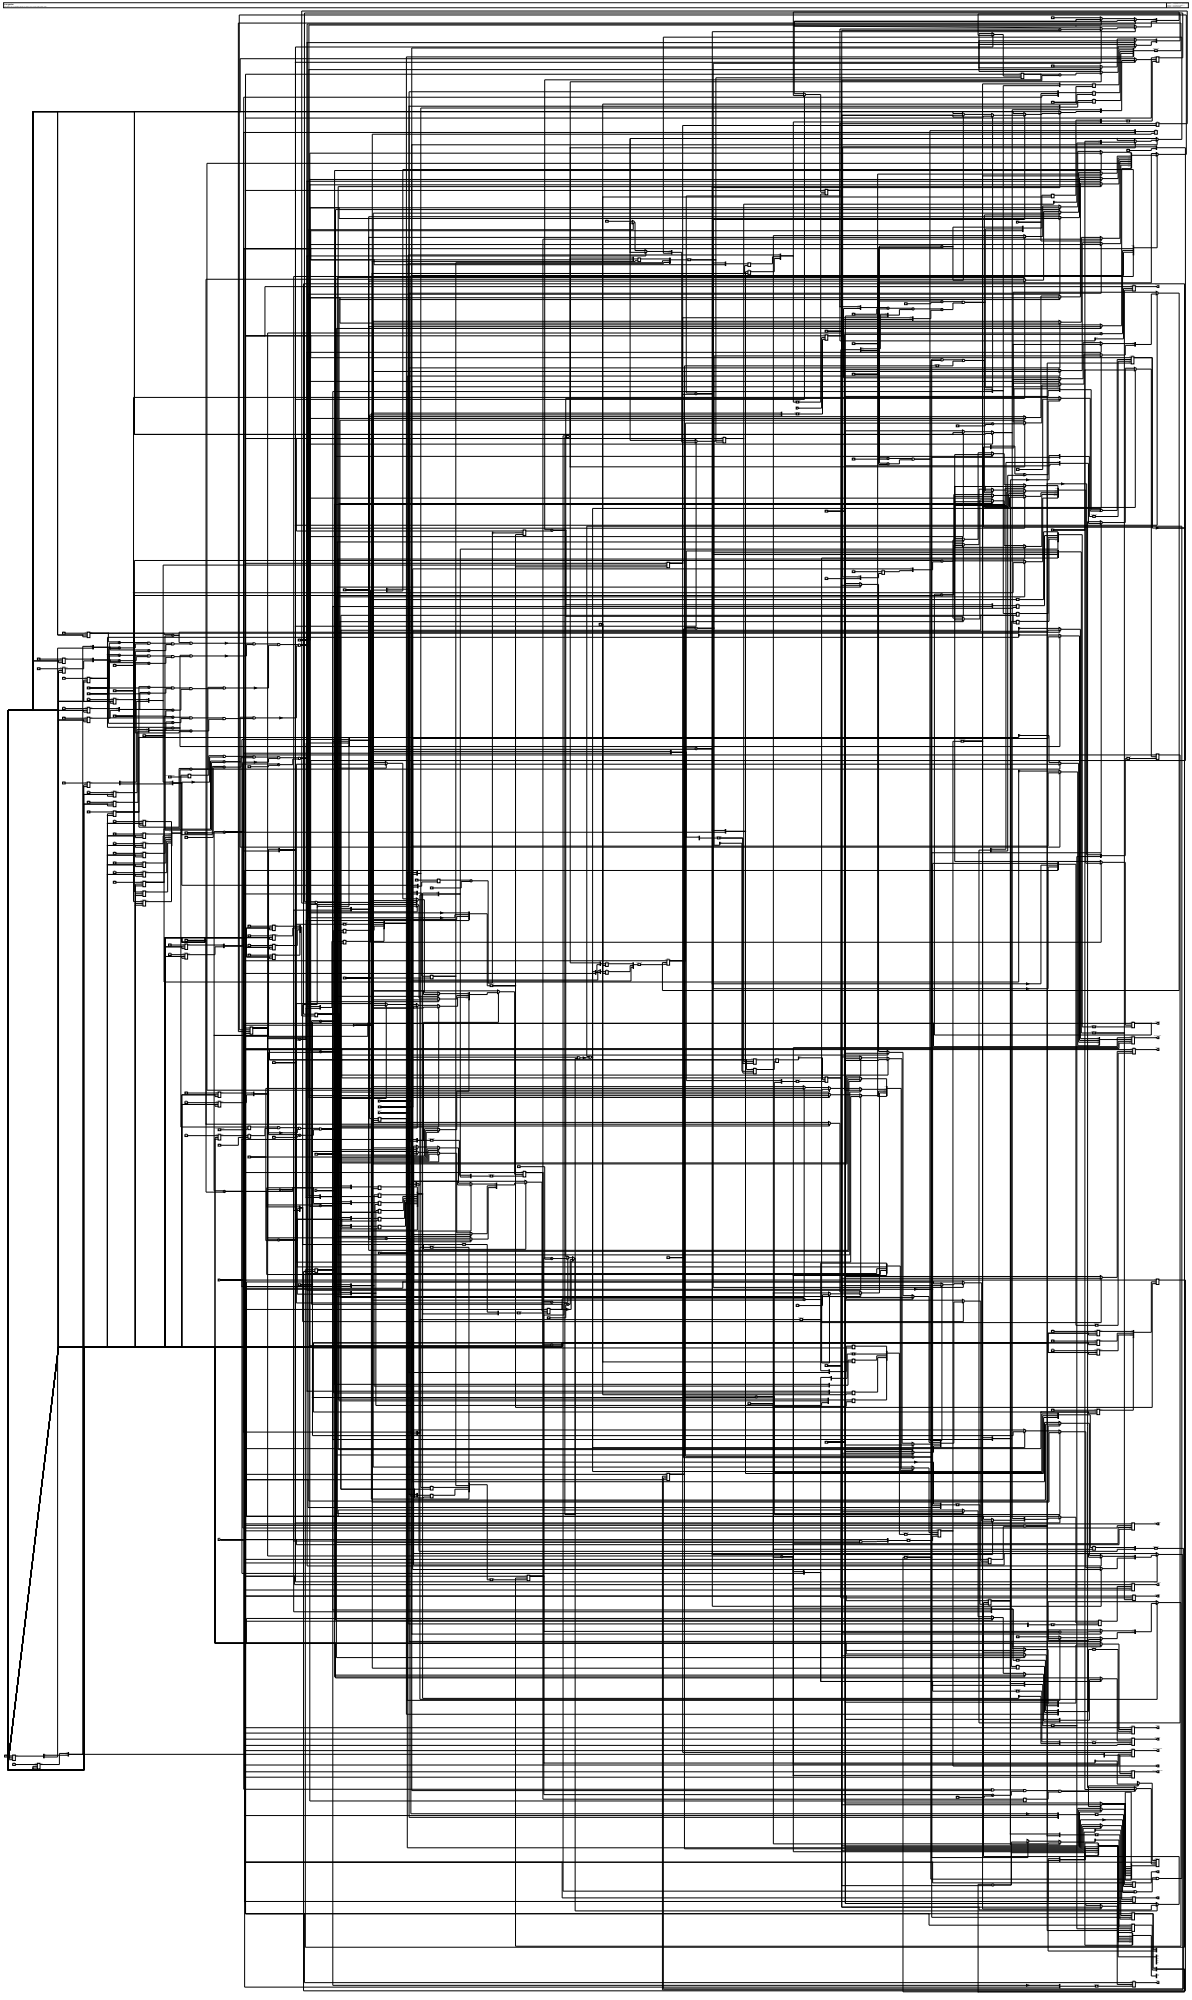
[picture p20: page 1]
$dffe; CLK; $sdffe; SRST; $sdff; $reduce_or A Y; $memwr_v2 ADDR; DATA; $reduce_bool A Y; $reduce_and A Y; $memrd; ADDR; clk; rst; cargar; ranura; ocupado; hecho; fallo; motivo; sd_leer; sd_bloque; sd_error; sd_dato_v; sd_fin; nucleo_rst; prog_dir; prog_dato; cfg_instrucciones; cfg_lfo_excursiones; cfg_absoluta; 0xedb88320

SOFIFI · esquemático generado
fuente: rtl/sd/cargador.v
sha256: ecbc8170989f

1:2

0 $ne A Y B

sd_dato | $reduce_and A Y

$dffe CLK Q D EN | 0x0 | 0x7 0:9 10:31 | 0:1 $mul 2:31 B

0 | $reduce_bool A Y $ne A Y B $ne A Y B

0xff

$memrd ADDR DATA CLK | | | | | 0

$reduce_bool A Y

3:4

0:1 | 0 1 $reduce_and A Y | | 0:1

0 | $mul A Y 0:7

$reduce_and A Y | cfg_lfo_tipos prog_we $dffe CLK Q D cfg_palabras $reduce_and A Y

$sdffe CLK Q D EN SRST

$sdffe CLK Q D EN SRST $sdff CLK Q D SRST

$dffe CLK Q D EN | $shr A Y B | 0:53

0:1 2 | $reduce_and A Y | EN | | | | 0:3

sd_ocupado

$ne A Y | 0x3b | $memrd ADDR DATA CLK CLK

0x38 0 | $memrd ADDR DATA CLK | $sdffe CLK Q D EN SRST 0 1:3

$sdff CLK Q D

0 1 2 | $reduce_and A Y

$reduce_and A Y

$reduce_bool A Y 0:2

0 0
1 2 0 1 2

1 $reduce_bool A Y 0 1:3

$reduce_and A Y | EN SRST $sdffe CLK Q D EN
