cabezoide/sofifi/schematics/top/prueba_sd_logica.pdf

# prueba_sd_logica

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

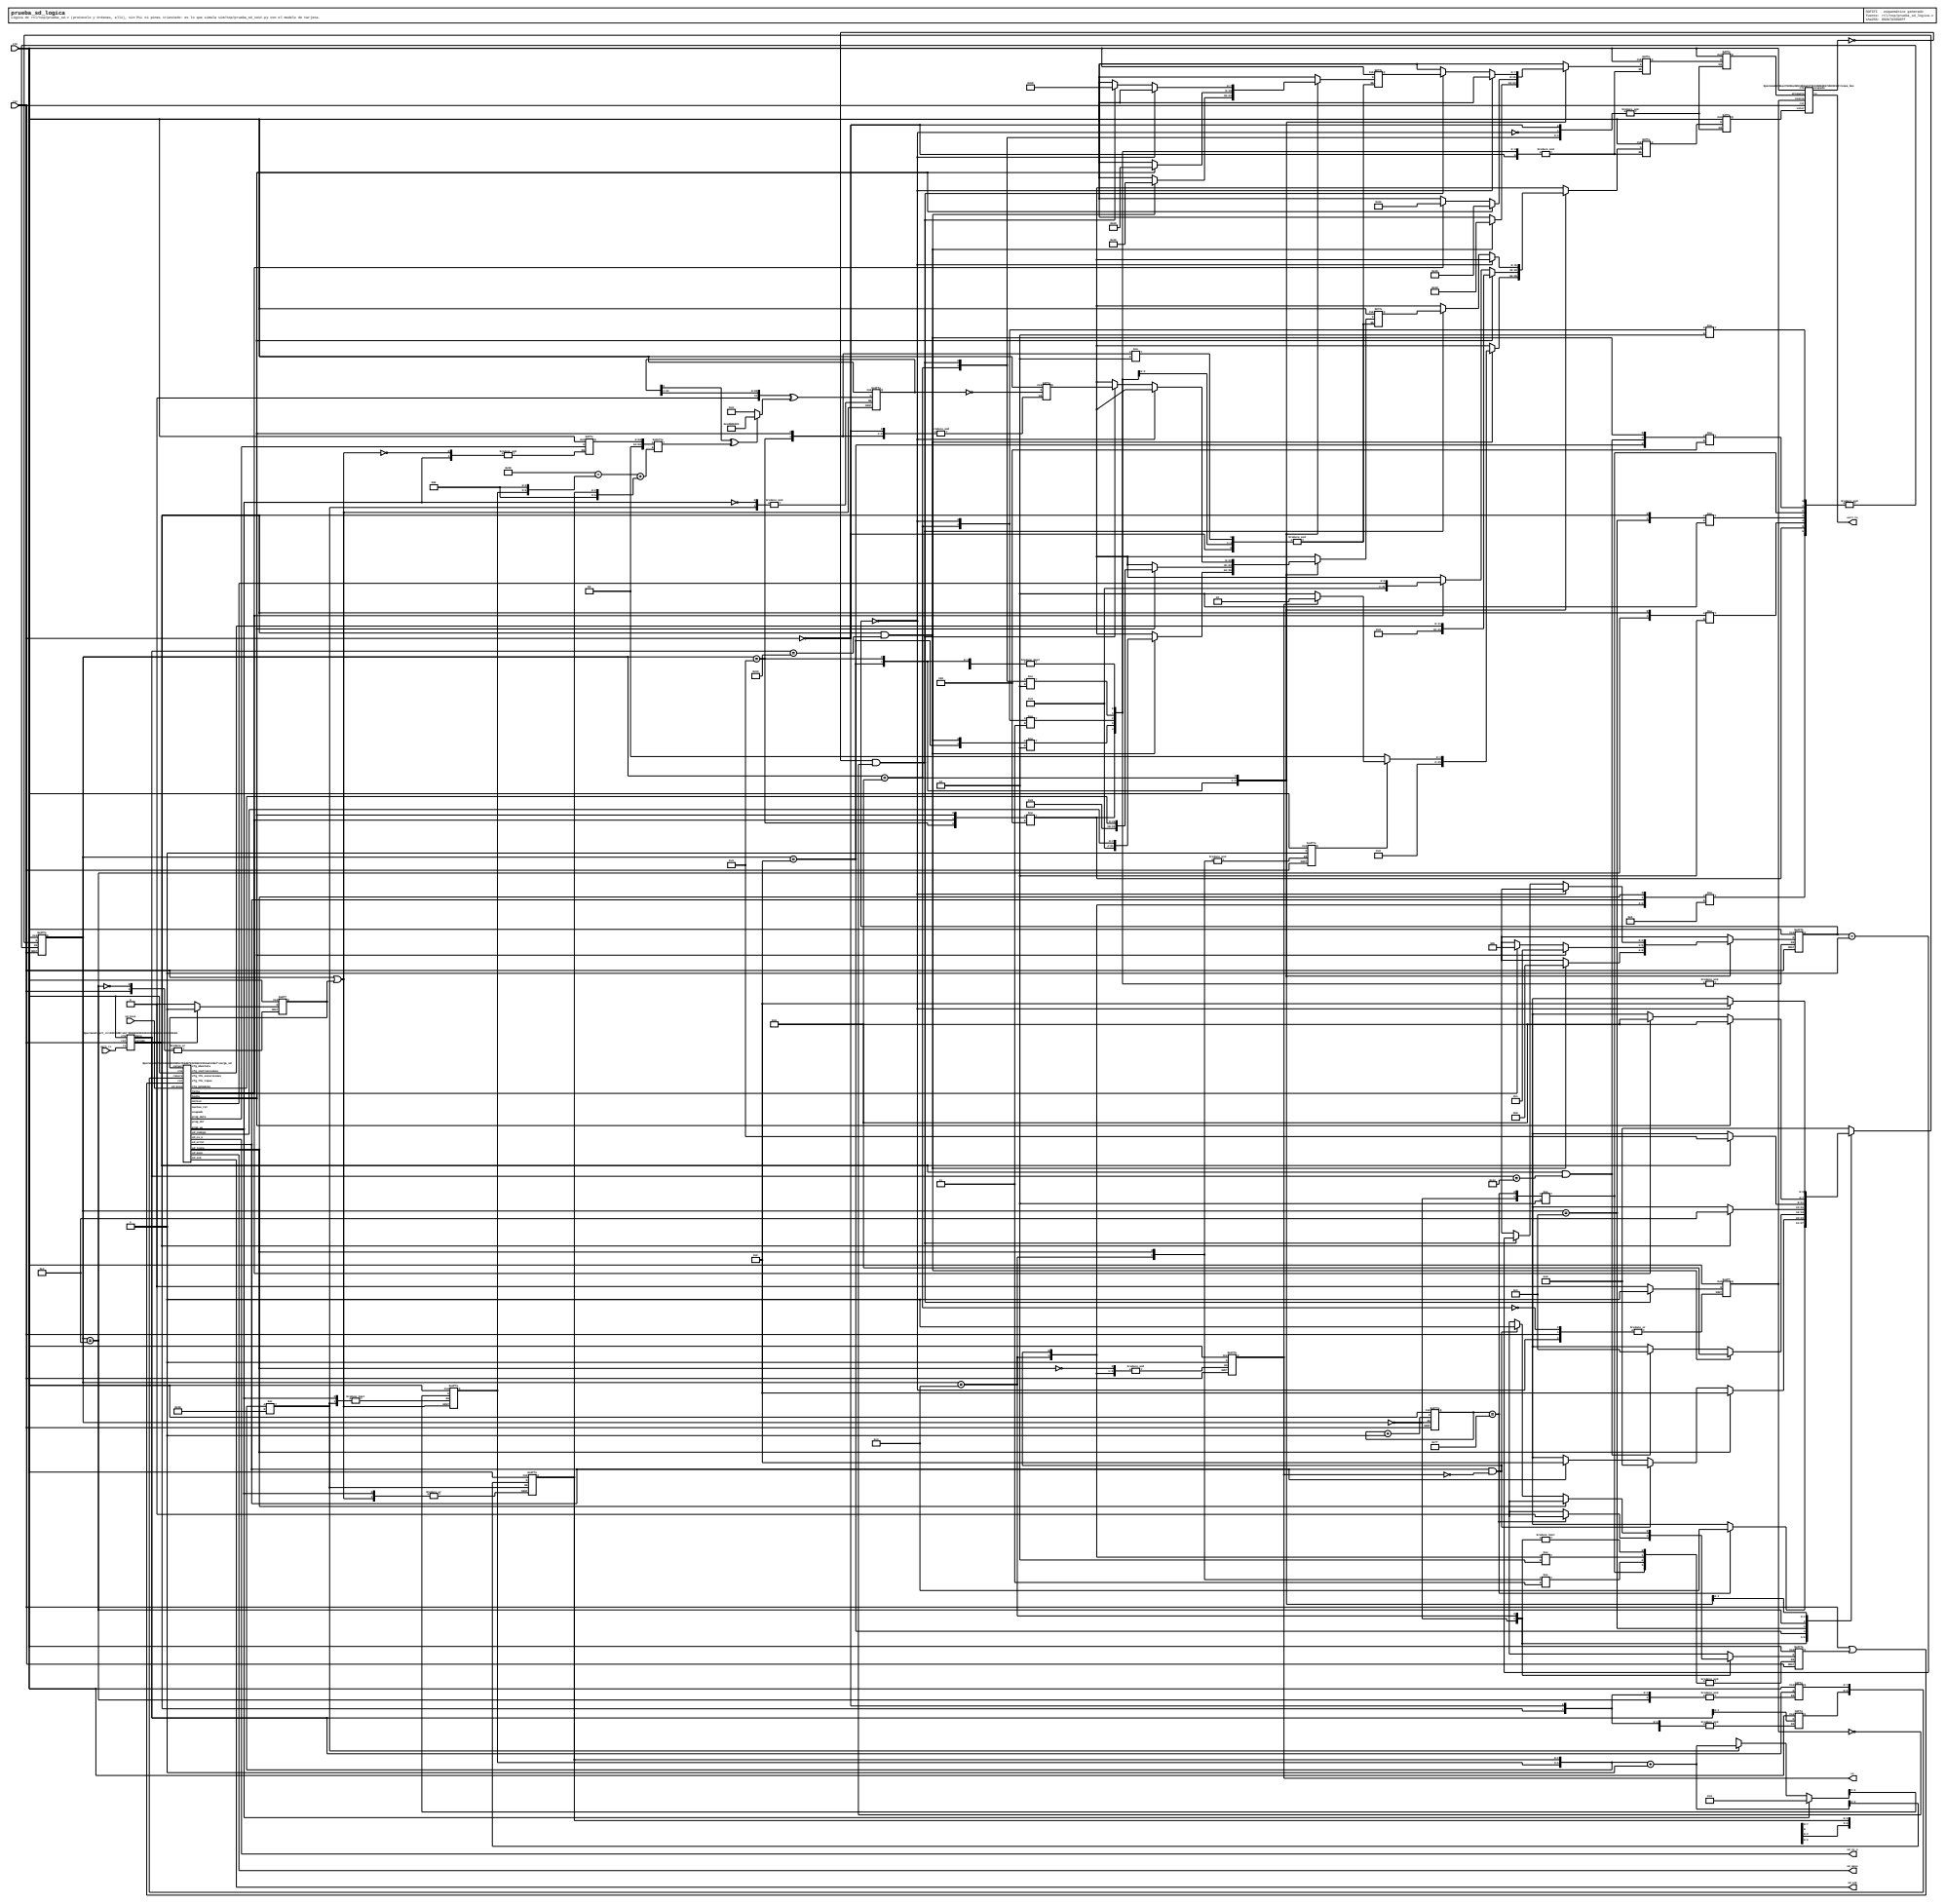
[picture p21: page 1]
$sdffe; CLK; SRST; $dffe; $sdff; $reduce_bool A Y; $reduce_and A Y; $reduce_or A Y; $shiftx A; $paramod$dfa84003403d08b4706d6f63496512234a4130ef\carga_sd cargar; clk; ranura; rst; sd_miso; cfg_absoluta; cfg_instrucciones; cfg_lfo_excursiones; cfg_lfo_tipos; cfg_palabras; fallo; hecho; motivo; nucleo_rst; ocupado; prog_dato; prog_dir; prog_we; sd_codigo; sd_error; sd_listo; sd_mosi; sd_sck; $paramod$78eac792b5e20b16bba41f32438d6d067d0d3218\linea_hex clk; etiqueta; inicio; valor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

SOFIFI · esquemático generado
fuente: rtl/top/prueba_sd_logica.v
sha256: 892b765090ff

D EN SRST 0 1:2

0 1 | $reduce_bool A Y $ne A Y B 0x0 $ne A Y B $ne A Y B

16:31 0:3 | $reduce_and A Y

rst valido rx uart_rx

$sdffe CLK Q D EN SRST
