cabezoide/sofifi/schematics/nucleo/alu.pdf

# alu

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

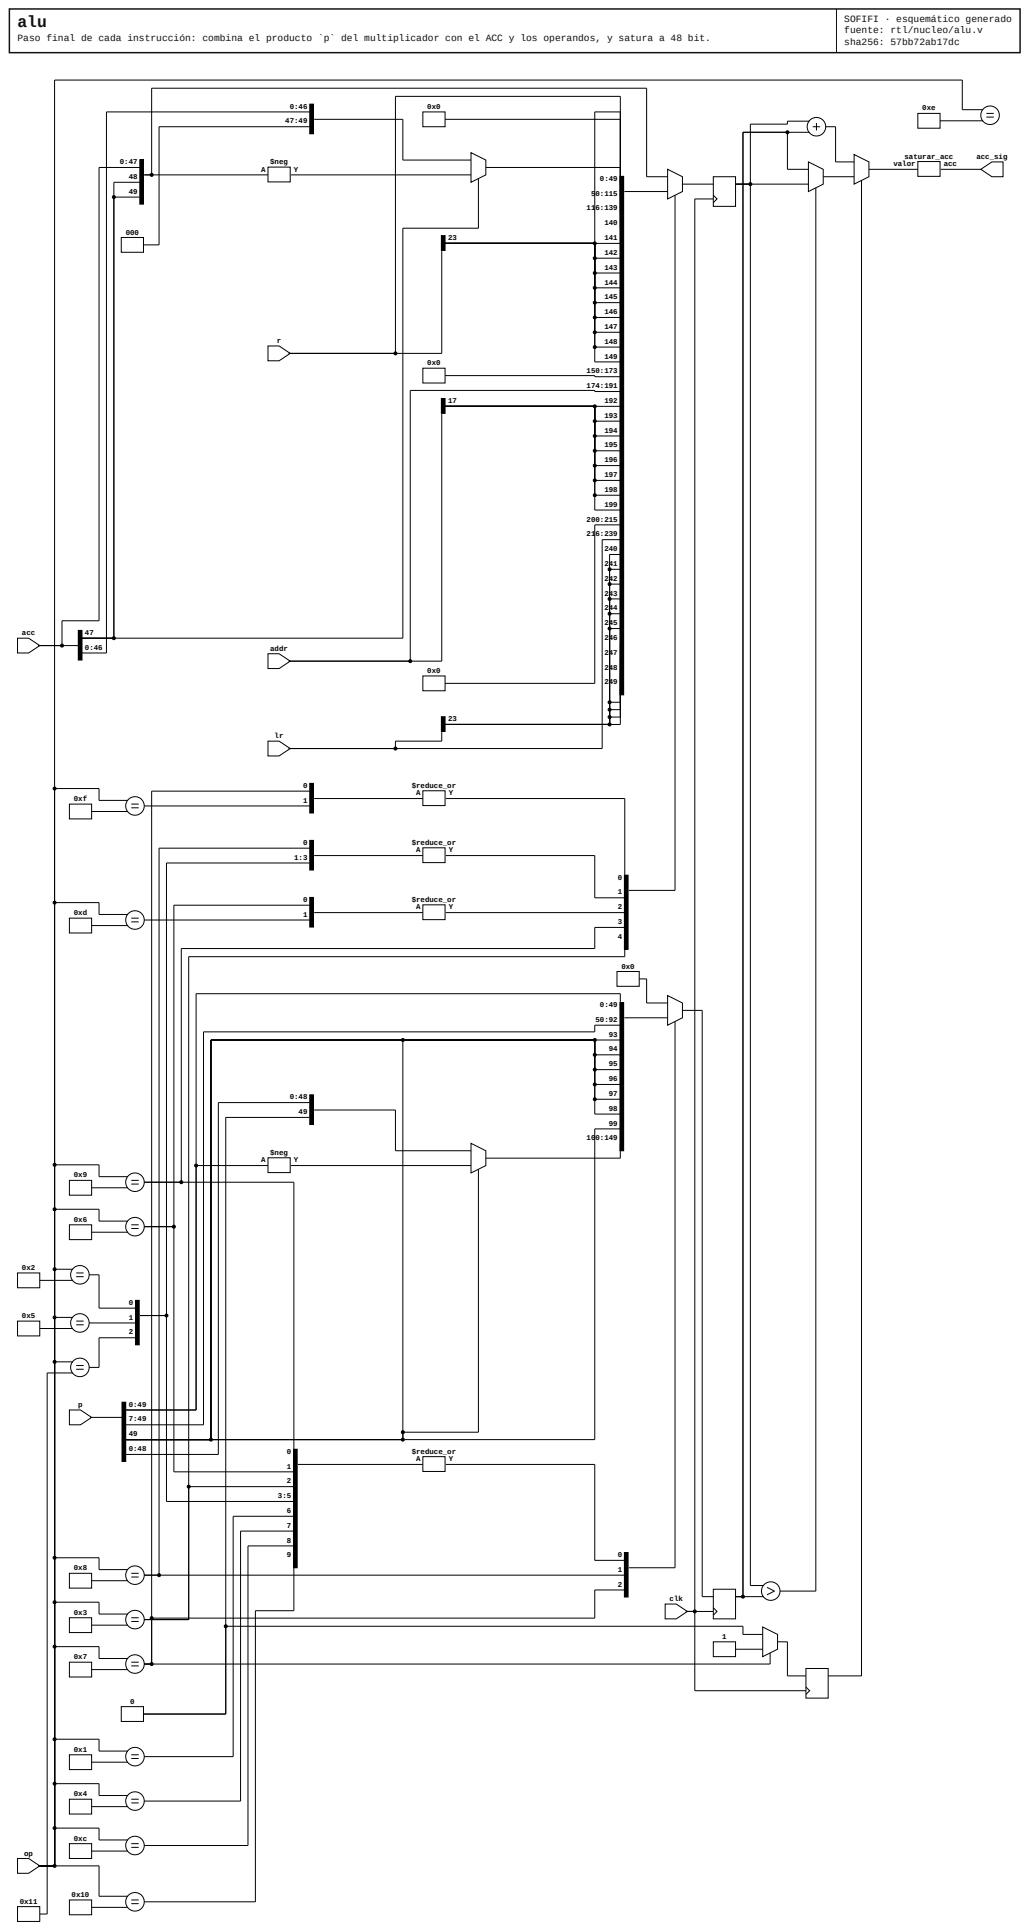
[picture p22: page 1]
$reduce_or A Y; $neg A Y; saturar_acc; valor; acc; clk; addr; acc_sig

SOFIFI · esquemático generado
fuente: rtl/nucleo/alu.v
sha256: 57bb72ab17dc
