cabezoide/sofifi/schematics/nucleo/nucleo.pdf

# nucleo

Núcleo DSP microcodificado de SOFIFI (ADR 0006, ADR 0009).

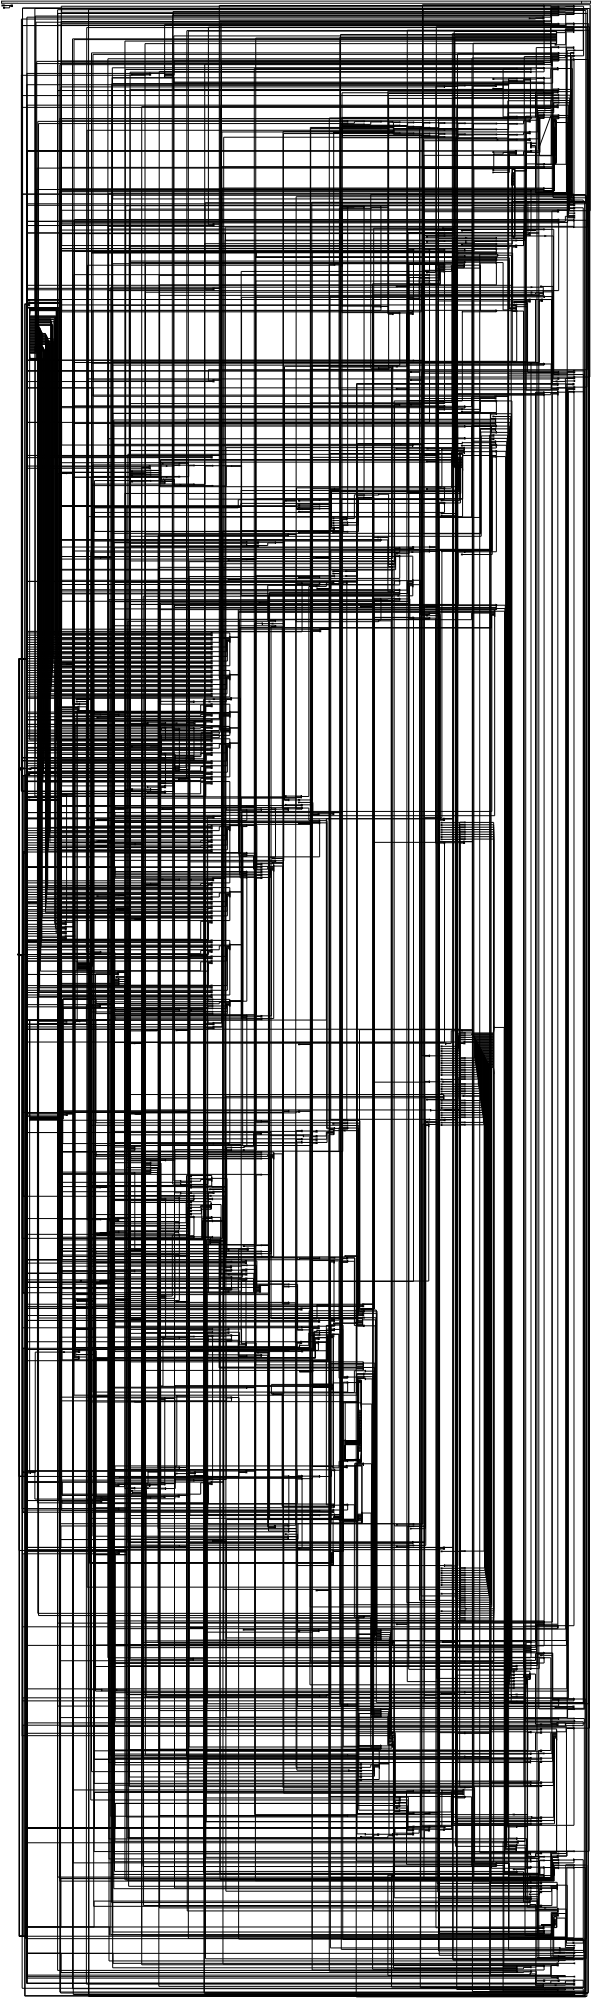
[picture p23: page 1]
SRST; $sdffe; $dffe; CLK; $sdff; $memrd_v2 ADDR; ARST; DATA; $meminit ADDR; $reduce_or A Y; $memwr_v2; $reduce_bool A Y; $reduce_and A Y; $reduce_and; $memrd; ADDR; $mul; $shl; acc_a_dato; acc; dato; curva_fin p; tres_x; lfo_banco avanzar; media; rates; rst; sel; tipos; fase_sel; listo; tri_sel; ven_sel; abs_r; abs_w; avanzar; clk; dato_w; dir_r; dato_r; $paramod$e0e31703b593cfe887f031dc7449403670d5fdec\bsram_pipe clk; dir_w; mult_27x36 a; tabla_hermite; frac; coefs; prog_we; prog_dir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

SOFIFI · esquemático generado
fuente: rtl/nucleo/nucleo.v
sha256: a7fe839f1c97

$dffe CLK Q

EN
SRST

CLK

$sdff CLK Q | B ADDR

0xe | CLK D

0x7fff

CLK | 0x4

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
CLK | | 0xb | D

$sdffe CLK Q

$reduce_bool A Y 0x0

$reduce_or A Y

$sdffe CLK Q | 0x3 0x9 0xb 0xc 0xa

0x6 0x7 0x15 | D EN SRST

$ne $ne A Y B | | $reduce_bool A Y | $dffe CLK Q

0x12 | 0x8 | 0x5 0x9 | $reduce_or A Y

$reduce_or A Y | CLK | $dffe CLK Q | 0x0

$reduce_or A Y | $sdff CLK Q D SRST

$sdffe CLK Q $sdffe Q $sdffe Q $sdffe Q $sdffe Q $sdffe Q $sdffe Q $sdffe Q $sdffe Q $sdffe Q $sdffe Q $sdffe Q $sdffe Q $sdffe Q | | | $dffe CLK Q | cfg_lfo_excursiones 0xf

tick | | | | | | | | | CLK

$sdffe CLK Q | EN

$dffe CLK Q D EN | D

$dffe CLK Q | D

$shiftx A Y B | D

$sdff CLK Q

$sdffe CLK Q $sdffe Q $sdffe Q $sdffe Q $sdffe Q $sdffe Q

$reduce_bool A Y | | D

clk

$reduce_bool | $reduce_and A Y | D

0xd | | | CLK

10 | | SRST

D EN SRST CLK $sdffe Q D EN SRST $sdffe CLK Q D EN SRST $sdffe CLK Q D EN SRST | | D

39
48:53 18:35 35 42:47 0:17

EN SRST 011

$sdffe CLK Q D EN SRST | $ne A Y B

0x0 | | 0x1d cfg_instrucciones 0x1b | 0x18

D EN SRST CLK $paramod$0f4d78719d74ddd6b48510de7342ead4779aeeed\memoria_retardo | dir_w palabras rst

110 | | $dffe CLK Q | | CLK

001 | $dffe CLK $sdffe Q | $sdffe CLK Q

$reduce_and A Y | | | | D

$reduce_and A Y | | | 0x0 | CLK Q D

actual_sel clk | $shiftx D A Y

D EN SRST

$sdffe CLK | Q

$sdffe CLK Q D | 111

000 cfg_palabras | 0x1c | | 0xe 0x1

0:1 | $reduce_or A Y

ocupado

$paramod\alu\REGISTRADA=s32'00000000000000000000000000000001 acc acc_sig addr clk | $reduce_bool A Y CLK

0x120 $dffe CLK Q D EN A Y B
