cabezoide/sofifi/schematics/sd/carga_sd.pdf

# carga_sd

### Carga de programas desde la microSD (Fase 08): sd_spi.v +

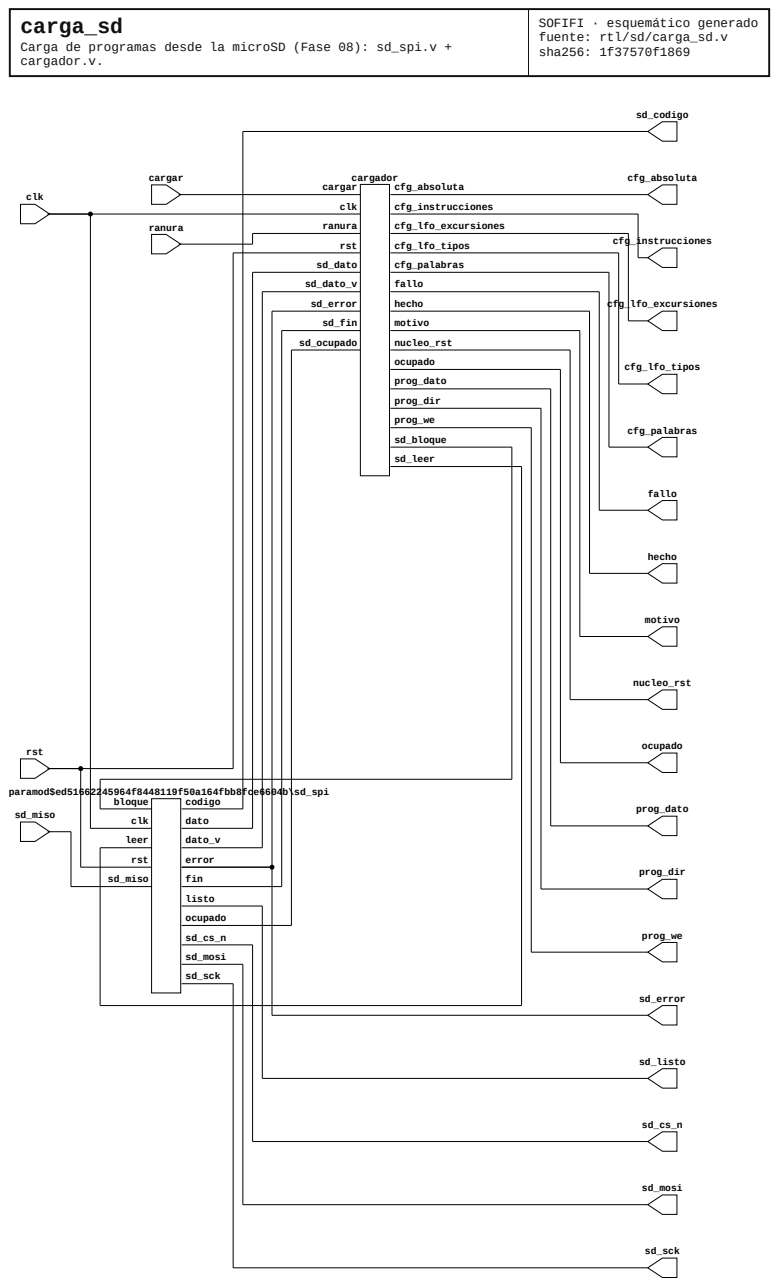
[picture p24: page 1]
cargador.v.; cargador cargar; clk; ranura; rst; sd_dato; sd_dato_v; sd_error; sd_fin; sd_ocupado; cfg_absoluta; cfg_instrucciones; cfg_lfo_excursiones; cfg_lfo_tipos; cfg_palabras; fallo; hecho; motivo; nucleo_rst; ocupado; prog_dato; prog_dir; prog_we; sd_bloque; sd_leer; paramod$ed51662245964f8448119f50a164fbb8fce6604b\sd_spi bloque; leer; sd_miso; codigo; dato; dato_v; error; fin; listo; sd_mosi; sd_sck; cargar; sd_listo; sd_codigo

SOFIFI · esquemático generado
fuente: rtl/sd/carga_sd.v
sha256: 1f37570f1869
