cabezoide/sofifi/schematics/sd/sd_spi.pdf

# sd_spi

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

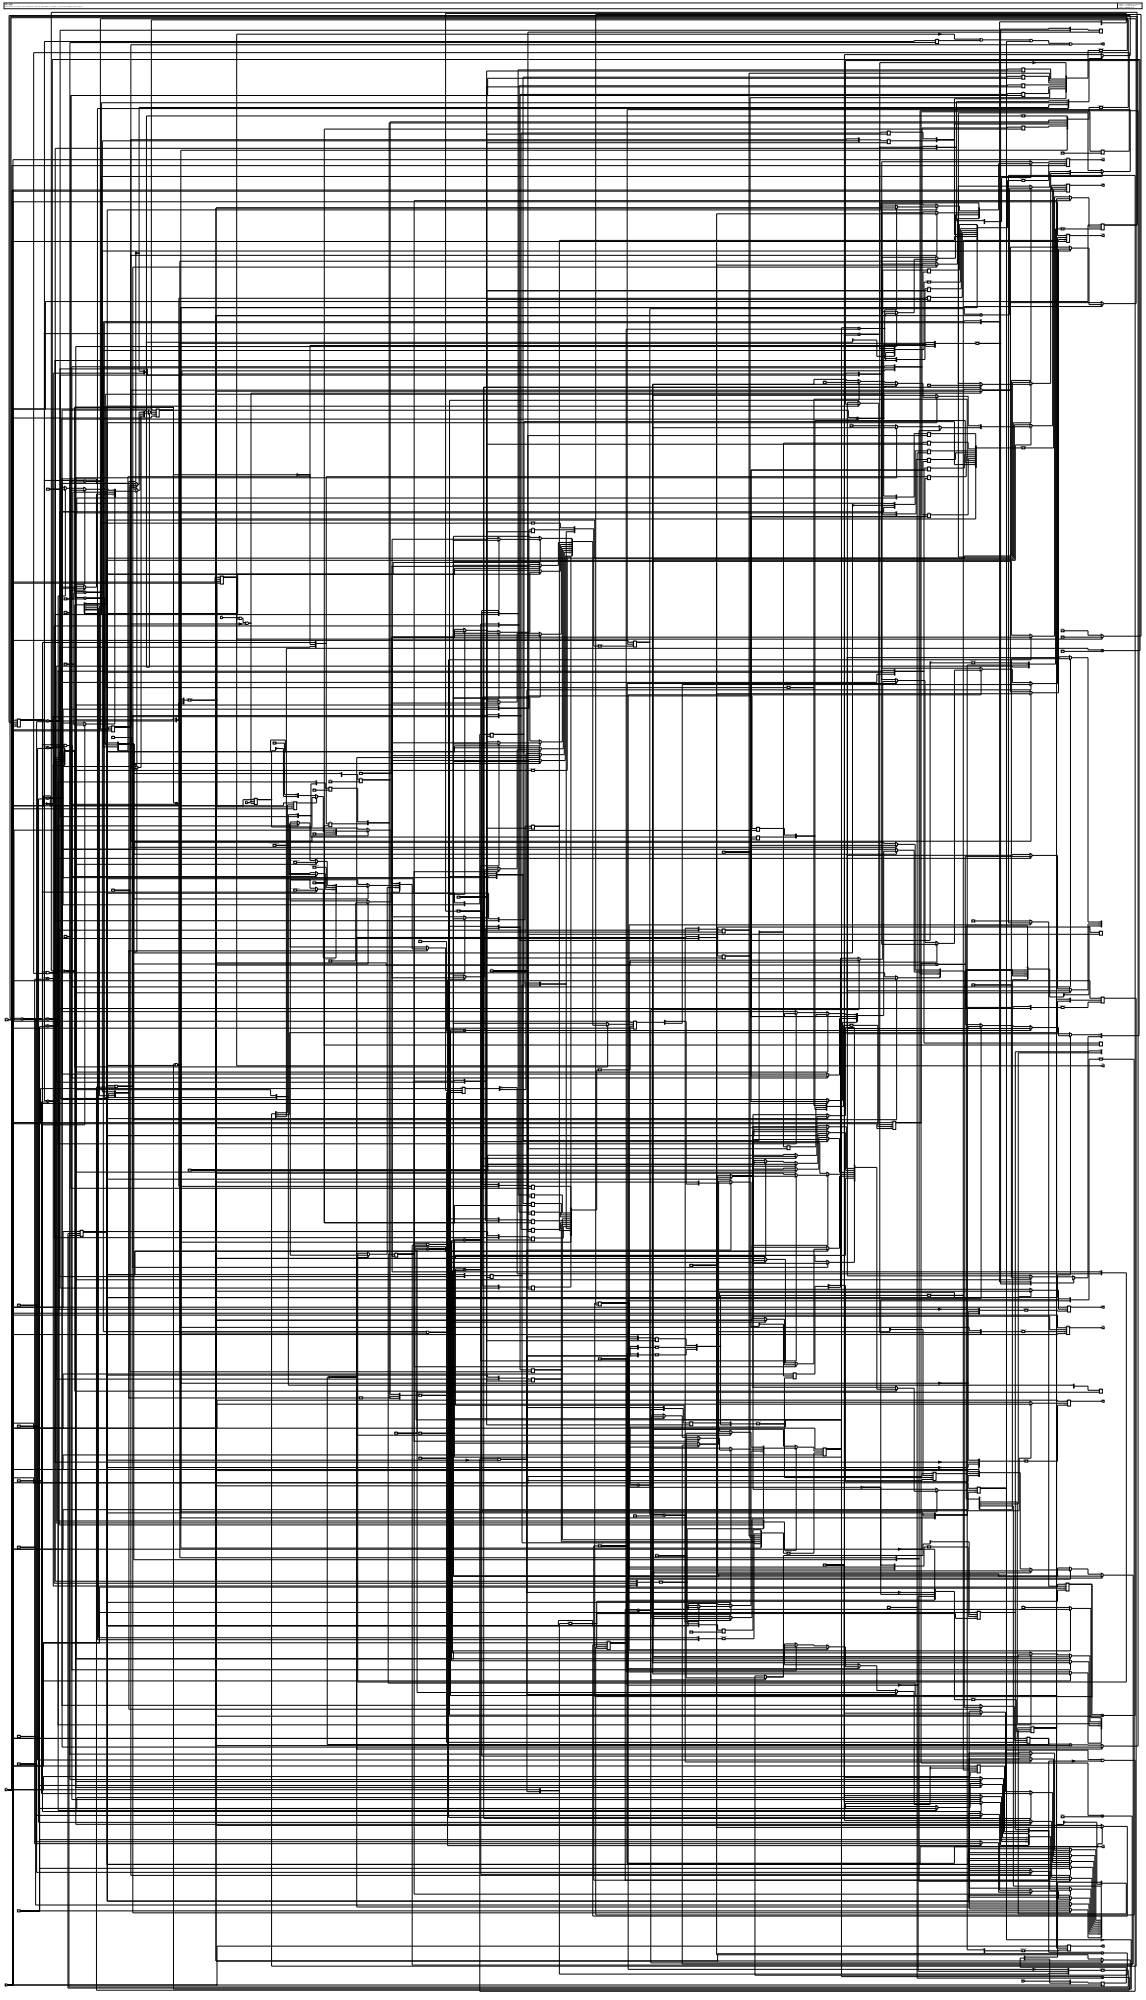
[picture p25: page 1]
$sdffe; CLK; SRST; $dffe; $sdff; $sdffce CLK; $reduce_or A Y; $reduce_bool A Y; $reduce_and A Y; clk; rst; bloque; listo; ocupado; error; codigo; dato; dato_v; fin; sd_sck; sd_mosi; sd_miso; 0xfe; 0xffff; 0xfa0; 0xff48000001aa88; 0xff400000000098

SOFIFI · esquemático generado
fuente: rtl/sd/sd_spi.v
sha256: 8b800e71e7cd

6:8
9:11

leer | 0

$sdffe CLK Q D EN SRST | 2 | $reduce_and A Y

0 $reduce_and A Y 1 2:3

0 1:3 | B | 0xff B 1 | $reduce_bool A Y $ne A Y B

0xff51 | 8:39

0xff770000000000

0xff7a0000000000 | 0x0

0xff694000000000

1:2

$reduce_and A Y

$sdffe CLK Q D EN SRST

0 1 | $reduce_or A Y | D 0:1 B

1 | $reduce_and A Y

0x1 | 0 1 0 | $ne B $reduce_bool A Y $reduce_bool A Y | 1 2 | Q

$sdff

$reduce_bool A Y

0x9 | CLK | 0x4

$sdffe CLK Q

5:9
10:14
15:19
20:24

$dffe CLK Q
