cabezoide/sofifi/schematics/top/hil_nucleo.pdf

# hil_nucleo

Verificación del núcleo en la placa (Fase 05, hardware-in-the-loop).

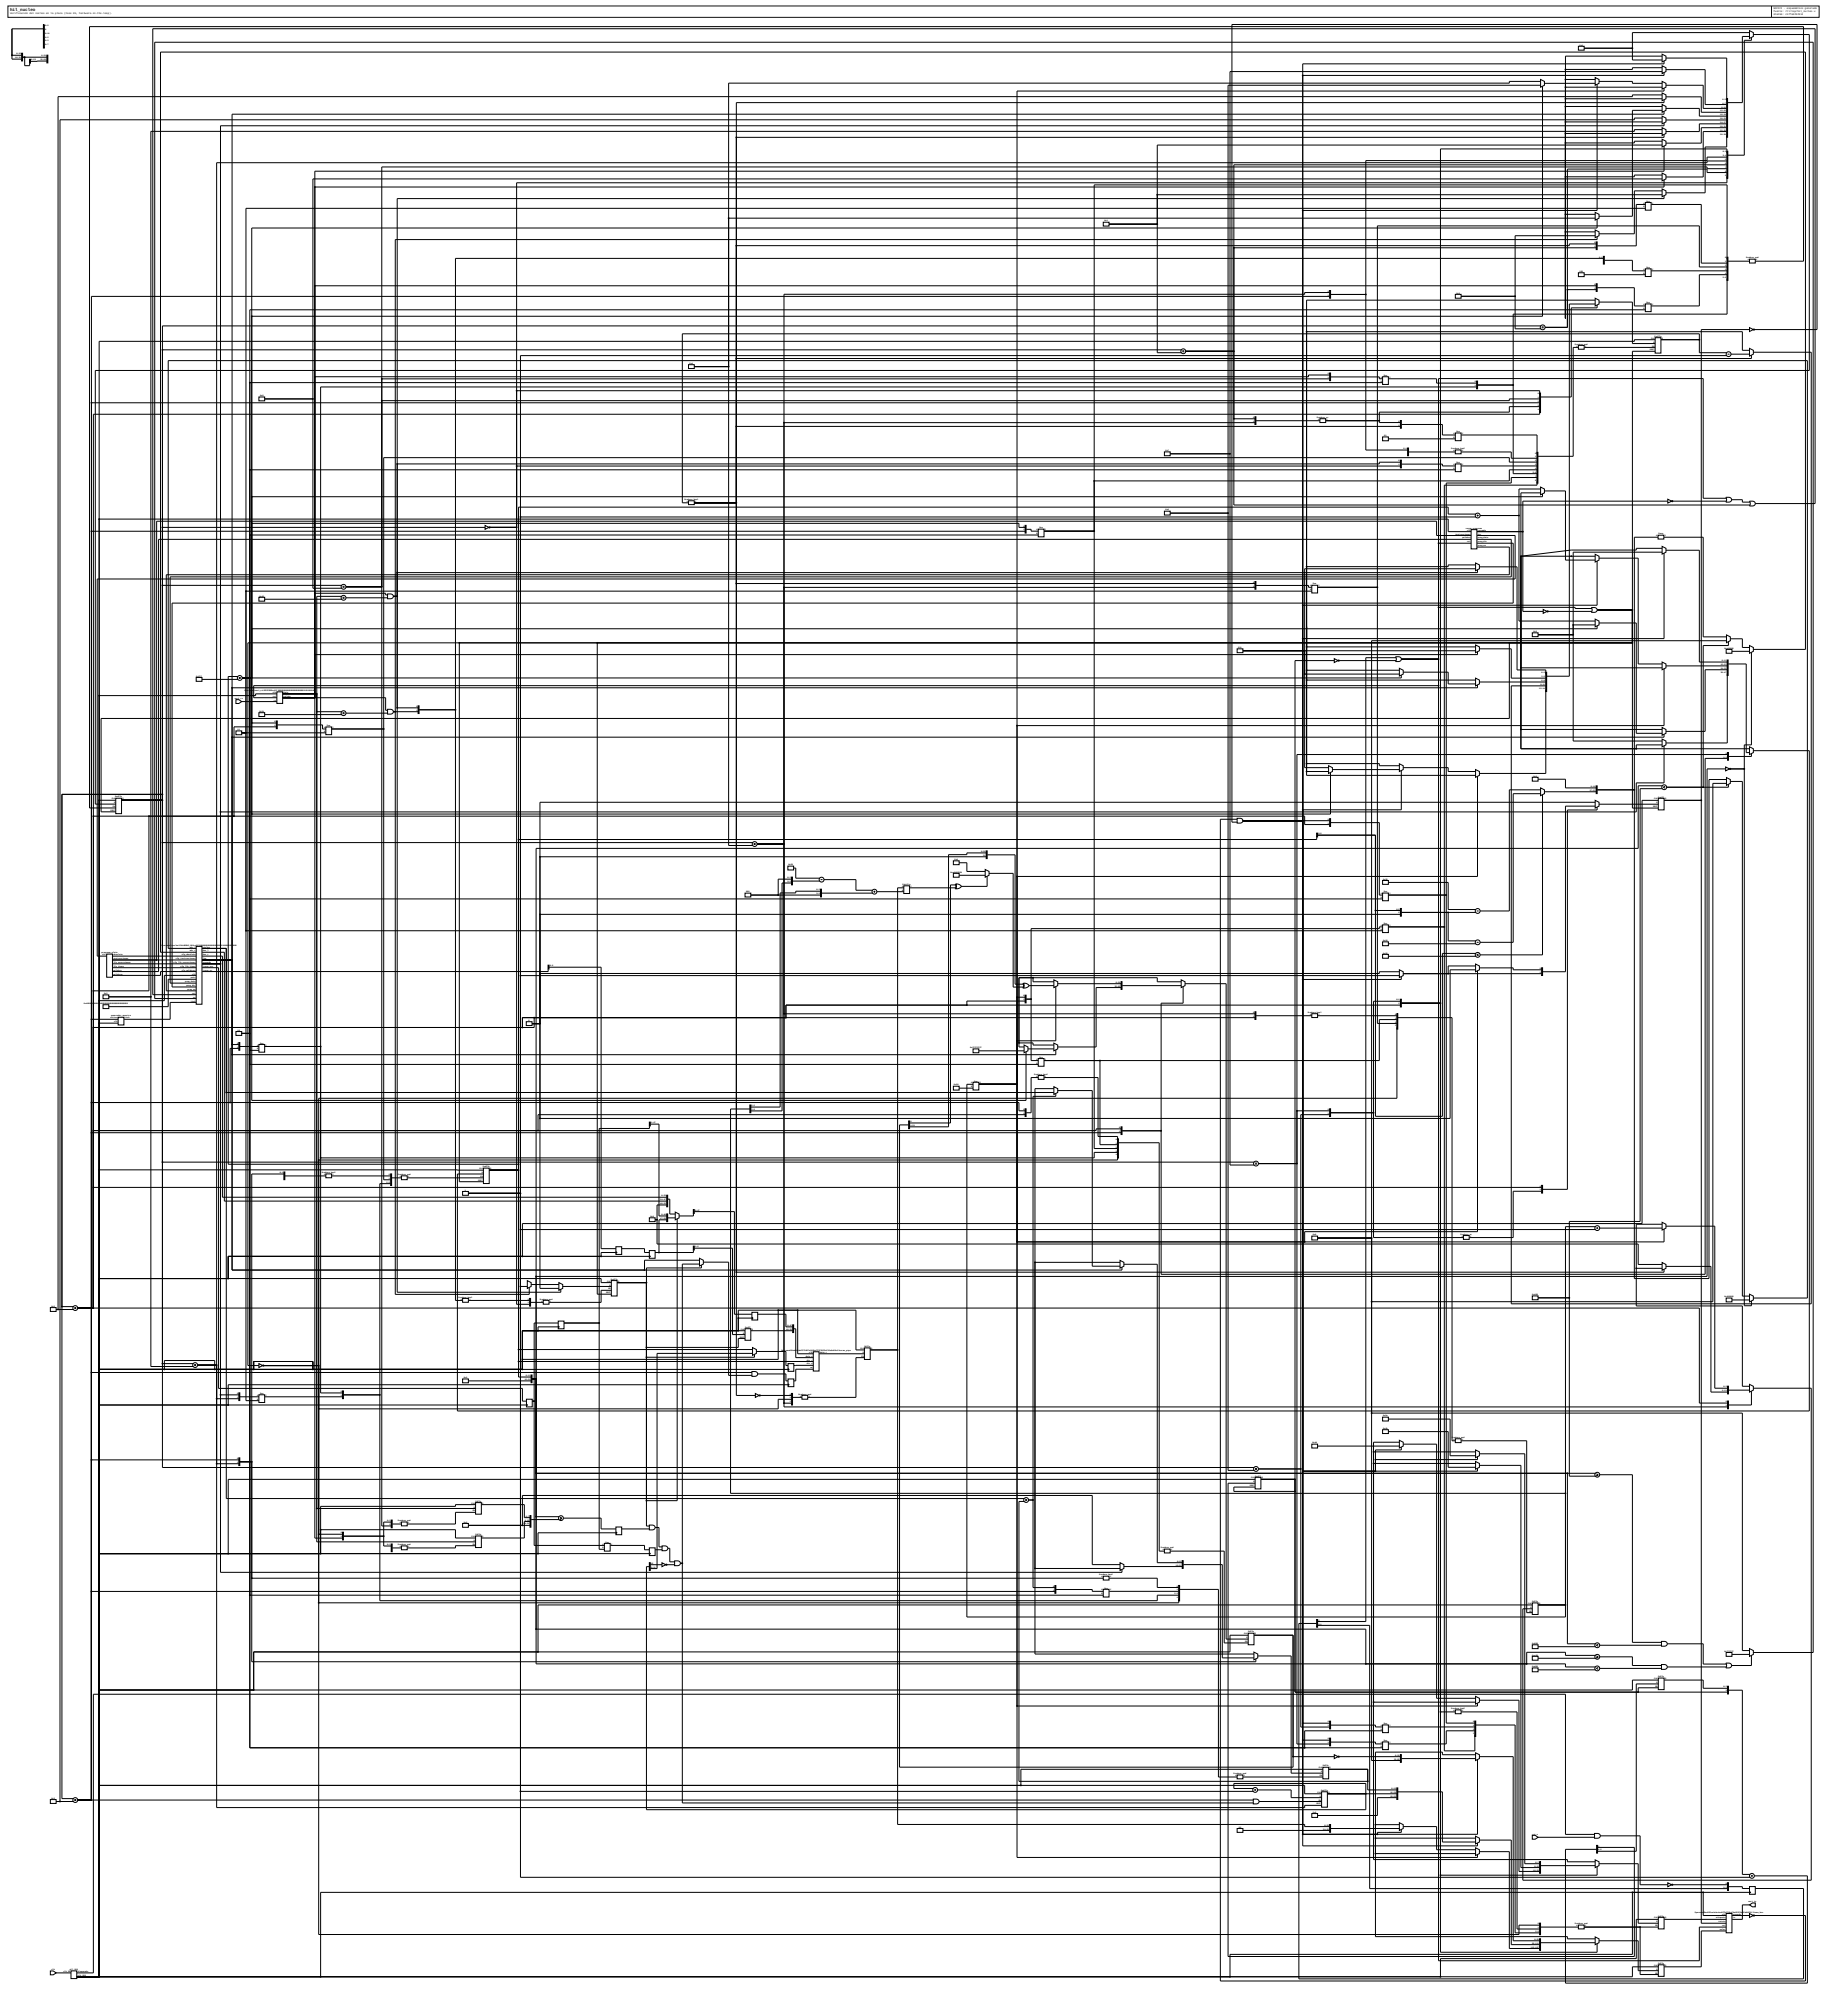
[picture p26: page 1]
$sdff; CLK; SRST; $dffe; $sdffe; $reduce_or A Y; $reduce_bool A Y; $reduce_and A Y; $shiftx A; programa_plate; dir; absoluta; instrucciones; lfo_excursiones; lfo_tipos; palabra; palabras; $paramod$4ebd45abf372d57a549be7f3f36f5ef12e8a56c4\bsram_pipe clk; dato_w; dir_r; dir_w; dato_r; carga_programa clk; rst; cargado; prog_dato; prog_dir; prog_we; generador_muestra activo; clk; tick; $paramod$ac922ca1ebc4ce9f7b278ba70e822f2a4fa8407b\linea_hex clk; etiqueta; inicio; valor; ocupado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

SOFIFI · esquemático generado
fuente: rtl/top/hil_nucleo.v
sha256: c17fa929291d

0 1 | $neg A Y

0xfff

$paramod\uart_rx\DIVISOR=s32'00000000000000000000001101100100 | rx 0x54 | 0 1

uart_rx

$reduce_bool A Y | 0 1

0 | | | 0xffffffff

$ne A Y | B $reduce_bool A Y

$dffe CLK Q

D EN SRST
