cabezoide/sofifi/schematics/nucleo/memoria_retardo.pdf

# memoria_retardo

Memoria de retardo circular del núcleo, como la del FV-1 (ADR 0004, ADR 0008).

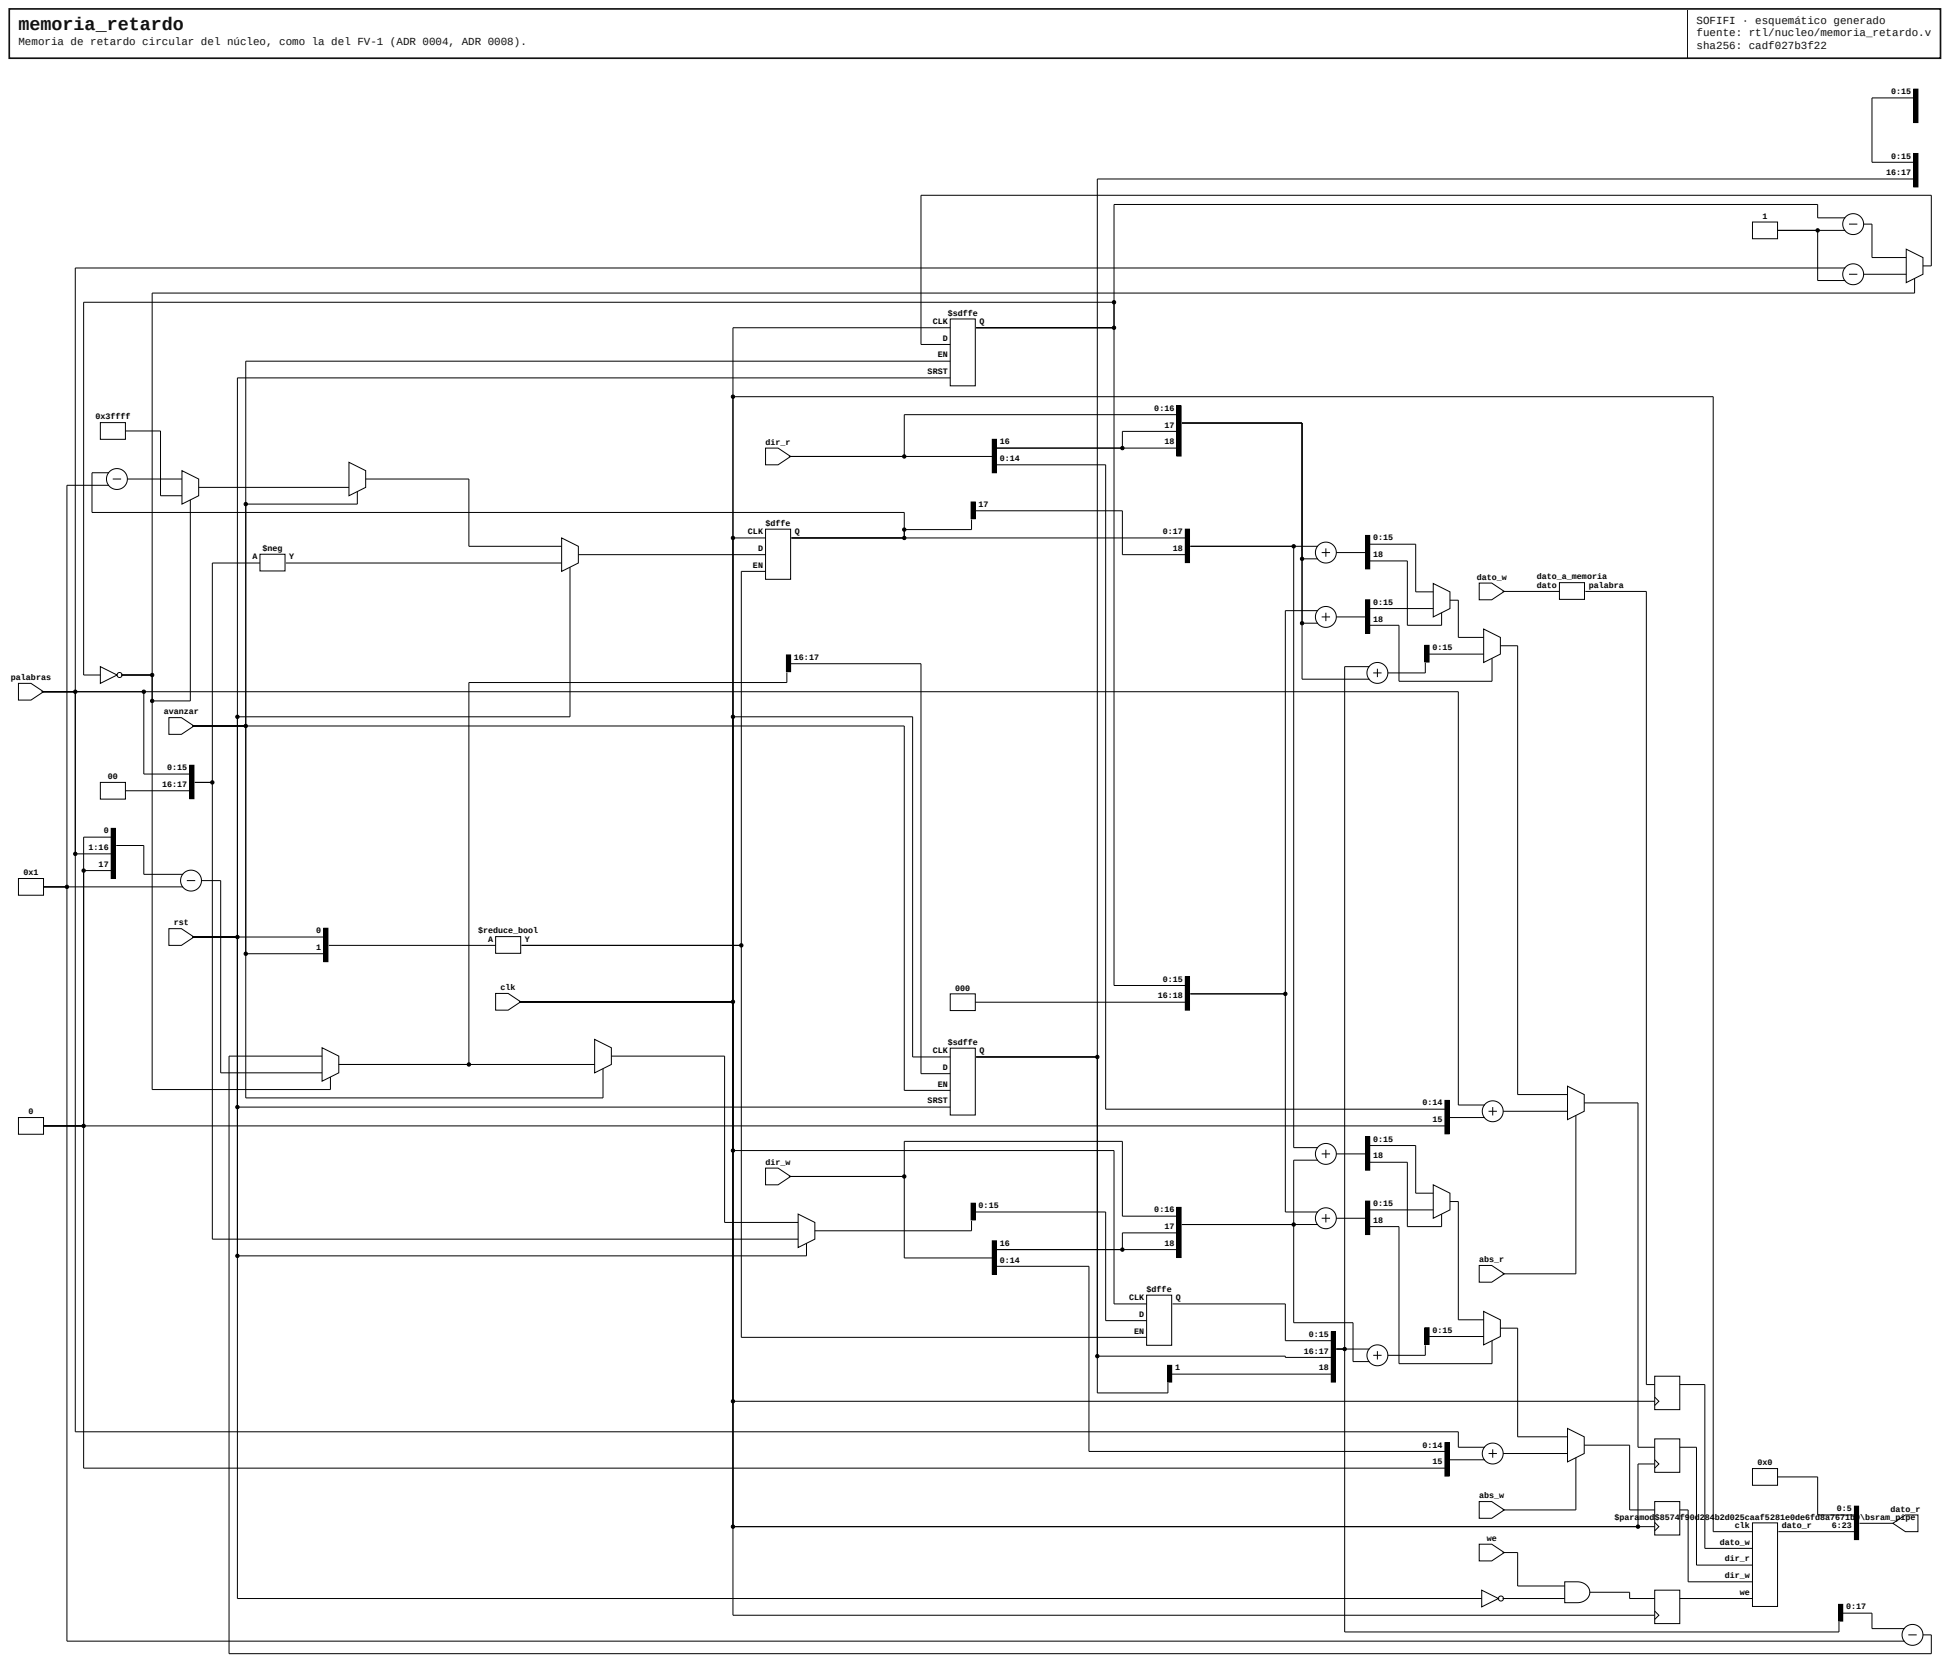
[picture p27: page 1]
$dffe; CLK; $sdffe; SRST; $reduce_bool A Y; dato_a_memoria; dato; palabra; $paramod$8574f90d284b2d025caaf5281e0de6fd8a7671b9\bsram_pipe clk; dato_w; dir_r; dir_w; dato_r; clk; rst; palabras; avanzar; abs_r; abs_w

SOFIFI · esquemático generado
fuente: rtl/nucleo/memoria_retardo.v
sha256: cadf027b3f22

0x3ffff

$neg A Y | D EN
