cabezoide/sofifi/schematics/top/nucleo_placa.pdf

# nucleo_placa

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

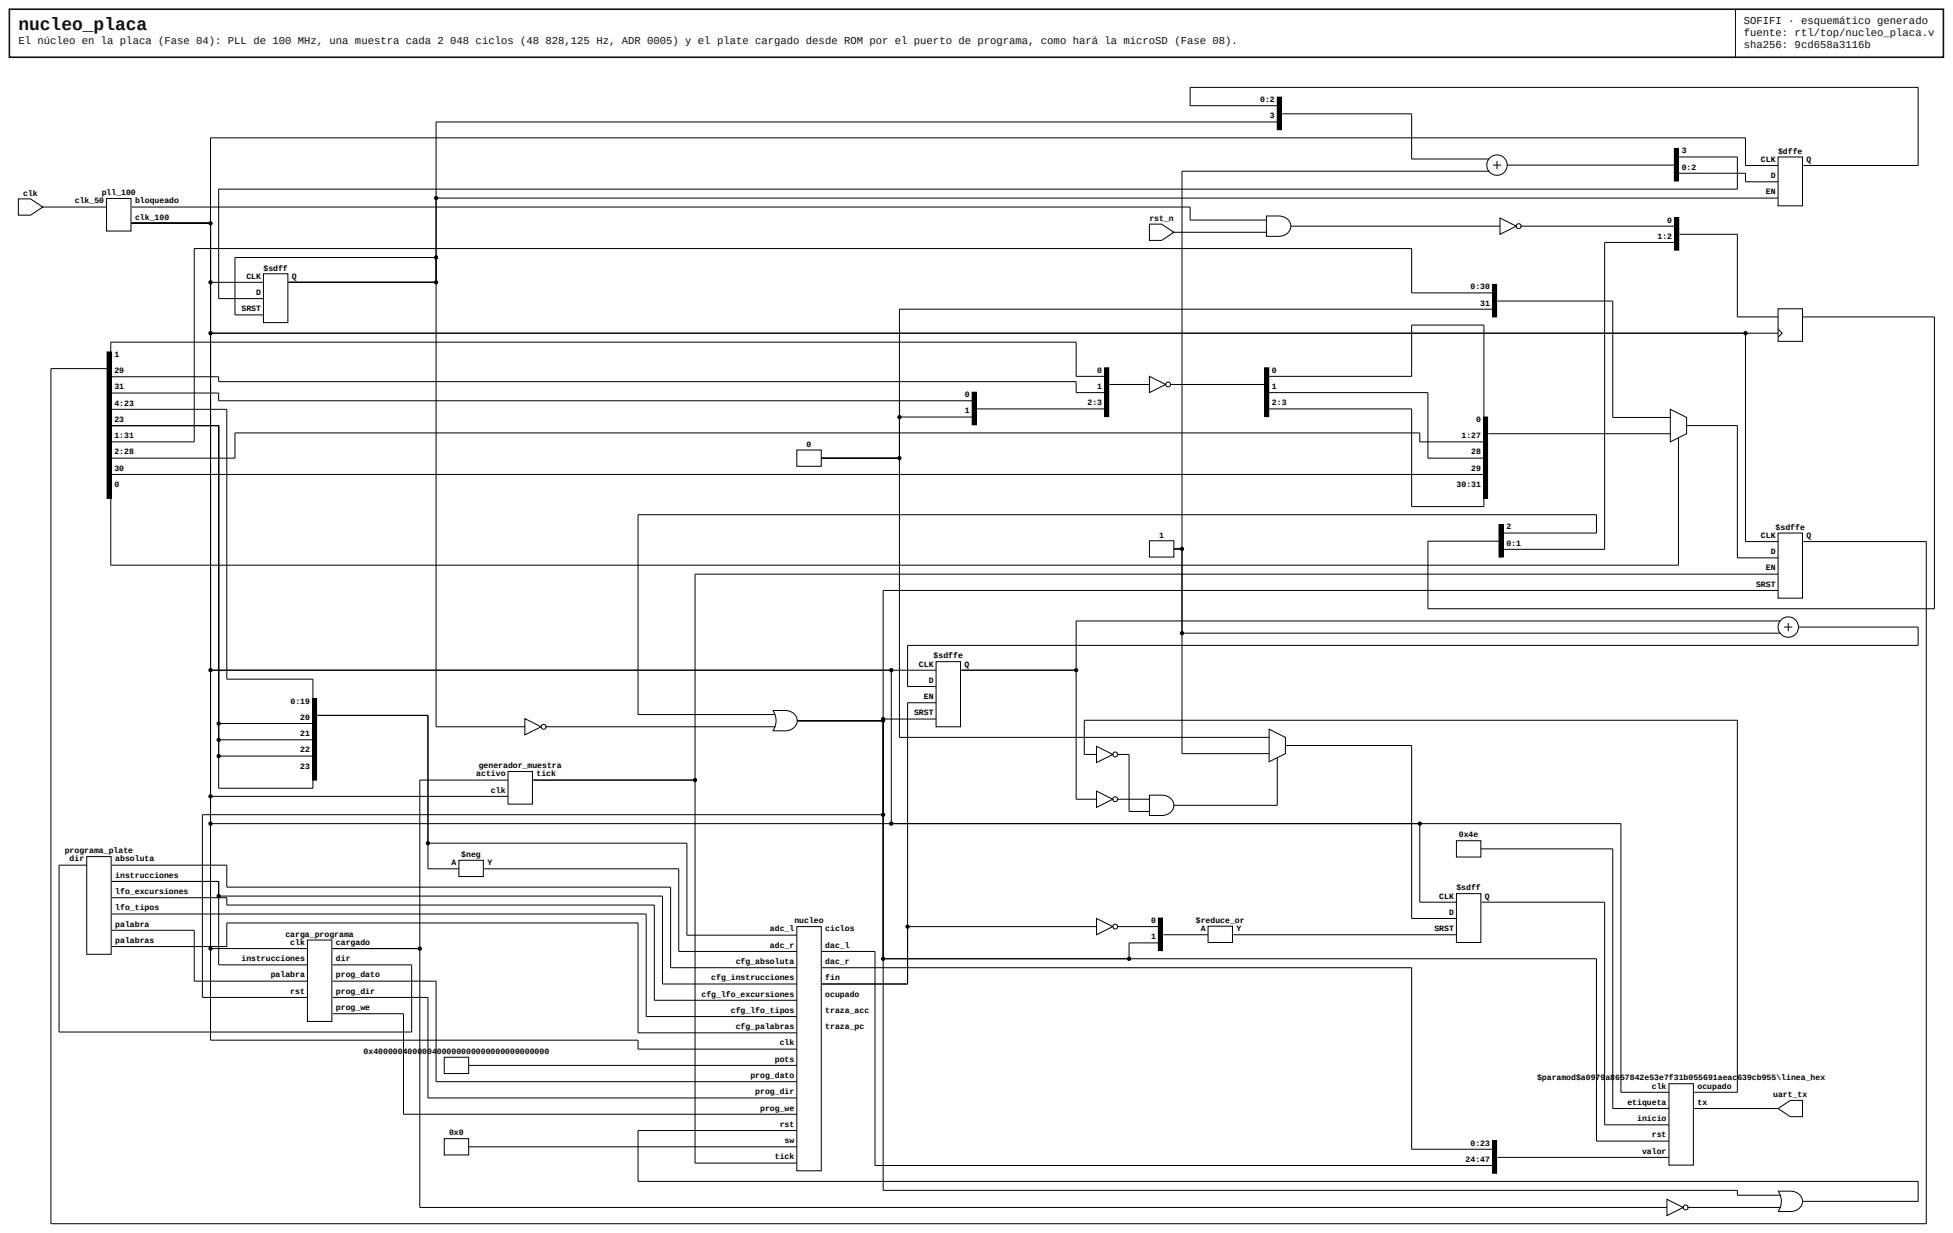
[picture p28: page 1]
$sdff; CLK; SRST; $dffe; $sdffe; $reduce_or A Y; $neg A Y; carga_programa clk; instrucciones; palabra; rst; cargado; dir; prog_dato; prog_dir; prog_we; generador_muestra activo; clk; tick; $paramod$a0979a8657842e53e7f31b055691aeac639cb955\linea_hex clk; etiqueta; inicio; valor; ocupado; nucleo; adc_l; adc_r; cfg_absoluta; cfg_instrucciones; cfg_lfo_excursiones; cfg_lfo_tipos; cfg_palabras; pots; ciclos; dac_l; dac_r; fin; traza_acc; traza_pc; pll_100; clk_50; bloqueado; clk_100; programa_plate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

SOFIFI · esquemático generado
fuente: rtl/top/nucleo_placa.v
sha256: 9cd658a3116b
