cabezoide/sofifi/schematics/comun/carga_programa.pdf

## carga_programa

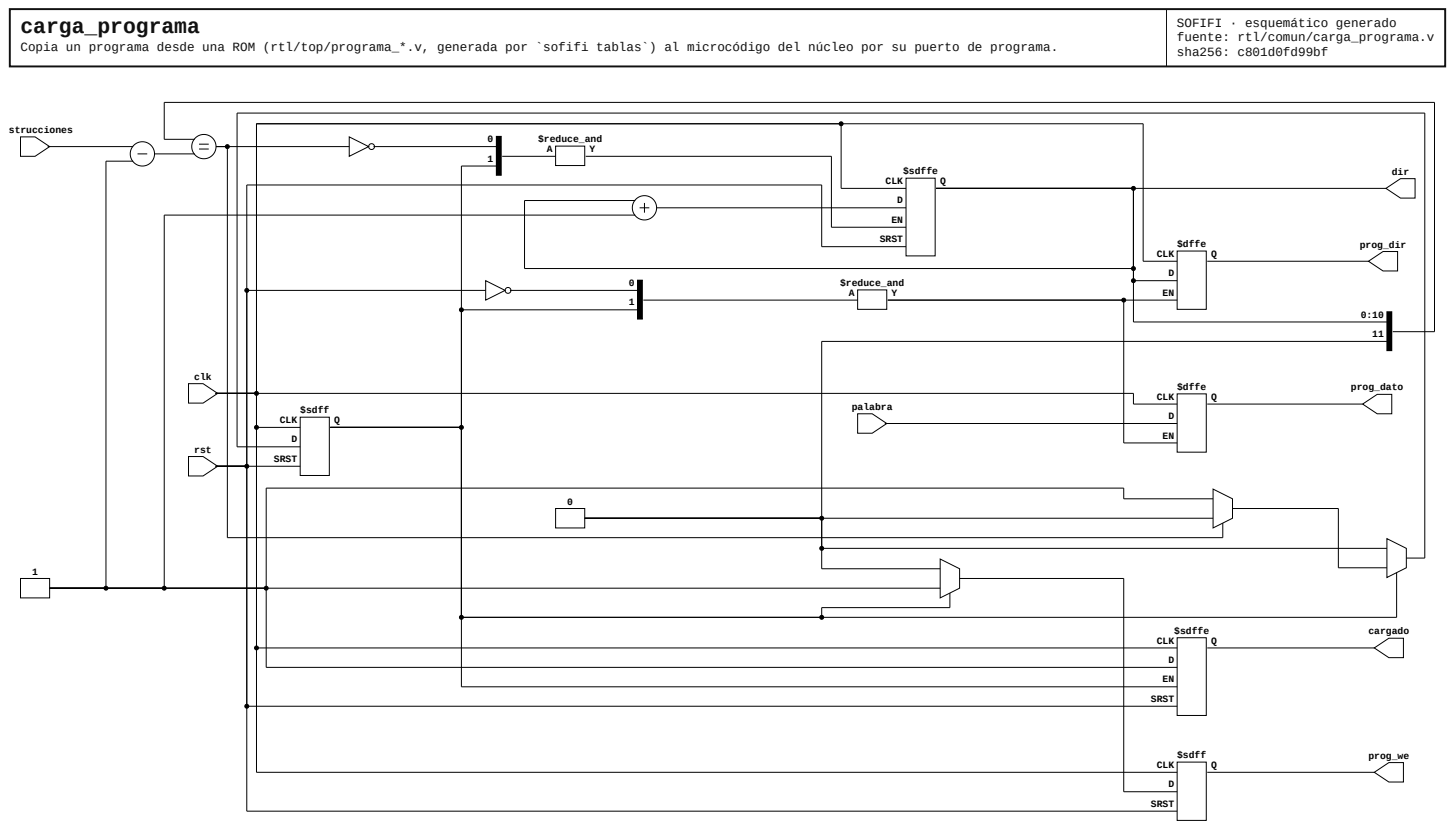
[picture p29: page 1]
$sdffe; CLK; SRST; $sdff; $dffe; $reduce_and A Y; clk; rst; strucciones; dir; palabra; prog_we; prog_dir; prog_dato; cargado

SOFIFI · esquemático generado
fuente: rtl/comun/carga_programa.v
sha256: c801d0fd99bf

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
