cabezoide/sofifi/schematics/comun/medidor_frecuencia.pdf

# medidor_frecuencia

Cuenta los ciclos de `clk_medido` durante VENTANA ciclos de `clk_ref`.

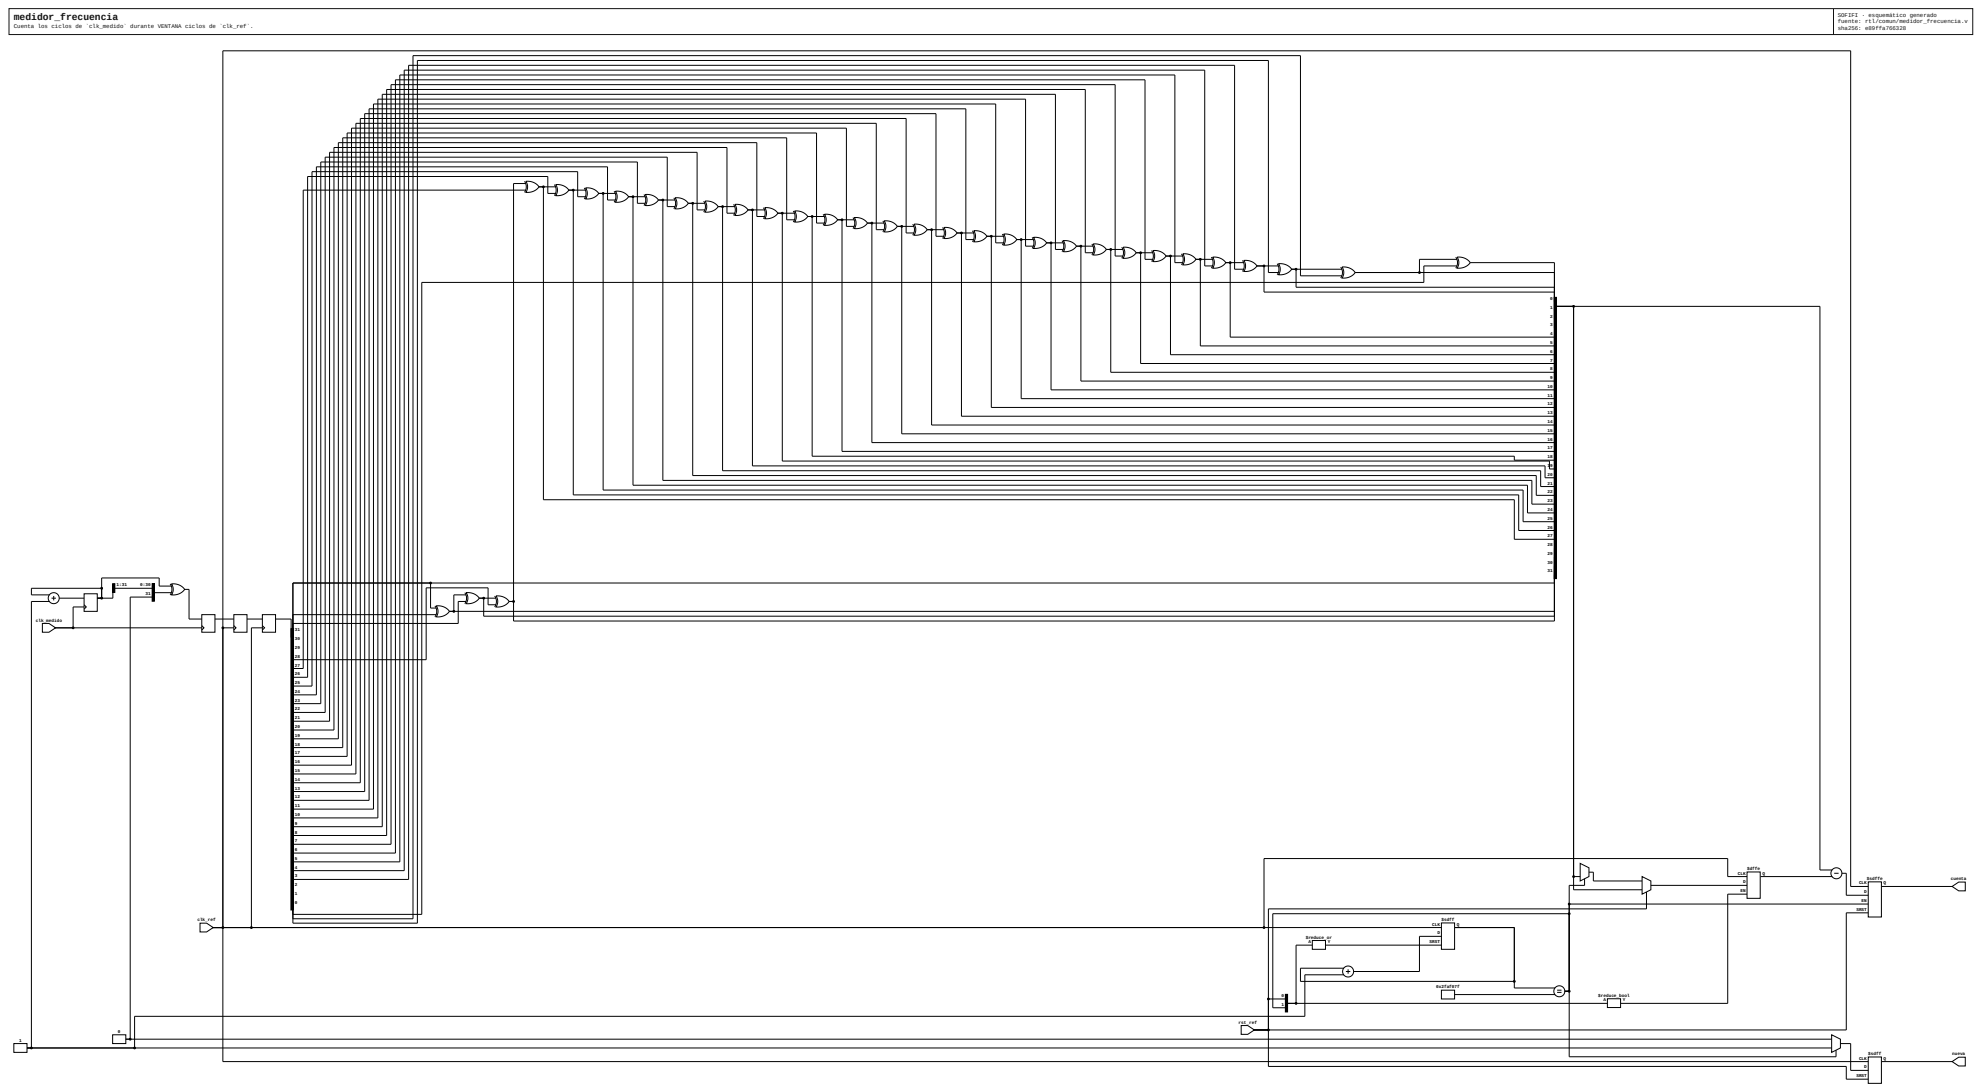
[picture p30: page 1]
$sdffe; CLKD; SRST; $sdff; $dffe; $reduce_bool A; $reduce_or A; clk_ref; rst_ref; clk_medido; cuenta; nueva; 0x2faf07f

SOFIFI · esquemático generado
fuente: rtl/comun/medidor_frecuencia.v
sha256: e89ffa766328
