cabezoide/sofifi/schematics/nucleo/acc_a_dato.pdf

## acc_a_dato

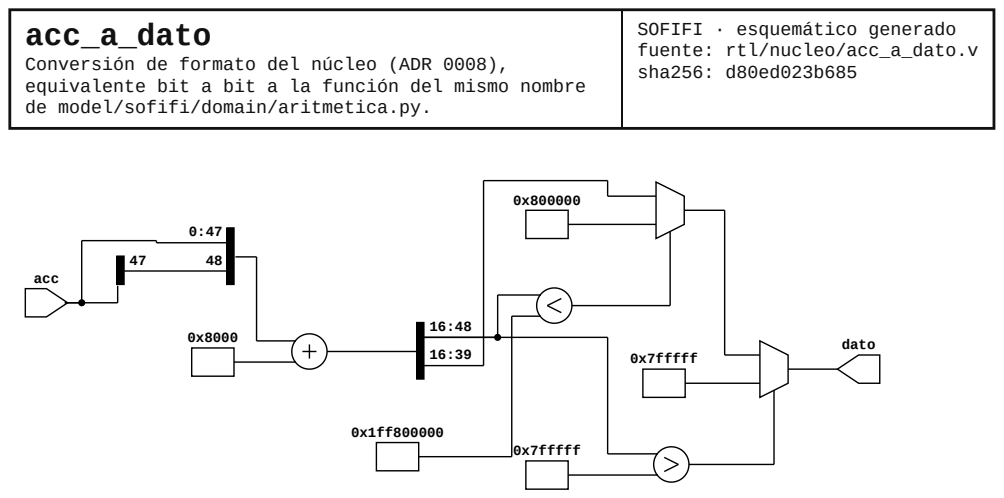
[picture p31: page 1]
acc; dato 0x8000; 0x7fffff

SOFIFI · esquemático generado
fuente: rtl/nucleo/acc_a_dato.v
sha256: d80ed023b685

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
