cabezoide/sofifi/schematics/nucleo/curva_fin.pdf

# curva_fin

### Último paso de curva_suave

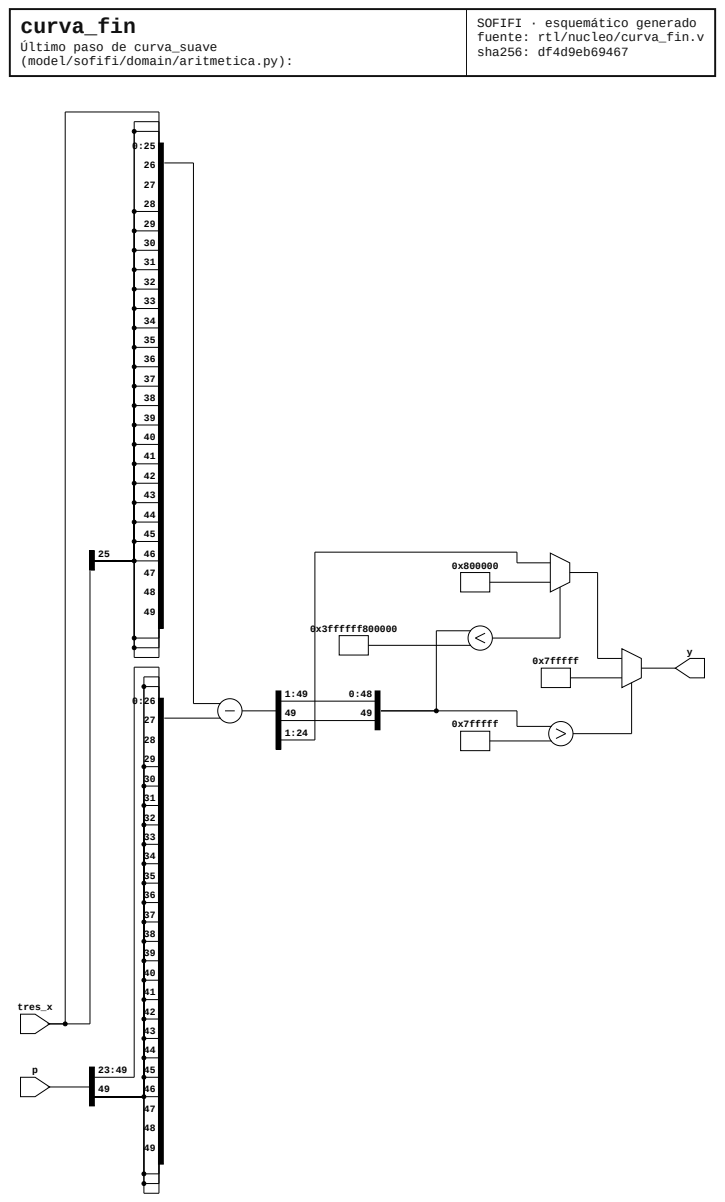
[picture p32: page 1]
tres_x; 0x7fffff; 0x3ffffff800000

SOFIFI · esquemático generado
fuente: rtl/nucleo/curva_fin.v
sha256: df4d9eb69467

(model/sofifi/domain/aritmetica.py):
