cabezoide/sofifi/schematics/nucleo/dato_a_memoria.pdf

## dato_a_memoria

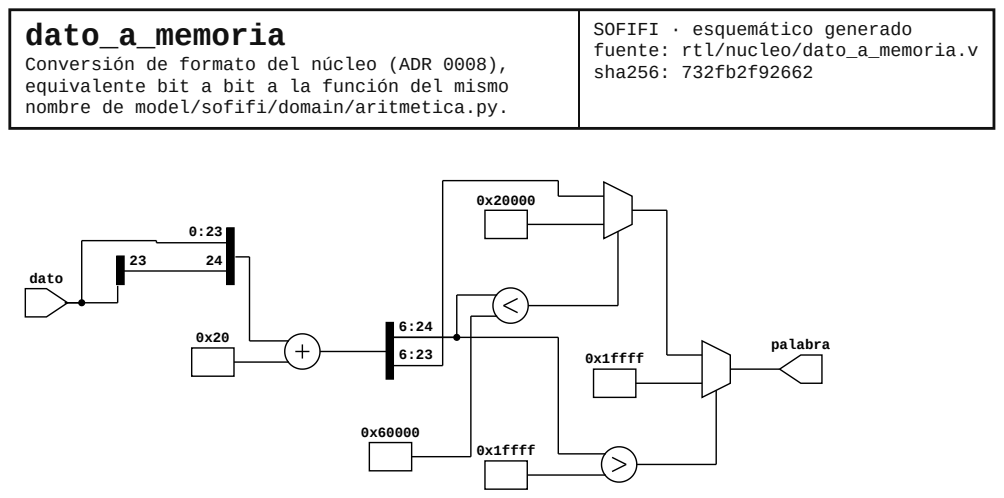
[picture p33: page 1]
dato; palabra 0x20; 0x1ffff

SOFIFI · esquemático generado
fuente: rtl/nucleo/dato_a_memoria.v
sha256: 732fb2f92662

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
