cabezoide/sofifi/schematics/nucleo/lfo_banco.pdf

# lfo_banco

Los 4 LFO del núcleo (ADR 0008).

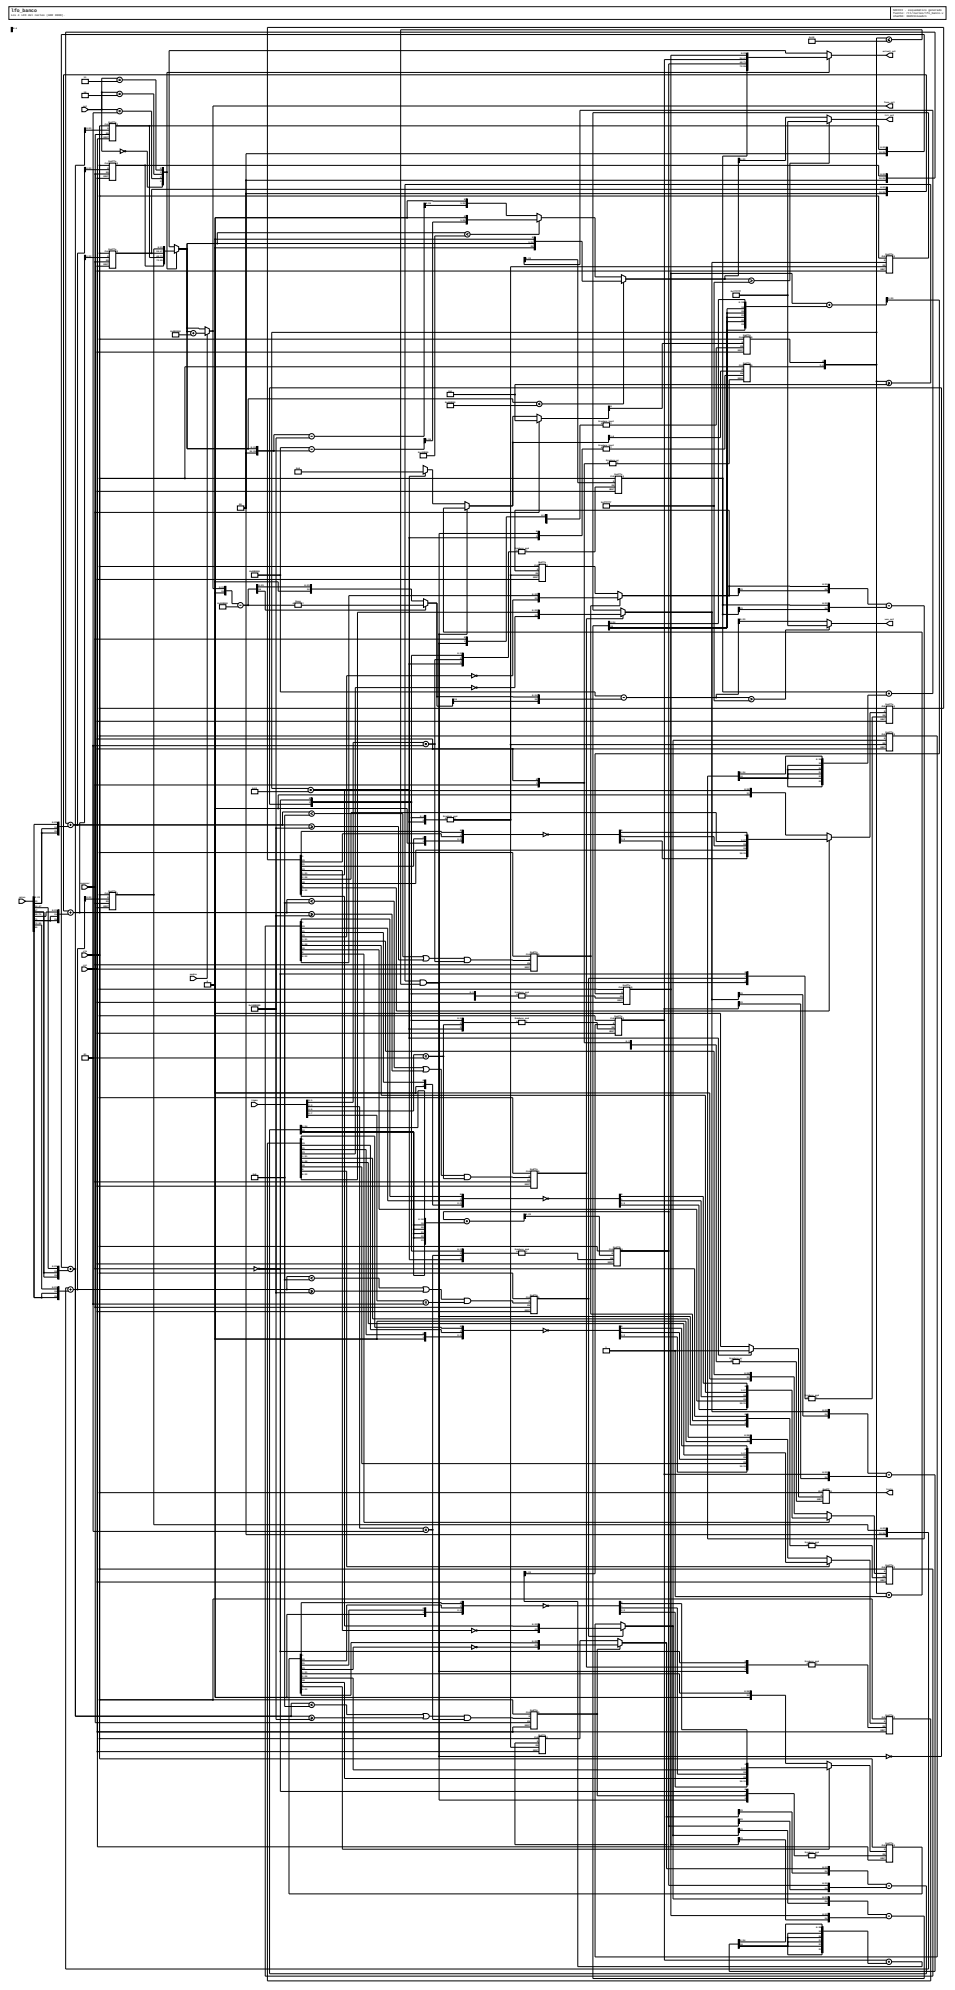
[picture p34: page 1]
$sdffe; SRST; CLK; $sdff; $reduce_bool A Y; $reduce_and A Y; $reduce_or A Y; $neg A Y; clk; rst; tipos; avanzar; rates; listo; sel; media; fase_sel; tri_sel; ven_sel; actual_sel; 0x7fffff

SOFIFI · esquemático generado
fuente: rtl/nucleo/lfo_banco.v
sha256: 30d5511ea6c1

0:23
24:25

EN
SRST

0x1 | $reduce_bool A Y 1:4 $reduce_or A Y $sdffe CLK Q D EN

1 $reduce_and A Y CLK

$sdffe

CLK

D EN SRST | 30:31

CLK | 2 23

0:1 | $reduce_and A Y | D

0:1 2 | $reduce_and A Y

0:23 | EN SRST

0:1 2 3 | $reduce_and A Y EN SRST
