cabezoide/sofifi/schematics/primitivas/bsram_bloque.pdf

## bsram_bloque

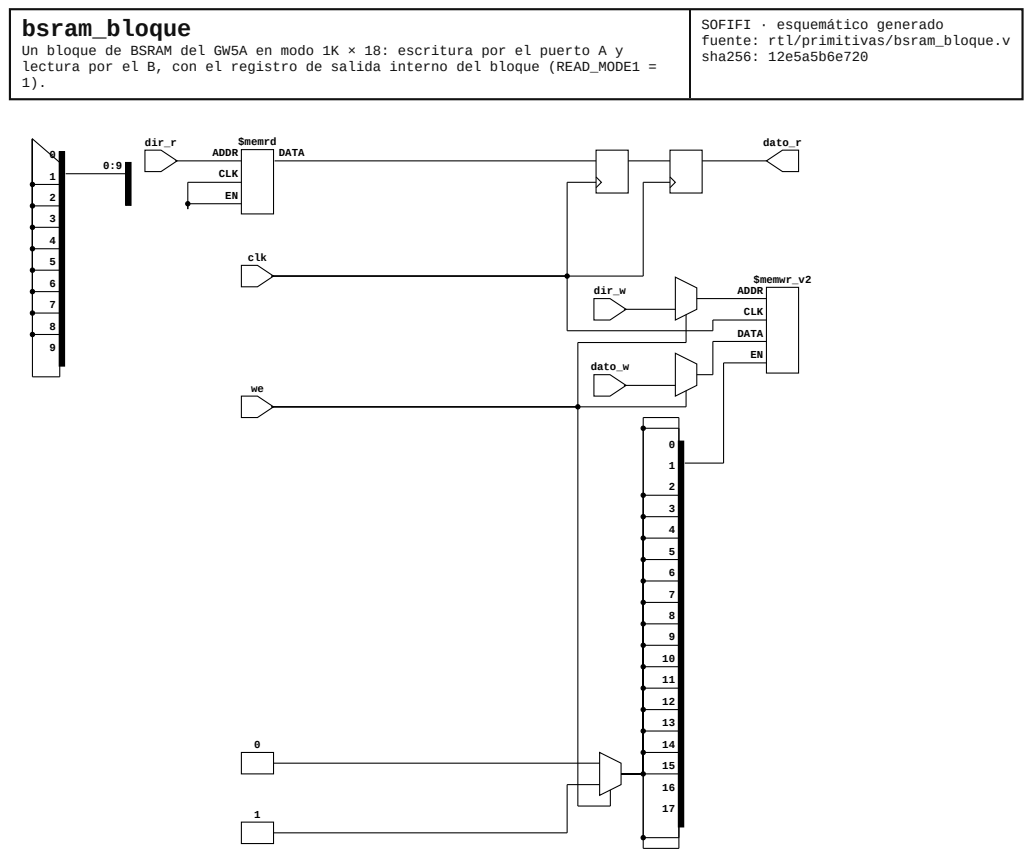
[picture p35: page 1]
$memwr_v2 ADDR; CLK; DATA; $memrd; ADDR; clk; dir_w; dato_w; dir_r; dato_r

SOFIFI · esquemático generado
fuente: rtl/primitivas/bsram_bloque.v
sha256: 12e5a5b6e720

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
