cabezoide/sofifi/schematics/primitivas/bsram_dp.pdf

## bsram_dp

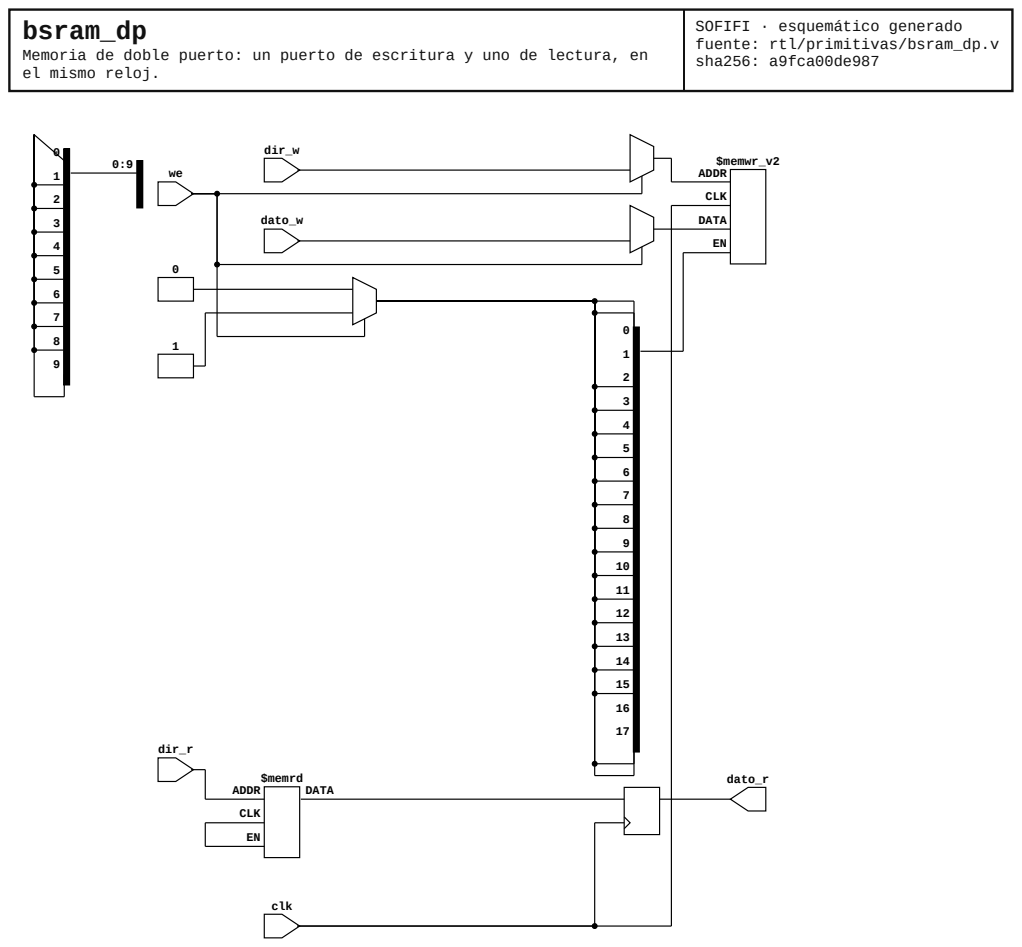
[picture p36: page 1]
$memwr_v2 ADDR; CLK; DATA; $memrd; ADDR; clk; dir_w; dato_w; dir_r; dato_r

SOFIFI · esquemático generado
fuente: rtl/primitivas/bsram_dp.v
sha256: a9fca00de987

Memoria de doble puerto: un puerto de escritura y uno de lectura, en
el mismo reloj.
