cabezoide/sofifi/schematics/top/prueba_bsram.pdf

# prueba_bsram

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

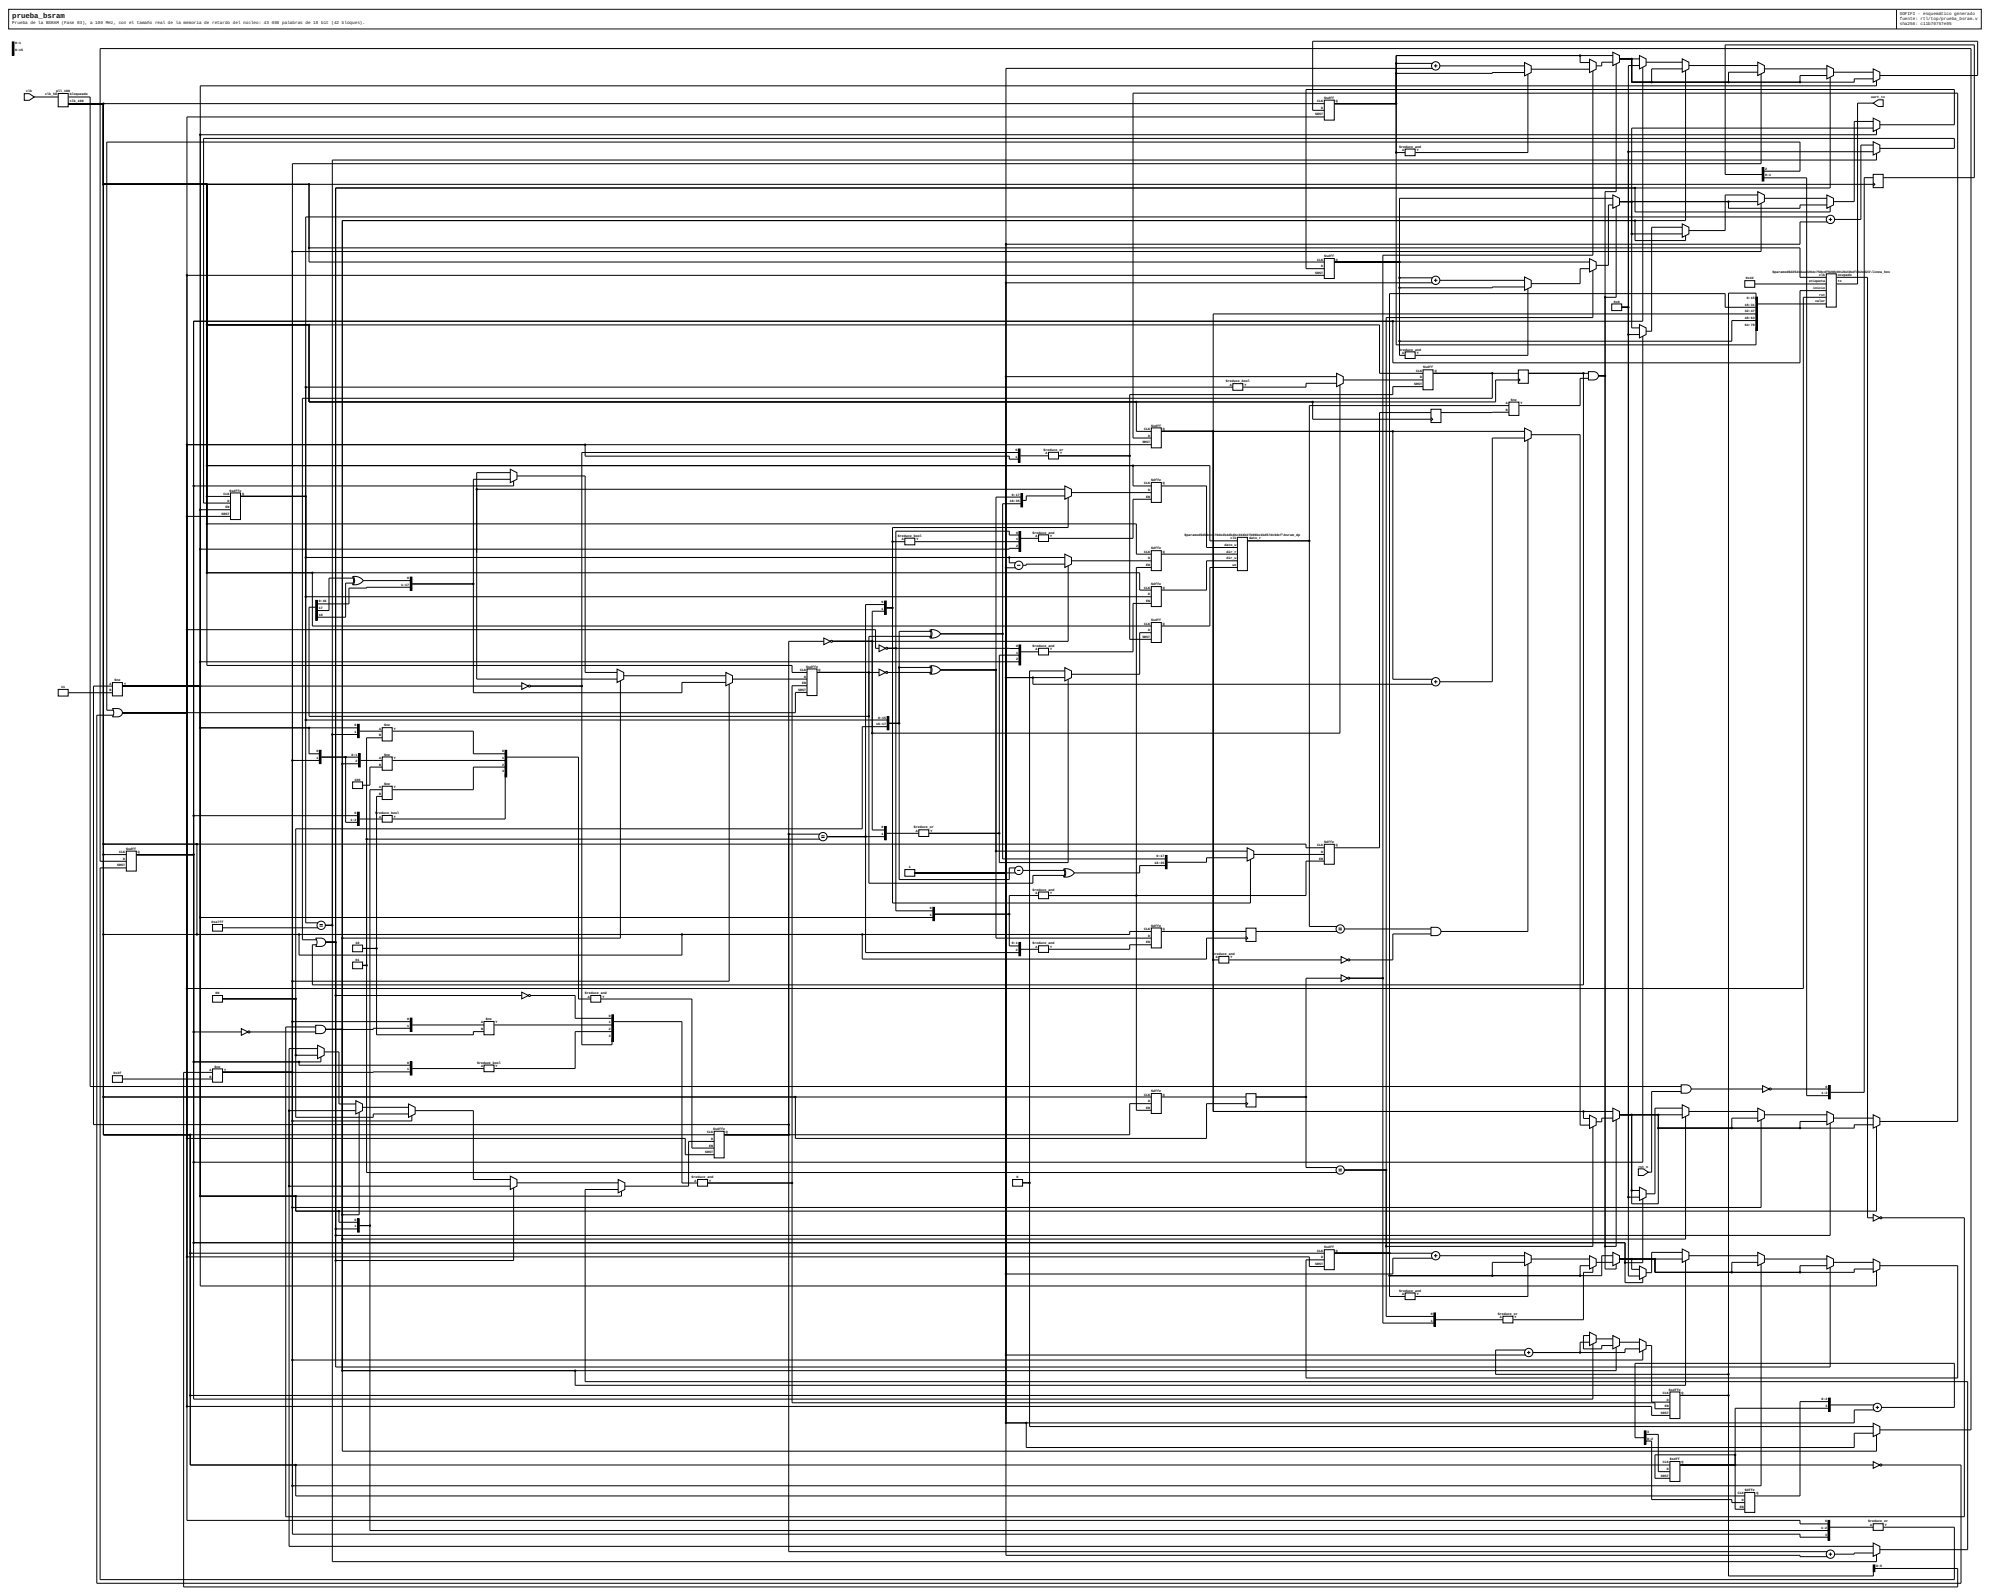
[picture p37: page 1]
$dffe; CLK; $sdffe; SRST; $sdff; $reduce_or A Y; $reduce_bool A Y; $reduce_and; $reduce_and A Y; $paramod$d252c4aa2264c758cdf920b3912b23b4f3b2ed23\linea_hex clk; etiqueta; inicio; rst; valor; ocupado; $paramod$db9ecc70de2b4db4bc2d4b27b96be1bd57dc92cf\bsram_dp clk; dato_w; dir_r; dir_w; dato_r; pll_100; clk_50; bloqueado; clk_100; clk; rst_n; uart_tx

SOFIFI · esquemático generado
fuente: rtl/top/prueba_bsram.v
sha256: c11b70757e05

0 $reduce_or A Y | SRST

$sdffe CLK Q D EN SRST

1 | $reduce_or A Y

$sdff CLK Q D SRST | | 0xa7ff | 1 | 0:17 18:35
