cabezoide/sofifi/schematics/top/prueba_dsp.pdf

# prueba_dsp

Prueba del bloque DSP (Fase 03), a 100 MHz.

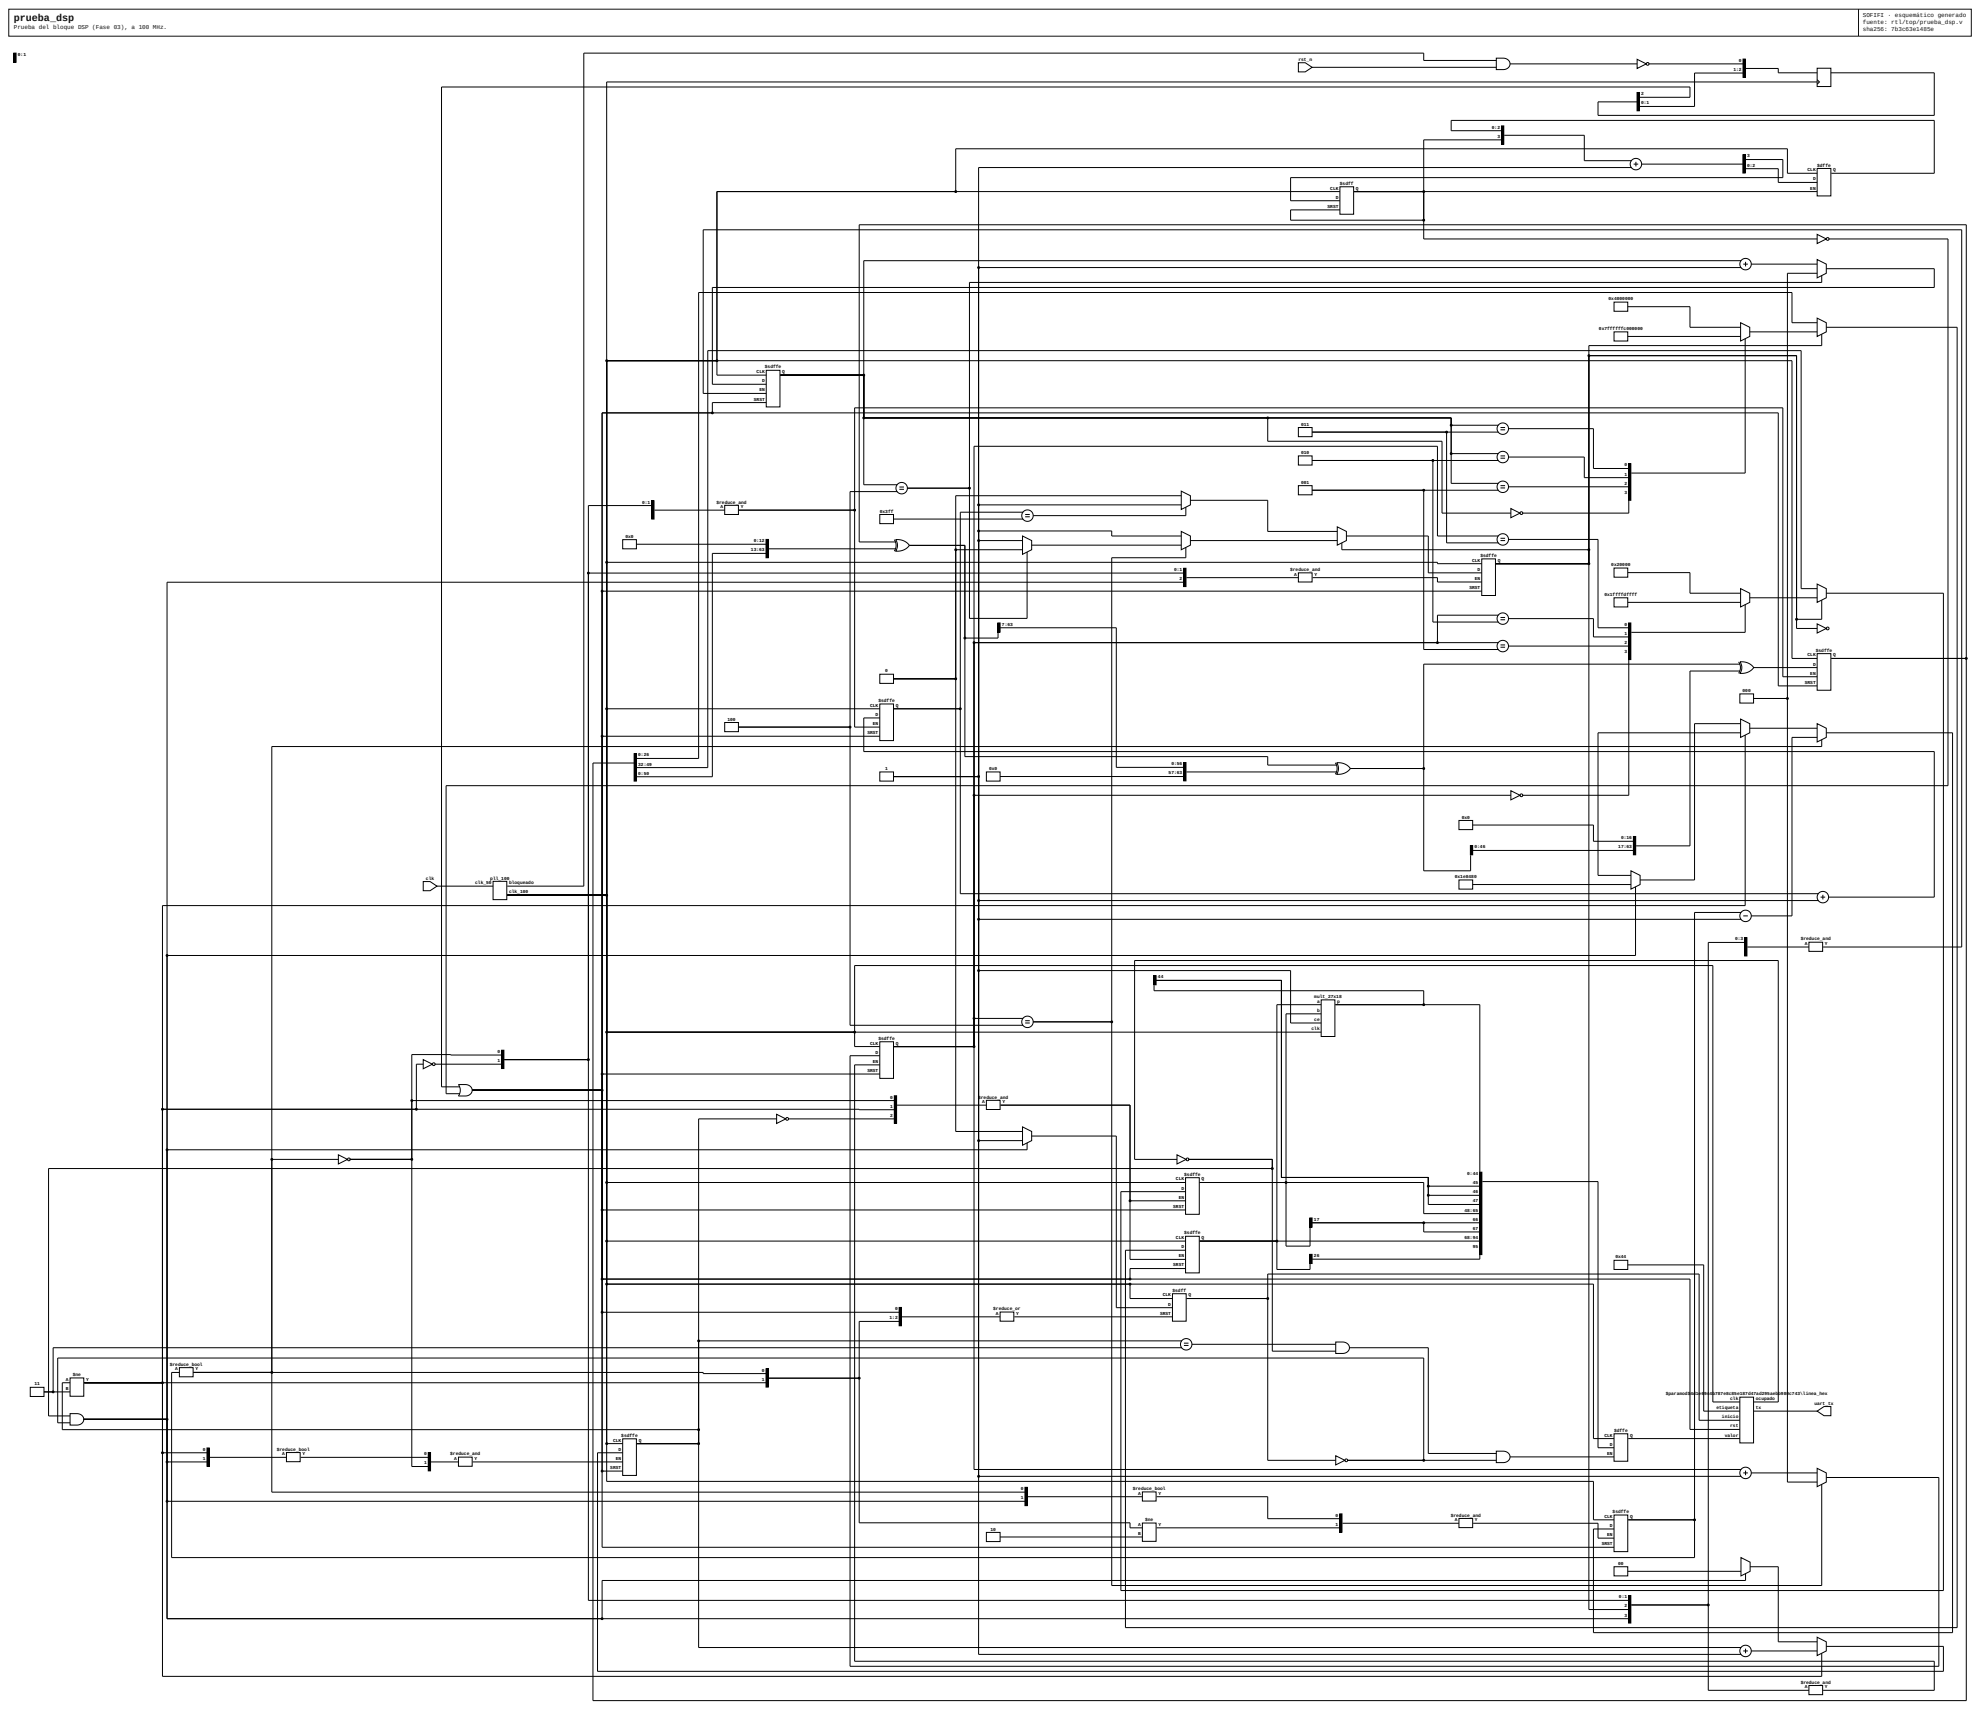
[picture p38: page 1]
$sdff; CLK; SRST; $dffe; $sdffe; $reduce_bool A Y; $reduce_and; $reduce_and A Y; $reduce_or A Y; $paramod$4d1e6944b787e8c85e187d47ad295aebb980c743\linea_hex clk; etiqueta; inicio; rst; valor; ocupado; mult_27x18 a; clk; pll_100; clk_50; bloqueado; rst_n; uart_tx; 0x1ffffdffff; 0x7ffffffc000000

SOFIFI · esquemático generado
fuente: rtl/top/prueba_dsp.v
sha256: 7b3c63e1485e

EN SRST

clk_100 | | | 0x0

clk

CLK

$reduce_bool | A Y | | | | 0 1

$sdffe CLK Q D EN SRST

0 1 | $reduce_bool A Y $ne B | A Y

0:1
