cabezoide/sofifi/schematics/top/prueba_pll.pdf

# prueba_pll

Prueba del PLL (Fase 03).

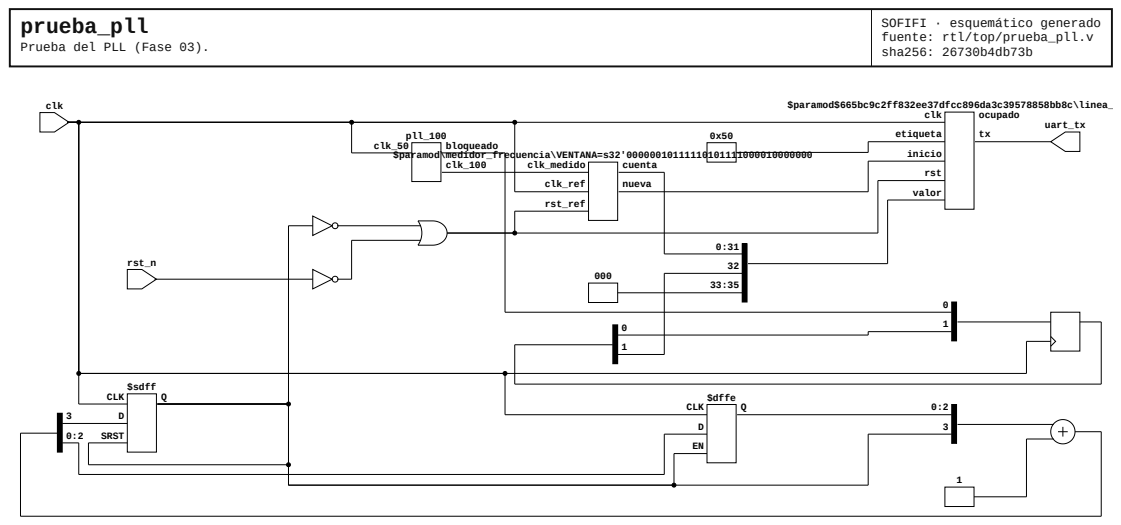
[picture p39: page 1]
$sdff; CLK; SRST; Q $dffe CLK; $paramod$665bc9c2ff832ee37dfcc896da3c39578858bb8c\linea_ clk; etiqueta; inicio; rst; valor; ocupado; $paramod\medidor_frecuencia\VENTANA=s32'00000010111110101111000010000000 clk_medido; clk_ref; rst_ref; cuenta; nueva; pll_100; clk_50; bloqueado; clk_100; clk; rst_n; uart_tx

SOFIFI · esquemático generado
fuente: rtl/top/prueba_pll.v
sha256: 26730b4db73b
