cabezoide/sofifi/rtl/nucleo/tabla_hermite.v

// SPDX-License-Identifier: MIT
//
// GENERADO por `sofifi tablas` desde model/sofifi/domain/interpolacion.py.
// No se edita a mano: model/tests/tablas_test.py compara este fichero con su
// generador. Coeficientes Hermite S1.16 para la fracción frac/256:
// coefs = {c0, c1, c2, c3}, y = c0·x[-1] + c1·x0 + c2·x1 + c3·x2.
`default_nettype none

module tabla_hermite (
    input  wire [7:0]  frac,
    output reg  [71:0] coefs
);
    always @(*) begin
        // En lógica: en BSRAM (SPX9) daba violaciones de hold en sus
        // direcciones. El atributo va en el case, de donde Yosys saca la ROM.
        (* rom_style = "logic" *)
        case (frac)
            8'd0: coefs = 72'h000010000000000000;
            8'd1: coefs = 72'hffe04fffe002080000;
            8'd2: coefs = 72'hffc10fff600423fffe;
            8'd3: coefs = 72'hffa24ffea0064bfffc;
            8'd4: coefs = 72'hff840ffd800883fff8;
            8'd5: coefs = 72'hff664ffc200ac7fff4;
            8'd6: coefs = 72'hff490ffa700d1fffee;
            8'd7: coefs = 72'hff2c0ff8800f83ffe8;
            8'd8: coefs = 72'hff0fcff63011f7ffe1;
            8'd9: coefs = 72'hfef40ff3a0147bffd9;
            8'd10: coefs = 72'hfed88ff0c0170bffd0;
            8'd11: coefs = 72'hfebd8fed9019abffc6;
            8'd12: coefs = 72'hfea34fea201c5bffbb;
            8'd13: coefs = 72'hfe894fe6601f17ffb0;
            8'd14: coefs = 72'hfe6fcfe26021e3ffa3;
            8'd15: coefs = 72'hfe568fde1024bbff96;
            8'd16: coefs = 72'hfe3e0fd98027a3ff88;
            8'd17: coefs = 72'hfe25cfd4a02a97ff79;
            8'd18: coefs = 72'hfe0e4fcf802d9bff69;
            8'd19: coefs = 72'hfdf70fca2030abff59;
            8'd20: coefs = 72'hfde00fc47033c7ff48;
            8'd21: coefs = 72'hfdc9cfbe8036f3ff36;
            8'd22: coefs = 72'hfdb3cfb8403a2bff23;
            8'd23: coefs = 72'hfd9e4fb1d03d6fff0f;
            8'd24: coefs = 72'hfd894fab1040bffefb;
            8'd25: coefs = 72'hfd748fa410441bfee6;
            8'd26: coefs = 72'hfd608f9cd04787fed0;
            8'd27: coefs = 72'hfd4ccf95504afffeba;
            8'd28: coefs = 72'hfd394f8d904e7ffea3;
            8'd29: coefs = 72'hfd264f8580520ffe8b;
            8'd30: coefs = 72'hfd13cf7d4055abfe73;
            8'd31: coefs = 72'hfd01cf74c0594ffe5a;
            8'd32: coefs = 72'hfcf00f6c005d03fe40;
            8'd33: coefs = 72'hfcdecf630060bffe26;
            8'd34: coefs = 72'hfccdcf59c0648bfe0b;
            8'd35: coefs = 72'hfcbd4f5050685ffdef;
            8'd36: coefs = 72'hfcad4f46906c3ffdd3;
            8'd37: coefs = 72'hfc9d8f3ca07027fdb6;
            8'd38: coefs = 72'hfc8e4f3280741bfd99;
            8'd39: coefs = 72'hfc7f4f2810781bfd7b;
            8'd40: coefs = 72'hfc70cf1d707c27fd5d;
            8'd41: coefs = 72'hfc628f1290803bfd3e;
            8'd42: coefs = 72'hfc54cf0780845bfd1f;
            8'd43: coefs = 72'hfc478efc308883fcff;
            8'd44: coefs = 72'hfc3a8ef0b08cb7fcde;
            8'd45: coefs = 72'hfc2dcee4f090f3fcbd;
            8'd46: coefs = 72'hfc218ed900953bfc9c;
            8'd47: coefs = 72'hfc158ecce0998bfc7a;
            8'd48: coefs = 72'hfc0a0ec0809de3fc58;
            8'd49: coefs = 72'hfbfeceb3f0a247fc35;
            8'd50: coefs = 72'hfbf40ea720a6b3fc12;
            8'd51: coefs = 72'hfbe98e9a30ab27fbef;
            8'd52: coefs = 72'hfbdf4e8d00afa3fbcb;
            8'd53: coefs = 72'hfbd58e7fa0b42bfba6;
            8'd54: coefs = 72'hfbcc0e7210b8b7fb82;
            8'd55: coefs = 72'hfbc30e6440bd4ffb5c;
            8'd56: coefs = 72'hfbba4e5650c1effb37;
            8'd57: coefs = 72'hfbb1ce4830c697fb11;
            8'd58: coefs = 72'hfba9ce39d0cb47faeb;
            8'd59: coefs = 72'hfba20e2b50cffffac5;
            8'd60: coefs = 72'hfb9a8e1ca0d4bbfa9e;
            8'd61: coefs = 72'hfb938e0db0d983fa77;
            8'd62: coefs = 72'hfb8ccdfea0de53fa4f;
            8'd63: coefs = 72'hfb864def70e327fa28;
            8'd64: coefs = 72'hfb800de000e803fa00;
            8'd65: coefs = 72'hfb7a4dd070ece7f9d8;
            8'd66: coefs = 72'hfb748dc0b0f1cff9b0;
            8'd67: coefs = 72'hfb6f8db0c0f6c3f987;
            8'd68: coefs = 72'hfb6a8da0a0fbbbf95e;
            8'd69: coefs = 72'hfb65cd906100b7f935;
            8'd70: coefs = 72'hfb618d800105bbf90c;
            8'd71: coefs = 72'hfb5d8d6f710ac7f8e3;
            8'd72: coefs = 72'hfb59cd5eb10fd7f8b9;
            8'd73: coefs = 72'hfb564d4dd114eff88f;
            8'd74: coefs = 72'hfb534d3cc11a0bf865;
            8'd75: coefs = 72'hfb504d2b911f2bf83b;
            8'd76: coefs = 72'hfb4dcd1a412453f811;
            8'd77: coefs = 72'hfb4b4d08c1297ff7e7;
            8'd78: coefs = 72'hfb494cf7312eaff7bd;
            8'd79: coefs = 72'hfb478ce56133e7f792;
            8'd80: coefs = 72'hfb460cd3813923f768;
            8'd81: coefs = 72'hfb44ccc1713e63f73d;
            8'd82: coefs = 72'hfb43ccaf5143a7f713;
            8'd83: coefs = 72'hfb430c9d0148f3f6e8;
            8'd84: coefs = 72'hfb428c8a914e3ff6be;
            8'd85: coefs = 72'hfb428c78015393f693;
            8'd86: coefs = 72'hfb428c655158e7f668;
            8'd87: coefs = 72'hfb42cc52815e43f63e;
            8'd88: coefs = 72'hfb434c3f91639ff613;
            8'd89: coefs = 72'hfb440c2c8168fff5e8;
            8'd90: coefs = 72'hfb450c19516e67f5be;
            8'd91: coefs = 72'hfb464c061173cff593;
            8'd92: coefs = 72'hfb47cbf2b17937f569;
            8'd93: coefs = 72'hfb498bdf317ea7f53f;
            8'd94: coefs = 72'hfb4b8bcb918417f514;
            8'd95: coefs = 72'hfb4d8bb7d1898bf4ea;
            8'd96: coefs = 72'hfb500ba4018f03f4c0;
            8'd97: coefs = 72'hfb528b9011947bf496;
            8'd98: coefs = 72'hfb558b7c1199f7f46c;
            8'd99: coefs = 72'hfb588b67f19f77f443;
            8'd100: coefs = 72'hfb5bcb53b1a4f7f419;
            8'd101: coefs = 72'hfb5f4b3f61aa77f3f0;
            8'd102: coefs = 72'hfb62cb2b01affbf3c7;
            8'd103: coefs = 72'hfb66cb1681b57ff39e;
            8'd104: coefs = 72'hfb6acb01f1bb07f375;
            8'd105: coefs = 72'hfb6f0aed41c08ff34c;
            8'd106: coefs = 72'hfb738ad891c617f324;
            8'd107: coefs = 72'hfb780ac3b1cba3f2fc;
            8'd108: coefs = 72'hfb7d0aaed1d12ff2d4;
            8'd109: coefs = 72'hfb820a99e1d6bbf2ad;
            8'd110: coefs = 72'hfb870a84d1dc47f286;
            8'd111: coefs = 72'hfb8c8a6fb1e1d7f25f;
            8'd112: coefs = 72'hfb920a5a81e763f238;
            8'd113: coefs = 72'hfb97ca4541ecf3f212;
            8'd114: coefs = 72'hfb9d8a2ff1f27ff1ec;
            8'd115: coefs = 72'hfba3ca1a91f80ff1c6;
            8'd116: coefs = 72'hfba9ca0521fd9bf1a1;
            8'd117: coefs = 72'hfbb049efa2032bf17c;
            8'd118: coefs = 72'hfbb6c9da1208b7f157;
            8'd119: coefs = 72'hfbbd89c4720e43f133;
            8'd120: coefs = 72'hfbc449aed213cff10f;
            8'd121: coefs = 72'hfbcb499922195bf0ec;
            8'd122: coefs = 72'hfbd24983621ee3f0c9;
            8'd123: coefs = 72'hfbd9896d92246bf0a6;
            8'd124: coefs = 72'hfbe10957c229f3f084;
            8'd125: coefs = 72'hfbe88941e22f7bf062;
            8'd126: coefs = 72'hfbf0492bf234fff041;
            8'd127: coefs = 72'hfbf80916023a83f020;
            8'd128: coefs = 72'hfc000900024003f000;
            8'd129: coefs = 72'hfc0808ea024583efe0;
            8'd130: coefs = 72'hfc1048d3f24affefc1;
            8'd131: coefs = 72'hfc1888bde2507befa2;
            8'd132: coefs = 72'hfc2108a7c255f3ef84;
            8'd133: coefs = 72'hfc298891a25b67ef66;
            8'd134: coefs = 72'hfc32487b8260dbef49;
            8'd135: coefs = 72'hfc3b086562664bef2d;
            8'd136: coefs = 72'hfc43c84f326bb7ef11;
            8'd137: coefs = 72'hfc4cc83902711feef6;
            8'd138: coefs = 72'hfc55c822d27687eedb;
            8'd139: coefs = 72'hfc5f080ca27bebeec1;
            8'd140: coefs = 72'hfc6847f662814beea7;
            8'd141: coefs = 72'hfc7187e03286a7ee8f;
            8'd142: coefs = 72'hfc7b07c9f28bffee76;
            8'd143: coefs = 72'hfc8487b3c29153ee5f;
            8'd144: coefs = 72'hfc8e079d8296a3ee48;
            8'd145: coefs = 72'hfc97c787529befee32;
            8'd146: coefs = 72'hfca1877112a137ee1c;
            8'd147: coefs = 72'hfcab475ae2a67bee08;
            8'd148: coefs = 72'hfcb50744b2abb7edf4;
            8'd149: coefs = 72'hfcbf072e82b0efede0;
            8'd150: coefs = 72'hfcc9071852b627edce;
            8'd151: coefs = 72'hfcd3070232bb53edbc;
            8'd152: coefs = 72'hfcdd46ec12c07fedab;
            8'd153: coefs = 72'hfce786d5f2c5a3ed9b;
            8'd154: coefs = 72'hfcf1c6bfe2cac3ed8b;
            8'd155: coefs = 72'hfcfc06a9d2cfdbed7d;
            8'd156: coefs = 72'hfd064693d2d4efed6f;
            8'd157: coefs = 72'hfd10c67dd2d9ffed62;
            8'd158: coefs = 72'hfd1b0667d2df07ed56;
            8'd159: coefs = 72'hfd258651e2e407ed4a;
            8'd160: coefs = 72'hfd30063c02e903ed40;
            8'd161: coefs = 72'hfd3a862622edf7ed36;
            8'd162: coefs = 72'hfd45061052f2e7ed2e;
            8'd163: coefs = 72'hfd4fc5fa92f7cfed26;
            8'd164: coefs = 72'hfd5a45e4d2fcafed1f;
            8'd165: coefs = 72'hfd64c5cf330187ed19;
            8'd166: coefs = 72'hfd6f85b9930657ed14;
            8'd167: coefs = 72'hfd7a05a3f30b23ed10;
            8'd168: coefs = 72'hfd84c58e730fe7ed0d;
            8'd169: coefs = 72'hfd8f85790314a3ed0b;
            8'd170: coefs = 72'hfd9a0563931957ed0a;
            8'd171: coefs = 72'hfda4c54e431e03ed0a;
            8'd172: coefs = 72'hfdaf8538f322a7ed0a;
            8'd173: coefs = 72'hfdba0523c32743ed0c;
            8'd174: coefs = 72'hfdc4c50e932bd7ed0f;
            8'd175: coefs = 72'hfdcf44f983305fed13;
            8'd176: coefs = 72'hfdda04e48334e3ed18;
            8'd177: coefs = 72'hfde484cf93395bed1e;
            8'd178: coefs = 72'hfdef44bab33dcfed25;
            8'd179: coefs = 72'hfdf9c4a5f34233ed2d;
            8'd180: coefs = 72'hfe044491434693ed37;
            8'd181: coefs = 72'hfe0ec47ca34ae7ed41;
            8'd182: coefs = 72'hfe194468234f33ed4d;
            8'd183: coefs = 72'hfe23c453b35377ed59;
            8'd184: coefs = 72'hfe2e443f5357afed67;
            8'd185: coefs = 72'hfe38c42b135bdfed76;
            8'd186: coefs = 72'hfe430416e36003ed86;
            8'd187: coefs = 72'hfe4d4402d3641bed97;
            8'd188: coefs = 72'hfe5783eee3682bedaa;
            8'd189: coefs = 72'hfe61c3db036c33edbe;
            8'd190: coefs = 72'hfe6c03c733702fedd2;
            8'd191: coefs = 72'hfe7603b393741fede9;
            8'd192: coefs = 72'hfe8003a0037803ee00;
            8'd193: coefs = 72'hfe8a038c937bdfee19;
            8'd194: coefs = 72'hfe93c379437fabee33;
            8'd195: coefs = 72'hfe9dc36603836fee4e;
            8'd196: coefs = 72'hfea78352e3872bee6a;
            8'd197: coefs = 72'hfeb1433ff38ad7ee88;
            8'd198: coefs = 72'hfebac32d138e77eea7;
            8'd199: coefs = 72'hfec4431a53920feec7;
            8'd200: coefs = 72'hfecdc307b39597eee9;
            8'd201: coefs = 72'hfed702f5339913ef0c;
            8'd202: coefs = 72'hfee082e2d39c87ef30;
            8'd203: coefs = 72'hfee982d0a39febef56;
            8'd204: coefs = 72'hfef2c2be83a343ef7d;
            8'd205: coefs = 72'hfefbc2ac93a68fefa6;
            8'd206: coefs = 72'hff04829ac3a9cbefd0;
            8'd207: coefs = 72'hff0d428913acffeffb;
            8'd208: coefs = 72'hff16027783b023f028;
            8'd209: coefs = 72'hff1e826623b33bf056;
            8'd210: coefs = 72'hff270254e3b643f086;
            8'd211: coefs = 72'hff2f4243c3b93ff0b7;
            8'd212: coefs = 72'hff378232d3bc2ff0ea;
            8'd213: coefs = 72'hff3fc22203bf0ff11e;
            8'd214: coefs = 72'hff47c21163c1e3f153;
            8'd215: coefs = 72'hff4f8200e3c4a7f18a;
            8'd216: coefs = 72'hff5741f093c75ff1c3;
            8'd217: coefs = 72'hff5ec1e063ca07f1fd;
            8'd218: coefs = 72'hff6641d063cca3f239;
            8'd219: coefs = 72'hff6d81c093cf2bf276;
            8'd220: coefs = 72'hff74c1b0f3d1a7f2b5;
            8'd221: coefs = 72'hff7bc1a173d417f2f5;
            8'd222: coefs = 72'hff82c19223d673f337;
            8'd223: coefs = 72'hff898182f3d8c3f37b;
            8'd224: coefs = 72'hff90017403db03f3c0;
            8'd225: coefs = 72'hff96816533dd33f407;
            8'd226: coefs = 72'hff9cc156a3df53f44f;
            8'd227: coefs = 72'hffa2c14833e163f499;
            8'd228: coefs = 72'hffa8c139f3e367f4e5;
            8'd229: coefs = 72'hffae812bf3e557f533;
            8'd230: coefs = 72'hffb4011e13e737f582;
            8'd231: coefs = 72'hffb9811063e907f5d2;
            8'd232: coefs = 72'hffbec102f3eac7f625;
            8'd233: coefs = 72'hffc3c0f5b3ec77f679;
            8'd234: coefs = 72'hffc8c0e8a3ee13f6cf;
            8'd235: coefs = 72'hffcd80dbc3efa3f727;
            8'd236: coefs = 72'hffd200cf13f11ff780;
            8'd237: coefs = 72'hffd640c2a3f28bf7dc;
            8'd238: coefs = 72'hffda40b663f3e3f839;
            8'd239: coefs = 72'hffde40aa53f52bf897;
            8'd240: coefs = 72'hffe2009e83f663f8f8;
            8'd241: coefs = 72'hffe58092e3f787f95a;
            8'd242: coefs = 72'hffe8c08783f89bf9bf;
            8'd243: coefs = 72'hffec007c53f99bfa25;
            8'd244: coefs = 72'hffeec07163fa8bfa8d;
            8'd245: coefs = 72'hfff18066a3fb67faf6;
            8'd246: coefs = 72'hfff4005c23fc33fb62;
            8'd247: coefs = 72'hfff64051e3fcebfbd0;
            8'd248: coefs = 72'hfff84047d3fd8ffc3f;
            8'd249: coefs = 72'hfffa003e03fe23fcb0;
            8'd250: coefs = 72'hfffb803473fe9ffd24;
            8'd251: coefs = 72'hfffd002b13ff0bfd99;
            8'd252: coefs = 72'hfffe002203ff63fe10;
            8'd253: coefs = 72'hffff001923ffabfe89;
            8'd254: coefs = 72'hffff801083ffdbff04;
            default: coefs = 72'h0000000823fffbff81;
        endcase
    end
endmodule

`default_nettype wire
