cabezoide/sofifi/sim/nucleo/nucleo_test.py

# SPDX-License-Identifier: MIT
"""nucleo.v: los programas de programas/ y las cadenas dan la misma salida que el modelo.

Es el criterio de la Fase 04 (ADR 0003): igualdad exacta, tolerancia cero. El
estímulo es un impulso y después ruido del LFSR del modelo; los potenciómetros
están fijos y, en freeze, el footswitch se pulsa a mitad de la prueba.

SOFIFI_MUESTRAS fija la longitud. Por defecto son 1 000 muestras, para que la
compuerta siga siendo rápida; los criterios de aceptación de la Fase 04 se
ejecutan aparte (MED-09):

    SOFIFI_MUESTRAS=4883 pytest sim/nucleo/nucleo_test.py                 # 0,1 s, todos
    SOFIFI_MUESTRAS=48828 SOFIFI_PROGRAMAS=plate pytest sim/nucleo/nucleo_test.py   # 1 s
    SOFIFI_MUESTRAS=12000 SOFIFI_PROGRAMAS=cinta pytest sim/nucleo/nucleo_test.py   # eco

Las 1 000 muestras de la compuerta no llegan al primer eco de la cinta (0,18 s):
en ella solo se compara la señal seca. El eco se compara en la aceptación.
"""

from __future__ import annotations

import os
import random
from pathlib import Path

import cocotb
import pytest
from cocotb.clock import Clock
from cocotb.triggers import ClockCycles, RisingEdge
from cocotb_tools.runner import Runner, get_runner
from comun import AQUI, RAIZ, RTL
from sofifi.adapters.archivos import ensamblar_archivo
from sofifi.adapters.cadenas import leer_cadenas, textos_de_programas
from sofifi.domain.aritmetica import CICLOS_POR_MUESTRA, dato
from sofifi.domain.composicion import ensamblar_cadena, nombre_programa
from sofifi.domain.coste import ciclos_rtl
from sofifi.domain.ensamblador import ensamblar
from sofifi.domain.isa import Op, Programa, codificar
from sofifi.domain.lfo import TipoLfo
from sofifi.domain.nucleo import Nucleo

# Las cadenas que caben (presets/cadenas.toml, ADR 0013) también son programas del núcleo.
CADENAS = {
    nombre_programa(c): c
    for c in leer_cadenas(RAIZ / "presets" / "cadenas.toml")
    if c.requiere is None
}
PROGRAMAS = tuple(sorted(p.stem for p in (RAIZ / "programas").glob("*.sasm"))) + tuple(
    sorted(CADENAS)
)
CON_PULSADOR = {"freeze", "freeze_givens", "looper", "granular"}  # el footswitch se pulsa a mitad de la prueba
CON_PULSADOR |= {
    n for n, c in CADENAS.items() if any(e.programa in CON_PULSADOR for e in c.eslabones)
}
# La cinta, con pot0 = 0: el primer eco llega a las ~8 800 muestras y no a las ~31 700.
POTS_PRUEBA = {
    "plate": ("0.7", "0.5", "0.3", "0.6", "0.4", "0.2"),
    "cinta": ("0", "0.5", "0.3", "0.6", "0.4", "0.2"),
}
CODIGO_LFO = {TipoLfo.SIN: 0, TipoLfo.RND: 1, TipoLfo.RAMP: 2}
FUENTES = [
    RTL / "nucleo" / f
    for f in (
        "nucleo.v",
        "alu.v",
        "curva_fin.v",
        "acc_a_dato.v",
        "dato_a_memoria.v",
        "saturar_acc.v",
        "memoria_retardo.v",
        "lfo_banco.v",
        "tabla_hermite.v",
    )
] + [
    RTL / "primitivas" / f
    for f in ("mult_27x36.v", "bsram_pipe.v", "bsram_bloque.v", "registro_copia.v")
]


def programa_de(nombre: str) -> Programa:
    """Un programa de programas/ o una cadena del banco, ya compuesta."""
    carpeta = RAIZ / "programas"
    if nombre in CADENAS:
        return ensamblar_cadena(
            CADENAS[nombre],
            textos_de_programas(carpeta),
            lambda n: (carpeta / n).read_text(encoding="utf-8"),
        )
    return ensamblar_archivo(carpeta / f"{nombre}.sasm")


def estimulo(n: int) -> list[tuple[int, int]]:
    """Impulso en la muestra 0 y, desde la mitad, ruido de media escala."""
    azar = random.Random(2026)
    muestras = [(dato("0.5"), dato("-0.25"))] + [(0, 0)] * (n // 2 - 1)
    while len(muestras) < n:
        muestras.append((azar.randrange(-(1 << 21), 1 << 21), azar.randrange(-(1 << 21), 1 << 21)))
    return muestras


@cocotb.test()
async def igual_al_modelo(dut: cocotb.handle.HierarchyObject) -> None:
    nombre = os.environ["PROGRAMA"]
    n = int(os.environ.get("SOFIFI_MUESTRAS", "1000"))
    programa = programa_de(nombre)
    modelo = Nucleo(programa)
    pots = tuple(dato(v) for v in POTS_PRUEBA.get(nombre, POTS_PRUEBA["plate"]))

    cocotb.start_soon(Clock(dut.clk, 10, unit="ns").start())
    dut.rst.value, dut.tick.value, dut.prog_we.value = 1, 0, 0
    dut.cfg_instrucciones.value = len(programa.instrucciones)
    dut.cfg_palabras.value = programa.palabras_memoria
    dut.cfg_lfo_tipos.value = sum(
        CODIGO_LFO[c.tipo] << (2 * k) for k, c in enumerate(programa.lfos) if c is not None
    )
    dut.cfg_lfo_excursiones.value = sum(
        c.excursion << (15 * k) for k, c in enumerate(programa.lfos) if c is not None
    )
    dut.cfg_absoluta.value = int(programa.usa_absoluta)
    dut.pots.value = sum((v & 0xFFFFFF) << (24 * k) for k, v in enumerate(pots))
    await ClockCycles(dut.clk, 3)
    for k, ins in enumerate(programa.instrucciones):
        dut.prog_we.value, dut.prog_dir.value, dut.prog_dato.value = 1, k, codificar(ins)
        await RisingEdge(dut.clk)
    dut.prog_we.value = 0
    dut.rst.value = 0
    await RisingEdge(dut.clk)
    # El núcleo borra la memoria de retardo antes de atender ticks.
    while int(dut.ocupado.value):
        await RisingEdge(dut.clk)

    maximo = 0
    for k, (izq, der) in enumerate(estimulo(n)):
        sw = 1 if nombre in CON_PULSADOR and n // 3 <= k < 2 * n // 3 else 0
        dut.adc_l.value, dut.adc_r.value, dut.sw.value = izq, der, sw
        dut.tick.value = 1
        await RisingEdge(dut.clk)
        dut.tick.value = 0
        while not int(dut.fin.value):
            await RisingEdge(dut.clk)
        esperado = modelo.procesar(izq, der, pots, sw)
        obtenido = (dut.dac_l.value.to_signed(), dut.dac_r.value.to_signed())
        assert obtenido == esperado, f"{nombre}, muestra {k}: RTL {obtenido}, modelo {esperado}"
        maximo = max(maximo, int(dut.ciclos.value))
    cota = ciclos_rtl(programa)
    dut._log.info(
        "%s: %d muestras iguales; máximo %d ciclos por muestra (cota del modelo %d)",
        nombre,
        n,
        maximo,
        cota,
    )
    assert maximo <= cota <= CICLOS_POR_MUESTRA, f"{nombre}: {maximo} ciclos, cota {cota}"
    # Sin saltos, el modelo de tiempos (coste.py) es exacto: ADR 0014.
    if all(i.op is not Op.SKP for i in programa.instrucciones):
        assert maximo == cota, f"{nombre}: RTL {maximo} ciclos, modelo {cota}"


RETARDO_8 = """
mem  d  8
rdax adcl, 1.0
wra  d, 0
rda  d#, 1.0
wrax dacl, 0
"""


async def cargar(dut: cocotb.handle.HierarchyObject, programa: Programa) -> None:
    """Carga un programa con el núcleo en reset y espera a que borre la memoria."""
    dut.rst.value, dut.tick.value = 1, 0
    dut.cfg_instrucciones.value = len(programa.instrucciones)
    dut.cfg_palabras.value = programa.palabras_memoria
    # Los tipos de LFO cambian la duración del CHO (coste.py).
    dut.cfg_lfo_tipos.value = sum(
        CODIGO_LFO[c.tipo] << (2 * k) for k, c in enumerate(programa.lfos) if c is not None
    )
    dut.cfg_lfo_excursiones.value = sum(
        c.excursion << (15 * k) for k, c in enumerate(programa.lfos) if c is not None
    )
    dut.cfg_absoluta.value = int(programa.usa_absoluta)
    for k, ins in enumerate(programa.instrucciones):
        dut.prog_we.value, dut.prog_dir.value, dut.prog_dato.value = 1, k, codificar(ins)
        await RisingEdge(dut.clk)
    dut.prog_we.value, dut.rst.value = 0, 0
    await RisingEdge(dut.clk)
    while int(dut.ocupado.value):
        await RisingEdge(dut.clk)


async def muestra(dut: cocotb.handle.HierarchyObject, izq: int) -> int:
    dut.adc_l.value, dut.adc_r.value, dut.sw.value = izq, 0, 0
    dut.tick.value = 1
    await RisingEdge(dut.clk)
    dut.tick.value = 0
    while not int(dut.fin.value):
        await RisingEdge(dut.clk)
    return int(dut.dac_l.value.to_signed())


@cocotb.test()
async def reset_borra_la_memoria(dut: cocotb.handle.HierarchyObject) -> None:
    """Un retardo de 8 muestras: tras un reset, no debe salir nada de antes."""
    cocotb.start_soon(Clock(dut.clk, 10, unit="ns").start())
    dut.pots.value = 0
    programa = ensamblar(RETARDO_8, "retardo_8")
    await cargar(dut, programa)
    azar = random.Random(8)
    for _ in range(40):  # memoria llena de ruido
        await muestra(dut, azar.randrange(-(1 << 22), 1 << 22))
    await cargar(dut, programa)
    modelo = Nucleo(programa)
    for k in range(20):
        esperado = modelo.procesar(0, 0)[0]
        assert await muestra(dut, 0) == esperado, f"muestra {k} tras el reset"


SALTOS = """
mem  d  4
        rdax adcl, 1.0
        skp  neg, negativo
        sof  0.5, 0.25
        wrax dacl, 0
        skp  zro, fin
negativo:
        sof  -0.5, 0
        wrax dacl, 0
fin:
        rdax adcr, 1.0
        skp  gez, positivo
        clr
positivo:
        sof  1.0, -0.125
        wrax dacr, 0
"""


@cocotb.test()
async def saltos_iguales_al_modelo(dut: cocotb.handle.HierarchyObject) -> None:
    """SKP condicionales que saltan o no según el signo: la lectura adelantada se rehace."""
    cocotb.start_soon(Clock(dut.clk, 10, unit="ns").start())
    dut.pots.value = 0
    programa = ensamblar(SALTOS, "saltos")
    await cargar(dut, programa)
    modelo = Nucleo(programa)
    azar = random.Random(11)
    for k in range(200):
        izq, der = azar.randrange(-(1 << 22), 1 << 22), azar.randrange(-(1 << 22), 1 << 22)
        dut.adc_l.value, dut.adc_r.value, dut.sw.value = izq, der, 0
        dut.tick.value = 1
        await RisingEdge(dut.clk)
        dut.tick.value = 0
        while not int(dut.fin.value):
            await RisingEdge(dut.clk)
        esperado = modelo.procesar(izq, der)
        obtenido = (dut.dac_l.value.to_signed(), dut.dac_r.value.to_signed())
        assert obtenido == esperado, f"muestra {k}: RTL {obtenido}, modelo {esperado}"


ABSOLUTA = """
equ  pe   reg0            ; cabeza de escritura: 1 muestra por muestra
equ  pl   reg1            ; lectura lenta: 0,37 muestras por muestra
equ  pr   reg2            ; lectura al revés: −1,5 muestras por muestra
equ  u    reg3            ; 2^-15: una muestra en R
        skp  run, inicio
        sof  0, 1/32768
        wrax u, 0
        sof  0, 0.5
        wrax pr, 0
inicio:
        rdax adcl, 1.0
        wraa pe, 0
        rdaa pl, 1.0, 100
        rdaa pe, 0.5, 32700       ; origen cerca del final: la máscara da la vuelta
        wrax dacl, 0
        rdaa pr, 1.0, 7
        wrax dacr, 0
        rdax pe, 1.0
        rdax u, 1.0
        wrax pe, 0
        rdax pl, 1.0
        rdax u, 0.37
        wrax pl, 0
        rdax pr, 1.0
        rdax u, -1.5
        wrax pr, 0
"""


# Ensucia los extremos de la región absoluta antes de la prueba: el reset debe
# borrarlos (la lectura de la muestra 67 usa el índice 32 767).
SUCIA = """
        rdax adcl, 1.0
        wraa reg0, 1.0, 32767
        wraa reg0, 1.0, 0
"""


@cocotb.test()
async def absoluta_como_el_modelo(dut: cocotb.handle.HierarchyObject) -> None:
    """RDAA y WRAA (ADR 0009): fracción, origen, desborde por la máscara y lectura al revés."""
    cocotb.start_soon(Clock(dut.clk, 10, unit="ns").start())
    dut.pots.value = 0
    await cargar(dut, ensamblar(SUCIA, "sucia"))
    await muestra(dut, 1 << 22)
    programa = ensamblar(ABSOLUTA, "absoluta")
    await cargar(dut, programa)
    modelo = Nucleo(programa)
    azar = random.Random(17)
    for k in range(int(os.environ.get("SOFIFI_MUESTRAS", "1000")) * 3):
        izq = azar.randrange(-(1 << 22), 1 << 22)
        dut.adc_l.value, dut.adc_r.value, dut.sw.value = izq, 0, 0
        dut.tick.value = 1
        await RisingEdge(dut.clk)
        dut.tick.value = 0
        while not int(dut.fin.value):
            await RisingEdge(dut.clk)
        esperado = modelo.procesar(izq, 0)
        obtenido = (dut.dac_l.value.to_signed(), dut.dac_r.value.to_signed())
        assert obtenido == esperado, f"muestra {k}: RTL {obtenido}, modelo {esperado}"


CABECERA_COSTE = "mem d 64\nlfo 0 sin 8\nlfo 1 rnd 8\nlfo 2 ramp 32\n"
MUESTRA_COSTE = {
    "rdax": "rdax adcl, 0.5",
    "wrax": "wrax reg0, 1.0",
    "rda": "rda d + 5, 0.5",
    "wra": "wra d + 5, 1.0",
    "wrap": "wrap d + 5, 0.5",
    "rdfx": "rdfx reg1, 0.5",
    "maxx": "maxx reg1, 0.5",
    "mulx": "mulx reg1",
    "sof": "sof 0.5, 0.1",
    "clip": "clip",
    "ldax": "ldax reg1",
    "clr": "clr",
    "absa": "absa",
    "nop": "nop",
    "cho_sin": "cho d + 10, 0.5, lfo0",
    "cho_rnd": "cho d + 10, 0.5, lfo1",
    "cho_ramp": "cho d + 10, 0.5, lfo2",
    "cho_ramp_na": "cho d + 10, 0.5, lfo2, na",
    "skp_no": "skp neg, 0",
    "skp_si": "skp gez, 1\nnop",  # salta: el nop no se ejecuta
    "rdaa": "rdaa reg1, 0.5, 3",
    "wraa": "wraa reg1, 0.5, 3",
}


async def ciclos_de(dut: cocotb.handle.HierarchyObject, texto: str) -> int:
    await cargar(dut, ensamblar(CABECERA_COSTE + texto, "coste"))
    await muestra(dut, 0)
    await muestra(dut, 0)
    return int(dut.ciclos.value)


@cocotb.test()
async def coste_de_cada_instruccion(dut: cocotb.handle.HierarchyObject) -> None:
    """Ciclos de cada instrucción en el RTL: los que cuenta el modelo de tiempos (coste.py).

    Con 10 y 20 copias de cada instrucción, y con cada pareja de instrucciones
    seguidas: así se prueban también las esperas por dependencia (ADR 0014).
    """
    cocotb.start_soon(Clock(dut.clk, 10, unit="ns").start())
    dut.pots.value = 0
    lineas = list(MUESTRA_COSTE.items())
    casos = [(n, "\n".join([t] * k)) for n, t in lineas for k in (10, 20)]
    casos += [(f"{n1}+{n2}", f"{t1}\n{t2}\n" * 3) for n1, t1 in lineas for n2, t2 in lineas]
    for nombre, texto in casos:
        programa = ensamblar(CABECERA_COSTE + texto, "coste")
        rtl = await ciclos_de(dut, texto)
        if "skp" in nombre:   # con SKP, el modelo es una cota: cuenta cada salto
            assert rtl <= ciclos_rtl(programa), f"{nombre}: RTL {rtl}, cota {ciclos_rtl(programa)}"
        else:
            assert rtl == ciclos_rtl(programa), f"{nombre}: RTL {rtl}, modelo {ciclos_rtl(programa)}"


SELECCION = os.environ.get("SOFIFI_PROGRAMAS", ",".join(PROGRAMAS)).split(",")


@pytest.fixture(scope="module")
def construido(tmp_path_factory: pytest.TempPathFactory) -> tuple[Runner, Path]:
    """Una compilación de verilator por proceso de pytest; la comparten las pruebas."""
    destino = tmp_path_factory.mktemp("nucleo")
    runner = get_runner("verilator")
    runner.build(
        sources=FUENTES,
        hdl_toplevel="nucleo",
        defines={"SIMULACION": 1},
        build_dir=destino,
        build_args=["-Wall"],
        always=True,
    )
    return runner, destino


def _correr(
    construido: tuple[Runner, Path], casos: list[str], nombre: str, entorno: dict[str, str]
) -> None:
    runner, destino = construido
    runner.test(
        hdl_toplevel="nucleo",
        test_module="nucleo_test",
        test_dir=AQUI,
        build_dir=destino,
        testcase=casos,
        extra_env=entorno,
        results_xml=str(destino / f"resultados_{nombre}.xml"),
    )


def test_nucleo_auxiliares(construido: tuple[Runner, Path]) -> None:
    """Reset, saltos y coste de cada instrucción: no dependen del programa."""
    casos = [
        "reset_borra_la_memoria",
        "saltos_iguales_al_modelo",
        "coste_de_cada_instruccion",
        "absoluta_como_el_modelo",
    ]
    _correr(construido, casos, "auxiliares", {})


@pytest.mark.parametrize("nombre", SELECCION)
def test_nucleo_programa(construido: tuple[Runner, Path], nombre: str) -> None:
    _correr(construido, ["igual_al_modelo"], nombre, {"PROGRAMA": nombre})
