cabezoide/sofifi/(commit log)

2026-10-07 Fase 00: kit de arranque y compuerta local
    Repositorio con la disciplina de docs/SPEC_RAIZ.md antes de la primera
    línea de producto:
    - Compuerta local scripts/ci_local.sh (duras: tech-debt, secrets,
    licenses, adr-gate, docs, i18n, model, ratchets; blandas: rtl-lint,
    shell-lint) y hook pre-push versionado que delega en --no-soft.
    - Modelo de referencia por capas (domain/ports/adapters/services) con
    tests-contrato de arquitectura que demuestran detectar violaciones.
    - ADR 0001-0007: compuerta, licencia MIT sin copyleft portado, modelo
    bit-exact como oráculo, BSRAM-only (la microSD almacena, no retarda),
    fs = 48 828 Hz, núcleo DSP microcodificado tipo FV-1, i18n con sello.
    - READM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
    [estado_fases.csv]
2026-10-07 Nombre del proyecto: SOFIFI
    - es: Sintetizador de Ondas y Filtros Inmersivos en FPGA Integrada
    - en: Soundscapes On FPGA: Integrated Filters & Impulses
    - zh-CN: 集成 FPGA 上的沉浸式波形与滤波合成器 (pendiente de revisión nativa)
    Paquete del modelo renombrado de ambient a sofifi (model/sofifi/) con
    las capas aún vacías; actualización fechada al pie del ADR 0003.
    Traducciones del README actualizadas y reselladas.
2026-10-07 F01 PR1: aritmética de punto fijo, memoria, LFOs y tabla Hermite
    Dominio del modelo bit-exact (ADR 0008):
    - aritmetica.py: dato S.23, coef S1.16, ACC S8.39 de 48 bit, memoria de
    18 bit; redondeo half-up + saturación, nunca wrap; curva suave entera.
    - memoria.py: memoria circular tipo FV-1 (puntero decreciente), 42
    bloques = 43 008 palabras, lectura Hermite de 4 puntos.
    - interpolacion.py: tabla Hermite exacta con Fraction (ROM de 1 bloque).
    - lfo.py: LFSR Galois de 32 bit y LFOs SIN/RND/RAMP con ventana.
    - Pruebas unitarias y property-based (hypothesis) como compuerta dura.
    - ADR 0008 nuevo; actualización fechada del ADR 0004 (reserva de 14
    bloques); RUF001-003 desactivadas con su m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
2026-10-07 F01 PR2: ISA de 54 bit e intérprete bit-exact del núcleo
    - isa.py: 16 instrucciones (subconjunto FV-1 + CLIP + CHO con Hermite,
    ventana y media fase), palabra de 54 bit, mapa de 64 registros,
    validación de programas (instrucciones, ciclos, memoria, LFOs,
    registros de solo lectura, saltos).
    - nucleo.py: intérprete por muestra con despacho por tabla Op→manejador.
    - Pruebas: contrato de despacho, codificación ida y vuelta (hypothesis),
    semántica por instrucción, allpass energéticamente neutro, delay,
    filtro, y pitch shifter de doble tap que sube un tono una octava.
    - ADR 0009 nuevo; isa.py pasa a sentinela.
2026-10-07 F01 PR3: ensamblador tipo SpinASM, puertos, adaptadores, servicios y CLI
    - domain/ensamblador.py: texto → Programa con equ/mem/lfo, etiquetas,
    sufijos #/^ de SpinASM y expresiones exactas con Fraction (analizador
    propio, nunca eval); errores con número de línea.
    - domain/senal.py: Senal y Controles (pots, tramos de footswitch).
    - ports/audio.py: FuenteAudio, SumideroAudio, FuentePrograma,
    SumideroMicrocodigo.
    - adapters: WAV PCM 16/24/32 (remuestreo fuera del oráculo), programa
    desde archivo, microcódigo .hex ($readmemh) + .json.
    - services/render.py: exportar_microcodigo, procesar, renderizar.
    - cli.py: `sofifi asm` y `sofifi render` (raíz de composición).
    - Pruebas: errores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
2026-10-07 F01 PR4: programas plate, shimmer y freeze; cierre de la Fase 01
    - programas/plate.sasm: plate de Dattorro reescrito desde el paper y
    reescalado a 48 828 Hz (86 instrucciones, 92 ciclos, 37 439 palabras).
    - programas/shimmer.sasm: +12 de doble tap en la realimentación, con
    filtros y limitador CLIP de ganancia unitaria (120 ciclos).
    - programas/freeze.sasm: footswitch → decay ≈ 1, sin damping, entrada
    cortada y modulación a 0 en rampa (bucle sin pérdidas, sin clic).
    - Pruebas acústicas (decae, decay más largo, freeze se sostiene, shimmer
    añade la octava) y huellas bit-exact por programa.
    - .sasm en las compuertas de licencias y deuda; Dattorro en terceros.
    - Registros: RAT-0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
    [estado_fases.csv]
2026-10-07 Demos de audio en demo_examples/ y trampa de los PRs apilados
    - demo_examples/: guitarra sintética (Em9, Karplus-Strong) y su paso por
    plate, shimmer y freeze; README trilingüe con los ajustes de cada demo.
    - scripts/generar_demos.py: las regenera byte a byte (núcleo bit-exact,
    semilla fija); verificado idéntico a las demos escuchadas.
    - check_secrets_hygiene.sh: excepción acotada para demo_examples/*.wav
    (≤ 4 MiB por fichero, ≤ 16 MiB en total); el resto sigue en 1 MiB.
    - ADR 0001: actualizaciones fechadas (demos versionadas; PRs apilados).
    - AGENTS.md: trampas conocidas (PRs apilados, demos regenerables).
    - README es/en/zh-CN: dónde están las demos (traducciones reselladas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
2026-10-07 Specs de las fases 02 a 11 (planificadas)
    Hoja de ruta desde la cadena EDA abierta hasta el pedal integrado:
    F02 cadena EDA y primer bitstream · F03 núcleo RTL equivalente al modelo
    · F04 HIL por UART · F05 I2S · F06 controles · F07 microSD · F08
    biblioteca de programas · F09 looper y granular · F10 OLED trilingüe ·
    F11 integración y limitador de seguridad. Ninguna entra en el control
    hasta cerrarse.
2026-10-07 F02: cadena EDA abierta por pip y primer bitstream en la placa; cierre de la Fase 02
    - rtl/comun/uart_tx.v (8N1, handshake valido/listo) con testbench cocotb en
    sim/comun/uart_tx_test.py; rtl/top/hola_uart.v envía "SOFIFI <contador>"
    cada segundo; pines en rtl/top/primer25k.cst.
    - scripts/fpga.sh (yosys → nextpnr-himbaechel → gowin_pack → openFPGALoader),
    scripts/informe_recursos.py y scripts/leer_uart.py; make synth/prog/uart/sim.
    - Extra `eda` en pyproject.toml; make install instala toda la cadena.
    - Compuerta: rtl-lint pasa a dura, entra sim (dura) y synth (clase release,
    make release-check). Verilator se llama por su binario real con
    VERILATOR_ROOT y bajo ulimit -u: el e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
    [estado_fases.csv]
2026-10-07 hola_uart: un solo conversor a hexadecimal (353 → 207 LUT4, 146 → 82 ALU)
    Convertía a ASCII los 8 nibbles del contador con sumadores en paralelo y
    luego elegía uno. Ahora elige el nibble y lo convierte con una tabla.
    Verificado en la placa (el contador pasa de 0F a 10 bien). MED-04/05 y
    fila 02 del control actualizadas.
    [estado_fases.csv]
2026-10-07 Compuerta de optimización y segunda vuelta antes de cada PR (ADR 0010)
    - scripts/check_optimizacion.py (trabajo duro `optimizacion`): sintetiza
    cada top de rtl/top/tops.txt, bloquea si un reloj no cierra timing e
    imprime pistas (más ALU que DFF, MUX2 anchos, margen de timing justo).
    Las dos primeras saltan con la versión inicial de hola_uart y no con la
    corregida.
    - check_ratchets: medidas recursos:<top>:<celda>; RAT-03/04 fijan LUT4 y
    ALU de hola_uart con aviso_holgura 0.
    - rtl/top/tops.txt, lista única de tops (Makefile, ci_local, comprobaciones).
    - make optimizacion; plantilla de PR con la sección «Segunda vuelta»; regla
    en CLAUDE.md y paso en docs/EXTENDING.md.
    Co-Aut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
2026-10-07 Reordenar las fases 05 a 10: el hardware que falta, al final
    Hasta la Fase 07 basta con la placa y la microSD. Las que necesitan
    hardware que la persona propietaria no puede conseguir ahora van al final.
    Ninguna fase necesita la SDRAM.
    05 Biblioteca de programas (antes 08)
    06 Micro-looper y granular (antes 09)
    07 Carga desde la microSD (igual)
    08 Controles físicos (antes 06; faltan MCP3208 y pots)
    09 Interfaz en OLED (antes 10; falta la SSD1306)
    10 Audio I2S (antes 05; falta el códec)
    Las specs 08 a 11 declaran su hardware que falta; referencias cruzadas
    corregidas; tabla de hardware del README trilingüe completada.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
2026-10-07 F07: el banco usa ranuras fijas de 28 bloques por programa
    La spec decía «1 bloque por programa», pero un programa máximo ocupa
    2 048 × 54 bit = 13 824 bytes = 27 bloques de 512. Cada ranura lleva 1
    bloque de metadatos y 27 de microcódigo, y empieza en 1 + 28·k: el
    cargador no sigue punteros leídos de la tarjeta.
2026-10-07 F03 PR1: estado del arte 2026, hoja de ruta y renumeración de fases
    - docs/investigacion/ESTADO_DEL_ARTE_2026.md: mercado 2024-2026, arXiv
    (DSP clásico, neuronal y DDSP), interacción y plataformas abiertas.
    Hoja de ruta de 27 puntos con coste, cambio de ISA y fase.
    - Nueva Fase 03 (estado del arte, hoja de ruta y prueba de primitivas
    DSP 27×18, BSRAM de doble puerto y PLL). Las fases 03-11 pasan a 04-12.
    - Cada spec posterior recibe «Ampliaciones de la Fase 03». La Fase 04
    reserva en la ISA sitio para RDAA/WRAA, coma flotante y LFO seno/coseno.
    - Regla 6 de AGENTS.md y sección «Redacción» de CLAUDE.md: redacción
    según ASD-STE100.
    - ADR 0010: actualización por la renume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
2026-10-07 Infografías del proyecto y del estado del arte
    docs/infografias/sofifi.html y estado-del-arte.html: carteles en HTML
    autocontenido, con cifras medidas sobre el repositorio el 2026-10-07.
    Publicadas también como artefactos privados. Entrada en el mapa de
    AGENTS.md.
2026-10-07 F03 PR2: primitivas DSP, BSRAM y PLL verificadas en la placa; cierre de la Fase 03
    - rtl/primitivas/: envoltorios mult_27x18 (MULT27X36), bsram_dp (DPX9B
    inferida) y pll_100 (PLLA), cada uno con modelo para SIMULACION.
    - rtl/comun/linea_hex.v y medidor_frecuencia.v (cruce de dominios en Gray).
    - Tops prueba_dsp, prueba_bsram (43 008 × 18, 42 bloques) y prueba_pll, con
    testbench cocotb; scripts/verificar_primitivas.py comprueba en el PC.
    - En la placa: 2 500 productos sin error, 1 600 millones de lecturas de
    BSRAM sin error, PLL a 100 000 000 ciclos exactos (MED-06 a MED-08).
    - Hallazgos: Yosys no infiere DSP para gw5a; apicula 0.32 falla con los
    divisores por defecto del PLLA; nextp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
    [estado_fases.csv]
2026-10-07 README trilingüe con imágenes de las infografías
    - docs/img/portada.png (logotipo y cara del pedal), memoria.png (la memoria
    manda, no el cómputo) y ruta.png (las 13 fases), capturadas de
    docs/infografias/ a escala 2.
    - Mismas imágenes en es, en y zh-CN, con texto alternativo en cada idioma y
    enlace al estado del arte; traducciones reselladas.
    - CLAUDE.md: al cerrar una fase se regeneran portada.png y ruta.png.
2026-10-07 F04 PR1: ALU, formatos y multiplicador 27×36 del núcleo
    - rtl/nucleo/acc_a_dato.v, dato_a_memoria.v, saturar_acc.v: conversiones de
    formato del ADR 0008, bit a bit (20 000 vectores contra aritmetica.py).
    - rtl/nucleo/alu.v: paso final de las 16 instrucciones con un solo sumador
    compartido. 40 000 vectores contra los manejadores del modelo.
    - rtl/primitivas/mult_27x36.v: multiplicador único del núcleo; cubre 24×18
    y 24×24 (MULX, CLIP, ventana de CHO) sin el «MULX en dos pasos».
    - rtl-lint también hace un lint por módulo (ADR 0001).
2026-10-07 F04 PR2: memoria de retardo, LFO y ROM Hermite del núcleo
    - rtl/nucleo/memoria_retardo.v: memoria circular de 43 008 × 18 con puntero
    decreciente; dirección relativa en [-1, P-1] y una corrección de ±P.
    - rtl/nucleo/lfo_banco.v: 4 LFO (fase, LFSR de 24 pasos en 24 ciclos, RND
    con >> 6), triángulo, ventana y media vuelta. 3 000 muestras iguales al
    modelo (encontró un desbordamiento de 24 bit en objetivo − actual).
    - rtl/nucleo/tabla_hermite.v, generada por `sofifi tablas` desde el modelo;
    model/tests/tablas_test.py exige que coincida con su generador.
    - Modelo: Programa valida que el alcance de cada CHO quepa en la memoria
    (alcance_cho; ADR 0009 actualizado).
    Co-Authored-B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
2026-10-07 F04 PR3: secuenciador del núcleo, igual al modelo y a 140 MHz; cierre de la Fase 04
    - rtl/nucleo/nucleo.v: secuenciador multiciclo de las 16 instrucciones, con
    un solo multiplicador y la memoria de retardo (latencia común de 3 ciclos).
    CHO: desplazamiento (curva, depth, E), 4 lecturas Hermite en cadena,
    ventana y suma. 63 477 muestras iguales al modelo (MED-09).
    - rtl/top/nucleo_placa.v: PLL, una muestra cada 2 048 ciclos y el plate
    cargado desde rtl/top/programa_plate.v (generado por `sofifi tablas`).
    Cierra a 140,57 MHz sin violaciones de hold; corre en la placa.
    - Timing: operandos registrados en la decodificación, CLIP en dos pasos,
    ROM Hermite y del programa en LUT (las S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
    [estado_fases.csv]
2026-10-07 F05 PR1: UART RX, generador de muestra y fs medida en la placa
    - rtl/comun/uart_rx.v (8N1, muestreo en el centro, descarta start falso y
    errores de trama) con testbench de los 256 bytes.
    - rtl/comun/generador_muestra.v: un tick cada 2 048 ciclos de 100 MHz.
    - rtl/top/prueba_fs.v: cuenta muestras por segundo y devuelve el eco de lo
    recibido. En la placa: 48 828 siete de cada ocho segundos y 48 829 el
    octavo, como da 48 828,125 Hz; eco exacto de 8 bytes (MED-12).
    - P-002 verificada; scripts/verificar_primitivas.py fs; RAT-14 y RAT-15.
    [generador_muestra.v, prueba_fs.v, uart_rx.v]
2026-10-07 F05 PR2: el núcleo coincide con el modelo en el silicio; cierre de la Fase 05
    - rtl/top/hil_nucleo.v y scripts/hil_nucleo.py: captura de 4 096 muestras a
    velocidad real, volcado con CRC-32 a petición del PC y comparación con el
    modelo. El plate coincide bit a bit en la placa a 100 MHz (9 de 9, MED-13).
    - El núcleo borra su memoria de retardo al salir del reset (con una prueba que
    falla si no lo hace).
    - F-11: nextpnr daba 132 MHz y el silicio fallaba a 100. Diagnóstico con el
    mismo rutado y solo el divisor del PLL cambiado (scripts/margen_reloj.py).
    Resolución: BSRAM con registro de salida (bsram_bloque, bsram_pipe), ALU en
    dos etapas, LAT 5, dirección del CHO en tres paso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
    [estado_fases.csv]
2026-10-07 F06 PR1: lectura adelantada y margen de reloj del 20 % medido en la placa
    - Secuenciador con lectura adelantada del microcódigo.
    - Segmentación para el silicio (fails.md F-15): memoria de retardo por
    grupos con copias locales (registro_copia) y salidas registradas, banco
    de registros en dos niveles, dirección física con sumas en paralelo y
    PREG en el DSP.
    - Traza del núcleo en la placa: orden T del top HIL, y
    margen_reloj.py --traza / --mdiv.
    - Placa: 120 MHz 4 de 4, 125 MHz 3 de 4 (antes 106 MHz). Shimmer
    1 514 ciclos por muestra (antes 1 601).
    - F-16: verilator de pip y cabeceras precompiladas.
    - Mapa de arquitectura en Mermaid.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
    [bsram_pipe.v, comun.py, hil_nucleo.py, hil_nucleo.v, margen_reloj.py]
2026-10-07 F06 PR2: include en el ensamblador, hall y cloud
    - El ensamblador acepta `include ruta`. Sigue puro: recibe una función que
    lee el fichero. Plate, shimmer y freeze comparten seis bloques de
    programas/comun/ y sus huellas no cambian.
    - model/sofifi/domain/coste.py da los ciclos de cada instrucción en el RTL.
    La simulación los mide y los compara con la tabla. «Cabe en el núcleo»
    usa ahora esta cota y no 1 ciclo por instrucción.
    - hall.sasm: FDN de 8 líneas con Householder. 1 578 de 2 048 ciclos.
    T60 de 0,6 s a 8,1 s con pot0.
    - cloud.sasm: seis difusores largos, dos con LFO aleatorio, y un tanque en
    ocho. 1 356 ciclos y 42 814 palabras.
    - Los dos coinciden con el modelo en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
2026-10-07 F06 PR3: cinta y reverse; demos en 16 bit
    - cinta.sasm: eco de 0,18 a 0,85 s con wow, flutter y CLIP en el bucle.
    El tiempo sale de un LFO senoidal parado: el retardo del CHO sigue a
    lfo0_depth. 658 de 2 048 ciclos.
    - reverse.sasm: granos invertidos de 0,17 s con ventanas complementarias.
    431 ciclos.
    - Los dos coinciden con el modelo en el RTL (cinta 12 000 muestras,
    reverse 4 883).
    - comun/mezcla.sasm: la mezcla, aparte de controles.sasm.
    - Las demos pasan a PCM de 16 bit y colas algo más cortas: suman 12,7 MB
    de los 16 MiB que admite la compuerta secrets.
    - Pruebas de cloud y cinta más cortas: la suite de programas tarda 39 s
    (MED-02).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
    [generar_demos.py, nucleo_test.py]
2026-10-07 README: «¿Por qué escoger SOFIFI?» en lugar de «La memoria manda»
    - Sección nueva en docs/infografias/sofifi.html: tres razones (0 bits de
    diferencia, 7 efectos en texto, MIT) y una comparativa honesta con el
    FV-1, que también dice en qué pierde SOFIFI.
    - docs/img/porque.png sustituye a docs/img/memoria.png en los tres README.
    Las cifras de memoria.png (5,9 % de ciclos) contaban 1 ciclo por
    instrucción y ya no valían.
    - Traducciones actualizadas y reselladas (ADR 0007).
2026-10-07 F06 PR4: lo-fi y swell; demos sin límite total
    - lofi.sasm: muestreo de 48,8 kHz a ~1 kHz (S&H con contador) y 24, 12,
    10, 8 o 7 bit. Sin AND en la ISA: WRAX redondea y SOF reescala. 620 ciclos.
    - swell.sasm: detector de ataque con dos envolventes; cada nota empieza en
    silencio y sube antes del plate. 1 467 ciclos.
    - El tanque del plate pasa a comun/dattorro_tanque.sasm (plate y swell).
    - Las pruebas recorren todos los .sasm de programas/: cada programa debe
    caber, tener huella y coincidir con el RTL en la simulación.
    - Lo-fi y swell coinciden con el modelo en el RTL (4 883 muestras).
    - secrets ya no limita el total de las demos, solo 4 MiB por demo, a
    petición de la persona propi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
2026-10-07 Demos en Ogg Vorbis: 1,7 MB en lugar de 15,2 MB
    - scripts/generar_demos.py renderiza en memoria y escribe Ogg Vorbis con
    soundfile (BSD). Un .ogg solo se reescribe si su audio cambia: el número
    de serie de Ogg cambia en cada codificación.
    - Opus no admite 48 828 Hz; Vorbis sí.
    - Grupo opcional `demos` en pyproject.toml; make install lo instala.
    - secrets admite .ogg de hasta 4 MiB en demo_examples/.
    - a_pcm16 queda en el adaptador WAV: lo usan el WAV de 16 bit y las demos.
    - ADR 0001, actualización.
2026-10-07 Compuerta en paralelo: model de 50 a 20 s y sim de 176 a 114 s
    - model corre pytest -n auto (pytest-xdist, MIT).
    - sim corre pytest sim -n 4. La prueba del núcleo se parte en una por
    programa y una con reset, saltos y costes, que no dependen del programa.
    - La biblioteca va a crecer a unos 40 programas: en serie, la compuerta
    pasaría de 10 min.
    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
    [nucleo_test.py]
2026-10-07 F06 catálogo, lote 1: chorus, flanger, phaser, trémolo y vibrato
    - Cinco programas de modulación, iguales al modelo en el RTL (4 883
    muestras cada uno), con prueba acústica, huella y demo.
    - comun/lfo_triangulo.sasm: un LFO por software que el programa puede
    leer, para trémolo y phaser.
    - sofifi catalogo genera docs/programas.md desde las cabeceras
    (; familia:, ; resumen:, ; potN =). Una prueba exige que esté al día.
    - model/tests/acustica.py reúne las medidas comunes; las pruebas de cada
    familia van en su fichero.
    - Se corrige el autopan durante el desarrollo: rdax pot2, -2 saturaba.
    [generar_demos.py]
2026-10-07 F06 catálogo, lote 2: octava, armonizador, doblador, escalera y shimmer de quinta
    - Cinco programas de pitch, iguales al modelo en el RTL (4 883 muestras),
    con prueba de intervalo, huella y demo.
    - comun/intervalo.sasm: pot0 elige −12, −7, −5, +5, +7 o +12.
    - comun/shimmer_cuerpo.sasm: el shimmer con el intervalo como equ.
    - comun/dattorro_tanque_clip.sasm: el tanque con CLIP de shimmer y freeze.
    - Las huellas de plate, shimmer y freeze no cambian.
2026-10-07 F06 catálogo, lote 3: blackhole, infinite, bloom, spring, gated y reverb inversa
    - Seis reverbs, iguales al modelo en el RTL (4 883 muestras), con prueba
    acústica, huella y demo. 25 programas en total.
    - La red del hall pasa a comun/fdn8_decl.sasm y comun/fdn8_cuerpo.sasm con
    las longitudes como equ; la huella del hall no cambia.
    - comun/compuerta.sasm (ataque y cuenta atrás) y comun/duracion.sasm
    (pot3 → duración con (1 − pot3)², sin perder kmin en el campo D).
    - comun/salida_con_ganancia.sasm: la reverb por una ganancia, más la seca.
2026-10-07 Esquemáticos del RTL: un PDF por módulo en schematics/ (ADR 0012)
    - scripts/esquematicos.py: Yosys (proc, opt, sin aplanar) → netlistsvg
    (MIT) → PDF vectorial con cajetín (módulo, descripción, fuente, sha).
    - 30 módulos de rtl/, en schematics/<carpeta>/<módulo>.pdf, con índice y
    guía de lectura en schematics/README.md.
    - Páginas de más de 14 000 puntos se escalan (el núcleo).
    - make esquematicos; compuerta blanda esquematicos (--comprobar).
    - netlistsvg y elkjs (EPL-1.0) se usan como herramientas, no se copian.
2026-10-07 F06 catálogo, lote 4: delay, ping-pong, lluvia, BBD y ducking
    - Cinco delays, iguales al modelo en el RTL (4 883 muestras), con prueba
    acústica, huella y demo. 30 programas en total.
    - comun/tiempo.sasm: el retardo variable de la cinta (LFO parado), con
    alias de registros.
    - Prueba nueva: las huellas deben ser distintas (dos iguales suelen ser
    solo señal seca).
    - generar_demos.py corre en paralelo.
2026-10-07 Intérprete del modelo el doble de rápido, con los mismos bits
    - saturar, saturar_acc y acc_a_dato con comparaciones y constantes ya
    calculadas, no con min/max ni llamadas encadenadas.
    - El núcleo resuelve el despacho una vez y lee las banderas de SKP y CHO
    como enteros (construir un IntFlag por muestra era lento).
    - Una prueba de propiedades exige que las versiones rápidas den lo mismo
    que la definición general; las 30 huellas no cambian.
    - MED-01: de 2,2 a 1,16 s por segundo de audio. model: de 58 a 35 s.
    - ADR 0008, actualización (aritmetica.py es sentinela).
2026-10-07 F06 catálogo, lote 5: compresor, puerta, autowah, filtro y saturación
    - Cinco programas de dinámica, filtros y textura, iguales al modelo en el
    RTL (4 883 muestras), con prueba, huella y demo. 35 programas en total.
    - comun/svf.sasm: filtro de variable de estado de Chamberlin.
    - Compresor de realimentación sin división: la bajada es proporcional a la
    ganancia, para que nunca cruce 0.
2026-10-07 F06 catálogo, lote 6: ring modulator, slicer, ancho, chorale y resonador
    - Cinco programas de textura y color, iguales al modelo en el RTL (4 883
    muestras), con prueba, huella y demo. 40 programas en total.
    - Fallos encontrados: rdax pot, C > 1 seguido de SOF satura antes de
    restar (ancho, slicer), y 1 − pot1 puede salir −0,00003 (slicer).
2026-10-07 F06 catálogo, lote 7: plate vivo, shimmer energético y freeze de Givens
    - Tres ampliaciones de la hoja de ruta de la Fase 03 (puntos 2, 7 y 3),
    iguales al modelo en el RTL, con prueba, huella y demo. 43 programas.
    - comun/azar_lento.sasm: azar lento con el mapa logístico (ciclo de 724
    pasos en punto fijo: avanza un paso cada 0,4 s).
    - El shimmer se parte en shimmer_cuerpo y shimmer_cola; las huellas no
    cambian.
    - Freeze de Givens verificado en el modelo: la rotación cuantizada conserva
    la energía durante 6 s.
    - Velvet noise (punto 5) no se publica: menos denso que los allpass (F-17).
    - fails.md: F-17 y F-18 (fallos de programación del catálogo).
    - La simulación pulsa el foots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
    [generar_demos.py, nucleo_test.py]
2026-10-07 F06: banco de 344 presets (8 por programa)
    - presets/banco.toml: una tabla por programa; cada preset, un nombre y los
    valores de sus mandos.
    - sofifi presets [PROGRAMA] y sofifi render --preset NOMBRE.
    - presets_test.py: el programa existe, cada preset usa solo los mandos del
    programa, valores en [0, 1], al menos 5 por programa, sin repetidos.
    - El catálogo cuenta los presets de cada programa.
2026-10-07 Cierre de la Fase 06: biblioteca de 43 programas y 344 presets (versión 0.6)
    - Spec cerrada y fila 06 en estado_fases.csv, con hallazgos y enmiendas.
    - README 0.6 (es, en, zh-CN, resellados): estado, familias, presets y
    cómo escucharlos.
    - Infografía al día: versión, cara del pedal (ciclos reales del RTL),
    familias con sus ciclos, MED-13 y MED-14, 7 fases cerradas.
    - scripts/capturar_infografia.py: captura una sección a escala 2 solo con
    la biblioteca estándar; portada, porque y ruta regeneradas.
    [estado_fases.csv]
2026-10-07 i18n (1/4): japonés en el ADR 0007 y la compuerta; README revisado (STE) en cuatro idiomas
2026-10-07 i18n (4/4): infografías y capturas en cuatro idiomas
    - sofifi y estado-del-arte en en, zh-CN y ja (Noto Sans/Serif SC y JP para
    CJK), con sello; capturas en docs/img/<idioma>/.
    - La portada del estado del arte usaba la cuenta de 1 ciclo por
    instrucción (5,9 %): ahora usa los ciclos medidos en el RTL (73,9 %).
    - Fase 10, BOM y madurez: la OLED y la documentación, en cuatro idiomas.
2026-10-08 F07 PR1 (en curso): RDAA/WRAA en modelo y RTL; predecodificación y tick registrado
    Estado: igual al modelo en simulación y en la placa a 100 MHz (3 de 3).
    Pendiente: margen perdido (falla a 114,3 MHz desde la muestra 0, entrada 2
    de la traza: pc=8 frente a 4), esquemáticos, documentación y listones.
2026-10-08 F07 PR1: margen recuperado (125 MHz) y borrado de la región absoluta
    - Escritura del banco en dos etapas: máscara y dato, y después el
    registro. El silicio fallaba a 114 MHz en la muestra 0 (F-19).
    - RDAA registra M[i+1] − M[i] antes del multiplicador: 27 ciclos.
    - E_BORRAR registra el modo absoluto con la dirección (F-20).
    - La prueba de la región ensucia antes la memoria y cambia de nombre:
    el filtro de cocotb es una expresión regular.
    - alu_test conoce RDAA y WRAA.
    - El análisis de operandos pasa a domain/operandos.py (RAT-02).
    - netlistsvg corre con más pila: las redes anchas la desbordaban.
    Placa (plate, hil_nucleo): 120 MHz 3/3, 125 MHz 3/3, 133,3 MHz 1/1.
    Listones RAT-1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
2026-10-08 F07 PR2: looper, probado en la placa con RDAA y WRAA
    - programas/looper.sasm: graba con el footswitch pulsado, fija la
    longitud al soltar, overdub con realimentación, ½×, 1×, 2× y reverse.
    85 instrucciones, 809 de 2 048 ciclos. Familia nueva «looper».
    - Pruebas acústicas: el loop se repite idéntico, 2× sube una octava,
    ½× baja una, el reverse recorre el loop hacia atrás y el overdub
    suma o reemplaza. Huella, 8 presets, catálogo y demo.
    - hil_nucleo: parámetro PROGRAMA y footswitch en el estímulo,
    proporcional a N_CAPTURA. Top nuevo hil_looper.
    - Placa: looper igual al modelo de 100 a 125 MHz (MED-15); el plate,
    2 de 2 de 100 a 125 MHz con el HIL nuevo.
    Co-Authore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
    [generar_demos.py, hil_looper.v, hil_nucleo.py, hil_nucleo.v, margen_reloj.py]
2026-10-08 F07 PR3: granular de 4 voces con ventana Hann, octavas y freeze
    - programas/granular.sasm: 188 instrucciones, 1 896 de 2 048 ciclos.
    Búfer en la región absoluta; con sw, el búfer se congela.
    - Azar: x ← frac(5x + c) con c impar, exacto en 23 bit (periodo 2^23).
    Un programa no puede leer el LFSR del núcleo.
    - Ventana Hann sin tabla: sin(πg) ≈ p·(0,775 + 0,225p), al cuadrado.
    Los granos de cada pareja van media vuelta desfasados: la ventana del
    segundo es 1 − w y la ganancia es constante.
    - Pruebas: ganancia constante y generador exacto, pitch en octavas,
    granos dentro de la ventana declarada y freeze. Huella, 8 presets,
    catálogo y demo.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
2026-10-08 Cierre de la Fase 07 (versión 0.7) y compuerta de cierre de fase
    - Spec cerrada y fila 07 en estado_fases.csv, con hallazgo y enmiendas.
    - README, infografía y capturas en los cuatro idiomas: versión 0.7,
    45 programas, 360 presets, 8 familias, 125 MHz, 8 fases cerradas.
    - SBOM ×4: la región absoluta de la memoria de retardo.
    - Catálogo: la memoria cuenta la región absoluta (32 769 palabras).
    - Compuerta nueva `cierre` (ADR 0001, actualización), a petición de la
    persona propietaria: versión en README e infografías ×4, capturas de
    la infografía actual (docs/img/capturas.json) y, en la rama que
    cierra una fase, ninguna traducción desactualizada.
    - capturar_infografia.py --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
    [estado_fases.csv]
2026-10-08 Estado del arte: comparación con los Eventide y criterios para superarlos
    - Tabla de efectos, presets y precios: SOFIFI 0.7, H9 Gen 2, H90,
    Space, Blackhole, BigSky MX, RV-500 y Microcosm, con marcas de
    confianza (los precios vienen de tiendas: [?]).
    - Ocho criterios para «superar a los Eventide de gama alta», objetivo
    que fija la persona propietaria: qué gana ya SOFIFI (precio,
    apertura) y qué falta (audio, dos efectos a la vez, memoria,
    calidad medida con escucha ciega).
2026-10-08 Catálogo, lote 8 ambient: bruma, ensemble, marea, shimmer grave, shoegaze y sostenido
    - Seis programas ambient nuevos, sin cambios en la ISA ni en el RTL.
    El RTL da los mismos bits que el modelo con los 51 programas.
    - bruma: eco de cuatro cabezas con difusión en la realimentación.
    - ensemble: coro de tres voces antes del plate (hoja de ruta, punto 9).
    - marea: trémolo en contrafase sobre la cola del plate.
    - shimmer_grave: shimmer de −12.
    - shoegaze: plate con saturación sobre la cola, con volumen compensado.
    - sostenido: freeze automático en cada ataque (hoja de ruta, punto 4).
    - Prueba acústica, huella, 8 presets y demo por programa.
    51 programas y 408 presets.
    - fails.md: F-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
    [generar_demos.py]
2026-10-08 Compositor de cadenas: dos efectos a la vez en un solo programa (ADR 0013)
    - Un compositor une dos o más programas en serie o en paralelo, sin
    cambiar la ISA ni el RTL. Da a cada programa registros y LFOs propios.
    - Contrato probado: en serie, la cadena da los mismos bits que procesar
    con el primer programa y después con el segundo.
    - presets/cadenas.toml: 24 cadenas. 18 caben hoy y dan en el RTL los
    mismos bits que el modelo. 6 esperan la SDRAM: solo les falta memoria.
    - CLI: sofifi cadenas, sofifi componer y sofifi cadena.
    - Catálogo con sección de cadenas y 6 demos de cadenas.
    - ADR 0013 con la medida: 2 núcleos (13 112 LUT4) y 3 núcleos
    (19 046 LUT4) no se pueden colocar en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
2026-10-08 Cadenas: los registros temporales se comparten entre programas
    El compositor da registros propios solo a los persistentes. Los temporales
    (el programa los escribe antes de leerlos en cada muestra) salen de un grupo
    común. El análisis sigue todos los caminos de los SKP.
    - Parejas en serie que no caben por registros: de 904 a 300 (de 2 550).
    - En serie, la cadena sigue dando los mismos bits que dos pasadas.
    - ADR 0013: actualización 2026-10-08.
2026-10-08 Placa: cualquier programa o cadena con make hil; 50 de 50 iguales al modelo
    - sofifi rom escribe la ROM programa_hil de un programa o una cadena.
    - Top hil_programa (hil_nucleo con PROGRAMA "hil") y make hil HIL=NOMBRE.
    - scripts/hil_lote.py prueba en tanda todo lo que cabe en hil_nucleo.
    - MED-16: 41 programas y 9 cadenas dan en el silicio los bits del modelo.
2026-10-08 ADR 0014: parejas que caben con los registros compartidos
2026-10-08 Núcleo segmentado: documentación, medidas en la placa y listones
2026-10-09 Compuerta: shellcheck por pip; shell-lint ya corre
    shellcheck-py (MIT) trae el binario de ShellCheck 0.11 (GPL-3.0), que solo
    se ejecuta. shell-lint usa el del .venv. ADR 0001: actualización 2026-10-09.
2026-10-09 Fase 08, PR 1: banco de la microSD en el modelo y sofifi banco
    Bloques crudos de 512 bytes: cabecera con CRC-32 y ranuras fijas de 28
    bloques (metadatos y 27 de microcódigo), con CRC-32 por programa. El lector
    saca la ranura del índice y comprueba magia, versión, límites y CRC antes de
    devolver un programa. Un bit volteado o un campo fuera de rango se rechaza.
2026-10-09 Banco: la orden sofifi banco va en adapters (lee y escribe ficheros)
2026-10-09 Fase 08, PR 2: controlador SD por SPI y cargador del banco en RTL
2026-10-09 Fase 08, PR 3: top prueba_sd para la tarjeta real en el PMOD TF (J6)
    El top prueba las dos revisiones del PMOD TF (CS y SCK cambian) y carga
    ranuras del banco por orden de la UART. scripts/prueba_sd.py compara
    instrucciones, memoria y CRC-32 del microcódigo con el modelo. Guía de
    escritura de la tarjeta en docs/microsd.md. ADR 0004: pines de J6.
2026-10-09 Catálogo, lote 9: seis efectos de la comunidad DIY y de parches
    Ideas de foros DIY (PedalPCB, Madbean, FreeStompboxes), de Patchstorage
    (ZOIA) y de programas FV-1, descritas con palabras propias (ADR 0002):
    - erosion: bucle que se desintegra en cada vuelta.
    - mosaico: bucle sonido sobre sonido a ½×, 1× y 2×.
    - arcoiris: dos voces transpuestas con regeneración caótica.
    - desplazador: eco con desplazamiento de frecuencia en espiral.
    - tambor: eco de tambor de cuatro cabezas con combinaciones.
    - armonico: trémolo armónico con eco ligero.
    57 programas y 456 presets. El RTL da los mismos bits que el modelo.
    fails.md: F-26. Estado del arte: 35 ideas de la comunidad, en lotes.
    Co-Author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
    [generar_demos.py]
2026-10-09 Catálogo, lote 10: seis efectos que piden los foros en español
    Ideas de Guitarristas.info, Musiquiatra y guitarrista.org, y de parches
    MOD y ZOIA, descritas con palabras propias (ADR 0002):
    - violin: ataque lento y vibrato que entra con la edad de la nota.
    - acople: la nota sostenida hace crecer un armónico saturado.
    - arco: sustain tipo eBow con control automático de ganancia.
    - oscilador: delay que autooscila con el nivel limitado.
    - shimmer_escondido: shimmer que solo entra en la cola.
    - dinamica: plate cuyo decay y brillo siguen la fuerza al tocar.
    63 programas y 504 presets. El RTL da los mismos bits que el modelo.
    fails.md: F-27. README: coste por instrucción del núcleo segment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
    [generar_demos.py]
2026-10-09 Catálogo, lote 11: seis ecos de la comunidad; phaser y filtro sin barrido mínimo
    Ideas de PedalPCB, ZOIA y programas FV-1, con palabras propias (ADR 0002):
    enjambre, probabilidad, dados, aureo, estelar y lata. 69 programas y
    552 presets. El RTL da los mismos bits que el modelo.
    Fallo encontrado: la velocidad mínima de phaser y filtro (0,05 Hz) se
    redondeaba a 0 en el operando D de SOF y el barrido se paraba. Se calcula
    ×64 y se divide. El ensamblador rechaza ahora un coeficiente o un D
    distinto de 0 que se redondea a 0 (fails.md, F-28).
    [generar_demos.py]
2026-10-09 Catálogo, lote 12: seis modulaciones y ecos de la comunidad (75 programas)
    Ideas de AION FX, PedalPCB, FreeStompboxes, programas FV-1 y foros en
    español, con palabras propias (ADR 0002): deriva, dimension, vibe,
    orilla, baldosa y eco_casero.
    75 programas y 600 presets: el catálogo pasa de los 74 algoritmos del
    H9 Gen 2. El RTL da los mismos bits que el modelo. fails.md: F-29.
    [generar_demos.py]
2026-10-09 Catálogo, lote 13: bucles, frenadas y texturas de la comunidad (81 programas)
    Ideas de foros en español, ZOIA y pedales de bucle boutique, con palabras
    propias (ADR 0002): relevo, frenada, resbalon, tartamudeo, dos_ecos y
    viento. 81 programas y 648 presets. El RTL da los mismos bits que el
    modelo. fails.md: F-30.
    [generar_demos.py]
2026-10-09 Catálogo, lote 14: espirales, arpegios y ritmo de la comunidad (86 programas)
    Cinco programas nuevos, a partir de principios de ZOIA, CloudSeed y BYOC:
    - espiral: reverb con transposición en la regeneración.
    - arpegio: ecos que tocan un arpegio y caen en una reverb.
    - semilla: nube con multitap que sale de una semilla.
    - swell_ritmico: swell al ritmo del tap tempo.
    - compas: eco con tap tempo y subdivisiones.
    El banco pasa a 688 presets. fails.md añade F-31 en los cuatro idiomas.
    [generar_demos.py]
2026-10-09 Mezcla sin seco invertido, vuelta del looper a ½× y semillas de nextpnr
    - comun/mezcla.sasm: `sof 1.0, 1.0`. Con pot2 = 1, el seco ya no vuelve
    invertido a −60 dB. Cambian las huellas de 74 programas y sus demos.
    - looper: la celda `largo` copia la celda 0. A ½×, la última muestra se
    interpola con el principio del loop y no con una celda ajena.
    - granular no tenía fallo: F-31 queda corregido.
    - scripts/fpga.sh: si nextpnr solo falla el reloj, prueba las semillas 2,
    3 y 4. El mismo netlist daba de 95 a 112 MHz.
    - RAT-11 y RAT-12 suben con su motivo; RAT-16 y RAT-18 bajan.
    - fails.md: F-32 y F-33 en los cuatro idiomas.
    [programa_looper.v, programa_plate.v]
2026-10-09 Infografías al día con la Fase 08 en curso (4 idiomas)
    - sofifi: 86 programas, 688 presets, 24 cadenas y ciclos del núcleo segmentado.
    - sofifi: tabla nueva frente al H9 Gen 2 y nota de las 35 ideas de la comunidad.
    - sofifi: 50 de 50 en la placa (MED-16), 1,6 veces menos ciclos (ADR 0014).
    - sofifi: la Fase 08 está en curso; falta la prueba con la tarjeta real.
    - estado-del-arte: sección nueva con los ocho criterios frente a Eventide.
    - estado-del-arte: estado de cada mejora de la Fase 06 y shimmer a 1 037 ciclos.
    - Las traducciones se resellan y las 12 capturas se recapturan.
2026-10-09 Documentación de los scripts y de la CLI sofifi
    - Cada script de scripts/ dice qué hace, cuándo se usa, cómo se usa,
    qué necesita, qué escribe y sus códigos de salida.
    - Los argumentos de los scripts y de cada orden de sofifi tienen texto
    de ayuda y ejemplos reales.
    - docs/scripts.md es la guía nueva, por tarea, con la tabla de
    compuertas de ci_local.sh. Tiene traducción sellada en en, zh-CN y ja.
    - check_i18n.py incluye docs/scripts.md en TRADUCIDOS.
    El comportamiento de los scripts no cambia.
2026-10-09 Documentación al día: estado, Fase 08, guías y traducciones
    - README: estado con 86 programas, cadenas, núcleo segmentado y Fase 08 en curso.
    - README: tabla de familias completa y enlace a la guía de scripts.
    - Arquitectura: bloque de la microSD, sección de la Fase 08, cifras de ciclos y recursos.
    - Arquitectura: reglas de las semillas de nextpnr (F-33) y del reloj de la SD.
    - EXTENDING: pasos para un programa, un cambio de programa, un preset, una cadena y un top.
    - CLAUDE.md y AGENTS: comandos de la microSD, demos, semillas y trampas de F-32 y F-33.
    - F08: estado real, PRs hechos y paso que falta (tarjeta real).
    - SECURITY y CUMPLIMIENTO: controles del banco de la microSD.
    - BOM y S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
2026-10-09 Documentación al día: infografías, scripts y documentos (4 idiomas)
    Integra las ramas doc/scripts, doc/infografias y doc/textos, y añade:
    - MED-16 se midió con el núcleo de la Fase 07: la infografía lo dice.
    - docs/scripts.md entra en los mapas de check_docs.py.
    - generar_demos.py e informe_recursos.py muestran el uso con un
    argumento incorrecto.
    - esquematicos.py cierra con punto las descripciones que acaban en «:».
    - La CLI pasa sus argumentos a cli_argumentos.py (RAT-02).
    - Esquemáticos de programa_plate y programa_looper regenerados.
2026-10-09 ADR 0013: actualización 2026-10-09, la opción 3 ya está hecha
    El ADR 0014 quitó las esperas del núcleo. Con los 86 programas caben
    2 611 de 7 310 parejas en serie. Ahora limita sobre todo la memoria
    (3 590 parejas): la palanca siguiente es la SDRAM. La decisión no cambia.
2026-10-09 Scripts: seis comportamientos inesperados corregidos (F-34)
    - check_*: --help imprime la ayuda; otro argumento da el código 2 sin
    ejecutarse (scripts/sin_opciones.py).
    - capturar_infografia.py dice que falta chrome-headless-shell y cómo
    instalarlo.
    - margen_reloj.py comprueba prueba_pll.fs antes de tocar la placa; la
    recarga final ya no tapa el resultado.
    - hil_lote.py corre cada nombre en un grupo de procesos propio y lo mata
    entero a los 20 minutos.
    - rtl-lint revisa también rtl/sd/ módulo a módulo.
    - La CLI sofifi busca la raíz del repositorio desde el directorio actual.
2026-10-09 Presets: el banco pasa de 688 a 1 032 (12 por programa)
    - 344 presets nuevos, 4 por programa, medidos uno a uno con el modelo.
    - 13 presets antiguos saturaban o pasaban de +6 dB: corregidos (F-35).
    - scripts/medir_presets.py mide el nivel de cada preset.
    - presets_test exige 12 por programa y 1 000 en total.
    - Cifras al día en README, infografías (y capturas) y estado del arte.
2026-10-09 Infografía sin el H9 Gen 2; rarezas de los programas (F-36)
    - La infografía principal pierde la tabla frente al Eventide H9 Gen 2.
    - medir_presets.py mide con un rasgueo de banda ancha y el RMS máximo
    en ventanas de 50 ms: la nota de 196 Hz daba falsas alarmas.
    - saturacion divide su salida por 2: compensa el ×1,999 de la etapa 1.
    - Cabeceras de resonador, looper, granular y tambor al día.
    - Tres presets ajustados a la medida nueva.
2026-10-10 HIL: la región absoluta cuenta para «cabe» en hil_nucleo (F-37)
    enjambre y semilla dieron muestras distintas en la placa: su región
    absoluta, detrás de la circular, pasaba de las 38 912 palabras de
    hil_nucleo. Programa.palabras_fisicas suma la región absoluta; la usan
    sofifi rom, hil_lote.py y el catálogo.
2026-10-10 MED-17: 77 de 77 en la placa con el núcleo segmentado
    68 programas y 9 cadenas dan en el silicio los mismos bits que el
    modelo, a 100 MHz. Son todos los que caben en hil_nucleo contando la
    región absoluta (F-37). README, arquitectura e infografías al día.
2026-10-25 F13 PR1: salida de audio de 1 bit, igual al modelo bit a bit
    El reloj es 2 048 veces fs, así que un solo pin lleva audio (ADR 0015). La
    cadena es un interpolador CIC de Hogenauer (S = 2, R = 32), un mantenimiento de
    64 ciclos y un modulador sigma-delta de 2.º orden. Así se pueden oír los 86
    programas en la placa sin el códec I2S, que aún no está comprado.
    - Modelo: `model/sofifi/domain/salida_1bit.py`, el oráculo (ADR 0003).
    - RTL: `rtl/salida/cic_interp.v`, `sigma_delta.v` y `salida_1bit.v`. Cada ciclo
    hace una sola suma, y el modulador dobla las constantes en los bits altos
    (F-15).
    - Testbenches: el RTL da el mismo flujo de bits que el modelo, con 6 ciclos de
    retardo. Compar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
2026-10-25 F13 PR2: la pista de audio de la microSD
    El pedal no tiene entrada de audio hasta la Fase 11, así que la fuente para oír
    los programas en la placa es una grabación de la tarjeta (ADR 0004: la microSD
    almacena, y una pista es almacenamiento).
    - Formato (`model/sofifi/domain/pista.py`): bloques crudos de 512 byte, como el
    banco de programas. Cabecera con magia, versión, número de muestras y CRC-32;
    después, muestras de 16 bit con signo, 256 por bloque.
    - `sofifi pista SALIDA.img ENTRADA.wav`, con `--segundos` y `--sintetica`.
    - `rtl/sd/lector_pista.v`: valida la cabecera, entrega una muestra por `tick` y
    repite la pista al acabar. Cola de 1 024 muestras en un bloque de BSRAM, que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
2026-10-25 F13 PR3: el top audio_sd, el pin y la guía de escucha
    microSD → núcleo → salida de 1 bit, con el estado por la UART. El núcleo no
    arranca hasta que la pista tiene su primera muestra, así que el flujo de bits
    del pin se compara con el modelo de punta a punta (ADR 0003).
    - `rtl/top/audio_sd.v` y `rtl/top/audio_programa.v`, con `make audio
    AUDIO=NOMBRE` para oír cualquier programa o cadena.
    - Pin de audio en G8 de J6: es el SCK de la revisión v1 del PMOD TF, y con un
    módulo v2 la tarjeta no lo usa (en modo SPI es DAT2). La bola está verificada
    para J6; conviene moverlo a J4 o J5 cuando haya un esquema del Dock delante.
    Con un módulo v1 la tarjeta no arranca y el estado lo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
2026-10-25 Compuerta: `docs` no depende de que la placa esté enchufada (F-38)
    `comprobar_rutas` trataba `/dev/ttyUSB0` y `/dev/ttyUSB1` como rutas del
    repositorio, así que `docs` se ponía roja y el pre-push no dejaba subir nada si
    la placa no estaba conectada. Un fichero de dispositivo existe o no según haya
    un cable USB puesto.
    `parece_ruta` descarta lo que empieza por `/dev/`. La comprobación sigue
    valiendo para las rutas del repositorio, que son las que puede romper un cambio.
    Una compuerta con falsos rojos se desactiva (SPEC_RAIZ, P1).
2026-10-25 El freeze congela la cola y la cola sigue moviéndose
    Hasta ahora `freeze` bajaba la modulación del tanque a 0 al congelar, porque con
    el bucle sin pérdidas la interpolación del `cho` apagaba la cola. Era un apaño
    de la Fase 01, escrito en el propio programa.
    Medido en el modelo, con siete segundos de freeze:
    - modulación apagada (el apaño): −0,027 dB/s, pero la cola está quieta;
    - modulación puesta, sin compensar: −0,382 dB/s;
    - modulación puesta y compensada con kcmp = 0,05: −0,087 dB/s, y la cola se
    estabiliza en −0,5 dB.
    `programas/comun/dattorro_tanque_compensado.sasm` es el tanque con CLIP y un
    cero que levanta los agudos dentro de cada rama: y' = y + kcmp·(y −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
2026-10-25 F14 PR1: palabras de memoria de 12 bit en el modelo
    «La restricción que más aprieta es la memoria.» Con palabras de 12 bit caben
    64 512 palabras de retardo (1,32 s) en lugar de 43 008 (0,88 s), por programa y
    sin comprar nada. Es el punto 14 de la hoja de ruta.
    El formato es **lineal**, y eso cambia la hoja de ruta, que pedía coma flotante.
    Medido en el modelo, con la relación señal/ruido de la salida de programas
    reales contra la referencia de 18 bit:
    | Programa | 12 flotante | 12 lineal | 9 μ-law | 9 lineal |
    |---|---|---|---|---|
    | plate | 49,3 dB | 45,5 dB | 37,5 dB | 27,2 dB |
    | cinta | 59,0 dB | 63,3 dB | 47,8 dB | 45,2 dB |
    | hall | 51,9 dB | 47,8 dB | 40,2 dB | 29,6 dB |
    L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
